Zachnad0/AUS-NZ-Track-A-RFIC-Workspace/README.md

## Track: A <br>Team: AUS/NZ Track A RFIC <br>Project: Open-loop integer-N PLL characterization chip: LC-VCO, quadrature divider, PFD and charge pump

**Reviewers: [docs/REPRODUCE.md](docs/REPRODUCE.md)** rebuilds `gds/chip_top.gds` from a fresh clone, XORs it to zero against the committed file, and runs every signoff gate and test-plan simulation with expected results.

RF-block characterization chip containing the blocks of an integer-N PLL (LC-VCO with varactor tuning, CML divide-by-2 quadrature divider, PFD, charge pump), brought out to pads for open-loop characterization. Closed-loop lock is not demonstrable on this die: the feedback divides by 2 only and the PFD has no usable phase-detection window at the ~2.5 GHz reference that would require. Not a functioning integer-N PLL.

## Testing commitment

Team A01 is committed to testing the fabricated chip and publishing the measurement results in this repository.

Test plan (draft): [docs/test_plan.md](docs/test_plan.md)

Team members

| Discord | Github | Affiliation (experience) | Role |
|---|---|---|---|
| the_z_1 | [@Zachnad0](https://github.com/Zachnad0) | Victoria University of Wellington (undergrad) | Team lead |
| xyfy3 | | Monash University (undergrad) | Member |
| gregorydaley_87272_39557 | [@gregorydaley1209](https://github.com/gregorydaley1209) | University of North Texas (undergrad) | Member |

Overview: Design of a microwave RFIC with an integrated VCO, integer-N PLL, and IQ modulator for use in the 2.4 GHz ISM band, targeting applications such as WiFi 4 (802.11n) or Bluetooth.

Area Estimate: 350 um x 300 um (estimate)  
Pin count: Power 4  Ground 4  Digital 4  Analog 4 (estimate)

**Links**  
[Github repo(s)](https://github.com/Zachnad0/AUS-NZ-Track-A-RFIC-Workspace)  
[Proposal Slide Link](https://docs.google.com/presentation/d/1wPEPSz1xmLuB1RUFt2hdCvwPvyq5I9ataVjHJdjLBb4/edit?usp=sharing)  
[Pin Requirement Link](https://github.com/Zachnad0/AUS-NZ-Track-A-RFIC-Workspace/blob/integration/docs/pins.md)  
[Progress Tracker](https://docs.google.com/spreadsheets/d/1ioGDfle-Np0gdS-PER5QJmRa5nnGZcALtzJDiHwNKBI/edit?usp=sharing)  
[Schematic Review Slide Link](https://docs.google.com/presentation/d/1Fb3C-OsCs1z_RmMnkYhZTfymx6UUXy9G63MJMbfRtXM/edit?usp=sharing)  
Layout Review Slide Link
