Zachnad0/AUS-NZ-Track-A-RFIC-Workspace/signoff/lvs/README.md

# `signoff/lvs/` — LVS artifacts, tracked and readable without running anything

**Team A01 · AUS/NZ Track A RFIC · GF180MCU (gf180mcuD)**
`lvs.report`, `chip_top.lvs.spice` and `chip_top.drc.log` regenerated 2026-11-06 for the D block
(tree at `c312fd7`, `gds/chip_top.gds` sha256 `e14b48cae71eeb60…`). `blocks/` generated 2026-09-01
from commit `52a783a`.

> **D block (2026-11-06).** The three chip-level files are current for the 605 × 605 µm D block.
> `blocks/` was not regenerated and still holds the 2026-09-01 captures. For the organizer-flow
> D result, see the 2026-11-06 section below.

These files exist because the flow's own working directory,
`team_src/magic/verify_work/`, is **gitignored** (see `.gitignore`) — it is regenerable
build output, so nothing in it was ever visible in the repository. This directory is a
committed copy of the artifacts a reviewer or an aggregation script needs.

**Nothing here is hand-edited.** Every file is byte-for-byte tool output, copied verbatim.
The `lvs.report` files begin with a blank line and end with a `.` because that is exactly
what netgen emits; that was left alone on purpose rather than tidied.

## What is here

| File | What it is |
|---|---|
| `lvs.report` | **The top-level LVS report — `chip_top`.** netgen comparison output, layout vs the hand-written golden. Named `lvs.report` so it is findable without knowing our cell names. |
| `chip_top.lvs.spice` | Extracted netlist of the whole chip (Magic `ext2spice`). Every device instance on the die, with its PDK model name and geometry. |
| `chip_top.drc.log` | Magic DRC log for the same layout (`VERIFY_DRC_COUNT=0`). |
| `blocks/<CELL>.lvs.report` | Per-block netgen comparison output. |
| `blocks/<CELL>.lvs.spice` | Per-block extracted netlist. |

Blocks: `PFD_lib`, `CP_v1`, `ibias_gen_v1`, `DIV2_QUAD_v1`, `vco_v1`.

## Results, as of this capture

Every cell: Magic DRC **0**, netgen **"Circuits match uniquely"**, **0 property errors**
(`verify_cp.sh` hard-fails on a W/L property error, not only on a topology mismatch).

| Cell | netgen devices | nets | ports | Verdict |
|---|---:|---:|---:|---|
| `chip_top` | 10 | 20 | 11 | match uniquely |
| `PFD_lib` | 7 | 11 | 6 | match uniquely |
| `CP_v1` | 8 | 10 | 7 | match uniquely |
| `ibias_gen_v1` | 17 | 15 | 6 | match uniquely |
| `DIV2_QUAD_v1` | 75 | 47 | 9 | match uniquely |
| `vco_v1` | 7 | 7 | 6 | match uniquely |

`chip_top`'s 10 devices are the **top-level** instances: the five blocks, the ESD ballast
resistor, and the two ESD diode groups (`diode_nd2ps_03v3 (8->2)`,
`diode_pd2nw_03v3 (8->2)`). Device counts *inside* the blocks are in
`../devices.md`.

> **Three different device counts exist for this design and they are not interchangeable.**
> Read `../devices.md` §"Counting conventions" before quoting any number. In short:
> netgen's merged count (above) ≠ the raw instance count in the extracted netlist ≠ the
> summary line `verify_cp.sh` prints. All three are correct for what they measure.

## Two accepted LVS waivers, both in `chip_top` and both narrow

1. **`vco_inductor_v2` is an `ignore class`.** The custom spiral is a physical inductor with
   no foundry device model; netgen black-boxes it. It still appears in the extracted netlist
   as two `tm11k` top-metal resistors (its M5 leads) — see `../devices.md`.
2. **`PFD_lib` fill/decap cells are ignored** (18 instances of `gf180mcu_fd_sc_mcu7t5v0__fillcap_*`)
   using only the PDK-provided `ignore class`. This is the same waiver LibreLane's own run
   applies via `LVS_IGNORE`. The devices inside those cells are real and **are** counted in
   `../devices.md`.

There are **no DRC waivers** (since 2026-11-02). The former W4 waiver, 168 KLayout
`PL.5a_LV`/`PL.5b_LV` items once taken to be internal to the `nmoscap_3p3` gencell, was the
missing COMP under the 42 varactor gates and is revoked; see `tech_patches/README.md` and
`../../docs/layout-review-sep01.md` §2.5.

## The organizer flow — `extra_be_checks`: matches with Bailey's pending `rm5` fix

> **Current status (2026-11-02, after the varactor COMP fix).** The committed GDS was rewritten
> with COMP under the 42 varactor gates (`tech_patches/README.md`). `run_full_lvs
> lvs/lvs_config.json` on it:
>
> | runner | result |
> |---|---|
> | stock `extra_be_checks@7d1f5ef` | **16 vs 18 devices**, failed pin matching (exit 4). The varactors now match (`cap_nmos_03v3_b (42→2)` both sides); only the 2 `tm11k` of the inductor are missing |
> | the same + `tech_patches/rm5.diff` | **Circuits match uniquely**: `chip_top` 10/10 devices, 20/20 nets; `vco_v1` 8/8 (exit 5: matched, with `tm11k`/`cap_nmos_03v3_b` black-boxed and 10 fill cells ignored). Counted with `vco_v1` flattened, 17 vs 17 |
>
> Before the fix the stock runner gave 14 vs 18: both the varactors and the `tm11k` were missing.
>
> **Why the remaining stock failure is expected:** on 2026-09-25 Bailey ruled in issue #143 that
> `cap_nmos_03v3_b` and `vco_inductor_v2` come out of `LVS_IGNORE`, and that he would fix the tech
> file. That change is `f7be3d5` ("drop cap_nmos_03v3_b and vco_inductor_v2 from LVS_IGNORE per
> Bailey #143"). Two tech-file gaps were on record:
>
> 1. **Varactors.** The record said there was *no varactor `cifinput` rule*; that was wrong. The
>    rule exists (`layer nvar POLY and DIFF and NPLUS and nwelldef and-not DUALGATE`). The real
>    gap was on the **writer** side: magic's stock tech never wrote COMP under 3.3 V varactor
>    gates, so the GDS itself lacked them. Fixed in our GDS on 2026-11-02; nothing is needed in
>    Bailey's reader for it.
> 2. **The `RESDEF` mapping `calma RESDEF 110 *` does not match on input.** The wildcard datatype
>    never matches when GDS is read, so `rm5 = MET5 and RESDEF and MET5RES` is always empty and
>    the inductor's `Metal5_Res` markers produce an open instead of two `tm11k` ("The inductor,
>    measured" and the `rm5` fix below; `tech_patches/rm5.diff`). **Still open upstream**; this is
>    the whole of the remaining stock failure.
>
> The **"Result, 2026-09-19"** pass and the waiver sections after it describe the config before
> `f7be3d5` and are kept as history. The team's own gates on the fixed GDS: `verify_cp.sh` × 6
> PASS (unchanged counts), `drc_boxset.tcl` 0 boxes (new baseline), `klayout_signoff.py`
> 0 violations with no waivers, `team_src/magic/analysis/varactor_comp_gate.py` PASS.

**Superseding the `mpw_precheck` section below.** Per Bailey (issue #143, 2026-09-18) the check
to run is his `extra_be_checks`, not `mpw_precheck`. It ships the **set_lvs_env.py** helper that
`mpw_precheck` never published, so the config path works as documented.

### Runner

```
git clone -b chipathon2025 https://github.com/d-m-bailey/extra_be_checks
export LVS_ROOT=<clone>            # the repo root, not checks/be_checks
export PDK=gf180mcuD PDK_ROOT=/foss/pdks
export UPRJ_ROOT=<this repo>
$LVS_ROOT/run_full_lvs $UPRJ_ROOT/lvs/lvs_config.json
```

`d-m-bailey/extra_be_checks` branch `chipathon2025` at commit
`7d1f5efb270003208956e764765f403b755281d7` (2025-11-28). Runs in ~10 s.

### Result, 2026-09-19 at `da08e9e` (historical: earlier `LVS_IGNORE` config)

**`Circuits match uniquely.`** `chip_top` 10 devices / 20 nets on both sides, every cell's pin
lists equivalent, every sub-block matched — `vco_v1` 5 devices / 7 nets, `CP_v1` 8 / 10,
`DIV2_QUAD_v1`, `ibias_gen_v1`, `PFD_lib` all matched.

Two things this runner fixes that `mpw_precheck` could not:

- **The `05v0`/`06v0` standard-cell split is gone.** Under `mpw_precheck` the layout extracted
  34 `nfet_06v0` + 34 `pfet_06v0` against the PDK netlist's `*_05v0`, an unresolvable 68-device
  difference. Bailey's `tech/gf180mcuD/gf180mcuD_setup.tcl` compares the standard cells
  hierarchically instead of flattening them, so `PFD_lib` matches as a subcircuit and the device
  classes never collide. There is still **no** `equate classes` for `nfet_05v0`/`nfet_06v0` in
  that branch — the only device equivalence it defines is the MiM-cap pair. The split is
  avoided, not equated.
- **Net counts match everywhere**, where `mpw_precheck` never resolved the device gap.

### The one waiver this needs: `cap_nmos_03v3_b` (historical, dropped in `f7be3d5`)

`LVS_IGNORE` carried `cap_nmos_03v3_b` in addition to `vco_inductor_v2` and the standard-cell
fill/decap/antenna globs. Without it the run is otherwise clean but reports
**`cap_nmos_03v3_b` 0 in the layout against 2 in the source** — the 42 varactors.

**This is a PDK techfile gap, not a layout defect.** `gf180mcuD.tech` writes GDS `166/5`
(`MOS_CAP_MK`) for *both* device families but its `cifinput` only ever reconstructs the **cap**
types; there is no `cifinput` rule that produces `nvaractor` at all, so a `cap_nmos_03v3_b`
drawn in magic cannot come back as itself from its own GDS.
Detail: `../../docs/verification.md` §3.2.

What is lost and what still covers it: the 42 varactor **devices** are not compared by this
flow. They remain covered by `verify_cp.sh vco_varactors` on the **`.mag`** path — 42 devices /
3 ports / 4 nets, match uniquely — and by `verify_cp.sh vco_v1` (4 / 6 / 11). Their **nets** are
still compared here: `cap_bias`, `OUT_p` and `OUT_n` all exist and match on both sides inside
`vco_v1`.

The alternative was `EXTRACT_ABSTRACT` on `vco_varactors` with the golden's two
`cap_nmos_03v3_b` instances collapsed into a black-box `vco_varactors` subckt. That also gives
`Circuits match uniquely`, and it was rejected: it would make the committed golden stop
describing the real circuit, for no more coverage than the one-line waiver above.

### The inductor, measured

`LVS_IGNORE vco_inductor_v2` is required, and this was verified rather than assumed. Extracting
`gds/vco_inductor_v2.gds` with the PDK techfile gives **`PORT1` and `PORT2` as separate nodes**
— so the two `Metal5_Res` markers (GDS `110/15`, two 76 × 8 µm, one per coil half) **do** break
the metal — **but no resistor device is created**. The techfile needs
`rm5 = MET5 and RESDEF and MET5RES`; `m5` is `MET5 and-not MET5RES`, so the marker subtracts the
metal, while `rm5` never appears (checked after the GDS read: the cell holds only `metal4`,
`via4`, `metal5`). `RESDEF` is mapped `calma RESDEF 110 *`, a wildcard datatype that does not
match on input. The result is an **open**, not the two `tm11k` resistors that
`team_src/magic/vco_inductor_v2/vco_inductor_v2.ext` supplies in the `.mag` flow.

So the "generic metal resistor break" is half-present: the break works, the resistor does not.
Two alternatives were tried and both are worse than ignoring the cell:

| config | result |
|---|---|
| `LVS_IGNORE vco_inductor_v2` (landed then; removed in `f7be3d5`) | `Circuits match uniquely` |
| `+ EXTRACT_ABSTRACT vco_inductor_v2` | identical — no effect, see the gate below |
| `LVS_IGNORE` removed, golden subckt vs extracted metal | 14 vs 17 devices, **`Top level cell failed pin matching`** |

`EXTRACT_ABSTRACT` has no effect on this cell because of the gate in `run_extract`:
`if { $instance_count > 0 || [llength $port_list] > 10 }`. Only cells with **child instances**
or **more than 10 ports** take the complex path, which deletes the children by grid, deletes
non-port layers and writes a LEF that is later `lef read` back. A **leaf with ≤ 10 ports** —
which `vco_inductor_v2` is, at 2 ports and 0 children — skips that body entirely: no LEF is
written, so nothing is read back, and the only thing that happens is `property LEFview true`
after the GDS read. `vco_varactors`, with 42 child instances, *does* take the complex path.

### 2026-10-27: 2-pin `vco_inductor_v2` golden, and the `rm5` techfile fix

Since `f7be3d5` (2026-09-25, Bailey #143) `lvs/lvs_config.json` no longer ignores
`vco_inductor_v2` or `cap_nmos_03v3_b`. The sections above, from "Result, 2026-09-19" on,
describe the config before that.

**Golden change.** `team_src/magic/vco_v1_golden.spice` now defines
`vco_inductor_v2 PORT1 PORT2` as two `tm11k` (`r_width=8u r_length=76u`) in series through one
internal node, exactly as the layout extracts it, and instances it with 2 pins, PORT1 on `OUT_p`
and PORT2 on `OUT_n` (the mapping read from the extracted layout). `chip_top_golden.spice` is
regenerated from it by `team_src/xschem/chip_top/assemble_chip_golden.py`. The old third pin,
GND, came from the xschem symbol's simulation model `team_src/xschem/vco_inductor_v2.subckt`,
where it is only the reference for the coil's substrate capacitors; the layout has no such
terminal. `signoff/sim/vco/mkdeck2.py` puts the 3-pin lumped model (the one carrying the L) back
for simulation. The `.mag`-path gates are unchanged: `verify_cp.sh vco_v1` 4 / 6 / 11 and
`chip_top` 10 / 11 / 25, match uniquely (the inductor is still an ignore class there).

**Organizer flow on this golden**, `extra_be_checks@7d1f5ef`:

| techfile | devices (layout / source) | nets | ports | verdict |
|---|---|---|---|---|
| stock | 14 / 18 | 21 / 22 | 11 / 11, VTUNE unpaired | failed pin matching |
| `rm5` fix below | 15 / 17 | 21 / 21 | 11 / 11, all paired | do not match |

For reference, stock techfile with the old 3-pin golden (2026-09-25): 14 / 17, 21 / 21, VSSA and
VTUNE pins swapped. With the stock techfile the coil is still the open described above, so the
golden's two `tm11k` have no layout counterpart. With the fix, `vco_inductor_v2` matches
uniquely.

**The `rm5` fix** is one line in `gf180mcuD.tech` (Bailey's file; not landed anywhere):

```
 layer rm5 MET5
- and RESDEF
 and MET5RES
```

Magic appears to map each GDS layer/datatype to a single cifinput layer: `110/15` reaches
`MET5RES` but never `RESDEF` (`calma RESDEF 110 *`), so the three-way AND is always empty. With
the term dropped, `gds/vco_inductor_v2.gds` extracts as two `tm11k`, 76 µm x 8 µm, PORT2 to
the metal4 crossunder to PORT1. That mapping rule is inferred from runs; the magic tech-file
manual does not document it.

**Still open:**

- **Varactors.** `cap_nmos_03v3_b` is 0 in the layout against 2 (42 -> 2) in the source, the
  techfile gap described above. It leaves VTUNE, `cap_bias`, VCO_OUTP and VCO_OUTN unpaired.
- **`tm11k` is a black box on both sides.** Neither netlist has a model for it, so netgen
  compares the inductor's topology but not its `r_width` / `r_length`.

### 2026-11-06: D block, `402b1d9`

`chip_top` reseated in the 605 × 605 µm die, seat A. `verify_cp.sh chip_top`: match uniquely, 10
devices, 20 nets, 11 ports. Golden has 11 ports for the 12 pads; VSSD's text sits on 36/0 at die
(367.5, 604.5), on its landing, on the VSSA net.

Organizer flow, `extra_be_checks@7d1f5ef`:

| techfile | devices (layout / source) | nets | ports | verdict |
|---|---|---|---|---|
| stock | 16 / 18 | 21 / 22 | n/a | do not match: the two `tm11k` only |
| `rm5` fix | 10 / 10 | 20 / 20 | 11 / 11, all paired | **match uniquely** (exit 5, black-box warning) |

The varactor mismatch listed as open above is gone: the COMP fix `8ca968f` closed it. `tm11k` is
still a black box on both sides.

## The older `mpw_precheck` attempt — recipe and result

Run 2026-09-18 at `aa470c3`. **This is a different check from `verify_cp.sh` above and it did
not pass.** `verify_cp.sh` compares `chip_top` against `chip_top_golden.spice` alone, with
every block a black box; the organizer flow additionally reads the PDK standard-cell netlist and
so compares the inside of `PFD_lib` too.

### Runner

`efabless/mpw_precheck` at commit `0941bdc1b62b5c3f99c8683bd11199d330af2ef3`. The scripts are
under `checks/be_checks/`, not `checks/lvs_check/`; `LVS_ROOT` is that directory.

**Caveat, and it is not ours: **set_lvs_env.py**, under the runner's `checks/be_checks/`, cannot be obtained.** It is
listed in mpw_precheck's own `.gitignore`, has never been committed to any branch or tag
(checked `gfmpw-1a`…`1d` and `2024.09.*`), and nothing in the repo or its `dependencies/Dockerfile`
generates or fetches it. Every `run_*` entry point sources it, so the config path
(`run_full_lvs <config>`) is unusable as shipped.

The workaround uses `run_full_lvs`'s own documented alternative — *"if config file not specified,
skip and use current environment"* — so the runner script itself is unmodified:

```bash
export PDK=gf180mcuD PDK_ROOT=/foss/pdks
export UPRJ_ROOT=<repo root>
export LVS_ROOT=<clone>/checks/be_checks
source <(python3 mk_lvs_env.py $UPRJ_ROOT/lvs/lvs_config.json)   # see note below
export WORK_ROOT=<scratch> LOG_ROOT=$WORK_ROOT SIGNOFF_ROOT=$WORK_ROOT
$LVS_ROOT/run_full_lvs            # no arguments
```

**mk_lvs_env.py** is the one reconstructed piece: it reads `lvs/lvs_config.json` and the
`INCLUDE_CONFIGS` base, and emits the `export` lines **set_lvs_env.py** would have. Merge rule:
scalars override, list variables are a **union**, and `[""]` means "adds nothing" — which is the
only reading under which efabless's own reference configs work, since
`caravel_user_project_analog` sets `EXTRACT_FLATGLOB` to `[""]` while depending on the base
config to supply the real patterns. It lives in scratch, not in this repo, because it is a
stand-in for a file the organizers are expected to have.

Runtime is **8–10 s** per run on this host.

### Result

| run | change | devices (layout/source) | nets | ports | verdict |
|---|---|---|---|---|---|
| 0 | none (`152f812`) | 79 / 84 | 52 / 53 | **13 / 11** | fail, 2 pin shorts |
| 1 | `REF_IN_PD/PU` → 36/0 | 79 / 84 | 52 / 53 | **11 / 11** | fail, **no pin shorts** |
| 2 | `LVS_IGNORE += vco_inductor_v2` | 79 / **83** | 52 / 53 | 11 / 11 | fail |

Runs 3 and 4 tried `EXTRACT_ABSTRACT` for `vco_inductor_v2` and then `vco_varactors`; neither
changed the verdict and both were reverted (see the `lvs_config` commit message).

**The identical run on `c7eb341`, the commit `item23` branched from, fails the same way** — 79/84,
52/53, both pin shorts. None of this was introduced by item 23.

### What is still mismatched, and why

Two causes remain. Neither is expressible in the organizer config schema.

**1. `OUT_p` and `OUT_n` are one net when the GDS is read as geometry.** The extracted
`vco_v1` is

```
.subckt vco_v1 TUNE GND VDD ISS OUT_p          <- 5 ports; the golden has 6
Xvco_core_0 ISS VDD GND OUT_p OUT_p vco_core   <- OUT_n merged into OUT_p
```

`verify_cp.sh` does not see this because `team_src/magic/chip_top.abstract` says
`PRELOAD=vco_varactors vco_inductor_v2`, and `verify_extract.tcl` implements that as `load` of
those `.mag` masters plus `gds noduplicates true`, so the GDS read keeps the abstract and never
traverses the spiral. **The organizer schema has no PRELOAD equivalent**: `EXTRACT_ABSTRACT`
black-boxes a cell that is already in the stream, it does not substitute a `.mag` master for it.
Tried directly — abstracting `vco_inductor_v2` produced the abstract but left `OUT_n` merged and
added a dangling `vco_inductor_v2_0/PORT1`; abstracting `vco_varactors` as well changed nothing.

**2. The standard cells extract as `*_06v0` and the PDK models them as `*_05v0`.** 34 `nfet` and
34 `pfet` on each side, same devices, different class name. They are the standard cells inside
`PFD_lib` — `gf180mcu_fd_sc_mcu7t5v0__dffrnq_1` (28), `__nand2_1` (4), `__inv_1` (2), `__tieh`
(2). `PFD_lib` itself compares **68 / 68 devices, 38 / 38 nets and matches**; only the flattened
chip-level tally splits.

This one is entirely inside the PDK. Both `gf180mcuD` spice views of the library —
`libs.ref/gf180mcu_fd_sc_mcu7t5v0/spice/*.spice` and `.../cdl/*.cdl` — use `nfet_05v0` /
`pfet_05v0`, while magic's extraction of those same cells yields `nfet_06v0` / `pfet_06v0` and
the PDK's netgen setup declares **only** the `*_06v0` classes (`05v0` appears zero times in it).
The fix is a netgen `equate classes nfet_05v0 nfet_06v0`, which belongs in the setup `.tcl` the
runner copies from the PDK — **the config schema does not expose it**, and there is no alternate
PDK file that would make the two agree.

`verify_cp.sh` never hits this because it feeds netgen only `chip_top_golden.spice`, with no
standard-cell netlist at all, so `PFD_lib`'s 68 devices are never compared.

### Reading this honestly

The port fix in `aa470c3` is a real correction to the deliverable and is gated on its own merits.
The two remaining causes are a tool-flow gap and a PDK naming inconsistency; neither indicates a
defect in `gds/chip_top.gds`. Whether the organizer flow passes for anyone on gf180mcuD with a
standard-cell block is worth asking the organizers before treating cause 2 as ours.

## Regenerating

Inside the `iic-osic-tools` container, from the repo root:

```
export PDK=gf180mcuD PDK_ROOT=/foss/pdks
for c in PFD_lib CP_v1 ibias_gen_v1 DIV2_QUAD_v1 vco_v1 chip_top; do
  bash team_src/magic/verify_cp.sh $c
done
```

~28 s for all six. Output lands in `team_src/magic/verify_work/`; this directory is a copy.
`verify_cp.sh` exits 0 only on DRC 0 + match uniquely + zero property errors.

**The extracted netlist is not byte-reproducible run to run** in the same way the GDS is not
(`docs/verification.md` §8.11): node auto-names such as `IBIAS_uq0` and `m4_n14800_800#` are
generated during extraction. The device set, counts and geometry are stable; incidental node
names may differ. Compare device tables, not file hashes.
