Zachnad0/AUS-NZ-Track-A-RFIC-Workspace/docs/phase8-padframe-plan.md

# Phase 8 — padframe DEF integration: analysis & plan

> **D block (2026-11-06).** This plan is the BH record. The current die is 605 × 605 µm: see
> `docs/d-block-plan.md`.

Analysis of the organizer's issued padframe DEF (`A01.def.tgz`, extracted from a
working dir — not committed; analysis/docs only this session). **Two things are
blocked and out of scope:** (1) whether a second ground pin **VSSD** is required
(Bailey: "two ground pins, one per power region"; expanded Friday — the issued
DEF has none, so a regenerated DEF is expected), and (2) therefore the final pin
list and top-level boundary. Everything here holds regardless of how that lands.

Baseline is known-good: `verify_cp` PASS (DRC 0, LVS match uniquely) on `chip_top`
and all five blocks (this session, §5).

---

## 1. DEF inventory (both variants)

DEF units are **200 dbu/µm** (5 nm). `translated_user` = pin rectangle in the
**project's own frame** (origin at the project LL). Pin rects are all **Metal2**.
Both variants: `DIEAREA (0 0)–(…)`, `PINS 14` (12 user pins; REF_IN expands to 3).

### 1a. BV — 550 × 1110 µm (portrait). origin 350,1475. vss_fixed W12. usable 610500 µm²

| pin | slot | cell | use | dir | edge | translated_user bbox (µm) |
|-----|---|---|-----|-----|---|---|
| VSSA | W13 | dvss | GROUND | INOUT | west | x0–1, y106.4–178.6 |
| VDDA | W14 | dvdd | POWER | INOUT | west | x0–1, y206.4–278.6 |
| IBIAS | W15 | asig_5p0 | SIGNAL | INOUT | west | x0–1, y320.3–364.7 |
| ISS | W16 | asig_5p0 | SIGNAL | INOUT | west | x0–1, y420.3–464.7 |
| VTUNE | W17 | asig_5p0 | SIGNAL | INOUT | west | x0–1, y520.3–564.7 |
| CP_OUT | W18 | asig_5p0 | SIGNAL | INOUT | west | x0–1, y620.3–664.7 |
| I_P | W19 | asig_5p0 | SIGNAL | INOUT | west | x0–1, y720.3–764.7 |
| I_N | W20 | asig_5p0 | SIGNAL | INOUT | west | x0–1, y820.3–864.7 |
| Q_P | W21 | asig_5p0 | SIGNAL | INOUT | west | x0–1, y920.3–964.7 |
| Q_N | W22 | asig_5p0 | SIGNAL | INOUT | west | x0–1, y1020.3–1064.7 |
| VDDD | N01 | dvdd | POWER | INOUT | north | x31.4–103.6, y1109–1110 |
| REF_IN (Y) | N02 | in_c | SIGNAL | INPUT | north | x133.8–134.1, y1109–1110 |
| REF_IN_PD (PD) | N02 | in_c | SIGNAL | OUTPUT | north | x194.3–194.7, y1109–1110 |
| REF_IN_PU (PU) | N02 | in_c | SIGNAL | OUTPUT | north | x198.7–199.0, y1109–1110 |

- **Pin-rectangle y-span: y[106.4, 1110.0] µm.** Most distant pin top = **y1110**
  (north). chip_top is **309 µm tall** → **reach shortfall ≈ 801 µm** to the north
  edge; the west analog pins climb to y1065 (Q_N), ~756 µm above chip_top's top.

### 1b. BH — 1110 × 550 µm (landscape). origin 350,2035. vss_fixed [] (none). usable 610500 µm²

| pin | slot | cell | use | dir | edge | translated_user bbox (µm) |
|-----|---|---|-----|-----|---|---|
| VSSA | W18 | dvss | GROUND | INOUT | west | x0–1, y46.4–118.6 |
| VDDA | W19 | dvdd | POWER | INOUT | west | x0–1, y146.4–218.6 |
| IBIAS | W20 | asig_5p0 | SIGNAL | INOUT | west | x0–1, y260.3–304.7 |
| ISS | W21 | asig_5p0 | SIGNAL | INOUT | west | x0–1, y360.3–404.7 |
| VTUNE | W22 | asig_5p0 | SIGNAL | INOUT | west | x0–1, y460.3–504.7 |
| CP_OUT | N01 | asig_5p0 | SIGNAL | INOUT | north | x45.3–89.7, y549–550 |
| I_P | N02 | asig_5p0 | SIGNAL | INOUT | north | x145.3–189.7, y549–550 |
| I_N | N03 | asig_5p0 | SIGNAL | INOUT | north | x245.3–289.7, y549–550 |
| Q_P | N04 | asig_5p0 | SIGNAL | INOUT | north | x345.3–389.7, y549–550 |
| Q_N | N05 | asig_5p0 | SIGNAL | INOUT | north | x445.3–489.7, y549–550 |
| VDDD | N06 | dvdd | POWER | INOUT | north | x531.4–603.6, y549–550 |
| REF_IN (Y) | N07 | in_c | SIGNAL | INPUT | north | x633.8–634.1, y549–550 |
| REF_IN_PD (PD) | N07 | in_c | SIGNAL | OUTPUT | north | x694.3–694.7, y549–550 |
| REF_IN_PU (PU) | N07 | in_c | SIGNAL | OUTPUT | north | x698.7–699.0, y549–550 |

- **Pin-rectangle x-span: x[0, 699.0] µm.** Most distant pin right = **x699** (north,
  REF_IN_PU). chip_top is **522 µm wide** → **reach shortfall ≈ 177 µm** horizontally;
  the north pins sit at y550, **≈ 241 µm** above chip_top's 309-µm top.

### 1c. Padring breaks (from the full 2935×2935 `padring.cfg`)

The `.cfg` is the workshop-wide padring; A01 occupies a slot subset. Breaks insert
`brk5` break-fillers, splitting the continuous VDD/VSS rails into isolated islands.
The `.cfg` gives no per-break comment; the structure shows two relevant breaks:

- **Inter-project break** — after `W11 dvss`, a `BREAK` precedes A01's west run
  (`W12 dvss / W13 dvss / W14 dvdd / W15… asig`). Isolates A01's west power island
  from the neighbouring project. All A01 west pads share **one rail powered by VSSA
  + VDDA** (BV: W13/W14; BH: W18/W19), feeding the west analog pads' ESD.
- **Digital-domain break** — the VDDD + REF_IN pads sit **between two BREAKs**
  (BV: `BREAK; N01 dvdd; N02 in_c; BREAK`; BH: `BREAK; N06 dvdd; N07 in_c; BREAK`).
  This isolates a **digital island powered by VDDD** containing REF_IN. **It has no
  dedicated ground pad** in the issued DEF — exactly the "second ground (VSSD)"
  gap Bailey flagged for Friday. In BH the five analog north pads (CP_OUT, I/Q) sit
  **before** that break, so they share the VSSA/VDDA analog rail (continuous from
  the west run through the NW corner); in BV all analog signals are on the west rail.

Result — **which pins land on which rail:** analog rail (VSSA+VDDA) → IBIAS, ISS,
VTUNE, CP_OUT, I_P, I_N, Q_P, Q_N (+ VSSA, VDDA themselves); digital island (VDDD,
no VSSD yet) → VDDD, REF_IN.

### 1d. Generator project size — the OLD block, confirmed

`A01_selected_variants.json`: `source_gds gds/A01/PFD_lib.gds`, `top_cell PFD_lib`,
`rectangle_dbu [0,0,60000,24000]` → **60 × 24 µm**, `participant_pin_count 12`,
`selected_variants [BV, BH]`. So the generator sized the project from the **old
PFD_lib block (60×24), not chip_top (522×309)** — as expected.

**Did it affect the allocation? No.** The die size and pin slots are set by the
config + pin count (12), not the project GDS: both variants give **610500 µm²
usable**, ≫ chip_top's 161,000 µm² (522×309), so there is no under-allocation. The
stale 60×24 is metadata only — it would matter solely if a fit-check consumed it,
which it did not. **Flag:** re-point the generator's `source_gds`/`top_cell` at
`chip_top` before any future fit-check or a regenerated DEF, so the recorded
project size is the real 522×309.

### 1e. REGENERATED DEF package received 2026-08-22 (`A01.def (1).tgz`) — supersedes §1a–1d where they differ

Greg supplied a **newer** package than the one §1 was written from. Extracted to the
session scratchpad (analysis only, still not committed). What changed and what is now exact:

- **§1d's stale-60×24 flag is RESOLVED.** `A01_selected_variants.json` and the interface
  yamls now carry `source_gds .../gds/A01/chip_top.gds`, `top_cell: chip_top`,
  `rectangle_dbu [-5000, -4300, 99400, 57500]` → **522 × 309 µm**. The generator is sized
  from the real block. No action left on that flag.
- **BH DIEAREA is exact:** `DIEAREA ( 0 0 ) ( 222000 110000 ) ;` at `UNITS DISTANCE MICRONS 200`
  → **1110.000 × 550.000 µm**. `usable_area: 610500`, `origin_microns: [350, 2035]`,
  **`vss_fixed: []`**, `blockages: []`, `routing_blockage_layers: Metal1…Metal5`.
- **§1's pin table gave BOUNDING BOXES. The real pin rects are multi-finger** — this is a
  routing fact, not a formatting detail. A haul must land on a finger, not on the bbox.

| pin | slot | cell | fingers | finger w × h (µm) | bbox `translated_user` (µm) |
|-----|---|---|---:|---|---|
| VSSA | W18 | dvss | 6 | 1.000 × 9.500 | x0.00–1.00 y46.36–118.64 |
| VDDA | W19 | dvdd | 6 | 1.000 × 9.500 | x0.00–1.00 y146.36–218.64 |
| IBIAS | W20 | asig_5p0 | 8 | 1.000 × 2.540 | x0.00–1.00 y260.34–304.66 |
| ISS | W21 | asig_5p0 | 8 | 1.000 × 2.540 | x0.00–1.00 y360.34–404.66 |
| VTUNE | W22 | asig_5p0 | 8 | 1.000 × 2.540 | x0.00–1.00 y460.34–504.66 |
| CP_OUT | N01 | asig_5p0 | 8 | 2.540 × 1.000 | x45.34–89.66 y549.00–550.00 |
| I_P | N02 | asig_5p0 | 8 | 2.540 × 1.000 | x145.34–189.66 y549.00–550.00 |
| I_N | N03 | asig_5p0 | 8 | 2.540 × 1.000 | x245.34–289.66 y549.00–550.00 |
| Q_P | N04 | asig_5p0 | 8 | 2.540 × 1.000 | x345.34–389.66 y549.00–550.00 |
| Q_N | N05 | asig_5p0 | 8 | 2.540 × 1.000 | x445.34–489.66 y549.00–550.00 |
| VDDD | N06 | dvdd | 6 | 9.500 × 1.000 | x531.36–603.64 y549.00–550.00 |
| REF_IN (Y) | N07 | in_c | 1 | 0.380 × 1.000 | x633.76–634.14 y549.00–550.00 |
| REF_IN_PD | N07 | in_c | 1 | 0.380 × 1.000 | x694.29–694.67 y549.00–550.00 |
| REF_IN_PU | N07 | in_c | 1 | 0.380 × 1.000 | x698.65–699.03 y549.00–550.00 |

  All rects are **Metal2**, and each is only **1 µm deep** into the project (west pins
  x[0,1]; north pins y[549,550]). The north slot pitch is **100 µm**; N01–N05 centres are
  **67.5 / 167.5 / 267.5 / 367.5 / 467.5**, which is exactly what `phase8_incontext.py`
  already targets. REF_IN's three fingers are **0.38 µm** wide — the narrowest landing in
  the design.
- **The padring `.cfg` fixes the slot CELL TYPES, and A01_BH owns 16 slots: W18–W22 +
  N01–N11** (`user_slot_count: 16`; the 12-pin issue populates W18–W22 + N01–N07 only).
  The generator assigns pins to slots **in info.yaml order** and derives each slot's cell
  from `io_type` — W18 `dvss`←VSSA(ground), W19 `dvdd`←VDDA(power), N06 `dvdd`←VDDD,
  N07 `in_c`←REF_IN. The two BREAKs in `A01_BH_padring.cfg` sit **immediately before N06
  and immediately after N07**, which is the digital island §1c described.

**VSSD lands cleanly, and it does NOT move the RF work (2026-08-22).** Inserting VSSD at
pin index 10 (immediately before VDDD) makes it **N06 `dvss`** and pushes VDDD→N07,
REF_IN→N08 — still inside A01's 16-slot allocation, 3 spare. Two consequences:
- **N01–N05 do not move.** CP_OUT and the four I/Q pads keep x67.5/167.5/267.5/367.5/467.5
  at y549–550, so the matched-quad geometry, the escapes, the lane assignment and the
  provisional 433.76 µm are **unaffected by VSSD**. Only the VDDD and REF_IN hauls shift
  **+100 µm east** (VDDD centre 567.5 → 667.5; REF_IN Y 633.76 → ~733.8).
- **Why immediately-before-VDDD is the right slot:** Bailey's audit flags
  `A01: group 2 missing ground: VDDD REF_IN` but does *not* flag group 1, and group 1's
  ground (VSSA) is its **first** pin. VSSD placed first in group 2 reproduces exactly the
  arrangement the audit already accepts.

**Still to confirm against a regenerated DEF** (do not treat as settled): that the
generator emits the BREAK *before* VSSD rather than between VSSD and VDDD, and that it
emits `in_c` at N08. Both follow from the observed ordering rule, neither is proven.

---

## 2. REF_IN needs three connections (in_c PU/PD) — findings

The DEF expands REF_IN onto `gf180mcu_fd_io__in_c` (PINS 14): **REF_IN** on **Y**
(INPUT), **REF_IN_PU** on **PU** (OUTPUT), **REF_IN_PD** on **PD** (OUTPUT). "OUTPUT"
is from the core's view — the core **drives** PU/PD (they are the cell's control
inputs).

**What PU/PD do (cited):**
- Official GF180MCU IO datasheet lists `in_c` as *"5V WR CMOS input only pad with
  pull-up/down"* — PU/PD control an on-pad pull-up/pull-down.
- PDK **liberty** (`gf180mcu_fd_io__tt_025C_3v30.lib`): pins PU `input`, PD `input`,
  PAD `input`, **Y `output`, function `((PAD))`** — Y is the buffered pad signal to
  the core. **LEF** agrees: PU/PD/PAD `DIRECTION INPUT USE SIGNAL`, Y `OUTPUT`.
- PDK **Verilog** `in_c`: `buf #1 (Y, PAD)` — Y follows PAD; PU/PD are analog pull
  controls, not modeled digitally there.
- PDK **CDL** `in_c`: PU/PD are ESD-diode-protected control-gate inputs feeding
  level-shift logic that drives a **~100 kΩ poly-resistor ladder pull** on PAD
  (R196–R211 through node n15).
- **Polarity — now CONFIRMED for in_c (2026-08-21), not just inferred.** The
  official PDK page **"4.1 Digital I/O Cell Control Pins"** gives the truth table
  for the digital I/O pads' pull control (in_c is a digital input pad) verbatim:

  | PU | PD | Resistive Pulling |
  |----|----|-------------------|
  | 0 | 0 | Normal CMOS (no pull) |
  | 0 | 1 | **Pull Down** |
  | 1 | 0 | Pull Up |
  | 1 | 1 | Normal CMOS (no pull) |

  So **PU/PD are active-high enables**: `PU=1,PD=0`→pull-up, `PU=0,PD=1`→pull-down,
  `PU=0,PD=0` (or `1,1`)→no pull. This **agrees with** last session's inference from
  the sibling `bi_t` Verilog (`rnmos(PAD,gnd,~OE&&~PU&&PD)` /
  `rnmos(PAD,pwr,~OE&&PU&&~PD)`) — that analogy is now backed by an in_c-applicable
  source, superseding the earlier "inferred by analogy, never confirmed" caveat.
  Source: <https://gf180mcu-pdk.readthedocs.io/en/latest/IPs/IO/gf180mcu_fd_io/digital.html>.

**Options for an externally-driven reference clock:**

| PU | PD | effect | consequence |
|----|----|---|---|
| 0 | 0 | no pull (high-Z) | nothing loads/biases a driven clock; but a *disconnected* clock floats. |
| **0** | **1** | **weak pull-down (~100 kΩ) — DECISION** | REF_IN parks at a clean logic 0 when the bench clock is disconnected; ~100 kΩ is negligible against a 50 Ω generator when driven. |
| 1 | 0 | weak pull-up | idle high; uncommon for a clock. |
| float | — | **NOT acceptable** | CMOS control-gate inputs; floating → indeterminate pull, drift near threshold, crowbar current, noise pickup. Both **must** be driven. |

**DECISION (Greg, 2026-08-21 — overrides last session's PU=0/PD=0):** tie
**REF_IN_PU = 0 (→VSS) and REF_IN_PD = 1 (→VDD)** = **Pull Down**. Reasoning: on a
bench part the reference clock is often disconnected, and a floating CMOS receiver
input can oscillate and draw crowbar current; a pull-down instead gives a clean
logic 0 so the PFD sees *no reference* and the VCO parks at a band edge —
deterministic and diagnosable. The 100 kΩ pull is negligible against a 50 Ω
generator when the clock IS driven. Do **not** leave either floating. No
`chip_top.sch`/`info.yaml` edit this session — the pin list may change after Friday,
so the tie is recorded here to make the call once.

---

## 3. Variant recommendation: **BH**, with the counter-argument

**Recommendation: BH (1110 × 550, landscape).**

- **Aspect match.** chip_top is 522 × 309 — a *landscape* core. BH's die is
  landscape (1110 × 550); chip_top drops into the bottom-left with only ~241 µm of
  height headroom to the north pins. BV is *portrait* (550 × 1110): chip_top fills
  the bottom ~28 % and leaves ~800 µm of dead die above, across which the pins are
  stacked — every top/west pin becomes a long haul.
- **Critical I/Q outputs.** I_P/I_N/Q_P/Q_N (2.4–3.2 GHz differential, from DIV2 at
  chip lower-left) go to BH's **north edge ≈ 241 µm** up — short. In BV they land on
  the **west edge at y720–1065**, i.e. **~550–900 µm** of haul up a tall die: added
  delay, loss, differential mismatch and coupling on the deliverable RF signals —
  the worst place to compromise.
- **Source proximity.** BH puts CP_OUT and the I/Q outputs on the north edge near
  their sources (CP top-middle, DIV2 lower-left); the west pins (VSSA at the GND
  ring, VDDA at the band, IBIAS aligned with the top-left ibias block) are on the
  near-left edge. ISS/VTUNE (from vco on the right) haul left in either variant, but
  BH's shorter die keeps them ≤ ~240 µm of vertical.
- **Fit.** Both give 610500 µm² usable ≫ 161k; not a differentiator. BH also has
  large width headroom (1110 vs 522) vs BV's tight 28 µm width margin (522 vs 550).

**Strongest argument against BH (for BV):** BV carries a **fixed down-bonded quiet
ground `vss_fixed W12`** immediately adjacent to VSSA (W13) — a dedicated, low-
inductance quiet-ground bond that a phase-noise-sensitive LC-VCO benefits from. BH
has no fixed ground in A01's slot (ground = VSSA only). For a VCO, ground quality
feeds phase noise, so BV's W12 is a real advantage.

**Why BH still wins:** the on-chip GND ring + the VSSA bond already set the VCO
ground; VSSA can itself be down-bonded. The RF-output routing penalty in BV
(hundreds of µm on the differential I/Q) is a larger, more certain degradation of
the actual deliverable than the incremental ground-inductance gain of a second
fixed bond. And the Friday VSSD decision may add a dedicated ground regardless,
eroding BV's W12 edge. **Revisit after the regenerated DEF.**

---

## 3b. I/Q length matching & core placement (2026-08-21)

### The padframe REINTRODUCES the I/Q mismatch — a designed-in requirement
Phase 7 length-matched `VCO_OUTP/N` inside chip_top. The BH padframe undoes that at
the top level: the four divider outputs land at fixed north pads **I_P x145, I_N
x245, Q_P x345, Q_N x445 — 100 µm apart, a 300 µm x-spread** — while all four
originate from adjacent DIV2 converters (taps at x2.18 / x235.18). The Q hauls run
further and pass over the vco. **This is inherent to the pad pitch, not the pin
ordering, and BV is worse — so it is not an argument against BH.** It must be
designed in from the start of phase-8 routing (a matched-length quad router, §4),
**not** patched late as VCO_OUTP/N was.

### Output taps (Item 2a — the real net metal, tap-the-extent)
From `port_map.py` + measured M1 in `gds/chip_top.gds` (current chip frame). Each
output escapes to a DIV2 edge as a **0.60 × 0.60 µm M1** port pad:

| net | DIV2 tap (chip µm) | M1 pad extent |
|-----|---|---|
| I_P | (235.18, 140.27) | (234.88,139.97)–(235.48,140.57) |
| I_N | (2.18, 140.27) | (1.88,139.97)–(2.48,140.57) |
| Q_P | (235.18, 51.92) | (234.88,51.62)–(235.48,52.22) |
| Q_N | (2.18, 51.92) | (1.88,51.62)–(2.48,52.22) |

I/Q at two x-extremes (I_P/Q_P right x235, I_N/Q_N left x2) and two y-levels (I
y140, Q y52). Because the pads increase left→right (I_P<I_N<Q_P<Q_N) while the taps
alternate right/left, **I_P↔I_N and Q_P↔Q_N cross** — a layer-managed crossing the
quad router must handle.

### Haul lengths & padding (Items 2b–2c)
Placement assumption: chip_top's core (boundary −25..497 × −21.5..287.5) placed in
the 1110×550 DIEAREA by an offset (dx,dy); tap_die = tap + (dx,dy). Fit ⇒ dx∈[25,613],
dy∈[21.5,262.5]. Manhattan haul tap→pad, per placement (µm):

| placement (dx,dy) | I_P | I_N | Q_P | Q_N | max | spread | matched(4×max) | total pad |
|---|-----|-----|-----|-----|-----|---|---|---|
| bottom-left (25, 21.5) | 480 | 628 | 583 | 916 | 916 | 436 | 3664 | 1670 |
| top-left (25, 262.5) | 239 | 387 | 342 | 675 | 675 | 436 | 2700 | 1057 |
| top dx200 (200, 262.5) | 414 | 212 | 302 | 500 | 500 | 288 | 2000 | 572 |
| **top dx243 (243, 262.5)** | 457 | 169 | 345 | 457 | **457** | 288 | **1828** | **400** |

Matching pads the three shorter hauls up to the longest, so the cost of matching is
**4 × (longest haul)** and the serpentine budget is `total pad`. Moving the core to
the **top** (dy 262.5, DIV2 nearest the north pads) roughly halves everything vs
bottom-left; shifting **right** (dx→243) balances the left/right crossing so the max
haul bottoms out at **457 µm** with only **400 µm** of total serpentine.

### Does the padding fit? (Item 2d)
Yes. At dx≈200–243 the 522-wide core leaves **~415–588 µm of empty die width**
(x0–175 west + x697–1110 east) plus the vertical clear columns — ample room for
horizontal serpentine meanders. The **y[180,205] power band** is crossed on M2/M3
(signals) vs M4/M5 (power) — not blocked. The serpentine stays inside the 20 µm GND
perimeter margin. The tight spot is the ≤~60 µm between the core top (y550 at
dy262.5) and the north pads; land the hauls in the core's clear columns and route
the matching meanders in the empty side regions, not that gap.

### Core placement recommendation (Item 3)
Evaluated at dy=262.5 (core at top — the I/Q, CP_OUT, VDDD, REF_IN all land north, so
minimizing their vertical haul dominates) across dx, plus a bottom baseline:

vco→pad columns use the vco's own taps (ISS (395.84,60.33), TUNE (358.68,66.70),
VDD (397.44,74.83)); GND→VSSA = the horizontal gap the perimeter GND ring must span
from the core's left edge (x = −25+dx) out to the west VSSA pad at x0.

| placement | I/Q spread | I/Q matched | total→14 pins | vco→ISS / VTUNE / VDDA | GND→VSSA |
|---|---:|---:|---:|---|---|
| bottom-left (25,21.5) | 436 | 3664 | 6493 | 721 / 777 / 508 | 0 (core at x0) |
| top-left (25,262.5) | 436 | 2700 | **4972** | **480 / 536 / 577** | 0 (core at x0) |
| **top dx200 (200,262.5)** | **288** | 2000 | 5458 | 655 / 711 / 752 | ring extends 175 |
| top dx243 (243,262.5) | 288 | **1828** | 5630 | 698 / 754 / 795 | ring extends 218 |

**Recommendation: core at top, dx = 200, dy = 262.5 — boundary x[175, 697],
y[241, 550].** It gives the minimum I/Q spread (288 µm) and near-minimum matched
length (2000 µm) with only 572 µm of serpentine — the RF outputs are the deliverable
— while keeping the vco's DC/bias hauls (ISS 655, VTUNE 711 µm — both DC/high-Z,
haul-tolerant) and the power hauls (VDDA 585 µm, bus-distributed) acceptable. dx can
be pushed to 243 for the absolute-shortest matched I/Q (1828 µm, 400 µm serpentine)
at ~40 µm more vco DC haul.

**Strongest argument against it:** **top-left (dx=25)** has ~10 % lower total haul
(4972 vs 5458), the shortest vco→ISS/VTUNE (480 / 536 µm), and puts the whole core
hard against the west edge so the VDDA/VSSA pads sit right on the bus/ring — which
favors supply/ground integrity — for an LC-VCO, IR drop and ground bounce feed
phase noise. It loses only because VDDA/VSSA are wide bus/ring-distributed (low-R,
haul-tolerant) whereas the I/Q are thin RF signals where length directly costs
loss/mismatch — so the I/Q-optimal dx wins. If Friday's regenerated DEF moves the
pad map, re-run this sweep before committing a placement.

---

## 3c. Ground-return quantification (2026-08-21, Item 1)

The dx=200 pick was made on I/Q spread alone; here is the ground side, measured.

**Ring, measured (not assumed):** the GND ring is a **15 µm-wide M5 (layer 81)**
loop around the core (four segments, each 15 µm thick — queried from `chip_top.gds`).
Under BH the ring must span the gap from the core's west edge (x = −25+dx) to the
VSSA pad at x0; that spur carries the chip's entire ~26 mA to its single ground pad:

| dx | spur length | squares (÷15 µm) | R (M5 40 mΩ/□) | IR @26 mA | L (~1 pH/µm)† | XL @5 GHz |
|----|---|---|---|---|---|---|
| 25 | 0 | 0 | 0 | 0 mV | 0 | 0 |
| 200 | 175 µm | 11.7 | 0.47 Ω | **12.1 mV** | 175 pH | 5.5 Ω |
| 243 | 218 µm | 14.5 | 0.58 Ω | 15.1 mV | 218 pH | 6.9 Ω |

- **M5 sheet resistance 40 mΩ/□** (typ; 31 / 49 in the fast/slow corners) — source
  `/foss/pdks/gf180mcuD/libs.tech/magic/gf180mcuD.tech`, `resist (allm5)/metal5`.
- †**Inductance is a rule of thumb** (~1 pH/µm ≈ 1 nH/mm partial self-inductance of an
  on-chip/package wire) — stated as such, not extracted.

**What it means for the VCO (Item 1d).** The tail current (~1 mA) returns through
**ISS**, not GND, so the VCO's own GND current is small (bulk/well leakage +
displacement); the 12 mV is essentially a **common-mode** shift of the shared on-chip
ground, which the differential tank (472–568 mV) rejects to first order. As a DC bias
shift on the varactor reference it moves the frequency ~10 MHz (0.2 %), retunable via
VTUNE. The 175 pH / 5.5 Ω of added return reactance is **common-mode** and, crucially,
is dwarfed by the unavoidable **VSSA bond-wire inductance** (~1 nH → ~31 Ω @5 GHz — the
on-chip spur is <20 % of it).

**Verdict (Item 1e): the ground penalty at dx=200 does NOT change the placement.**
12 mV DC IR and 175 pH are small absolutely, common-mode to the differential VCO, and
a minor fraction of the bond inductance. If even 12 mV is unwanted, widening the west
ground spur to ~30 µm (or stacking M4+M5) halves it to ~6 mV — trivial. **dx=200
stands.** The honest, boring conclusion: ground does not materially decide this.

## 3d. Pad ordering — a better assignment exists (Item 2)

info.yaml's pin ORDER sets which output lands on which north slot (x145/245/345/445),
and it is ours to choose. Sweeping all 24 orderings at dx=200/dy=262.5 (taps: I_N/Q_N
left x2.18, I_P/Q_P right x235.18):

| order @ x145,245,345,445 | I/Q spread | matched (4×max) | total | crossings |
|---|---:|---:|---:|---|
| I_P,I_N,Q_P,Q_N (current) | 288 | 2000 | 1428 | 3 |
| **Q_N,I_N,I_P,Q_P (proposed)** | **58** | **1077** | **962** | **0** |
| Q_N,I_P,I_N,Q_P | 47 | 1256 | 1162 | 1 |
| I_P,Q_P,Q_N,I_N | 14 (min) | 1656 | 1628 | 4 |

**Proposed reorder: Q_N, I_N, I_P, Q_P** (left-taps → left-pads). It nearly **halves
the matched wire (2000 → 1077 µm)**, cuts spread 288 → 58, and **removes all three
crossings** — the left/right tap order now matches the pad order. Rail-break rule
holds: all four stay in the analog north slots between CP_OUT and VDDD. **Cost
(Item 2b):** it splits the differential Q pair to opposite ends (Q_N x145, Q_P x445),
but these are **single-ended monitor outputs** (each buffered into its own 1 kΩ→50 Ω
instrument), measured individually — so adjacency is an organizational nicety, not an
electrical cost, and length-matching (which the reorder improves) is what preserves
quadrature accuracy. The min-spread ordering (I_P,Q_P,Q_N,I_N, spread 14) is rejected:
it needs ~1656 µm of matched wire (more loss) and 4 crossings.

**PROPOSED info.yaml change (record for after Friday — NOT edited): reorder the four
outputs to Q_N, I_N, I_P, Q_P across the north analog slots.** Re-confirm against the
regenerated DEF's slot map first.

## 3e. RF loading the outputs will actually see (Item 3)

Length-matching gives each output on-chip wire that no sim included. Added
capacitance, using the VCO-load figure **0.08 fF/µm for a 0.4 µm wire** (assumed
**M3**, the signal haul layer):
- current ordering, ~500 µm matched → **40 fF/output**;
- **proposed reorder, ~269 µm matched → ~21.5 fF/output.**

Effect on the recorded **157 mVpp** monitor (1 kΩ R_SER into 50 Ω, 300 fF pad C): the
added C shunts the pad node, but 50 Ω dominates the load there, so at 3 GHz
(VCO ÷2 upper band) |Z_load| falls only 48.1 → 47.6 Ω with +40 fF — a **~1 % amplitude
drop (157 → ~155 mVpp)**; with the reorder's +21.5 fF it is **~0.6 %** (~156 mVpp).
**The outputs remain usable** for divide-ratio (amplitude essentially unchanged) and
quadrature accuracy (the matched length holds the I-to-Q skew). **Characterized
limitation:** on-chip routing adds ~40 fF (~21.5 fF reordered) per output, ~1 %
(~0.6 %) monitor-amplitude loss at 3 GHz — negligible, recorded here alongside the
existing VCO load-pull, I/Q offset, and DIV2 EM items.

---

## 3f. Channel map + dy sweep → recommended placement dx=200, **dy=200** (2026-08-21)

Built the per-layer occupancy map (`docs/phase8-channel-map.md`,
`analysis/channel_map.py`) and swept dy against it (`analysis/dy_sweep.py`,
`analysis/phase8_dryrun.py`).

**dy sweep** (dx=200, proposed order; matched haul vs the clear channel above the core,
DIEAREA y[287.5+dy, 549]):

| dy | matched | per-output | clear channel | lanes+serpentine fit? |
|----|---:|---:|---:|---|
| 262.5 | 1077 | 269 | −2 µm | **NO** (last-session problem: core reaches the pad row) |
| 240 | 1167 | 292 | 20 µm | NO |
| 220 | 1247 | 312 | 40 µm | tight |
| **200** | **1327** | **332** | **60 µm** | **yes** |
| 180 | 1407 | 352 | 80 µm | yes (comfortable) |
| 160 | 1487 | 372 | 100 µm | yes |

**Recommended: dy = 200** — the highest dy (shortest haul, matched 1327 µm =
332 µm/output) that still opens a ≥60 µm clear channel above the core for the four
horizontal lanes + the 58 µm serpentine + pad landing. **Cost vs dy=262.5:**
+250 µm total, +63 µm/output (269→332 µm). **Conflict flag (Item 2b):** dy ≥ ~215
forces the lanes over the top blocks (M3-on-M3 silent shorts) — avoid. **Strongest
argument against dy=200:** its 60 µm channel is *marginal* — if the 4-lane + serpentine
stack does not fit, drop to **dy=180** (+80 µm total haul, +20 µm channel headroom).

**Dry-run at dy=200 (Item 3, `analysis/phase8_dryrun.py`, throwaway cell):**
- length matching **EXACT** — all four to **331.760 µm** (<1e-3 µm); **magic DRC 0**,
  **KLayout signoff PASS**; the four routes extract as separate nets (own lanes → no
  merges, DRC-0 spacing confirms no touching).
- lanes land at **y≈490 in the clear channel** (y[487.5,549]) — clear, as designed.
- overlap check of the route's straight M3 risers vs the block metal (DIEAREA frame):
  benign M3-over-**M2** crossings of ibias/CP/DIV2 (different layer, no short), but
  **real M3-on-M3 conflicts:** the **right risers (I_P/Q_P at x235) cross CP.M3 and
  PFD.M3**, and the tap escape crosses DIV2.M3. **Resolution (per the map):** the
  right risers must **jog to the x288–397 clear column** before rising, and the taps
  escape on their own layer/axis (phase-7 technique). The left risers (Q_N/I_N at
  x2.18) are already left of ibias's M3 — clear.
- **Verdict:** phase 8 at dy=200 is a **routing job** — the lane channel is clear and
  the primitives match exactly; the remaining work is the DIV2-output riser escapes
  via the mapped clear columns. It converges; it is not a floorplan wall.

## 3g. The other ten pins at dx=200/dy=200 (Item 4)

| pad | source | edge | haul (µm) | path |
|-----|---|---|---:|---|
| VSSA | GND ring | west | ~175 (spur) | ring extends to the west edge — clear, low-R |
| VDDA | VDDA bus | west | ~175–260 (bus) | bus extends west — clear (the 522 point-figure overstates it) |
| IBIAS | ibias.IBIAS | west | 412 | exits ibias west into the empty region — clear |
| **ISS** | vco.ISS | west | **717** | **LONG** — vco(right)→west pad, full-die crossing; DC/high-Z, clear band at y≈378 |
| **VTUNE** | vco.TUNE | west | **774** | **LONG** — same; DC tune, clear band at y≈480 |
| CP_OUT | CP.CP_OUT | north | 538 | up-and-left; low-freq analog |
| VDDD | PFD.VDD | north | 230 | up-and-right — clear |
| REF_IN | PFD.REF | north | 348 | up-and-right — clear |
| REF_IN_PU | tie→VSS | north | short | tie to the ground ring (pull-down, §2) |
| REF_IN_PD | tie→VDD | north | short | tie to the VDDD bus (pull-down, §2) |

**Flags (Item 4b):** every pin has a clear path; **ISS (717) and VTUNE (774) are the
materially-long ones** — the vco sits on the right and both pads are on the west edge,
so they cross the full die. Both are **DC/high-Z** (tail node, tune voltage), so the
length costs only resistance (negligible), and the clear M2/M3 bands at y≈378 / y≈480
provide the crossing lane. No pin is unroutable.

**VSSD implication (Item 4c, analysis only — do NOT add):** VDDD and REF_IN sit in the
north **digital island** (x531–699). A VSSD pad, if Friday requires one, would land in
that island (north, near VDDD x531) and draw its ground from the **digital VSS taps**
— PFD.VSS (die ≈x433,y457) or DIV2.VSS (die ≈x353,y279) — a moderate up-and-right haul
like VDDD. It would NOT come from the analog VSSA ring; keeping the digital return
local to that island is the point of the padring's VDDD/REF_IN break.

---

### DIEAREA & pin rects → `chip_merge.py` frame
- **DBU already matches.** `chip_merge` sets `master.dbu = 0.005` (200/µm); the DEF
  is 200/µm. So DEF coordinates map **1:1** into chip_merge's frame — integration is
  a pure **translation** (where chip_top's core origin sits in the project frame),
  no scaling.
- chip_merge would (a) set the deliverable's extent to the DEF **DIEAREA**, (b)
  position the existing block-merge (DIV2/vco/ibias/CP/PFD, unchanged relative
  layout) at a chosen offset inside it (bottom-left for BH), and (c) the DEF
  `translated_user` rects become the fixed routing targets. The blocks' internal
  placement does not move; only the whole core is offset within the larger die.
- **`check_placement.py`** compares chip_top.mag's placement record against the
  chip_merge deliverable. Growing the die + offsetting the core changes chip_top's
  absolute frame, so check_placement **must be re-baselined** for phase 8 (the
  block-relative placements are unchanged; the guard's reference geometry is not).
  Treat a check_placement diff here as expected-once, then re-lock.

### The 0/0 boundary
- The current layer-0/0 boundary (522 × 309, at (−25,−21.5)–(497,287.5)) is
  chip_top's *standalone* die outline. Under the padframe the **DEF DIEAREA is the
  authoritative die extent**, so the 0/0 boundary is **replaced** — redrawn to the
  DIEAREA (BH: (0,0)–(1110,550)). The two do not coexist; a single boundary = the
  DIEAREA. The core geometry stays; it simply sits inside the larger outline.

### Long-haul routes
- The current **y[180,205] band** carries the M5 VDDD/VDDA buses full-width, and
  **GND is a 15 µm M5 ring in a 20 µm perimeter margin**. In BH the north pins sit
  ~241 µm **above** chip_top's top (y309); hauls run **up from each block tap,
  crossing the y[180,205] power band on a *different layer* (signals M2/M3, power
  M4/M5 — the silent-short discipline), then up the new die area** (y309→550) to the
  north pin rects. West pins route **left** to x0. Diff pairs (I/Q, VCO_OUT already
  matched internally) should be routed as matched-length pairs up to the north pads.
- Ground: extend the perimeter GND ring/margin out to the new DIEAREA and tie it to
  the **VSSA** pad (west); the VDDD digital island (north) still lacks a ground pad
  pending the VSSD decision — do not resolve here.

### The existing 12 die-edge port labels
- chip_top carries **12 top-level port labels** today (VDDA, VDDD, VSSA + the 9
  signal ports), scattered at block-tap locations near its own perimeter — *not* at
  one edge. (The prompt's "11" excludes the VSSA ground-ring label at y−2.0; the
  route_chip print "13 labels" is stale — reconcile to **12**, matching the 12 LVS
  ports.)
- Under the padframe these labels **move to the DEF pin rectangles** at the DIEAREA
  edges (a top-level label must land on top-level metal, so each haul carries its
  net's metal to the pin rect and the label sits there). **Two new labels are
  added** — REF_IN splits into REF_IN / REF_IN_PU / REF_IN_PD (12 → 14), with PU/PD
  tied per §2. A VSSD (if Friday adds it) would add one more. So: existing labels
  relocate; +2 (REF_IN PU/PD) new; possibly +1 (VSSD).

### Work estimate (rungs)
1. **Decide inputs** — variant (BH, pending Friday), final pin list (post-VSSD),
   REF_IN PU/PD tie (§2). *(gated on Friday)*
2. **Frame** — chip_merge: set DIEAREA, offset the core, replace the 0/0 boundary;
   re-baseline check_placement.
3. **Haul routing — west pins** — VSSA/VDDA/IBIAS/ISS/VTUNE to the west edge (band
   crossings on diff layers).
4. **Haul routing — north pins** — CP_OUT + matched I/Q pairs + VDDD + REF_IN up to
   the north edge (the RF-critical rung; matched-length diff pairs).
5. **Ground/PU-PD** — extend GND ring to the DIEAREA + VSSA tie; REF_IN_PU/PD
   tie-offs; VSSD if required.
6. **Labels** — relocate the 12 labels to the pin rects, add REF_IN PU/PD (+VSSD).
7. **Verify** — magic DRC + KLayout signoff (W4 waiver), chip LVS vs the padframe
   netlist (`padring.v`), check_placement re-lock, 5-block regression.

Roughly **6–8 rungs** — a phase comparable in effort to phase-7 routing, dominated
by rung 4 (RF haul routing) and rung 7 (padframe-level LVS). Several are gated on
Friday's VSSD/pin-list decision.

### Matched-quad dry-run at real coordinates (2026-08-21, Item 4)

Rehearsed `route_lib.matched_route` on the four real taps, the four BH pad rects, the
chosen placement (dx=200/dy=262.5), and the **proposed** ordering (§3d), in a
throwaway cell (`team_src/magic/analysis/phase8_dryrun.py`):
- **Length matching EXACT** — all four routed to **269.260 µm** (err < 1e-3 µm).
- **magic DRC 0; KLayout signoff PASS (0 violations)** on the throwaway cell.
- Route bbox (167,314)–(468,549) µm **overlaps** both the y[180,205] power band
  (DIEAREA y421.5–446.5) and the top blocks ibias/CP/PFD (DIEAREA y466.5–534.5).

**Verdict: phase 8 is a ROUTING job, not a floorplan-impossible one — with one
placement caveat.** The primitives produce exact, DRC-clean matched routes; the
proposed reorder makes the hauls **mostly vertical risers** (taps ≈ under their pads)
with only ~58 µm of serpentine. The band overlap is benign — the M3 signal hauls cross
the M5 band on a **different layer** (no short, the phase-7 discipline). The real
constraint is that the risers must thread **clear columns** between the top blocks
(as phase 7 did), and at **dy=262.5 the core is packed to the north edge**, leaving no
clear horizontal channel — the lanes/serpentine land over the top blocks. **Refinement:
lower the core (~dy 160–180) to open an ~80–110 µm clear channel above it** for the
horizontal lanes + serpentine + pad landing, at the cost of ~80–110 µm of extra
(still-matched) haul each. So the placement is a joint optimum of I/Q haul length **and**
haul-channel room, not haul length alone — settle the exact dy against the regenerated
DEF and the confirmed clear-column map next session.

---

## 3h. In-context rehearsal + VTUNE shielding (2026-08-21, 4th session)

### The isolated dry run proved less than it looked (Item 1)
Rebuilt the rehearsal WITH the five blocks present — `chip_top` instanced at
dx=200/dy=200 in a throwaway cell (`analysis/phase8_incontext.py`; all masters present,
confirmed by the 84 varactor-PL.5a baseline). Two corrections to last session:
- **The 331.760 µm match was the CONFLICTING route.** Jogging the right risers into the
  clear x381–404 (ibias↔CP) gap lengthens them, so the true matched length after the
  jog is **~458 µm** (Q_P is the longest; the shorter three pad up to it).
- **The matched quad does NOT drop in DRC-clean in context.** `reh_base` (blocks only) =
  84 (varactor); `reh_phase8` (with routes) = 86 — the routes add **M3.2a**:
  - **Left risers (Q_N/I_N)** are squeezed between the **GND ring** (die x197.5) and DIV2
    (die x200) — a ~2.5 µm slot; a riser there collides (M3.2a) with the ring-area M3.
  - **Matching serpentine** (~130–166 µm, from the routing spread) does **not** fit the
    channel — M3.2a at both dy=200 (60 µm) AND dy=180 (80 µm).
  - Right risers (I_P/Q_P) escape east into the DIV2↔vco gap, rise to the vco-top/CP-
    bottom window (crossing the M5 band on M3 — benign), jog into the x381–404 gap, and
    rise past CP — that base geometry is workable.
- Extraction: the 0.28 µm M3.2a are near-shorts (spacing), not overlaps, so **no merges**.
- **Verdict:** phase 8 converges but is a **hand-tuned routing job, not a drop-in
  primitive**. The left risers need the ring pulled off DIV2 (a few µm more dx margin, or
  a ring notch) to open their slot; the matching serpentine must go in the **wide empty
  side regions** (x0–175 west, x697–1110 east; 588 µm) — **not** the 60–80 µm channel.
  The primitives length-match exactly; the escape/serpentine PLACEMENT is the build work.

### dy=180 does not rescue the serpentine (Item 3)
The serpentine budget is set by the routing spread (~130–166 µm), not by dy. It needs
~12 µm-tall fingers × 4 stacked lanes → more than either 60 µm (dy200) or 80 µm (dy180)
holds (M3.2a at both). **So the channel holds the four lanes + pad landing only; the
matching serpentine relocates to the side regions regardless of dy.** dy=200 therefore
stands for the lanes; dy is not the serpentine lever — the side regions are.

### VTUNE / ISS coupling: a quantified nothing (Item 2)
- **KVCO = 822 MHz/V** (band 4.13–6.35 GHz over VTUNE 0.3–3.0 V, on record).
- **Coupling caps (magic tech):** M2–M2 sidewall **0.047 fF/µm** (parallel, min spacing);
  crossover (different layers) ~0.005 fF each.
- **The 15 kΩ tune resistor** (golden `XR2 TUNE cap_bias 15kΩ`) sits between the 774 µm
  routing and the varactor and **low-passes the routing coupling**.
- **Concrete worst case:** a 50 µm inadvertent parallel run with a 0.5 V, 2.5 GHz
  aggressor → Cc ≈ 2.35 fF → ~18 mV on the routing node → filtered by the 15 kΩ +
  varactor to **~0.37 mV at the varactor → 0.3 MHz FM → ≈ −84 dBc** spur at 2.5 GHz
  offset. The natural geometry (VTUNE runs west, the I/Q outputs and CML clocks run
  north — perpendicular crossovers, ~0.005 fF) gives **< 0.1 mV → negligible**.
- **Mitigations & cost:** grounded guard trace ± (~1550 µm² over 774 µm, ~10× reduction);
  ground plane under (~465 µm² + ties); reroute perpendicular / avoid parallel runs
  (0 area); accept.
- **Recommendation:** **routing discipline** — keep VTUNE (and ISS) perpendicular to the
  switching aggressors and off parallel runs; the 15 kΩ tune resistor already shields the
  routing. No dedicated guard/plane needed (≈ −84 dBc worst-case, negligible in practice).
  ISS is milder still (low-impedance tail node, AM-to-PM). A quantified nothing.

### Fourteen-net crossing table (Item 4, from the occupancy map, dx200/dy200)

| net | layer | crosses | same/inter | resolution |
|-----|---|---|---|---|
| Q_N, I_N | M3 riser | GND ring M3 region (die x182.5–197.5) | **same** | thread the 2.5 µm ring↔DIV2 slot; widen it with a few µm dx or a ring notch |
| I_P, Q_P | M3 riser | CP.M3 + PFD.M3 at x235 | **same** | jog into the x381–404 ibias↔CP gap (validated in the rehearsal) |
| I_P, Q_P | M3 riser | M5 power band (y182–200) | inter | benign (M3 over M5) |
| ISS, VTUNE | M2/M3 | the 4 north I/Q risers | inter | keep perpendicular (they run N, VTUNE runs W) |
| ISS, VTUNE | M2/M3 | M5 power band | inter | benign |
| VSSA | M5 | — (perimeter ring spur) | — | clear, ~175 µm west spur |
| VDDA | M5 bus | signal risers | inter | benign (M5 over M2/M3) |
| VDDD | M4/M5 | signal risers | inter | benign |
| IBIAS | M2 | own-block escape then clear west region | — | minor |
| CP_OUT | M2/M3 | ibias body (if routed over it) | **same** if over ibias | route via the x181–204 clear column / top band |
| REF_IN | M2/M3 | digital-island region (north) | minor | local, north |
| REF_IN_PU/PD | M2 | — (short rail ties: PU→ring, PD→VDDD) | — | trivial |

The **only same-layer (real) conflicts** are the four I/Q risers (resolved: right→gap,
left→ring slot) and CP_OUT-over-ibias (resolved via the clear column). Everything else is
inter-layer (power on M4/M5 over signals on M2/M3) or perimeter — benign.

---

## 3i. Ring characterized, quad closes to a clean gate (2026-08-21, 5th session)

The 4th-session §3h "2.5 µm slot / M3.2a against the ring" conclusion was **wrong about the
mechanism** and is superseded here. Characterizing the ring layer stack and running the
actual gate (not inferring it) both changed the answer.

### The GND ring is M5-only — the "2.5 µm slot" is an artifact (Item 1)
Queried every layer in the ring's left segment and at the M3.2a corner
(`analysis/ring_corridor.py`, chip coords):
- **At the ring corner (chip x[−12,2], y[262,285]): only M5 (layer 81) + the 0/0 boundary.**
  No M1/M2/M3/M4, no vias. The ring is a plain 15 µm M5 loop (chip x −17.5…−2.5).
- **West of DIV2 (chip x<0) is empty on M1–M4** except that M5 ring. DIV2's edge M1 frame
  starts at chip x0.18; its only M2/M3 is a single via stack **at** the tap (chip y≈49),
  none west of it.
- Therefore a riser on M1/M2/M3 sits freely anywhere west of DIV2's M1 (>0.28 µm clear) out
  over the M5 ring — **M3-vs-M5 has no spacing rule.** The left riser was never boxed into a
  2.5 µm slot; it was **escaping on M1 hard against DIV2's M1 frame** (the real M1.2a).

### What the rehearsal actually violated, and the fix (Item 1b)
With the map-derived escapes, `reh_phase8` = 87 (84 baseline **+3**), all route-vs-route,
**none against the ring**:
- **M1.2a** at die (200.2, 252): the Q_N tap-escape M1 pad abutting DIV2's M1 frame. →
  **Fix:** via M1→M3 **at the tap pin** and escape on **M3** (past the frame; no M1 painted
  near it). `PLAN[*]["escl"]=3` for the two left nets.
- **M3.2a** at die (388, 508): my own I_P lane crossing my own Q_P riser at the right jog. →
  **Fix:** reorder the two jogs — I_P low-jog + west column (x385, lane 508), Q_P high-jog +
  east column (x400, lane 516) — so no lane crosses a riser.

### The extraction earned its keep — a DRC-clean silent short (Item 2c)
"M3.2a is a spacing rule, so no merge" was **sound reasoning and still wrong** — so we ran
the diff. Extracting the **routes-only** cell (the local rehearsal GDS reh_routes.gds, not committed, = the top-cell shapes = the
4 hauls, no instance; `analysis/reh_extract.tcl`) first gave **3 nodes**, ports
`Q_N I_P Q_P` — **I_N had merged into Q_N.** The two left escapes *overlapped* (0 gap →
no M3.2a spacing violation, same layer → no width violation) where I_N's higher-y escape
swept west across Q_N's riser. **Fix:** order the left risers **west-to-east** (Q_N riser
west of I_N's) so neither escape crosses the other's riser.

### The clean gate (all four parts, dx=200/dy=200)
| gate part | reh_base (blocks only) | reh_phase8 (+4 hauls) | verdict |
|---|---|---|---|
| magic DRC total (`reh_drc.tcl`) | 84 (all PL.5a in vco_varactors) | **84** | **0 added** |
| KLayout signoff variant-D (`klayout_signoff.py`) | PASS, 168 waived (84 PL.5a_LV+84 PL.5b_LV) | PASS, **168** waived | identical |
| extraction node count, routes-only | 0 | **4** | diff = +4 nets |
| distinct nets (`.subckt` ports) | — | `Q_N I_N I_P Q_P` | **4 distinct** |

The quad **closes to a clean gate in context.** The escape/jog placement is the build work;
the length-matching primitive is exact (all four = **433.76 µm**, error 0.0000).

### Extending to the other hauls — where the rehearsal stops (Item 3)
Order attempted: VTUNE, ISS, IBIAS, CP_OUT, VDDD, REF_IN(+PU/PD), VSSA, VDDA. **It stops
at the first one, VTUNE — and the reason is structural, not a routing tweak.**

**Why the IQ quad closed and these do not:** the four IQ taps sit at block *edges* — Q_N/I_N
at chip x2.18 are west of ibias's M3 (x14.8), so they escape west on M3 into open die; I_P/Q_P
jog out of CP into the validated x381–404 gap. The remaining hauls originate **inside** their
blocks. Measured escapes (`analysis/vco_tap_escape.py`, `tap_layers.py`, chip coords):
- **VTUNE** tap chip(358.68,66.70), M1: **enclosed by the vco inductor** — M5 spiral fills
  y90–186 above it, vco M3 reaches up to y≈89 and the OUT-lead M5 to x472; the tap x is
  inside vco M3 (x358.5–419.8). Any riser at the tap crosses live vco M5/M3, and a westward
  exit at the tap's low y (66.7) crosses DIV2 M3 (x2–235.4) — there is **no clear band at
  y≈66**; the clear bands are all at y174–287.5, above the block bodies. A coupling-safe
  VTUNE (KVCO 822 MHz/V, §3h) must *not* rise through the inductor at all.
- **ISS** tap chip(395.84,60.33): same inductor enclosure (M5 y92–196).
- **IBIAS** chip(71.30,223.90) and **VDDA** chip(74.16,231.60): inside the ibias body;
  a drop on M3 at the tap x crosses ibias M3 (x14.8–177.8).

**The escape from a block-interior tap needs the block's port/net context** — to tell a
same-net touch (safe: it *is* the TUNE/ISS/IBIAS net) from a cross-net short. The generic
rehearsal router does not encode that. §3g already showed each of these has a clear *path*
once escaped (open west/north die); turning the escape itself into DRC-clean, short-free
geometry is **per-block build work**, not a sandbox primitive.

**A second, independent limit:** the rehearsal's verification is a **routes-only** extraction
(the 4 hauls with no chip_top instance). That proves the *routes* don't merge each other, but
it **cannot** catch a haul shorting to a *block* net — and same-layer overlap is invisible to
DRC (only spacing/width fire). Catching tap-to-block distinctness needs the **full LVS-abstract
flow** (the Bailey LEF-abstract extraction, `analysis/bailey_pass2_extract.tcl`), because a
flat full-cell extraction shorts the inductor's OUT_p/OUT_n. So the honest gate for the
single-net hauls is LVS-in-context, not the routes-only rehearsal.

**Verdict (Item 3d — do not force it):** the rehearsal closes the hard, matched, RF-critical
IQ quad with a real four-part gate. The remaining eight single-net hauls are each a
block-edge-escape problem that belongs in the real build (with block ports + LVS-in-context),
and §3g establishes their paths are clear. The rehearsal has done its job — it de-risked the
one case that genuinely needed geometry (the quad) and *measured* exactly what the others need.

## 3j. (RECORD) The block-interior tap escape and the routes-only limit — both conclusions WITHDRAWN (written 2026-08-25)

**Why this section is being written now.** §3j never had a header. Its analysis was written
into the tail of §3i and the label `3j` was then cited from three places with nothing to
resolve against:

- §3l: *"§3j claimed a full in-context extract was impossible (flat extract shorts the inductor)."*
- `team_src/magic/analysis/README.md`, twice: the rehearsal heading *"(§3h/§3i/§3j, 4th–5th
  session)"*, and `vco_tap_escape.py` — *"the inductor M5 enclosure that blocks a clean escape
  (§3j, why Item 3 stops at VTUNE)"*.

This is the same defect §3m was written to fix, and it is fixed the same way: record the claim,
then record that it is dead. **No new analysis is introduced here.** The measurements referred
to below live in §3i's closing subsections and are unchanged.

### What §3j claimed

1. **Block-interior taps cannot be escaped in the sandbox.** `analysis/vco_tap_escape.py`
   measured the VTUNE tap at chip (358.68, 66.70) as enclosed by the inductor — M5 spiral over
   y90–186, vco M3 up to y≈89, tap x inside vco M3 x358.5–419.8 — with **no clear band at
   y≈66**, the clear bands all sitting at y174–287.5 above the block bodies. ISS at chip
   (395.84, 60.33) sat in the same enclosure (M5 y92–196). Conclusion drawn: **Item 3 stops at
   VTUNE**; these escapes are per-block build work, not a sandbox primitive.
2. **A full in-context extraction is impossible.** Because a flat full-cell extract merges the
   spiral and shorts OUT_p/OUT_n, the rehearsal's only available gate was a **routes-only**
   extract — which by construction cannot see a haul shorting to a *block* net, and same-layer
   overlap is invisible to DRC. Conclusion drawn: catching tap-to-block distinctness **requires
   the organizer's LEF-abstract flow** (`analysis/bailey_pass2_extract.tcl`), which we cannot
   install.

### Claim 2 is WITHDRAWN — superseded by §3l

Wrong, and wrong about a mechanism the repo already owned. `chip_top.abstract` +
`verify_extract.tcl` preload the `vco_varactors` and `vco_inductor_v2` abstracts with
`gds noduplicates true`, so `gds read` keeps the geometry-free abstract instead of traversing
the spiral. The local rehearsal GDS reh_phase8.gds (not committed) instances that same `chip_top` cell with its subhierarchy intact
(verified with `cell_list.py`), so the identical preload extracts the rehearsal **in full
context**. The harness is `analysis/reh_ctx_extract.tcl`, and it is the real distinct-net gate.

The correction was not academic. The first time it ran it caught a short §3i had passed clean:
`reh_base` gave chip_top **12** clean ports, `reh_phase8` gave **14**, with the two
`DIV2_QUAD_v1_0/ib_conv_v1_{0,3}/a_8764_6964#` bias nodes exposed and bridged to `I_P`/`Q_P`.
The organizer's flow was never needed to find it.

### Claim 1 is WITHDRAWN — superseded by §3n (which also took §3m down)

Claim 1 is the direct ancestor of §3m's "VTUNE is boxed". Both were reasoned inside a
**522 × 309** chip_top, where every route had to win an internal column. Once T2 seated the
core at (175.00,178.50)–(697.00,487.50) inside the **1110 × 550** BH DIEAREA, free die appeared
south of y178.5, west of x175, east of x697 and north of y487.5 that did not exist when the
claim was made. A west-then-**south** exit through the 52.6 µm DIV2↔vco gap crosses nothing but
the GND ring. VTUNE is not boxed, and Item 3 does not stop at it — VTUNE was built and landed
in phase 8 (c) on a clean gate.

### What survives

The **measurements** survive; only the conclusions drawn from them died. The inductor enclosure
over the VTUNE and ISS taps is real and still there — it is why neither net rises at its tap.
For VTUNE specifically the coupling objection also still stands (KVCO 822 MHz/V, §3h), so
"rise under the spiral" remains the wrong move for that net. ISS sits in the same enclosure but
is a DC tail node, so the coupling objection does not apply to it; its routing was settled
later, and differently, by §3p and §3q. `vco_tap_escape.py` remains valid as a measurement
script — read its output as geometry, not as the 522 × 309-era verdict its README line still
quotes.

## 3k. What survives a pin-list change, and what must be redone (Item 4)

Two things are still BLOCKED upstream (not this session's to decide): whether **VSSD** is
required, and the **final pin list / order**. This records which phase-8 results survive a
pin-list change and which must be regenerated.

| result | survives a pin-list change? | why |
|---|:--:|-----|
| **Core placement dx=200 / dy=200** | **SURVIVES** | set by block-to-die-edge clearance + the ground-return budget (§3c) + the clear-column geometry (§3f), none of which depends on which signal lands on which pad. A VSSD pad lands in the north digital island (§3g) without moving the core. |
| **BH variant choice (1110×550)** | **SURVIVES** | driven by usable area + padring breaks (§1, §3), pin-list-independent. |
| **Ground-return quantification (§3c)** | **SURVIVES** | M5 ring/spur R is a function of placement, not pinout. |
| **RF output loading (§3e, ~40 fF/1%)** | **SURVIVES** | a property of the pad+ESD+haul length for an I/Q output; survives as long as I/Q stay on N-edge pads at similar haul length. |
| **VTUNE/ISS coupling analysis (§3h)** | **SURVIVES** | depends on KVCO, the 15 kΩ tune R, and perpendicular routing discipline — not on pin assignment. Re-check only if VTUNE/ISS move to an edge that forces a parallel run past the aggressors. |
| **The routing primitives (`route_lib.py`)** | **SURVIVES** | parameterized (endpoints in, length-matched path out); pin-list-independent by construction. |
| **The escape *technique* per tap** (M3-at-pin for the DIV2 outputs; jog-into-gap for CP; the west-to-east left-riser ordering) | **SURVIVES** | a property of each *block tap's* local layer stack, which does not change when the pad it targets changes. |
| **Matched length 433.76 µm** | **REDO** | it is `max(base)` over the four IQ nets for *this* pad assignment (Q_N→x167.5 … Q_P→x467.5) at dx200/dy200. Reorder the pads (e.g. the proposed Q_N,I_N,I_P,Q_P north order, §3d) and the per-net base lengths — hence the target — change. The *method* survives; the *number* is provisional. History: 269→332→458→433.76. |
| **Per-net escape *coordinates* / lane assignment** | **REDO** | which lane (490/500/508/516) and which pad-x each net targets is pin-list-specific. |
| **The channel/crossing budget (§3h table)** | **PARTIAL** | the clear columns/bands (§3f, from the blocks) survive; which net occupies which is redone. |
| **Pad reorder proposal (§3d)** | **REDO/CONFIRM** | it *is* a pin-list proposal; it stands or is replaced when Friday fixes the pin list. |
| **A VSSD haul** | **NEW if required** | not routed; §3g pre-analyzed its source (digital VSS taps, north island) so adding it is additive, not a re-baseline. |

**One-line rule:** everything set by *placement + block geometry* survives; everything set by
*which signal goes to which pad* is provisional. The rehearsal was built so the survivors are
the expensive parts (geometry, primitives, technique) and the redo parts are cheap (re-run the
matcher with the new endpoints).

### Provisional matched length: 433.76 µm
Down from the 4th-session ~458 µm because the left risers now escape M1→M3 **at the tap**
(no M1 escape leg + shorter path) rather than an M1 escape then via. History:
269 → 332 → 458 → **433.76**. It would move again if: core placement dx/dy changes; the pad
reorder changes which physical pad each net targets; or the currently-longest net (Q_P base
433.8, the pad target) changes. All four are padded to the longest base with serpentine in
the clear side regions, so the **number is provisional on placement + pin list**, not on the
routing style (which is now fixed).

---

## 3l. The in-context extraction works — and it caught a tap-to-block short in the "closed" quad (2026-08-22, 6th session)

§3j claimed a full in-context extract was impossible (flat extract shorts the inductor).
**That was wrong** — the repo already had the mechanism: `chip_top.abstract` +
`verify_extract.tcl` preload the `vco_varactors` + `vco_inductor_v2` abstracts with
`gds noduplicates true`, so `gds read` keeps the geometry-free abstract instead of traversing
the spiral. The local rehearsal GDS reh_phase8.gds (not committed) instances that same `chip_top` cell (subhierarchy intact —
verified with `cell_list.py`), so the identical preload extracts the rehearsal **in full
context** without the inductor merging OUT_p/OUT_n. Harness: `analysis/reh_ctx_extract.tcl`.

**It immediately caught a real short the routes-only gate (§3i) had declared clean.** Extract
the same `chip_top` cell in two contexts and compare its exposed ports:
- `reh_base` (no routes): chip_top → **12 clean ports** (`… I_P I_N Q_P Q_N …`).
- `reh_phase8` (with the §3i routes): chip_top → **14 ports** — the two
  `DIV2_QUAD_v1_0/ib_conv_v1_{0,3}/a_8764_6964#` internal **bias nodes** exposed and **bridged
  to `I_P` / `Q_P`**. The chip_top instance line tied both port 9 (`a_8764#`) and port 10
  (`I_P`) to net `I_P`, and both port 11 and port 13 to `Q_P`.

The geometry is identical between the two runs; the only difference is the four routes, so the
**I_P and Q_P hauls shorted the DIV2 output to an ib_conv bias node.** Cause: I_P/Q_P escaped
on an **M1 hwire** running east from the tap, straight across the `a_8764_6964#` M1 node. Q_N/I_N
(M3-at-pin escape, no M1 hwire) were clean. This is invisible to DRC (an *overlap* leaves no
spacing gap) and to the routes-only extract (`a_8764#` lives inside chip_top, absent from
`reh_routes`). It reconciles with §3i rather than overturning it: the §3i four-part gate passed
*as stated*, but its part 3 (routes-only extraction) was explicitly flagged as unable to see
tap-to-block shorts — this harness is exactly the tool that closes that gap.

**Fix (both right nets):**
- **I_P/Q_P → M3-at-pin escape** (`escl=3`, no M1 hwire) removes the bias-node bridge.
- **I_P `novia=True`:** the I_P output pin is a **full via stack** (M1→via1→M2→via2→M3→via3→M4;
  `_iqtaps.py`), so adding our own via1/via2 tripped **V1.2a/V2.2a** against the pin's vias.
  Instead the M3 route **lands on the pin's existing M3** (its eastward first segment overlaps
  it) with no new via. Q_P/Q_N/I_N pins are **M1-only**, so they keep the via_stack (collision-free).

**The corrected quad gate (dx200/dy200), now five parts:**
| gate part | reh_base | reh_phase8 | verdict |
|---|---|---|---|
| magic DRC total | 84 | **84** | 0 added |
| KLayout signoff variant-D | PASS, 168 waived | PASS, **168** | identical |
| routes-only extraction | 0 nodes | **4 nodes** | +4 nets |
| **full in-context** chip_top ports | 12 clean | **12 clean** | no bias node exposed |
| **full in-context** output→net map | — | I_P→I_P, Q_N→Q_N, I_N→I_N, Q_P→Q_P | **each distinct from every block net** |

Matched length unchanged at **433.76 µm** (all four, err 0.0000). **Lesson recorded:** the
in-context extraction is now the real distinctness gate; the routes-only extract is necessary
but not sufficient. Every subsequent haul (Items below) is gated with `reh_ctx_extract.tcl`.

## 3m. VTUNE "boxed" (WITHDRAWN, see 3n); and the .ext trap that was quietly corrupting the baseline (2026-08-22, tapeout drive)

### VTUNE: the tap is reachable, the rise is not (Item 2d)
`phase8_incontext.py`'s `HAUL` table cited a section 3m that had never been written. Recording it:

- **The TUNE tap IS accessible.** The gate pad sits *inside* the varactor comp ring, so a
  lateral M1 escape shorts the ring to VSSA (caught by the in-context extract). Via **up**
  (M1 -> M3) at the pad, then M3 west over the ring into the DIV2<->vco gap, is clean.
- **The rise to the west pad is boxed.** The only M2/M3-clear rise columns are **x181-204**,
  unreachable at low y because DIV2 blocks x<235.4, and **x288-397**, which sits under the
  inductor spiral (M5 x290-472). The sole column clear of *both* is **x288-290** - about
  2 um, 1 um off the spiral - i.e. a ~96 um M3 run beside the live inductor. Section 3h's
  coupling work forbids exactly that for the tune node (KVCO 822 MHz/V).

So the `VTUNE_tap` entry documents clean tap access only; the haul itself is unsolved and is
**T3's hardest single-net route**, not a routing tweak.

> **SUPERSEDED THE SAME DAY - see 3n.** This "boxed" conclusion was reached while chip_top
> was still 522 x 309. Once T2 seated the core inside the 1110 x 550 DIEAREA there was free
> die south of it, and a west-then-**south** exit through the 52.6 um DIV2<->vco gap crosses
> nothing but the GND ring. VTUNE is not boxed. The column analysis above is also wrong on a
> detail: x288-290 is not M4-clear. ISS is the same enclosure but is a DC
tail node, so rising under the spiral is acceptable for it.

### The `.ext` trap - same failure class as the silent I_N/Q_N short
`team_src/magic/vco_inductor_v2/vco_inductor_v2.ext` is tracked and carries the **real**
inductor extraction (`device rsubckt tm11k`, ports PORT1/PORT2). It was found modified in
the working tree at the start of this drive, overwritten by a **geometry-free abstract** -
no device, plus a new `GND` port.

**It was not a one-off from an analysis script.** `verify_cp.sh` - the flow gate itself -
reproduced the corruption on its very next run. The mechanism: **magic writes each cell's
`.ext` beside the file that cell was loaded from, not to the current directory.** Both
`verify_extract.tcl` and `reh_ctx_extract.tcl` `addpath` into the source tree to preload the
abstracts, so `extract all` writes back into `team_src/magic/vco_inductor_v2/`.
`reh_ctx_extract.tcl` already had a `cd /tmp` with a comment claiming it kept `.ext` files
out of the repo - **`cd` does not do it**, which is why the comment was there and the file
was corrupted anyway.

This corrupts **in the direction that hides shorts**: the abstract drops the device and adds
a port, so a later extraction diff compares against a baseline that has fewer things in it
than the real cell. Same class as the DRC-clean I_N/Q_N merge in section 3i - a check that
looks green because the thing it would have caught was silently removed from what it
compares to.

**Fix:** `extract path [pwd]` before `extract all` in both scripts, pinning the output
directory. Verified: `verify_cp.sh chip_top` returns byte-identical results (DRC 0, 5
devices, 12 ports, 21 nets, match uniquely) and the tracked `.ext` sha256 is **unchanged**
across the run.

### Regression (2026-08-22) - two cells, not six
Only two cells had a reason to have moved, so only two were run. `PFD_lib`, `CP_v1`,
`ibias_gen_v1` and `DIV2_QUAD_v1` were untouched and their section 5 results stand.

| cell | DRC | devices | ports | nets | LVS | wall |
|---|----:|---:|---:|-----:|-----|-----:|
| chip_top | 0 | 5 | 12 | 21 | match uniquely | 14.6 s |
| vco_v1 | 0 | 4 | 6 | 11 | match uniquely | 11.2 s |

`vco_v1` was re-run because its `.ext` had been disturbed and restored, so its last result
was not trustworthy. Both match section 5.

### **T4 baseline: chip_top blocks-only magic DRC = 84** (2026-08-22)
Measured with `analysis/reh_drc.tcl` at `REH_CELL=chip_top` - full geometry, **no** abstract
preload, which is the same rule set the phase-8 gate uses:

```
==== chip_top  TOTAL 84 ====
  84  chip_top / vco_v1 / vco_varactors   (the same 84 counted hierarchically)
```

All 84 are the known `PL.5a` in `vco_varactors`. This is **identical to `reh_base`'s 84**, so
the two baselines agree. **Every phase-8 DRC number is a delta against 84, never an
absolute.** Note that `verify_cp.sh chip_top` reports **DRC 0** for the same GDS - it
preloads the `vco_varactors` abstract, so the PL.5a geometry is not traversed. Two different
numbers, two different rule sets; do not compare across them.

*(Minor, unfixed: `reh_drc.tcl`'s per-rule printer has its `lindex` indices swapped - it
prints the count where the rule name belongs - and its violation-box loop aborts on a
non-numeric operand. The TOTAL is correct; the breakdown is mislabelled.)*

### Break-before-VSSD is settled
Confirmed from `padframe/A01/project_defs/BH/A01_BH_pad_map.yaml`:

```yaml
breaks:
- instance: BRK_BEFORE_N06
  reason: additional_power_ground_set
  before_slot: N06        # = VDDD's slot in the 12-pin issue
- instance: BRK_AFTER_BH
  reason: project_boundary
  after_slot: N07
```

BV shows the same pattern (`before_slot: N01`, `after_slot: N02`). The reason is
`additional_power_ground_set` - the break fires before a power/**ground** *set*, not before a
lone power pad - and Bailey approved an `info.yaml` whose digital group runs DVSS, signals,
DVDD, which only validates under that reading. With VSSD inserted it becomes the set's first
member, so the break should move to VSSD's slot.

**Still verify when the regenerated DEF lands:** `breaks[0].before_slot` must name **VSSD's**
slot, not VDDD's. If it names VDDD, VSSD is outside the digital island and must move to
*after* VDDD. `in_c` landing at N08 remains genuinely open.

---

## 3n. VTUNE is NOT boxed - 3m's premise died when the core was seated (2026-08-22)

Section 3m concluded VTUNE was boxed. **That conclusion is withdrawn.** It was reached while
chip_top was 522 x 309 and every route had to win an internal column; T2 seated the core at
(175.00,178.50)-(697.00,487.50) inside a 1110 x 550 die, which created free die **south of
y178.5, west of x175, east of x697 and north of y487.5** that did not exist when 3m was
written. Re-measured against the real geometry with `analysis/vtune_routes.py` (occupancy scan
per segment, seated GDS, writes nothing).

### Where the tap actually is, and which way it faces
- **VTUNE tap: die (558.68, 266.70) on M1** (= core (358.68, 66.70)), read from the `L34/10
  VTUNE` label in the seated GDS - not from memory.
- Block extents, die coords: `DIV2 (200.00,200.00)-(437.36,374.17)`,
  `vco_v1 (490.00,200.00)-(672.00,379.48)`, `ibias (200,405)-(381.76,470.25)`,
  `CP (410,405)-(483.50,433.02)`, `PFD (410,445)-(466.99,469.00)`.
- **The DIV2<->vco gap is die x437.36-490.00 - 52.6 um wide**, not the ~2 um 3m implied. 3m's
  "x288-290" came from the channel map's *clear columns*, which were computed for
  **y[175,287.5] core** - the band a NORTH-bound riser crosses. Nobody had measured the gap at
  the tap's own y, going SOUTH, because before T2 there was nothing south to go to.
- **East is genuinely blocked** (measured): 141 um east of the tap crosses M1 x6, M2 x6, M3 x5,
  M4 x2, M5 x6, comp x5, poly x6 and 11 vias - it is the vco interior. The tap faces **west**.

### The three candidates, measured

| route | length | what it crosses |
|---|---:|---|
| **(a) west into the gap, SOUTH out of the core, west through free die, north up the west strip** | **977.38 um** | tap escape (M1/comp/cont/poly x1 - the tap's own comp ring, handled by the 3m via-up-at-the-pad); **M5 x4** = the GND ring only. The 455 um west lane at y165, the 317.5 um riser at x10 and the 9.5 um pad jog are **CLEAR on every layer**. |
| (d) 3m's die-x489 column, north past the spiral | 798.98 um | **M5 x18 + M4 x2** on the riser - i.e. roughly half the 228 um rise sits over spiral turns |
| (a-north) north exit through the gap at die x486 | 798.98 um | M3 x18, M4 x14, M5 x4, M2, v2, v3 - the CP/PFD/ibias region, and it lands in the same 60 um channel the I/Q quad needs |

**772 of route (a)'s 977 um is virgin die with nothing on any layer.**

**A correction to 3m while we are here:** the "x288-290" column is **not M4-clear**. Measured at
die y290-386: x486 M4, x487 M3+M4+v3, x488 M4, x489 M4, x490 M4+M5, x491 M4+M5. The channel
map's columns were "clear of M2 AND M3" only; M4 was never in that criterion.

### One trap worth recording
The west riser must be held **inboard at x~10, never at the pad column x0.5**. The west pin
rectangles all sit at x[0,1] - VSSA y46.36-118.64, VDDA y146.36-218.64, IBIAS y260.34-304.66,
ISS y360.34-404.66 - so a riser run up x0.5 to reach VTUNE at y460-505 would short VTUNE to
IBIAS, ISS, VDDA and VSSA at the padring. Approach inboard, jog west onto the fingers at the
target y only.

### Costing the four options

| | route | length | coupling | what it invalidates | effort |
|-|---|---:|---|---|---|
| **(a)** | around the core through free die | **977 um** (+178 vs the alternatives) | **~ -107 dBc**: nearest aggressor is DIV2 metal 35 um from the y165 lane; ~0.17 fF over 455 um -> ~1.4 mV on the routing node -> /48.6 through the 15k -> 0.028 mV -> 0.023 MHz | **nothing** | **2-3 h** |
| (b) | re-place blocks inside the core | n/a | n/a | matched-quad length (433.76), lane assignment, every per-net escape coordinate, the 3f dy sweep, the 3h crossing table, the channel map, the 3c ground-return numbers, the check_placement baseline; re-gate everything | 2-3 days |
| (c) | re-open vco_v1 to bring TUNE to an edge | shortest possible | best | vco_v1's sign-off (DRC 0 / LVS match uniquely / KLayout 168=W4) and chip_top's; touches the one cell carrying the inductor abstract **and** the W4 waiver | 3-5 days, and it re-opens a signed-off block six days before the gate |
| (d) | accept the die-x489 run | 799 um | **~ -78 dBc** capacitive, **magnetic term unquantified** | nothing, but see below | 1-2 h |

**(d)'s number, by the 3h method, and why it should not be trusted at face value.** 18 of 38
riser segments over M5 ~ 108 um of overlap. Using the recorded 0.047 fF/um -> Cc ~ 5.08 fF;
against the node C ~ 63 fF implied by 3h's own calibration point (2.35 fF, 0.5 V -> 18 mV) the
divider is 0.0747, so a ~2 Vpp-se tank (verification.md 3.2: "near rail-to-rail single-ended")
puts ~149 mVpp on the routing node; the 15 kohm tune R low-passes it (~/97 at 5 GHz) to
~1.54 mV -> x822 MHz/V -> 1.27 MHz -> **-78 dBc**. Two reasons that is optimistic:
1. **0.047 fF/um is a sidewall figure being applied to an overlap geometry.** M3 running under
   M5 plate is not two coplanar M2 wires at minimum spacing.
2. **It captures no magnetic coupling.** The spiral is an inductor; the trace forms a loop in
   its field. That is the actual reason for the never-route-under-the-spiral rule, and
   quantifying it needs EM (`team_src/em/extract_inductor.py` / openEMS), not a cap-per-um.

The 3h calibration is reproduced exactly by this method (0.3 MHz at 2.5 GHz -> -84.4 dBc vs the
recorded -84 dBc), so the arithmetic is sound; it is the model's *scope* that does not cover (d).

### Recommendation: **(a)**
Route (a) buys a route that crosses nothing but the GND ring, on a different layer with no
applicable rule, for **+178 um on a DC node** whose series 15 kohm makes the added resistance
irrelevant. It invalidates nothing, needs no block re-opened, and it puts VTUNE on the opposite
side of the die from the I/Q RF hauls instead of alongside them. (d) saves 178 um and buys an
unquantified magnetic risk on the most phase-noise-sensitive node in the design. (b) and (c)
are large, and neither is necessary once the south exit is on the table.

Secondary benefit: the same south corridor is the natural path for **ISS** (die tap
(595.84,260.33), same vco enclosure, DC tail node), so solving VTUNE this way likely solves ISS
too - to be confirmed when it is routed, not assumed here.

---

## 3o. WEST-STRIP + SOUTH-CORRIDOR LANE ALLOCATION - all five west nets at once (2026-08-23)

Allocated **before** any metal is cut, for all five west-edge nets together, because routing
them one at a time is exactly how 3m happened: a lane looks clear until the net that needed it
is routed third. Measured with `analysis/lane_map.py` on the seated GDS.

**Every scan below tests ALL layers (M1-M5, comp, poly, cont, vias), not just M2/M3.** The
channel map's "clear columns" were computed as *clear of M2 AND M3 only* - which is how 3m came
to call die x489 a clear column when it has M4 in it. Nothing in this allocation relies on that
map; every lane here was re-measured on every layer.

### The layer rule that makes the strip work
- **Vertical risers in the west strip: M3.** **Horizontal pad approaches: M2**, with a via at
  the turn. Then a riser crossing another net's approach is a benign different-layer crossing.
  Without this, VTUNE's riser at x10 and ISS's pad approach at y382.5 are a same-layer short.
- **Power keeps the phase-7 discipline:** VSSA on M5, VDDA on M4. **VDDA MUST NOT run west on
  M5** - the GND ring's left segment is M5 at x182.50-197.50 y182.50-487.50, so an M5 run west
  at y399 shorts VDDA to GND. Measured, not assumed.

### GND ring, exact (M5, from the seated GDS)
```
bottom  x175.00-697.00  y182.50-197.50      left   x182.50-197.50  y182.50-487.50
top     x175.00-697.00  y472.50-487.50      right  x674.50-689.50  y182.50-487.50
```

### West strip - x column allocation (die x0 to 182.5)

| x band | owner | layer | note |
|---|---|---|---|
| **x0-1** | **PAD FINGERS ONLY - NO THROUGH-ROUTING** | M2 | the shorting hazard, see below |
| x2-8 | pad-approach jog zone | M2 | per-net, at that net's pad y only |
| **x10** | **VTUNE riser** | M3 | reserved |
| x16 | VSSA via-down column | M5->M2 | |
| **x22** | **ISS riser** | M3 | reserved, escape UNSOLVED |
| **x34** | **IBIAS riser** | M3 | |
| **x46** | **VDDA descent** | M4 | |
| x57.5-72.5 | VSSA M5 descent (15 um wide) | M5 | |
| x76-172 | **unallocated spare (~96 um)** | - | future nets / fill |
| x175-182.5 | ring fringe - M5 present | - | do not put M5 here |

Measured CLEAR on **every layer**, full height y40-510, at x = 2, 6, 10, 16, 22, 28, 34, 40,
46, 52, 65, 90, 130, 160. First occupancy is at **x175** (M5 x3 = the ring). So the whole strip
x0-172 is virgin die.

**The pad column is a shorting hazard for every west net, not just VTUNE.** The west pin rects
all sit at x[0,1]: VSSA y46.36-118.64, VDDA y146.36-218.64, IBIAS y260.34-304.66, ISS
y360.34-404.66, VTUNE y460.34-504.66. Any riser run up x0.5 shorts its net to every pad it
passes. **All risers inboard of x>=10; approach the fingers horizontally at the target y only.**

### South corridor - y band allocation (die y0 to 178.5, x5 to 470)

| y band | owner | layer | note |
|---|---|---|---|
| y40-160 | **unallocated spare (~120 um)** | - | |
| **y165** | **VTUNE east-west lane** | M3 | x465 -> x10 |
| **y172** | **ISS east-west lane** | M3 | reserved; x455 -> x22. 7 um north of VTUNE's lane so VTUNE's lane never meets ISS's riser |
| (west strip only) y77.75-87.25, x0.5-65 | VSSA M5 approach | M5 | does not enter the corridor proper |

Measured CLEAR on every layer at y = 40, 60, 80, 100, 120, 135, 150, 165, 172 across
x470 -> x5. The core's lowest metal is M4 at y178.5, so y172 keeps 6.5 um.

**Gap descents** (the DIV2<->vco gap, die x437.36-490.00, 52.6 um wide): **x465 = VTUNE**,
**x455 = ISS (reserved)**. Both cross only the GND ring bottom on M5 - M3-vs-M5 has no spacing
rule.

### Per-net routes and lengths

| net | route | length |
|-----|---|---:|
| **VTUNE** | via M1->M3 at tap (558.68,266.70); M3 W to (465,266.70) 93.68; M3 S to (465,165) 101.70 *[ring M5 x4]*; M3 W to (10,165) 455.00; M3 N to (10,482.5) 317.50; via M3->M2, M2 W to (0.5,482.5) 9.50; M2 stub y460.34-504.66 over all 8 fingers | **977.38** |
| **IBIAS** | via M2->M3 at tap (271.30,423.90); M3 W to (34,423.90) 237.30; M3 S to (34,282.5) 141.40; via M3->M2, M2 W to (0.5,282.5) 33.50 | **412.20** |
| **VDDA** | via4 M5->M4 at (256,399); M4 W to (46,399) 210.00 *[ring M5 x3 - M4 is mandatory here]*; M4 S to (46,205) 194.00; via M4->M2, M2 W to (0.5,205) 45.50 | **449.50** |
| **VSSA** | M5 ring-bottom west extension x175->58 at y182.5-197.5, 117.00; M5 S at x65 to y82.5, 107.50; M5 W to x16, 49.00; via stack M5->M2, M2 W to (0.5,82.5) 15.50; M2 stub y46.36-118.64 | **~289** |
| **ISS** | riser x22 / lane y172 / gap x455 / approach y382.5 **RESERVED - escape unsolved** | - |

**IBIAS's 412.20 um independently reproduces 3g's recorded "IBIAS 412"** by a different method
(3g measured a Manhattan haul; this is the actual allocated polyline). Worth noting because
most of 3g's other figures have not been re-derived since the seat.

**IBIAS escapes on M3 at its own tap y**, not at the cleaner-looking y450. The y423.90 line
carries M2 x11, M1 x2, M4 x1, M5 x3 westward but **no M3 at all**, so an M3 escape crosses only
other layers - the same via-at-the-pin technique that fixed the I/Q taps in 3i. The y450 line
looks cleaner overall (M3 x2, M4 x3, M5 x5) but is *not* M3-clear, so it is the worse choice
for an M3 escape. Layer-specific clearance, not total clutter, is what decides.

### ISS: measured, and it does NOT get the corridor for free
Item 6 asked for confirmation by measurement rather than assumption. **The measurement says no.**
Sweeping a west exit from the ISS tap (die 595.84, 260.33) across the vco at every y from 236 to
284:

| y | crossings, x592 -> x492 |
|---|---|
| 236.00 | M1 x4, M2 x4, comp x4, cont x4, poly x4, v1 x2 |
| 242.00 | M1 x4, M2 x4, comp x4, cont x4, poly x4 |
| 248.00 | M1 x4, M2 x4, comp x4, cont x4, poly x4, v1 x2 |
| 254.00 | M1 x6, M2 x2, M3 x9, comp x6, cont x6, poly x5, v1 x2, v2 x2 |
| **260.33 (tap)** | M1 x3, M2 x2, comp x2, cont x2, poly x2, v1 x1 |
| 266.70 | M1 x4, M2 x2, M3 x1, comp x2, cont x3, poly x3, v1 x1, v2 x1 |
| 272.00 | M1 x1, M3 x2, M4 x1, comp x1, cont x1 |
| 278.00 | M1 x1, M3 x1, M4 x1, comp x1, cont x1, poly x1 |
| 284.00 | M1 x1, M3 x1, M4 x1, comp x1, cont x1, poly x1 |

Every line crosses device geometry; a south drop inside the vco is worse still (x594-600, y258
-> y196: 11-15 M1, 14-15 M2, 14 poly, plus M5). ISS sits deeper into the vco than VTUNE - x595.84
vs x558.68 - and VTUNE's west escape was clear precisely because its tap is already west of the
dense active.

**The lightest lines are y272-284** (roughly one obstacle cluster in 100 um), so an escape there
looks jog-able - but that is per-tap build work needing the block's port/net context to tell a
same-net touch from a short, exactly as 3g said. **So: the corridor is budgeted for TWO nets and
one of them is not proven.** VTUNE is routed on it now; ISS's lane, riser and gap column are
reserved and must not be reused, but ISS is not solved and should not be quoted as solved.

### Conflicts this allocation resolves (each was a real same-layer crossing)
1. VTUNE riser x10 (y165-482.5) vs ISS/IBIAS/VDDA pad approaches at y382.5/282.5/205 -> risers
   M3, approaches M2.
2. VTUNE lane y165 vs ISS riser x22 -> ISS's lane sits at y172 and its riser starts there, north
   of VTUNE's lane, so the two never meet.
3. VDDA west run vs the GND ring left segment -> VDDA on M4, not M5.
4. VSSA M5 west extension (y182.5-197.5) vs VDDA's pad approach -> VDDA lands at y205, above the
   extension, and on M2 anyway.
5. IBIAS horizontal at y423.90 vs the VTUNE/ISS risers -> IBIAS turns down at x34, east of both.

---

## 3p. ISS is the VCO TAIL RETURN, and that invalidates its 3o lane (2026-08-23)

3o reserved ISS a 0.4 um M3 riser and called its escape "unsolved". **Both halves of that were
wrong**, in opposite directions. From the golden netlist and the tech file, not the layout.

### What ISS actually carries
`team_src/magic/chip_top_golden.spice`, inlined `vco_v1` golden:
```
.subckt vco_v1 VDD OUT_p OUT_n GND TUNE ISS
XM1 OUT_p OUT_n ISS GND nfet_03v3 L=0.28u W=40u nf=1
XM4 OUT_n OUT_p ISS GND nfet_03v3 L=0.28u W=40u nf=1
```
nfet terminal order is D G S B, so **ISS is the common SOURCE of both cross-coupled nfets - the
tail node** - and the bulks go to a separate GND. There is no on-chip current mirror: the mirror
is in the testbench (`XM1 net3 vsg GND GND nfet_03v3 W=100u` + `I0 GND vsg 1m`). So ISS is
**not** a bias reference. It is the entire return path of the VCO core to the outside world, and
being the common-source node of a cross-coupled pair it carries the **2f0 component (~9.5 GHz)**
as well as DC.

**DC current, measured (verification.md 3.2):** core I(ISS) = **1.24-1.57 mA** across corners
(1.38 mA TT27).

**3c already said this and then did not follow it up.** Its words: *"The tail current (~1 mA)
returns through ISS, not GND, so the VCO's own GND current is small"*. 3c used that to dismiss
the **GND** budget - correctly - and nobody ever budgeted **ISS**. That is the gap.

### The ISS net inside vco_v1, traced (analysis/iss_net.py, flood-fill from the ISS label)
| layer | shapes | extent, die coords |
|---|---:|---|
| M2 | 1 | x587.04-612.83, y260.13-260.53 - **a single 25.78 x 0.40 um strap** |
| v1 | 12 | x588.30-611.57 |
| M1 | 12 | 0.38 x 5.19 um source fingers down to the nfets |

Distance from that net to each vco_v1 edge: **east 59.17**, south 60.13, west 97.05, north
114.16 um. It reaches no edge.

### Escape: 3o's "blocked at every y" was a net-context artifact
The 3o sweep started at x592 and probed 2 um wide, so it was **counting the ISS net's own M2
strap and source fingers as obstacles** - precisely the false positive 3g warned about ("the
escape from a block-interior tap needs the block's port/net context to tell a same-net touch
from a cross-net short"). Re-probed from the strap's real ends at 1 um:

| direction | span | crossings |
|---|---|---|
| **east**, from x613 | 87 um to x700 | **M5 x6 only** (the vco OUT leads + GND ring right) - benign on M2/M3 |
| **west**, from x586 | 98 um to x488 | **M1 x2, comp x2, cont x2, poly x1 - and NO M2, NO M3** |
| south, from the strap | 63 um to y196 | dirty at every x (11-19 M1, 11-19 comp/cont, 18 poly) |

**So ISS escapes cleanly WEST on M2 or M3** - nothing on its own layer for the whole 98 um to
the gap. The escape is not the problem. **The problem is width and length.**

### The impedance budget (the acceptance criterion, per Greg 2026-08-23)
Sheet resistances from `/foss/pdks/gf180mcuD/libs.tech/magic/gf180mcuD.tech`: **M1-M4 90 mohm/sq,
M5 40 mohm/sq**. Inductance at the same ~1 pH/um rule of thumb 3c used.

Route west to W21 at the 3o allocation: internal strap 25.78 + escape 97 + gap descent 88.3 +
south lane 433 + riser 210.5 + approach 21.5 = **~876 um**.

| conductor | R | IR at 1.57 mA | verdict |
|---|--:|---:|---|
| **3o as written: 0.4 um M3** | 2126 sq x 90 mohm = **191 ohm** | **300 mV** | **unusable** |
| 5 um M5 | 170 sq x 40 mohm = 6.8 ohm | 10.7 mV | marginal |
| **10 um M5** | 85 sq x 40 mohm = **3.4 ohm** | **5.3 mV** | meets a 5 mV-class budget |
| internal 0.4 um strap (25.78 um) | 64.5 sq x 90 mohm = **5.80 ohm** | 9.1 mV | **fixed unless vco_v1 is re-opened** |

**DC is solvable by width. Inductance is not solvable by width - only by length.** At ~1 pH/um a
876 um haul is **~876 pH = ~52 ohm at 2f0 (9.5 GHz)**, against a bond wire of ~1 nH = ~60 ohm.
The on-chip haul is **~85 % of the bond**, i.e. it nearly **doubles** the tail inductance.

**This is exactly where 3c's dismissal does not transfer.** For GND, 3c's spur was 175 pH,
*under 20 %* of the bond, and it was common-mode to a differential tank. For ISS the haul is
~85 % of the bond and it is the tail, not a common-mode reference. Applying 3c's own 20 %
yardstick to ISS gives a budget of **<= 200 pH, i.e. a haul <= ~200 um** - **not achievable to
any pad A01 owns.** The nearest alternative, a north slot at N06 (die x567.5, y549), is ~290 um
from the strap and the path crosses the inductor spiral.

**We cannot close this by simulation.** Phase noise is already a recorded toolchain gap - no
PSS/HB in the open-source flow (tracking.md, condition 5). The 2f0 tail-impedance term can be
budgeted and minimised but not verified here.

### Consequences - decisions for Greg, not for this document
- **(A) Build it wide and record the limitation.** >=10 um M5, ~5 mV DC IR, ~876 pH added tail
  inductance. Costs a re-allocation of the west strip and south corridor (below). No block
  re-opened. The added inductance goes on the record beside the existing phase-noise gap.
- **(B) Move ISS to a north pad** (info.yaml pin-order change, ISS before VSSD so it stays on
  the analog rail = N06). ~290 um instead of ~876. But the escape then crosses the spiral, which
  is forbidden for VTUNE and merely *uncharacterised* for a node that already carries 2f0.
- **(C) Re-open vco_v1** to widen the internal 0.4 um strap and bring ISS out at an edge. Only
  this fixes the internal 5.80 ohm. 3-5 days, re-opens the block carrying the inductor abstract
  and the W4 waiver.

### 3o's ISS lane is superseded - what must change before a, b, c, d are drawn
A >=10 um M5 bus is not a 0.4 um riser and does not fit the 3o slots. Re-allocate **now**, so the
earlier nets are not drawn into a strip that has to be re-cut:
- **VSSA**: shorten the M5 ring-bottom west extension to **x175 -> x120** (not x58) and descend at
  **x120** (x112.5-127.5). This clears the whole strip west of x112 for other M5.
- **ISS**: **10 um M5 bus centred x90** (x85-95), west of the VSSA extension, so the two never
  share a layer at a crossing.
- **ISS south lane**: **10 um centred y140** (y135-145), using the corridor's ~120 um of spare
  instead of squeezing against VTUNE's y165 and the core's M4 at y178.5.
- **ISS gap descent**: must cross the GND ring bottom (M5, y182.5-197.5), so it descends the gap
  **on M4** (10 um over ~88 um = 0.79 ohm, negligible) and vias to M5 below the ring. An M5
  descent there would short ISS to GND - the same trap as VDDA.

### Flag, not an assertion: the internal strap's current density
The 0.4 um strap carries up to 1.57 mA = **3.9 mA/um**. Elsewhere this design sized a chip-level
VSS tap at 23 um for 22.4 mA (~1 mA/um, route_chip.py `gnd_tap`). That is a ~4x difference in
density inside a signed-off block. **I have not looked up the gf180 M2 EM limit** - this is
raised as a question about vco_v1, not a finding.

---

## 3q. EM limit looked up; allocation checked by tool, not by eye (2026-08-23)

### The gf180 EM limit, and the ISS strap's margin
The **open PDK ships no EM data** - no current-density table anywhere under
`/foss/pdks/gf180mcuD/`, and the KLayout DRC decks are geometric only. The authoritative
source is the GF180MCU design manual, **DRM 14.2 Electro-migration**
(<https://gf180mcu-pdk.readthedocs.io/en/latest/physical_verification/design_manual/drm_14_2.html>),
targeting T0.1 > 100 kHours at 85 C junction.

**Metal 1 - (Top Metal - 1)**, i.e. M1-M4 in this stack, mA per um of drawn width:

| junction T | unidirectional | bi-directional |
|---|---:|---:|
| 85 C | **2.09** | 3.14 |
| 110 C | **1.00** | 1.50 |
| 125 C | **0.67** | 1.00 |

Contacts/vias, mA per cut: Via1-5 **0.58 / 0.28 / 0.18** at 85 / 110 / 125 C.

**The vco_v1 ISS strap: 0.40 um M2 carrying up to 1.57 mA.** Tail current is DC, so the
**unidirectional** column applies.

| tap point | current in the strap | density | vs 85 C (2.09) | vs 110 C (1.00) | vs 125 C (0.67) |
|---|---:|---:|---:|---:|---:|
| one end (full current) | 1.57 mA | **3.93 mA/um** | **1.88x OVER** | 3.93x OVER | 5.87x OVER |
| **midpoint** (x~600, the 6.6 um gap between the two 6-finger clusters) | 0.785 mA | **1.96 mA/um** | **passes, 6 % margin** | 1.96x OVER | 2.93x OVER |

Width required for the full 1.57 mA: **0.751 um** at 85 C, 1.57 um at 110 C, **2.34 um** at
125 C. The strap is 0.40 um.

**Everything else in the ISS path passes:** the 12 via1 cuts carry 0.131 mA each against a
0.18 mA limit at 125 C (27 % margin); the 12 M1 source fingers run 0.344 mA/um against 0.67
(49 % margin at 125 C); and our own haul at 8-10 um is 0.157-0.196 mA/um, two decades clear.
**The 0.40 um M2 strap is the sole violator.**

Two things follow, neither acted on yet (Greg, 2026-08-23: report the limit, do not act):
- **Tapping the strap at its midpoint is worth ~2x** and is free - it is where our haul attaches,
  and the 6.6 um gap between the finger clusters is the natural landing anyway. That alone
  clears 85 C.
- **The fix, if the junction spec is 110 or 125 C, is widening ONE shape** in `vco_v1` from
  0.40 um to ~1.6-2.4 um - a one-shape edit plus a re-gate of vco_v1 and chip_top, **not** the
  3-5 day block redesign of 3p option (C). Feasibility of widening (which way the strap can grow
  past the M1 fingers at y260.13-265.32) has not been checked.

### The allocation is now checked by a tool
Greg caught an **M5-on-M5 short in 3p's own re-allocation**: VSSA descending on M5 at
x112.5-127.5 y82.5-190 and the ISS south lane on M5 at y135-145 overlap at
x112.5-127.5, y135-145. It was real. It is the third time this class of bug has appeared
(3i I_N/Q_N, 3l I_P/Q_P, now this) and the second time in a plan written to prevent it.

`analysis/lane_conflicts.py` now holds the allocation **as data** and checks it two ways:
1. **net vs net**, every pair of segments on the same layer, rectangle overlap;
2. **net vs existing chip geometry**, on that segment's **own layer only** - a different-layer
   crossing is benign, a same-layer one is a short.

Same-layer overlap at zero gap is invisible to DRC (no gap, no spacing violation), which is
exactly why both earlier shorts passed a clean DRC. This runs before metal is cut.

**Result on the corrected allocation: 0 net-vs-net overlaps; 1 net-vs-chip same-layer touch,
and that one is VSSA's M5 extension meeting the GND ring - same net, intended.** Every other
segment is clear on its own layer.

### Corrected allocation (supersedes 3o's ISS lane and 3p's first attempt)
The insight that resolves it: **VSSA descends left-and-down while ISS rises left-and-up, so on a
single layer they must cross exactly once.** Rather than move them apart - which the geometry
does not allow, since any ISS riser west of x175 must cross VSSA's path somewhere - **ISS hops to
M4 for 20 um across VSSA's descent** and returns to M5. That crossing costs 2 squares of M4,
0.18 ohm.

| net | layer | segment (die um) | width |
|-----|---|---|---:|
| VTUNE | M3 | (558.68,266.70)->(465,266.70)->(465,165)->(10,165)->(10,482.5) | 0.4 |
| | M2 | ->(0.5,482.5); stub y460.34-504.66 | 0.4 / 1.0 |
| IBIAS | M3 | (271.30,423.90)->(34,423.90)->(34,282.5) | 0.4 |
| | M2 | ->(0.5,282.5); stub y260.34-304.66 | 0.4 / 1.0 |
| VDDA | M4 | (256,399)->(46,399)->(46,205) | 3.0 |
| | M2 | ->(0.5,205); stub y146.36-218.64 | 3.0 / 1.0 |
| VSSA | M5 | (175,190)->(120,190)->(120,82.5)->(16,82.5) | 15 / 15 / 9.5 |
| | M2 | ->(0.5,82.5); stub y46.36-118.64 | 9.5 / 1.0 |
| **ISS** | M2 | (587.04,260.33)->(490,260.33) escape west | **8.0** |
| | M4 | ->(455,260.33)->(455,140) gap descent, M4 **through the ring band** | 10.0 |
| | M5 | ->(130,140) south lane | 10.0 |
| | **M4** | ->(110,140) **the one deliberate crossing, over VSSA's descent** | 10.0 |
| | M5 | ->(90,140)->(90,382.5)->(16,382.5) riser west of VSSA | 10.0 |
| | M2 | ->(0.5,382.5); stub y360.34-404.66 | 10.0 / 1.0 |

The **8 um ISS escape is measured M2-clear** for the full 97 um from x490 to x587.04 - so the
escape does not have to be a 0.4 um thread either.

### T6 candidate (NOT this week): a tail decap from ISS to VSSA
Shunting 2f0 locally makes the ~876 pH haul inductance far less consequential, and MOS-cap or
MIM area in the free die adds comp/poly/metal coverage against the density floors that are still
unsolved - two problems, one structure. It needs a **golden-netlist change**, so it cannot ride
this week's push. Recorded here as a final-data candidate alongside the secondary-ESD clamps and
density fill.

---

## 3r. (a) I/Q QUAD BUILT into chip_top - clean gate (2026-08-23)

Ported from `analysis/phase8_incontext.py`'s throwaway cell into `phase5/route_chip.py`, in
**core** coordinates, ahead of the seat step. All four escapes, the west-to-east left-riser
ordering, I_P's `novia`, and the low-jog/high-jog split are carried over verbatim - each of them
fixes a specific silent short (3i, 3l) and none is cosmetic.

**Matched length RE-DERIVED on the seated frame, not carried across** (Greg: it has moved four
times, 269 -> 332 -> 458 -> 433.76). Base lengths in the core frame: **Q_N 331.76, I_N 278.65,
I_P 298.41, Q_P 433.76**; Q_P sets the target; all four routed to **433.760 um, spread
0.0000 um**. The figure is unchanged from pre-seat, and that is the expected result rather than
a coincidence - the seat is a pure translation and the taps and the pads move together - but it
is now a derived number.

### Landing: the slot centre is a GAP between fingers
A 0.4 um drop at the slot centre would have touched **nothing**. Each `asig_5p0` pin is 8
separate 2.54 um Metal2 fingers; for N02 they sit at x145.34-147.88, 151.02-153.56,
156.70-159.24, 162.38-164.92, 170.08-172.62, ... - and the centre, **x167.50, falls in the gap
between the 4th and 5th**. Each net now lands with one M2 bar across its whole finger row
(centre +/- 22.16 um at y549-550), tying all 8 fingers, which is what the pin is.

### The gate
| part | baseline | with the quad | verdict |
|---|---|---|---|
| magic DRC **box set** vs `chip_top.drcbase` | 106 / 252 boxes | 106 / **252** | **0 added, 0 removed** |
| KLayout signoff | PASS, 168 waived | PASS, **168** | identical |
| extraction devices / ports / nets | 5 / 12 / 21 | **5 / 12 / 21** | identical |
| LVS | match uniquely | **match uniquely** | identical |

Ports staying at **12** is the distinctness result: 3l's tap-to-block short showed up precisely
as 12 -> 14 ports. Seated extent is now (145.34,178.50)-(697.00,550.00) inside the DIEAREA.

### The checker immediately caught a short in a net not yet drawn
Adding the quad to `analysis/lane_conflicts.py` (Greg: all-nets, not west-five) turned up **two
real M3-on-M3 overlaps** at once: **IBIAS's planned escape at y423.90 crosses the Q_N riser
(x198.58) and the I_N riser (x199.88)**, 0.40 x 0.40 um each. 3o had checked IBIAS against
VTUNE (x10) and ISS (x22) and found it turned down at x34, east of both - but the quad risers
sit at x198.58/199.88, *between* IBIAS's tap at x271.30 and that turn, and the quad was not in
the checker at the time.

IBIAS's tap is east of the risers and its pad is west, so **no re-route avoids the crossing** -
it has to change layer. **M4 is clear at x193-206, y422.4-425.4** (measured), so IBIAS hops
**M3 -> M4 -> M3 across x193-204**: 11 um of M4 and two via stacks. Along the rest of the
escape M4 is occupied only at x248.60-405.30, east of the hop.

**0 net-vs-net overlaps across all nine nets** after the fix. This is the first time this bug
class has been caught before the metal existed rather than after.

---

## 3s. THE SLOT CENTRE IS ALWAYS IN A GAP - all eleven multi-finger pins (2026-08-23)

3r found this on one pin and filed it as a quad fix. It is not. `analysis/pin_landings.py`
runs the test on every pin in the issued DEF:

> **All ELEVEN multi-finger pins have their nominal slot centre inside an inter-finger gap.
> Not one is on metal.** A bare drop at the centre touches **nothing** - and that is
> **DRC-clean** (nothing to space against), **LVS-clean** (the net still reaches its label), and
> **dead on silicon**. Same failure family as the silent short: the check that would catch it is
> not the check being run.

It is systematic, not luck. The generator lays an **even** number of fingers symmetrically about
the slot centre, so the centre is always the midpoint of the central gap.

| pin | slot | cell | fingers | centre | gap it lands in |
|-----|---|---|---:|---:|---|
| VSSA | W18 | dvss | 6 x 9.50 | y82.500 | **3.28 um** (80.860-84.140) |
| VDDA | W19 | dvdd | 6 x 9.50 | y182.500 | **3.28 um** (180.860-184.140) |
| IBIAS | W20 | asig | 8 x 2.54 | y282.500 | **5.16 um** (279.920-285.080) |
| ISS | W21 | asig | 8 x 2.54 | y382.500 | **5.16 um** (379.920-385.080) |
| VTUNE | W22 | asig | 8 x 2.54 | y482.500 | **5.16 um** (479.920-485.080) |
| CP_OUT | N01 | asig | 8 x 2.54 | x67.500 | **5.16 um** (64.920-70.080) |
| **Q_N** | N02 | asig | 8 x 2.54 | x167.500 | **5.16 um** (164.920-170.080) |
| **I_N** | N03 | asig | 8 x 2.54 | x267.500 | **5.16 um** (264.920-270.080) |
| **I_P** | N04 | asig | 8 x 2.54 | x367.500 | **5.16 um** (364.920-370.080) |
| **Q_P** | N05 | asig | 8 x 2.54 | x467.500 | **5.16 um** (464.920-470.080) |

> **CORRECTED 2026-08-23.** This table originally listed I_P/I_N/Q_P/Q_N against N02-N05 -
> the **old 12-pin** package's assignment, transcribed before the reorder was regenerated.
> The **13-pin DEF** puts **Q_N N02, I_N N03, I_P N04, Q_P N05**, which is what `info.yaml`
> declares and what the built metal targets (verified by measuring the landing bars in
> `chip_top.gds`, not by reading this table). The gap geometry per slot is unchanged.
| VDDD | N06 | dvdd | 6 x 9.50 | x567.500 | **3.28 um** (565.860-569.140) |
| REF_IN_PU / _PD / Y | N07 | in_c | 1 x 0.38 each | on the finger | - (single shape) |

### The three landing rules
1. **`asig_5p0` - 10 pins.** 8 fingers x 2.54 um, pitch 5.68, one 5.16 um gap dead centre.
   **One M2 bar across the row, centre +/- 22.16 um**, tying all 8. Already built for the quad.
2. **`dvss` / `dvdd` - 3 pins** (VSSA, VDDD, and VSSD when issued). 6 fingers x 9.50 um, pitch
   12.40, one 3.28 um gap dead centre. **One M2 bar, centre +/- 36.14 um.**
3. **`in_c` - REF_IN, and it is the dangerous one.** Y, PU and PD are **three separate pins in
   one slot**, each a **single 0.38 um finger** - Y at x633.76-634.14, PD at x694.29-694.67,
   PU at x698.65-699.03 in the present issue. **There is no row to bar across.** Each is a
   precision landing on one 0.38 um shape, and a 0.4 um wire centred 0.2 um off misses it
   entirely while looking perfectly routed. Flagged now; built when the DEF lands.

**Every landing shape is now a segment in `analysis/lane_conflicts.py`**, including the pins not
yet routed, so anything routed later is checked against the metal that will have to exist at the
pad rather than against empty space.

### 13-pin regeneration - predicted, and to be verified not assumed
N01-N05 and W18-W22 do not move. **VSSD -> N06** `dvss` x531.36-603.64 (takes VDDD's present
slot geometry - `dvss` and `dvdd` share the 6 x 9.5 finger pattern); **VDDD -> N07**
x631.36-703.64; **REF_IN -> N08**, Y x733.76-734.14, PD x794.29-794.67, PU x798.65-799.03. All
six numbers verified against the regenerated DEF before anything lands on them.

---

## 3t. (b)-(e) BUILT: VSSA, VTUNE, VDDA, IBIAS, ISS - and the four bugs they exposed (2026-08-23)

All five west nets are routed into `chip_top` and the assembled chip passes every gate. **Four
real defects surfaced during the build; none of them was found by magic DRC.** They are recorded
in full because each is a distinct trap.

### Final state
| net | route | length |
|-----|---|---:|
| VSSA | M5 ring-bottom spur west, south at die x120, M2 plate on the W18 finger column | 266.5 M5 + plate |
| VTUNE | via up at the gate pad, M3 west, south through the gap, west at die y165, riser die x10 | **967.88** |
| VDDA | via4 onto the M5 bus at die x260, M4 west across the ring, M4 down, M2 feeder + plate | 404.0 |
| IBIAS | M3 at the tap y423.90, M4 hop over the quad risers, M3 west + down, M2 feeder + plate | 382.7 |
| ISS | 5 um M2 escape, 10 um M4 gap descent, 10 um M5 lane/riser, M4 hop over VSSA | 935.9 |

### Gate on the assembled chip
| check | result |
|---|---|
| magic DRC box set vs `chip_top.drcbase` | 106 / 252 boxes, **0 added, 0 removed** |
| KLayout signoff | **PASS**, 168 waived (84 PL.5a_LV + 84 PL.5b_LV) |
| extraction devices / **ports** / nets | 5 / **12** / 21 |
| LVS | **match uniquely**, zero disconnected nodes |
| `check_placement` | CONSISTENT |
| `analysis/lane_conflicts.py` | 0 net-vs-net same-layer overlaps |

### Bug 1 - `R.hwire` extends half its width past each endpoint
Not documented anywhere, and it bites in proportion to wire width. The **VSSA** M2 leg nominally
ending at die x0.5 actually reached **x-4.25**, outside the DIEAREA. The **ISS** M5 south lane
nominally ending at die x130, clear of VSSA's descent at x112.5-127.5, actually reached **x125**
and **merged ISS into the entire ground ring**: LVS 21 nets -> 20, with netgen showing the
layout's `ISS` net carrying `PFD_lib/VSS`, `vco_v1/GND`, `ibias/VSS`, `DIV2/VSS`, `CP/VSS`.
DRC-clean, because a merge leaves no gap to space against.

**`analysis/lane_conflicts.py` did not catch it either** - it modelled centrelines with a side
width but no end extension. Fixed: `rect()` now extends by `w/2` on all four sides, with a
separate `ext` override for the serpentine envelope bands (their 12.4 um height is meander
excursion, but the metal is still a 0.4 um trace, so they extend 0.2 um at the ends, not 6.2).

### Bug 2 - the ISS escape ran through an other-net M2 rail
There is an **other-net M2 rail 1.16 um below the ISS strap** (die y258.69-258.97,
x587.10-612.77). The first escape was 8.0 um centred on the strap, spanning die y256.33-264.33 -
straight through it. Second merge of ISS into ground, same signature. **Fix:** 5.0 um centred
die y261.8, sitting between that rail (0.93 um clear) and the next M2 north at y266.12 (3.22 um
clear), still overlapping the strap. At 0.314 mA/um it is two decades inside the EM limit.

### Bug 3 - two landing misses, exactly the 3s failure family
Both showed up as **extra ports**, 12 -> 13, with netgen reporting `disconnected node`:
- **`VSSA_uq0`** - the via to the pad plate sat at `VSSA_XV + 2.0`, i.e. **2 um outside** the
  plate (which ends at `VSSA_XV`). Sign error. The plate connected to nothing.
- **`VDDA_uq0`** - 3o said to tap the VDDA M5 bus at die x256. **The bus starts at x258.5.** The
  via4 landed 2.5 um short of it and the whole VDDA haul extracted as a floating node.

Both DRC-clean. Both caught only by the port count, which is why it is the distinctness check.
3s generalised "the centre of a pin is a gap"; this generalises further: **any landing whose
coordinate was taken from a plan rather than measured off the target is suspect.**

### Bug 4 - MSLOT.1, caught by KLayout and invisible to magic
**Maximum metal width without slotting is 30 um, measured in BOTH axes.** The first VDDA pad
plate was 48 x 72.28 um and the IBIAS plate 36 x 44.32 um; both violate. magic DRC reported
**zero** added violations for the same geometry - this is a KLayout-signoff-only rule. **Fix:**
plates capped at **18 um** wide across the finger column, with a narrow M2 feeder out to the via.
**Rule for anything built later: no pad plate wider than 30 um in both axes.**

### The EM widen, done at top level instead of inside vco_v1
The strap is 0.40 um M2 carrying up to 1.57 mA = **3.93 mA/um**, over the DRM 14.2
unidirectional limit at **every** temperature (2.09 / 1.00 / 0.67 at 85 / 110 / 125 C).

It is widened to **3.0 um by painting M2 over it from `route_chip.py`**, not by editing
`vco_v1`. Same-layer paint merges with the strap and widens the same conductor, so the fix is
electrically identical - but `gds/vco_v1.gds` is untouched, **vco_v1 keeps its sign-off, and
`chip_top.drcbase` needs no re-baseline**, which is the whole reason the widen was scheduled as
its own step. Measured before painting: nearest other-net M2 at y258.97 below and y266.12 above,
**zero via2 in the window**, and the 12 via1 at y260.20-260.46 are ISS's own and stay covered.

At 3.0 um the density is **0.523 mA/um**: **4.0x** margin at 85 C, **1.91x** at 110 C, **1.28x**
at 125 C. Note the ISS bus already merges with the strap west of die x592.04, so only the
eastern span needed the patch.

**Residual, recorded not hidden:** `vco_v1` **standalone** still contains a 0.40 um ISS strap.
That is only correct in the chip_top context, where the overlay exists. If vco_v1 is ever
re-released as a standalone block the strap must be widened in the cell itself.

---

## 3u. BUILD LIST for VDDD, REF_IN and the PU/PD ties (blocked on the 13-pin DEF)

Deliberately not started. This is a **build list, not a re-derivation** - every input below is
already fixed, so when the DEF lands the only new work is drawing it.

**Verify first (padframe/README.md), before drawing anything:**
1. `A01_selected_variants.json` still offers **BH/BV**, not A. Layer 0/0 now reads exactly
   1110 x 550, and an allocator using a strict inequality rather than "fits" could bump an
   exact-size project a config. This is the expensive one.
2. `A01_BH_pad_map.yaml` `breaks[0].before_slot` names **VSSD's** slot, not VDDD's.
3. `in_c` lands at **N08**.
4. The six predicted coordinates in 3s.

**Then build:**
| net | source | predicted landing | notes |
|-----|---|---|---|
| VSSD | digital VSS taps - PFD.VSS die ~(433,457) or DIV2.VSS die ~(353,279) | N06 `dvss`, bar die x531.36-603.64, **centre +/- 36.14 um** | do NOT draw it from the VSSA ring; keeping the digital return local to that island is the point of the break (3g) |
| VDDD | the M5 VDDD bus, die y382-394 x249-442 | N07 `dvdd`, bar die x631.36-703.64 | tap the bus **inside** its x range - bug 3 was exactly this mistake on VDDA |
| REF_IN (Y) | PFD.REF, die (410.28,457.60) M3 | N08 `in_c`, **single 0.38 um finger** at die x733.76-734.14 | precision landing, no row to bar across |
| REF_IN_PD | tie to **VDDD** (pull-down enable = 1) | single 0.38 um finger, die x794.29-794.67 | 2 |
| REF_IN_PU | tie to **VSSD** (pull-up disable = 0) | single 0.38 um finger, die x798.65-799.03 | 2 |

Notes: (1) `PU=0, PD=1` = weak pull-down, decided 2026-08-21 and re-confirmed against the PDK
truth table (2). Both terminals must be driven - a floating CMOS control gate is not acceptable.
**PD ties to VDDD and PU ties to VSSD**, the digital island's ground, **not VSSA**.
(2) The in_c landings are the highest-risk geometry in the design: three separate pins in one
slot, one 0.38 um shape each, and a 0.4 um wire centred 0.2 um off misses entirely while
looking perfectly routed. Land them by measuring the finger, not by computing a slot centre.

Every one of these gets a `lane_conflicts.py` segment before the metal is cut.

---

## 3v. 13-PIN DEF ARRIVED, and (f) VSSD / VDDD / REF_IN / PU / PD BUILT (2026-08-23)

`A01.def (2).tgz` (sha256 `45d2fb85...`), extracted to **`padframe/A01/project_defs_13pin/`
alongside** the 12-pin package, which is kept for diffing.

### The three arrival checks - all pass
1. `selected_variants` = **BH only**, `participant_pin_count` **13**. **Not** bumped to another
   config. BV is no longer offered - we chose BH, so that costs nothing. And `project_size` now
   reads **1110 x 550, rectangle_dbu [0,0,222000,110000]**: the generator has picked up our
   seated 0/0 boundary.
2. `breaks`: `BRK_BEFORE_BH before W18`, **`BRK_BEFORE_N06` reason
   `additional_power_ground_set`** - firing before **VSSD's** slot, not VDDD's, exactly as 3q
   predicted - and `BRK_AFTER_BH after_slot N08`.
3. `in_c` lands at **N08**. Confirmed.

Slot map: VSSA W18, VDDA W19, IBIAS W20, ISS W21, VTUNE W22, CP_OUT N01, **Q_N N02, I_N N03,
I_P N04, Q_P N05**, VSSD N06, VDDD N07, REF_IN N08. **Every one of 3s's predicted coordinates is
confirmed exactly**, including the three in_c fingers.

### The built quad was verified by MEASUREMENT, not by reading the plan
| built label | die x of its landing bar | 13-pin DEF slot there |
|---|---|---|
| Q_N | 145.34-189.66 (c 167.50) | **Q_N, N02** |
| I_N | 245.34-289.66 (c 267.50) | **I_N, N03** |
| I_P | 345.34-389.66 (c 367.50) | **I_P, N04** |
| Q_P | 445.34-489.66 (c 467.50) | **Q_P, N05** |

**Correct - no rebuild.** The build took its pad x from the reordered `info.yaml`, which is what
the 13-pin DEF implements. **3s's table was the hazard**: transcribed from the *old* 12-pin
package, so it documented the old assignment while the metal followed the new one. Corrected in
place with a note.

### Why the base-length spread is 155 um and not 3d's predicted 58
Bases: Q_N 331.76, I_N 278.65, I_P 298.41, Q_P 433.76 - spread **155.11 um**. 3d predicted 58.
**3d is stale, not wrong at the time**, for two reasons:
- It was swept at **dy=262.5**, before 3f moved the core to dy=200. That shifts all four equally
  (+62.5), moving the mean and not the spread - 3f's own table shows the matched target going
  269 -> 332 from dy alone.
- **3d swept pure Manhattan hauls, before the escape/jog geometry existed.** The jogs added in
  3f/3i/3l - to clear the M3-on-M3 conflicts and the I_P/Q_P tap-to-block short - are
  asymmetric, and Q_P takes the worst: east escape, north to y398, **west** to x400, north to
  the lane, then **east** to the pad. That backtracking costs ~102 um a straight riser does not
  pay, and Q_P sets the target.

**Consequence for 3e, recorded rather than left stale:** the matched haul is 433.76 um, not 269,
so the added load is **~34.7 fF/output** at 0.08 fF/um, not ~21.5. By 3e's own method that is a
**~0.9 %** monitor-amplitude drop at 3 GHz rather than 0.6 % - still negligible, but 34.7 fF is
the figure on record now. The reorder's **crossing** benefit (3 -> 0) is untouched; its length
benefit is smaller than 3d advertised once the real escape geometry is included.

### (f) built
| net | route | landing |
|-----|---|---|
| **VSSD** | M4 riser off the **GND ring TOP** at die x567.5, y480 -> 547 | N06 bar x531.36-603.64 |
| **VDDD** | via4 onto the M5 bus at die x408 (inside x249-442), M4 riser to y505, east with an **M5 hop over VSSD's M4 riser**, M4 riser at x667 | N07 bar x631.36-703.64 |
| **REF_IN** | PFD.REF die (410.28,457.60), escape **west** off PFD's own edge, north, east at y505, north at x734 | **single 0.38 um Y finger** |
| **REF_IN_PD** | M2 at y540 west to VDDD's riser - **PD -> VDDD** | single 0.38 um finger |
| **REF_IN_PU** | M2 at y528 west to VSSD's riser - **PU -> VSSD**, the digital island's ground | single 0.38 um finger |

VSSD is taken from the ring **top** segment because that is where `gnd_tap(233,262,4,"up")`
already lands PFD.VSS - so it is the digital VSS by the shortest path, not a spur off the analog
side. PU and PD carry no net of their own: PD **is** VDDD's net and PU **is** VSSD's.

Two more landing misses were caught, both by the port count:
- the two w=3 M2 drops extended 1.5 um past their endpoints and pushed the die extent to
  **y551**, outside the DIEAREA;
- **REF_IN's Y landing box started at die y549.0 while its via2 M2 pad ended at y548.75** - a
  **0.25 um** gap, extracted as `REF_IN` + `REF_IN_uq0`. The box now reaches down to y548.3.

### Gate
| check | result |
|---|---|
| magic DRC box set | 252 boxes, **0 added, 0 removed** |
| KLayout signoff | **PASS**, 168 waived |
| extraction devices / ports / nets | 5 / **12** / 21, **zero disconnected nodes** |
| LVS topology | **"Netlists match uniquely"** - 5 devices, 19 nets both sides |
| LVS pin match | **fails on one name** - below |
| `check_placement` | CONSISTENT |
| `lane_conflicts`, all 12 nets | **0** net-vs-net same-layer overlaps |

### THE ONE OPEN ITEM: VSSA vs VSSD in the golden
netgen reports *"Netlists match uniquely"*, then *"Top level cell failed pin matching"* on
exactly one pin - layout **`VSSD`** against golden **`VSSA`**. Every other pin matches.

**This is not a layout defect.** VSSA and VSSD **are one electrical node** on-chip (shared
p-substrate, no deep nwell; Bailey confirmed 2026-08-21 that the user grounds are shorted
through the padring and substrate anyway), so magic emits **one** name for the net and picked
VSSD. The layout cannot present two ports for one net.

**RESOLVED 2026-08-23 with no schematic change - see 3w.**

Until then the distinctness evidence is: 12 ports with exactly the expected names, **zero**
disconnected nodes, **zero** `_uq0` duplicates, 21 nets, and a topology that matches uniquely.

---

## 3w. The ground port name, resolved without touching the golden (2026-08-23)

3v left LVS failing pin matching on one name: layout `VSSD` against golden `VSSA`. The proposed
fix was a schematic change. **It is not needed.**

### The mechanism, from the magic tech file
```
 layer MET2     allm2          layer MET2TXT
        labels  allm2 noport          labels  allm2 port
        calma   36 0                  calma   36 10
```
Every metal has the same pair: text on **`<layer>/10` becomes a PORT**, text on **`<layer>/0`
becomes a plain LABEL that magic never promotes to a port**. VSSA and VSSD are one electrical
net, magic emits one name for it, and with both texts on /10 it was picking VSSD.

**Fix: the VSSD text goes on 36/0 instead of 36/10.** It is still in the GDS; it simply never
competes for the port name.

| | before | after |
|---|---|---|
| extracted ports | 12 | 12 |
| ground port name | **VSSD** | **VSSA** |
| nets | 21 | 21 |
| LVS | *"Netlists match uniquely"* then **failed pin matching** | **match uniquely, RESULT PASS** |

`.subckt chip_top VTUNE I_P I_N Q_P Q_N IBIAS ISS **VSSA** VDDA VDDD REF_IN CP_OUT`

The golden, `chip_top.sch` and `chip_sch_gen.py` are all **untouched**.

### Why this is safe for Bailey's audit - and the one thing still unverified
His `top_cell_text` scrape of our GDS (in `A01_selected_variants.json` and the interface yaml)
reports **each text with its layer AND datatype**, and lists **duplicates separately** - Q_N,
I_N, I_P and Q_P each appear twice, once on 34/10 at the block tap and once on 36/10 at the pad.
So the audit is a plain text scrape and does not care whether a text is a magic port.

**Unverified:** every text in the GDS he scraped happened to be on `/10`, so that evidence
cannot tell us whether his scraper collects **all** text or filters to datatype 10. Reporting
the datatype per entry suggests it collects all text - a /10-only filter would make the field
redundant - but that is inference, not proof. **It is settled by his next regeneration:** if
`VSSD` appears in `top_cell_text`, this is done. If it does not, the fallback is to rename the
golden's ground port to VSSD, which we know works because that was the state before this change.

Current text state in the GDS: `VSSD` 36/0 at die (567.50,549.50); `VSSA` 36/10 at (0.50,82.50)
and 81/10 at (400.00,190.00).

---

## 4. T2 DONE - the core is seated in the A01_BH DIEAREA (2026-08-22)

`gds/chip_top.gds` now **is** the padframe block: boundary exactly `(0,0)-(1110,550) um` =
`(0,0)-(222000,110000)` dbu, the A01_BH `DIEAREA` verbatim.

### How
A final step in `route_chip.py`, after all routing, replacing the old
"0/0 boundary at the true die extent" code:

```python
DX, DY = 200.0, 200.0            # core offset inside the die (3f)
DIE_W, DIE_H = 1110.0, 550.0     # A01_BH DIEAREA, exact
chip.transform(pya.DTrans(DX, DY))
ly.clear_layer(ly.layer(0, 0))   # exactly one boundary, whatever was there before
chip.shapes(ly.layer(0, 0)).insert(pya.DBox(0.0, 0.0, DIE_W, DIE_H))
```

Seating here rather than offsetting `chip_merge.py`'s `BLOCKS` table means **every routing
coordinate above it stays core-frame and unchanged**, and `check_placement.py` keeps
comparing core-frame to core-frame - verified still `PLACEMENT CONSISTENT`, exit 0, **no
re-baseline needed**. A guard raises if the cell already looks seated (bbox LL x >= 0), so
running `route_chip.py` twice cannot silently double-shift the core.

### Measured, verified independently in KLayout
```
core frame  : (-25.00,-21.50)-(497.00,287.50)  522.0 x 309.0 um
seated      : core occupies (175.00,178.50)-(697.00,487.50)
top bbox    : (0,0)-(222000,110000) dbu   = (0.000,0.000)-(1110.000,550.000) um
layer 0/0   : exactly 1 shape in chip_top, 0 in every other cell
```
The old 522 x 309 rectangle is **gone**, not coexisting - `clear_layer` guarantees it. dbu is
0.005 um on both sides, so this was a pure translation, no scaling.

### The four-part gate on the reframed cell

| gate part | before reframe | after reframe | verdict |
|---|---|---|---|
| KLayout signoff (the real signoff DRC) | PASS, 168 waived (84 PL.5a_LV + 84 PL.5b_LV) | PASS, **168 waived**, same split | **identical** |
| `verify_cp.sh chip_top` DRC | 0 | **0** | identical |
| extraction: devices / ports / nets | 5 / 12 / 21 | **5 / 12 / 21** | identical |
| LVS | match uniquely | **match uniquely** | identical |
| `check_placement.py` | CONSISTENT | **CONSISTENT** | identical |
| magic hierarchical DRC count | 84 | **106** | **disagreed - investigated below** |

### The magic 84 -> 106 count is an artifact. The violations did not change.
Reported rather than papered over, because a DRC number disagreeing with a baseline is
exactly the thing that must not be waved through. Three independent checks:

1. **Isolation.** Three throwaway variants of the reframed GDS, same DRC deck:
   - 0/0 boundary layer deleted entirely -> **106**
   - 0/0 boundary put back at the old core extent -> **106**
   - core translated back by -200/-200 -> **84**

   So it is not the boundary rectangle at all. It tracks the **absolute position** of the
   core, which cannot create or destroy a poly-to-diffusion spacing violation.

2. **The violation set is bit-identical.** Dumped every error box from `drc listall why` for
   the seated and the unseated cell, added +40000 dbu to each unseated coordinate, and
   compared as multisets: **252 boxes both sides, 0 extra, 0 missing.** Same violations,
   same places, same multiplicities.

3. **KLayout agrees with the baseline, not with magic.** The signoff deck reports
   **84 PL.5a_LV + 84 PL.5b_LV before and after** - unchanged.

All 106 are the single known rule `PL.5a` (poly spacing to diffusion < 20), the device-internal
`vco_varactors` errors that are waived at signoff. Magic's per-cell attribution shifts
(`vco_varactors` 84, `vco_v1` 84, `chip_top` 84 -> **106**) when the parent frame moves; the
hierarchical *count* is frame-dependent, the *box set* is not.

**Consequence for T4 - use the box set, not the count.** `drc list count total` is not a safe
invariant across a frame change. The T4 magic-DRC baseline at the seated frame is:

> **chip_top seated, blocks only: magic total 106, 252 error boxes, all PL.5a in
> vco_varactors.** Every phase-8 haul is a delta against **that**, and a delta of zero must
> mean *the same 252 boxes*, not merely the same total.

The pre-seat figure of 84 stays valid only for the pre-seat frame; do not compare across.

### Not done here, deliberately
The GND ring still stops at the old core perimeter (die x157.5-689.5). Extending it west to
the DIEAREA edge for VSSA is **T3**, not T2. Pin labels are still at their block-tap
positions; relocating them onto the DEF pin fingers is also T3, and waits on the regenerated
DEF because VDDD and REF_IN move +100 um east.

---

## 5. Regression baseline (re-run 2026-08-21, five sessions)

`verify_cp` re-run 5th session, all exit 0 / RESULT PASS. This session touched only
`analysis/` scripts, `.waivers` for the throwaway reh cells, and docs — **route_lib.py was
NOT modified**, and no block layout/schematic/flow file was touched:

| cell | DRC | devices (LVS) | LVS |
|---|-----|---|-----|
| chip_top | 0 | 5 | match uniquely |
| PFD_lib | 0 | 7 (+18 fill/decap) | match uniquely |
| CP_v1 | 0 | 38 | match uniquely |
| ibias_gen_v1 | 0 | 228 | match uniquely |
| DIV2_QUAD_v1 | 0 | 149 | match uniquely |
| vco_v1 | 0 | 4 | match uniquely |

Known-good — the next session starts from here.

---

## 6. Housekeeping (2026-08-21)

Off-flow analysis/diagnostic scripts were moved out of `team_src/magic/` into
**`team_src/magic/analysis/`** (with a README) so nobody mistakes them for flow
scripts — they are NOT run by the tapeout flow:
- the **bailey_* LVS-flow reproduction** (evidence for the flat-GDS gencell finding,
  `docs/gf180-flat-gds-gencell-lvs.md`) — kept, not deleted;
- this session's **DEF/haul/placement parsers** (`parse_def.py`, `iq_haul.py`,
  `core_placement.py`) that produced §1–§3b.

**Phase-8 haul primitives** were added to `route_lib.py` (length-matched quad
router, def-pin lander, per-net length accounting) with a committed self-test —
built and DRC-gated in isolation, **not** wired into `chip_merge.py`/`route_chip.py`.
See `route_selftest` for the gate results.
