Zachnad0/AUS-NZ-Track-A-RFIC-Workspace/signoff/lvs/tech_patches/open_pdks_rm5_draft.md

# Draft: open_pdks issue + PR for the gf180mcu `rm5` cifinput rule

**Status: DRAFT, not posted.** Target: `fossi-foundation/open-pdks`, branch `main` (checked at
`55f1ea3`, 2026-11-02). The patch is `open_pdks_rm5_pr.diff` in this directory, a one-line
deletion that applies cleanly to that commit. Requested by Bailey in #143 (2026-11-03). The
"1.2 nH" is the lumped-model value: `L0` + `L1` = 0.60 nH each,
`team_src/xschem/vco_inductor_v2.subckt` lines 11 and 16.

---

## Issue

**Title:** gf180mcu magic tech: metal5 resistors (`rm5`) never extract from GDS (`rm5` requires `RESDEF`, which is never present)

In `gf180mcu/magic/gf180mcu.tech` the cifinput rule for the metal5 resistor is

```
#ifdef METALS5 || METALS6
 layer rm5 MET5
 and RESDEF
 and MET5RES
```

`MET5RES` is `calma MET5RES 110 15`. `RESDEF` is `calma RESDEF 110 *`, and on output it is written
only for `allres` (`layer RESDEF allres` / `calma 110 5`), which covers the poly and diffusion
resistors but not `rm1`–`rm5`. A metal5 resistor is written as MET5 + 110/15 only, so the rule
above cannot match magic's own output, and in our runs it never matches a GDS read either. The
metal under the 110/15 marker is removed from `m5` (`and-not MET5RES`) and does not become `rm5`,
so the resistor comes in as an **open**.

The PDK's KLayout LVS deck defines the top-metal resistor without `RES_MK`:
`tm_res = top_metal.and(top_metal_res)` (res_derivations.lvs:150), with
`metal5_res = get_polygons(110, 15)`.

How we found it: our Chipathon 2026 die (A01) has a 1.2 nH spiral on metal5 whose two halves
carry `Metal5_Res` (110/15) markers and should extract as two `tm11k`. With the stock tech the
organizer LVS (`d-m-bailey/extra_be_checks`, `chipathon2025` @ `7d1f5ef`, tech 1.0.558) never
produces those two `tm11k`:

| our GDS | stock tech | tech with `and RESDEF` removed from `rm5` |
|---|---|---|
| before an unrelated varactor fix | 14 vs 18 devices, failed pin matching | 15 vs 17 |
| current | **16 vs 18 devices**; the only missing devices are the 2 `tm11k` | **Circuits match uniquely** (chip 10/10 devices, 20/20 nets; VCO 8/8) |

(The "unrelated varactor fix" was the missing COMP under 3.3 V `nvaractor`, already fixed upstream
in PR #526 / `c0d31fc556`; our PDK copies predate it.) Full evidence:
https://github.com/Zachnad0/AUS-NZ-Track-A-RFIC-Workspace/blob/main/signoff/lvs/tech_patches/README.md
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
