Zachnad0/AUS-NZ-Track-A-RFIC-Workspace/docs/img/chip_top_white.png

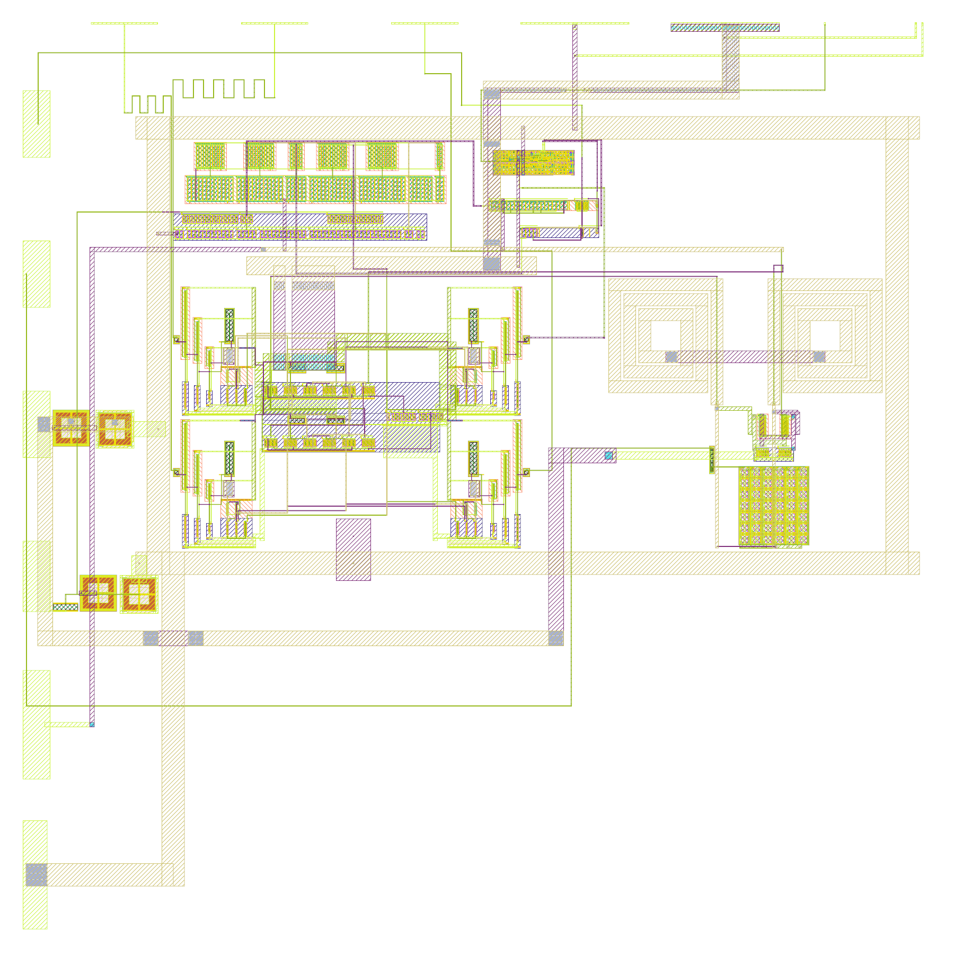
docs/img/chip_top_white.png
