Zachnad0/AUS-NZ-Track-A-RFIC-Workspace/docs/img/PFD_lib_black.png

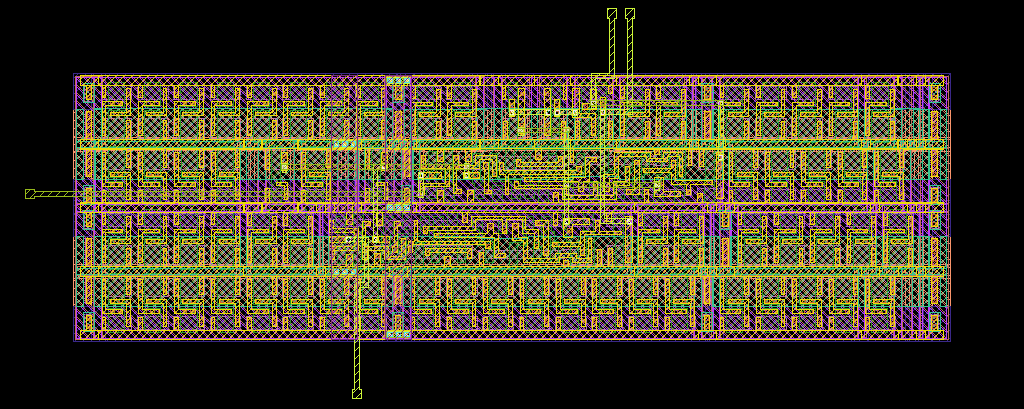
docs/img/PFD_lib_black.png
