Zachnad0/AUS-NZ-Track-A-RFIC-Workspace/docs/img/PFD_lib_white.png

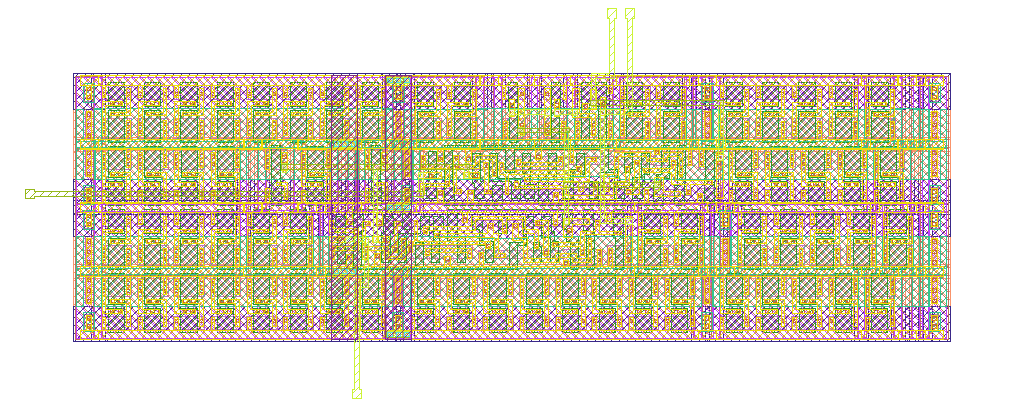
docs/img/PFD_lib_white.png
