Zachnad0/AUS-NZ-Track-A-RFIC-Workspace/docs/renders/CP_v1_black.png

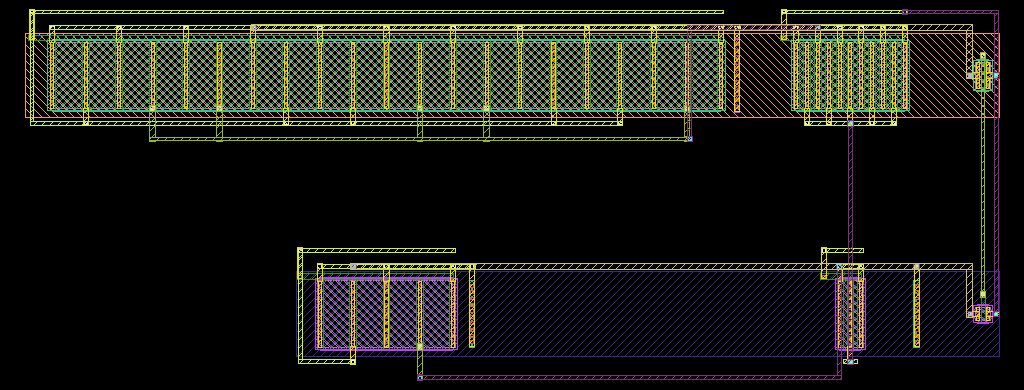
docs/renders/CP_v1_black.png
