Zachnad0/AUS-NZ-Track-A-RFIC-Workspace/docs/renders/CP_v1_white.png

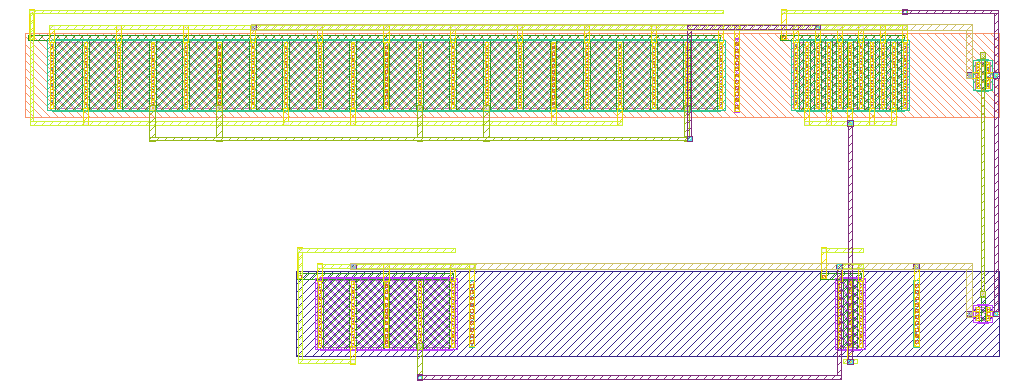
docs/renders/CP_v1_white.png
