Zachnad0/AUS-NZ-Track-A-RFIC-Workspace/docs/renders/ibias_gen_v1_black.png

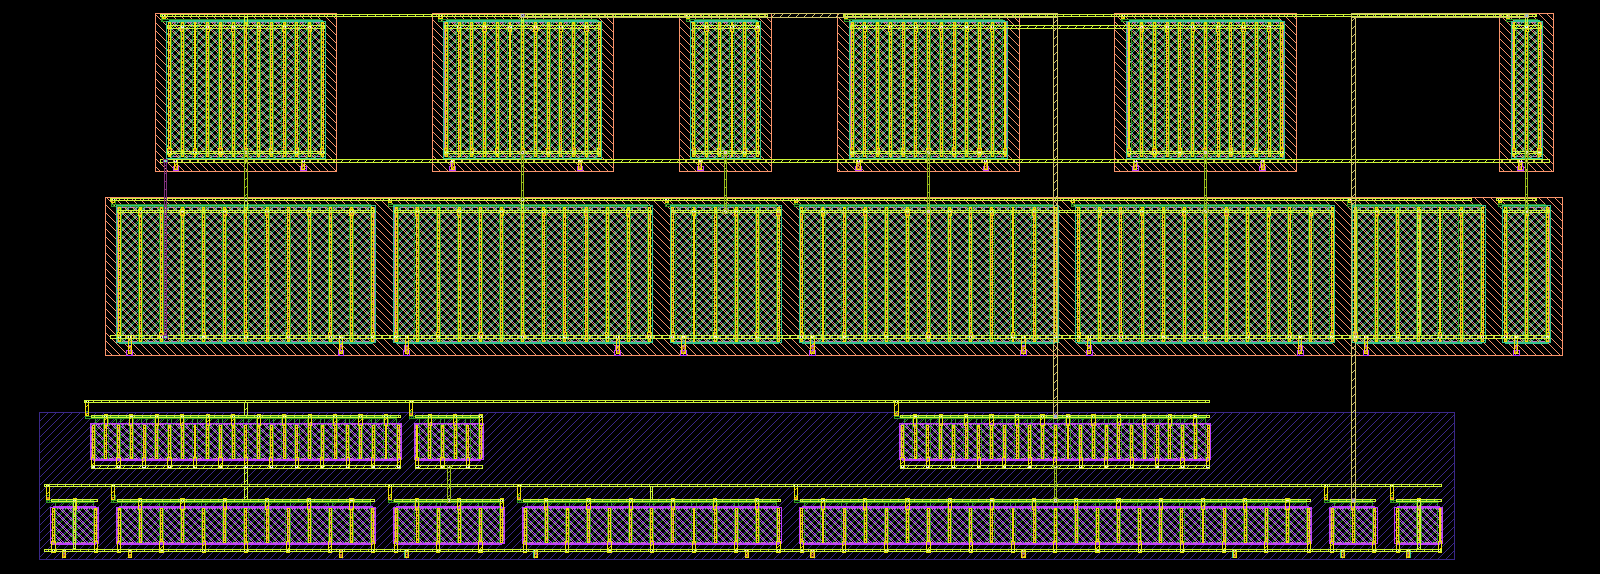
docs/renders/ibias_gen_v1_black.png
