Zachnad0/AUS-NZ-Track-A-RFIC-Workspace/docs/renders/ibias_gen_v1_white.png

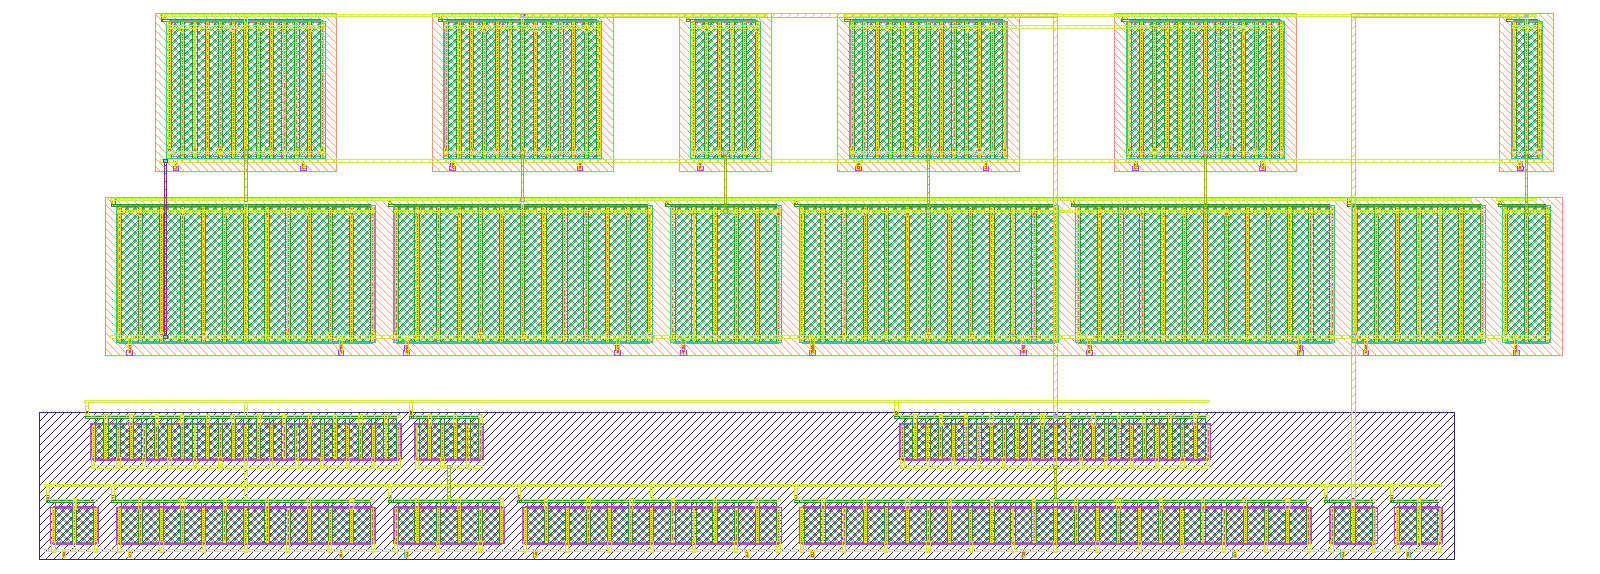
docs/renders/ibias_gen_v1_white.png
