Zachnad0/AUS-NZ-Track-A-RFIC-Workspace/docs/verification.md

# Verification Log — AUS/NZ Track A RFIC

**Team A01 · IEEE SSCS Chipathon 2026 · GF180MCU (gf180mcuD)**
Every simulated number lands here. Last updated: 2026-11-06.

---

## 1. Rail audit (Phase 3, step 15)

**Decision — project rail = 3.3 V for the entire design, analog and digital.**
Basis: all cells are built exclusively from `*_03v3` (3.3 V) devices; there is no
second voltage domain and no cell that requires a lower rail. The 1.8 V values
found in two digital testbenches are **outliers to correct**, not a rail choice.

### 1.1 Testbench-by-testbench

| Testbench | Supply | Stimulus amplitude | Other rail refs | Verdict |
|---|---|---|---|---|
| `CP_dc_tb` | V_VDD = **3.3** | UP/DOWN altered to 3.3; V_OUT swept 0–3.3 | `dc V_OUT 0 3.3` | ✅ 3.3 |
| `CP_tran_tb` | V_VDD = **3.3** | UP `PULSE(0 3.3 …)`, DOWN `PULSE(0 3.3 …)` | — | ✅ 3.3 |
| `NAND3_v1_tb` | VDD = **3.3** | VA/VB/VC `PULSE(0 3.3 …)` | — | ✅ 3.3 |
| `vco_tb` | V1 = **3.3** | V2 = 1.5 (**VTUNE control voltage**, not a rail); I0 = 1 mA bias | — | ✅ 3.3 |
| `inductor_tb` | V1 altered to **3.3** | (impedance/extraction) | `dc V1 0 3.3` (commented) | ✅ 3.3 |
| `vco_tank_tb` | none (AC) | `Iin0/Iin1 = 0 AC 0.5` | — | ▫️ AC-only, N/A |
| `vco_varactor_tb` | none (AC) | V1 = `0 AC 1` (C–V sweep) | — | ▫️ AC-only, N/A |
| **`PFD_tb`** | **V3 = 1.8** ⚠️ | V1 `PULSE(0 1.8 50n …)`, V2 `PULSE(0 1.8 150n …)` | `.ic v(net1)=1.8` | ❌ **1.8 → correct to 3.3** |
| **`D_FF_RST_v1_tb`** | **VDD = 1.8** ⚠️ | VCLK `PULSE(0 1.8 …)`, VRST `PULSE(0 1.8 …)` | — | ❌ **1.8 → correct to 3.3** |

### 1.2 Cell-by-cell

| Cell | Devices | Rail pins | Hardcoded rail? | Works at 3.3? |
|---|---|---|---|---|
| `CP_v1` | 4×nfet_03v3, 4×pfet_03v3 | VDD / VSS | none (comment: "GF180 3.3V") | ✅ native |
| `PFD_v1` | hierarchical | VDD / VSS | none | ✅ |
| `D_FF_RST_v1` | hierarchical | VDD / VSS | none | ✅ |
| `D_FF_v1` | hierarchical | VDD / VSS | none | ✅ |
| `NAND3_v1` | 3×nfet_03v3, 3×pfet_03v3 | VDD / VSS | none | ✅ |
| `NAND_v1` | 2×nfet_03v3, 2×pfet_03v3 | VDD / VSS | none | ✅ |
| `NOT_v1` | 1×nfet_03v3, 1×pfet_03v3 | VDD / VSS | none | ✅ |
| `vco_v1` | 2×nfet_03v3, 2×pfet_03v3, 2×cap_nmos_03v3_b (varactor), 1×ppolyf_u_1k (**corrected 2026-08-25** — this row said `ppolyf_u_3k`; `chip_top_golden.spice` line 186 is `XR2 … ppolyf_u_1k r_width=1u r_length=15u`, and no `ppolyf_u_3k` exists anywhere in the golden) | VDD (tail to GND) | none (1.7 pF = coupling caps, not a rail) | ✅ |

**No non-03v3 device exists anywhere in the design.** `CP_v1`'s 0.32–3.0 V output
compliance window is only meaningful at a 3.3 V rail, and `vco_tb` already runs
VDD = 3.3 V — both consistent with the decision.

### 1.3 Queued corrections (run when the container returns)

- Correct `PFD_tb.sch`: sources 1.8 → 3.3 V, and `.ic v(net1)=1.8` → 3.3.
- Correct `D_FF_RST_v1_tb.sch`: VDD and VCLK/VRST 1.8 → 3.3 V.
- Re-net­list and re-run both after correction; log deltas here.
- **Not edited yet** — deferred until after the issue-#143 edit verification, per
  instruction. Amplitudes will be changed only then, and never silently.

### 1.4 Symbol ↔ schematic pin mismatch (diagnosed; fix approved, pending container)

Detected via `xschem -n` (`Error: Symbol <cell>.sym has N pins, its schematic has
M pins`) and confirmed by direct port extraction (symbol `B …{name=…dir=…}` vs
schematic `ipin/opin/iopin` instances).

| Cell | Symbol pins | Schematic port instances | Redundant | Owner | Action |
|---|---|---|---|---|---|
| `PFD_v1` | 6 (VDD VSS REF FB UP DOWN) | 8 (VDD×2, VSS×2) | 1×VDD + 1×VSS | Greg | fix |
| `D_FF_RST_v1` | 7 (RST VDD D Q CLK **!Q** VSS) | 19 (VDD×7, VSS×7) | 6×VDD + 6×VSS | Greg | fix |
| `D_FF_v1` | ~~5~~ **6** | ~~6 (1 dup power)~~ **6** | ~~1 dup power~~ **NONE** | Zach | **CLAIM DISPROVEN 2026-08-05** — see note below |
| `NAND3_v1`, `NAND_v1`, `NOT_v1` | 6/5/4 | 6/5/4 | none | Zach | clean, no action |

**Root cause:** duplicate `VDD`/`VSS` `iopin` instances (one dropped per sub-cell).
All port **names are correct and complete** (incl. `!Q`); only power ports repeat.

**Severity:** non-fatal warning — netlists generate and `PFD_v1` verified at 1 MHz,
so xschem de-duplicates same-named power iopins when building the `.subckt`
pinlist. Sims tolerate it; the real risk is **Phase-4 LVS** (duplicate/ordered
ports trip `netgen` port-matching). This is a **clean-before-layout** item.

**Approved fix (`PFD_v1`, `D_FF_RST_v1` only):** convert each redundant power
`iopin` → `lab_pin` (same `lab=`), leaving exactly one `VDD` and one `VSS` `iopin`
per schematic. `lab_pin` keeps the net name at every stub, so VDD/VSS stay unified
by name — no fragmentation risk. No symbol edits, no other cells.

**Verification gate (per cell, when container returns):** after each edit,
re-netlist headlessly and (a) confirm the pin-count warning cleared; (b) diff the
generated netlist pre- vs post-edit — devices + connectivity must be identical
modulo port-list ordering/formatting. Any semantic delta → revert and stop.

**Sequencing:** fix lands + verifies **before** condition-4 results are recorded as
final evidence. Post-fix, re-run the original `PFD_tb` 1 MHz case as a regression
against the UP=101 ns / ~1 ns-reset baseline.

**RESOLVED (2026-07-31):** iopin→lab_pin conversion applied.

| Cell | Change | Gate (a) warning cleared | Gate (b) device netlist diff |
|---|---|---|---|
| `PFD_v1` | p15 (VDD), p16 (VSS) iopin→lab_pin; p3/p4 kept as ports | ✅ `6/8` error gone | ✅ x-instances **identical**; `*.iopin` 24→22 |
| `D_FF_RST_v1` | 6×VDD + 6×VSS iopin→lab_pin; p3/p6 kept as ports | ✅ `7/19` error gone | ✅ x-instances **identical**; `*.iopin` 20→8 |

`.subckt` port lists unchanged (`PFD_v1`: VDD UP REF VSS DOWN FB; `D_FF_RST_v1`:
RST VDD D Q CLK !Q VSS). `PFD_tb` + all 3 drafted tbs now netlist with **0**
pin-count errors. 1 MHz regression pending in §2.

*Cosmetic note:* `PFD_v1` already had coincident `lab_pin` VDD/VSS at the converted
iopin locations, so the conversion leaves duplicate (overlapping) lab_pins there —
harmless (same net name), left as-is within the approved convert scope; can be
de-duplicated later if desired. `D_FF_RST_v1` had no coincident labels, so the
conversion was essential to preserve the net names (delete would have fragmented
VDD/VSS).

---

## 2. PFD three-case verification (condition 4)

All at 3.3 V, 1 MHz, 100 ns REF↔FB offset; widths measured in a settled cycle
(TD = 2 µs) at the 1.65 V threshold. Post pin-fix (§1.4) and rail correction
(§1.3).

| Case | Phase | UP width | DOWN width | Interpretation |
|---|---|---:|---:|---|
| `PFD_tb` (corrected) | REF leads 100 ns | **100.5 ns** | 0.48 ns | net UP → pump up |
| `PFD_tb_lead` | REF leads 100 ns | **100.5 ns** | 0.48 ns | matches `PFD_tb` (cross-check) |
| `PFD_tb_lag` | FB leads 100 ns | 0.48 ns | **100.5 ns** | net DOWN → pump down |
| `PFD_tb_eqfreq` | aligned (0°) | 0.50 ns | 0.50 ns | UP = DOWN reset → locked, net-zero |

- **Phase-lead → wide UP, narrow DOWN; phase-lag → the mirror; equal-freq → equal
  narrow reset pulses.** Correct three-region PFD characteristic.
- The reset pulse is **~0.48–0.50 ns at 3.3 V** (vs ~0.98 ns at 1.8 V — faster
  logic at the higher rail), consistent across all cases.
- **1 MHz regression (pin-fix):** original 1.8 V `PFD_tb` post-fix → UP = 101.0 ns,
  reset = 0.98 ns = baseline. Pin fix is behavior-neutral (§1.4).

### 2.1 PFD + CP integration (static phase error → avg I_out; coincident UP+DOWN)

`PFD_CP_tb.sch` (new): `PFD_v1` UP/DOWN → `CP_v1` UP/DOWN; CP_OUT held at 1.65 V
(mid-compliance) by a sense source; i(V_meas) = CP output current. REF fixed at
300 ns delay, FB delay swept (φ = fbdel − 300 ns); avg current over the 3–4 µs
cycle, 3.3 V, 1 MHz.

| φ (ns) | avg I_out (µA) | φ (ns) | avg I_out (µA) |
|---:|---:|---:|---:|
| −200 | −9.97 | +20 | +1.15 |
| −100 | −4.93 | +50 | +2.66 |
| −50 | −2.42 | +100 | +5.17 |
| −20 | −0.91 | +200 | +10.19 |
| **0** | **+0.105** | | |

- **Linear transfer `I_avg = I_CP · φ/T`.** At φ = 200 ns: 50 µA × 200n/1µ = 10 µA
  vs measured 10.19 µA → confirms **I_CP = 50 µA** and a monotonic characteristic
  through zero. Detector gain ≈ 50 nA/ns.
- **Coincident UP+DOWN (φ=0, lock):** residual +0.105 µA = **~105 fC/cycle**,
  matching the known **+110 fC/cycle CP injection**. CP handles simultaneous
  UP+DOWN with only this small net current (no latch-up).
- **LOOP SIGN (KVCO < 0) — verified:** REF-lead (φ>0) → UP → CP **sources** →
  VTUNE **rises**. With KVCO < 0, VTUNE↑ ⇒ freq↓, but a slow VCO (REF leading)
  needs freq↑. So the direct UP→UP / DOWN→DOWN wiring drives **away** from lock —
  **the UP/DOWN→CP sense must be inverted** (swap UP/DOWN into the CP, or invert
  the VTUNE/loop-filter polarity). This empirically confirms the `scope.md` §2
  loop-sign constraint. **Documented only — no cell rewiring** (per ruling); the
  inversion is applied when the loop is closed.

### 2.2 Library-cell PFD (Aug-14 layout path, decided 2026-08-05)

For the Aug-14 layout the **digital chain moves to `gf180mcu_fd_sc_mcu7t5v0` std
cells** (see scope.md device-flavor note): 2× `dffrnq_1` (async active-low-reset DFF)
+ `nand2_1` coincidence, **same PFD topology as `PFD_v1`** (D tied high, reset =
NAND(UP,DOWN) → active-low RN). Re-sim at typical, 3.3 V, 2 MHz:

| Case | Library UP | Library DOWN | Custom PFD_v1 |
|---|---:|---:|---|
| REF leads | 100.5 ns | 0.49 ns | 100.5 / 0.48 |
| FB leads | 0.48 ns | 100.5 ns | 0.48 / 100.5 |
| Equal (raw) | 0.37 ns | 0.38 ns | 0.50 / 0.50 |

- **Async reset confirmed genuine** (`RN` gates latch transistors directly, not
  clocked); **D-high works** (Q→1 on clock, cleared by reset).
- Raw min pulse **0.37 ns** was **narrower** than custom (worse dead-zone floor) →
  **widened with 2× `inv_1` in the RSTN path → min pulse 0.50 ns** (matches/beats
  custom). Three regions re-confirmed with the delay.
- **Corner dead-zone margin:** min reset pulse at **fast digital (ff) = 0.39 ns**;
  CP switch-close at **slow analog (ss) ≈ 0.02 ns** (clamped output). min-pulse(ff) ≫
  CP-engagement → no dead zone at the worst corner split. Corner runs supported
  (`ff`/`ss`/`fs`/`sf`).
  - **CAVEAT — do not read 0.39 vs 0.02 as the true margin.** The CP "steering time"
    is methodology-dependent and the numbers are NOT the same measurement: **0.155 ns**
    (verification §2.1) is **typical corner, 10 pF-loaded**; **0.019 ns** is **ss
    corner, voltage-clamped switch-close** (pure device speed, no load). The
    **loaded** CP steering at the **ss** corner — the number that would pair
    apples-to-apples with min-pulse(ff) — was **never measured**. The qualitative
    conclusion (CP engages in tens of ps ≪ 0.39 ns pulse, and §2.1 shows linear-
    through-zero transfer) holds, but a rigorous loaded-ss steering figure is
    outstanding if tighter margin accounting is needed.
- Decks: `_cp_work/pfd_lib_*.spice`. **Gate PASSED (Greg, 2026-08-05).**

### 2.3 PFD_lib LAYOUT COMPLETE (LibreLane, 2026-08-05) — DRC + LVS clean

Library-cell PFD placed+routed by LibreLane (Classic flow); passes all four sign-off
gates. GDS: `librelane_pfd/runs/RUN_2026-08-05_23-52-38/final/gds/PFD_lib.gds`
(regenerable from `librelane_pfd/config.json` + `src/PFD_lib.v` + the golden).

| Gate | Result |
|---|---|
| DRC | **Magic 0, KLayout 0** |
| Reset inverters | **2× inv_1 in series on RSTN** (`NANDO→XI1→NDLY→XI2→RSTN`), preserved through full P&R |
| REF vs FB insertion delay | **REF ≈ 48 fs, FB ≈ 12 fs** (wire RC, both UNBUFFERED); ~36 fs mismatch — negligible vs the 0.5 ns pulse |
| netgen LVS vs golden | **Circuits match uniquely** (7 devices / 11 nets) |

Cell inventory = golden exactly: 2 dffrnq_1 + 1 nand2_1 + 2 inv_1 + 2 tieh; the rest
(endcap/fill/fillcap/filltie) is physical-only (LVS_IGNORE).

**LVS-relevant device count is 7 / 11 nets.** A flattened parasitic extraction reports
**190 transistors** — that is the fill-inflated count (every placer `fillcap`/`fill`/
`endcap`/`filltie` cell counted at device level). Do not quote 190 as a device count; it
reads as a 27× discrepancy against the golden.

#### 2.3.1 Independent DRC/LVS re-confirmation (`team_src/magic/verify_cp.sh`, 2026-08-10)
A standalone headless script (Magic DRC → LVS-netlist extract → netgen LVS vs
`PFD_lib_golden.spice`) reproduces sign-off on the committed `gds/PFD_lib.gds`:
**DRC 0, 7 devices / 6 ports / 11 nets, circuits match uniquely.** Two documented,
justified LVS waivers (rubric row 1 = "passes DRC+LVS with any waivers documented and
justified"):
- **Waiver 1 — fillcap decaps ignored** (18 instances: `fillcap_16`×6, `_32`×3, `_4`×5,
  `_8`×4 — matches the on-record inventory exactly). This is the **same waiver LibreLane's
  own proven run already applied via `LVS_IGNORE`**; the local netgen wrapper adds *only*
  the PDK-provided (but commented) fillcap `ignore class` and nothing else. `endcap`/`fill`/
  `filltie` are empty/tap-only and emit zero devices, so they need no ignore.
- **Waiver 2 — comparison method, not a violation.** The golden's std cells are resolved
  against the PDK `mcu7t5v0` spice so both circuits carry full definitions (a placed
  digital block otherwise LVSes def-vs-blackbox against a schematic golden). CP_v1's
  transistor-level golden will not need this path.

#### 2.3.2 Tapcell spacing corrected 20 → 15 µm (2026-08-10)
`librelane_pfd/config.json` carried no explicit `FP_TAPCELL_DIST`, so it inherited the
LibreLane default **20 µm** (confirmed in the run's resolved config, resolved.json). PFD_lib is 5 V/MV std cells;
GF180 **DF.13_MV/DF.14_MV cap tap-to-device at 15 µm** on `.overlapping(dualgate)` (20 µm
is the LV/3.3 V limit, which passed only incidentally on a small block). Set to an explicit
**15 µm** (commit `e3b6cae`). **No LibreLane re-run** — config-only correction for the next build.

#### 2.3.3 REF/FB parasitic symmetry (PEX, 2026-08-10) — layout-symmetry observation, no fix
Magic PEX on `gds/PFD_lib.gds` (`cthresh 0 rthresh 0`, all coupling caps retained):

| net | rail load | signal coupling | **total cap** |
|---|---|---|---|
| REF | 1.966 fF | 1.601 fF | **3.567 fF** |
| FB  | 1.303 fF | 1.074 fF | **2.377 fF** |
| RSTN (`X2.RN`) | 4.529 fF | 3.242 fF | **7.771 fF** |

REF carries **+1.190 fF (33%) more than FB**, consistent across both rail loading and
signal coupling. The one genuinely interesting line is **REF↔`X1_1.Z` = 0.360 fF —
logic-net crosstalk onto a clock input**, not just rail loading.

**Framed as fraction of the reference period, this is negligible.** At the 1 MHz reference
even a pessimistic ~5 ps skew from 1.2 fF is 5×10⁻⁶ of a cycle ≈ **0.002° static phase
offset** (~1% of the 0.5 ns minimum reset pulse). **And the driver impedances dominate
anyway:** REF is driven by a pad and FB by the CML divider, so their source-impedance
mismatch swamps a 1.2 fF load mismatch outright. This is **not** the `dlyb` trap (that was
hundreds of ps of inserted buffer delay); it is a layout-symmetry observation, no fix.

**Reconciliation with the STA number above.** The §2.3 table lists REF ≈ 48 fs / FB ≈ 12 fs
insertion delay — ~2 orders of magnitude smaller than the fF-implied skew. **Hypothesis
(not yet a finding):** the STA figure is **likely wire-RC only and excludes pin capacitance**,
whereas PEX includes the full node cap. **This explanation has not been tested** — we have no
STA run that adds pin cap to the path — so the two numbers are not yet reconciled, only plausibly
explained. Recorded here so a future reader does not treat them as a contradiction or as settled.

**FIRST-RUN TRAP — read this before repeating.** The FIRST LibreLane run silently
INSERTED 3× `dlyb_1` delay buffers: one on **FB→CLK (but NOT on REF)**, and two on the
UP/DOWN outputs. The FB-only buffer made the REF/FB insertion delay **asymmetric = a
static phase offset the locked PLL reads as real phase error.** A silent design change
that would have shipped a broken PFD. `--skip OpenROAD.CTS` alone did NOT prevent it.

**Config keys that fixed it** (`librelane_pfd/config.json`):
- `CLOCK_PORT: null` — no clock, so the resizer can't treat REF/FB asymmetrically
- `DESIGN_REPAIR_BUFFER_INPUT_PORTS` / `_OUTPUT_PORTS`: `false`
- `PL_RESIZER_BUFFER_INPUT_PORTS` / `_OUTPUT_PORTS`: `false` (deprecated aliases — set both)
- `RSZ_DONT_TOUCH_RX: "REF|FB"` — second-line defense
- `DESIGN_REPAIR_REMOVE_BUFFERS: false` — MUST stay false or it strips the reset inverters

**REJECT-THE-RUN RULE:** any future PFD_lib LibreLane run MUST be rejected unless
`final/nl/PFD_lib.nl.v` shows exactly **2× inv_1 in series on RSTN** and **no dlyb/buffer
on REF or FB**. Grep the netlist before trusting the GDS.

## 2.6 IBIAS generator — delivered CP/DIV2 bias (S1–S7, 2026-08-12)

`ibias_gen_v1` replaces the CP's two ideal 50 µA sources (`I_PREF`/`I_NREF`) and
the DIV2 tail reference with mirrored bias legs off one chip-level reference.
Reference is a **forced current** `I_BIAS = 240 µA` (isource, VDD-independent);
outputs VGP (CP PMOS-diode bias), VGN (CP NMOS-diode bias), IB_DIV2 (divider bias).
All numbers ngspice, TT/3.3 V/27 °C unless stated; decks in `team_src/sim/ibias/`.

**S1 — L uniform (committed).** Amendment-1's L=4 µm **CP output legs** (MN1 →
VGP sink, MP1 → VGN source — these bias the CP, *not* the DIV2 branch; they were the
5% systematic) retracted to uniform **L = 2 µm** on all mirrors (m=10→5 preserves the
**5/24 mirror ratio** to the MN0/MP0 reference: (W/L)·m = 10 vs 48); cascodes stay
L = 1 µm. Commit `bfbb497`.

**S2 — collapse holds (TT).** VGP **50.00 µA**, VGN **49.91 µA**, IB_DIV2 **239.56 µA**;
total VDDA **839 µA**. Matches the predicted collapse.

**S4 — gain / linearity / compliance.** Input sweep 120–360 µA: VGP gain 5/24,
linearity < 0.01 % (NMOS single mirror); VGN & IB_DIV2 share the added PMOS-mirror
stage → −0.18 % at nominal, ≤ −0.5 % at 1.5×. Output compliance (5 % window): VGP
0.247–3.30 V, VGN 0.0–3.053 V, IB_DIV2 0.0–3.053 V — **every branch envelops the
CP's measured 0.32–3.00 V** compliance window with margin.

**S4b — separate DIV2 cascode gate justified.** Injecting AC at IB_DIV2 and
measuring the current transfer to VGN: with the shipped **separate** cascode gate
(VBCPD) the transfer is 1.24e−6 @ 1 MHz / 3.61e−5 @ 1 GHz; with a **shared** PA gate
it is 2.35e−4 / 1.57e−3 — i.e. the separate gate buys **~45 dB (1 MHz) / ~33 dB
(1 GHz)** additional isolation of the divider bias node from the CP's VGN bias.

**S5 — CP UP/DOWN match with the generator substituted (the real deliverable, TT).**
Full CP (`CP_core`, 7-port, ideal sources removed) driven by the generator, DC-swept
CP_OUT. `CP_core` was verified **identical in port order, device set, connectivity and
sizing to the LVS reference `CP_v1_golden.spice`** — the sim-CP and the golden-CP are
the same circuit, so this characterizes what will be taped out. The generator adds a **uniform +0.18 %** to the CP source/sink mismatch across
the whole 0.4–2.8 V range — exactly the 50.00-vs-49.91 µA VGN deficit. The ±2 %
variation of mismatch vs CP_OUT is the CP's **intrinsic output-impedance mismatch,
present identically with ideal sources** (verified by running the ideal baseline in
the same environment: gen−ideal = +0.18 % at every point).

> **The 0.001 % figure was the CP topology's single-point zero-crossing with ideal,
> perfectly-equal sources — NOT the delivered circuit.** The delivered generator-driven
> figure is **~0.18 % at TT** at a fixed operating point.

**S6 — corners (process tracking only, NOT random mismatch).** VGP is corner-invariant
(50.00 µA, forced-current NMOS mirror). CP added-mismatch: **FF 0.004 %, TT 0.18 %,
SS 0.94 %** (the VGN/DIV2 PMOS-mirror path carries the spread). These are **systematic
process-tracking** numbers; **random device mismatch is not captured and requires
Monte Carlo** — a TT/corner figure must not be presented as the delivered match.

**PSRR (VDD 3.0–3.6 V, forced-current reference).** Because the reference is a forced
current (not a resistor to VDD, which would make I_ref track VDD and void the number):
VGP **0.003 %/V** (≈79 dB, cascoded NMOS mirror), VGN & IB_DIV2 **1.16 %/V** (≈28 dB,
PMOS-mirror path).

> **Two distinct mechanisms — do not conflate them.** The 0.18 % *static* mismatch is
> bounded to ~1 ps ≈ 0.0004° by the phase-offset argument above and is negligible.
> **Supply *ripple* on VGN is a separate, dynamic mechanism**: at 1.16 %/V it modulates
> I_CP within a cycle, injecting a reference spur — the static phase-offset bound does
> NOT cover it. This is not a Phase 2 reopen; it is a **Phase 5 layout requirement**:
> the `Vb_p` decap earns its place, and VDDA to the CP/IBIAS must be routed quiet and
> away from the digital block (see block-separation rules). VGP (0.003 %/V) is immune,
> so the exposure is VGN-specific.

**Context — is 0.18 % alarming? No.** A CP current mismatch ΔI/I produces a static
phase offset bounded by the reset-pulse balance: t_φ ≈ t_rst · (ΔI/I) ≈ 0.5 ns ·
0.002 ≈ **1 ps**, i.e. **≈ 0.0004–0.0007° at the MHz-class reference** — negligible.
Moreover the CP's known **+110 fC/cycle charge injection** (§2.1; ~105 fC measured at
φ=0) is the **likely dominant reference-spur mechanism**, not the 0.18 % static
mismatch. The generator does not meaningfully degrade the CP.

### 2.6.1 IBIAS LAYOUT COMPLETE (`ibias_gen_v1`, 2026-08-14) — DRC + LVS clean
Full-custom Magic layout of the 16-device generator, headless via a parameterized
generator (`team_src/magic/phase5/ib_block.tcl` + `ibias_gen_v1.tcl`). Four-row stack
(NMOS mirror/cascode in pwell, PMOS mirror/cascode in nwell; ~150×64 µm), wide W=16
m=24 legs split 2×nf=12 (200 µm model bin), inter-band routing by layer-per-net-class
(M2 S/D, M3 crossings, M4 cascode-VDD, M5 PA/VBCPD cross-band), end dummies on the 24:5
ratio array. Sign-off (`team_src/magic/verify_cp.sh ibias_gen_v1`, exit 0):

| Gate | Result |
|---|---|
| Magic DRC | **0** |
| KLayout DRC (variant D) | **0** |
| netgen LVS vs `ibias_gen_v1_golden.spice` | **228 fingers → 16 devices + m=4 end-dummy → match uniquely** |
| Ports | **6** (IBIAS VGP VGN IB_DIV2 VDD VSS), 0 port errors, 0 property errors |

Render: `docs/renders/ibias_gen_v1_{white,black}.png`. Both NMOS-side (`ib_nmos`, 112
fingers) and PMOS-side (`ib_pmos`, 116 fingers) also verify standalone.

**Golden ≠ schematic by one device — intentional, flagged here.** `ibias_gen_v1_golden.spice`
carries **17 device instances**: the 16 from `ibias_gen_v1.sch`/`.sym` **plus one layout-only
tied-off dummy** `XMDUM` (nfet W=4 L=2, m=4; gate→NB, source=drain=VSS). The dummy is the two
end-dummy fingers on the 24:5 mirror array, netgen-merged; it draws no current (Vds=0) and
changes no node's connectivity, but it must appear in the golden or LVS reports a device-count
mismatch. This is the standard "add end-dummies as tied-off instances" convention (same as
CP_v1 and `ib_nmos`), **not** a schematic error — the schematic stays at 16 devices and does
not need editing. Any future full-chip LVS that netlists `ibias_gen_v1.sch` directly must add
the same tied-off dummy, or waive the one-device count delta, to match the drawn layout.

## 3. VCO characterization (condition 5)

### 3.1 f–VTUNE sweep (measured) — establishes the frequency plan

`vco_tb` (Zach's tank + buffers), TT, 27 °C, VDD 3.3 V. Method: for each VTUNE,
`tran 5p 150n uic`; frequency = 10 rising zero-crossings of (out_p−out_n) measured
in the settled 100–150 ns window; Vpp = peak-to-peak of the buffered differential
output into 50 Ω over the same window.

| VTUNE (V) | VCO freq (GHz) | ÷2 output (GHz) | Vpp diff (V) |
|---:|---:|---:|---:|
| 0.0 | 6.367 | 3.18 | 0.553 |
| 0.4 | 6.324 | 3.16 | 0.549 |
| 0.8 | 6.247 | 3.12 | 0.543 |
| 1.2 | 5.669 | 2.83 | 0.526 |
| 1.6 | 5.442 | 2.72 | 0.524 |
| 2.0 | 5.235 | 2.62 | 0.522 |
| 2.4 | 4.919 | 2.46 | 0.518 |
| 2.8 | 4.527 | 2.26 | 0.502 |
| 3.3 | 4.114 | 2.06 | 0.457 |

- **Native band 4.11–6.37 GHz**; ÷2 output 2.06–3.18 GHz; ISM 2.4–2.5 GHz at
  VTUNE ≈ 2.05–2.28 V (mid-range).
- **KVCO ≈ −683 MHz/V** avg; −1.4 GHz/V steepest (0.8→1.2 V); −790 MHz/V near ISM.
  **Inverted tuning (KVCO < 0)** — drives the loop-sign constraint (`scope.md` §2).
- Drives Plan B (`scope.md` §3, FINAL).

> **SUPERSEDED (2026-08-12), see §3.2 GAP 1.** This 7/30 table's mid-curve is not
> reproducible on the same netlist (container proven stable). The band edges hold, but the
> corrected sweep gives a smooth curve with ISM at **VTUNE ≈ 1.95–2.12 V** and local KVCO
> **≈ −1.1 GHz/V** (not 2.05–2.28 V / −790 MHz/V). Use §3.2's numbers for Plan B.

**Portability bug — FIXED (2026-08-12).** `vco_inductor_v2.sym` hardcoded
`spice_sym_def=".include /foss/designs/xschem/vco_inductor_v2.subckt"` (a path that
does not exist in any clone). Changed to `$UPRJ_ROOT/team_src/xschem/…` (ngspice
expands `$UPRJ_ROOT`; portable across the 3 clones, matches the Phase 7.2 lvs
convention). Sims require `UPRJ_ROOT` set to the clone root.

### 3.2 VCO characterization (2026-08-12) — power/swing/startup/PVT measured; 2 gaps

> **⚠️ These VCO results predate the tank fix of 2026-09-18 (`6573181`) and need a tank-level
> re-extraction.** Until that commit both VCO outputs were routed into the *same* inductor
> terminal and the other terminal was unconnected: OUT_p and OUT_n were one node and the 1.2 nH
> coil was a floating stub. Every number in this section — band edges, swing, startup, PVT —
> was taken from a schematic-level or abstract-extracted netlist in which the tank was intact,
> so none of it describes the layout that was actually shipped. The layout now matches the
> intended topology, and the lead resistance is 2.333 Ω (OUT_p) / 1.733 Ω (OUT_n) with a 0.600 Ω
> imbalance, but **no re-simulation has been run against it**. Treat the band as unverified
> against layout until an extracted tank is simulated. Details:
> `layout-review-sep01.md`, §"The VCO tank was SHORTED — found and fixed 2026-09-18".

**Tank-level re-extraction, status 2026-09-18.** The extraction is done; the simulation is not.

| item | result |
|---|---|
| `vco_v1` R+C PEX on the corrected layout | **done** — 75 devices, 557 caps, 683 resistors, 2 s; `signoff/pex/vco_v1/README.md` |
| lead R, extracted (Laplacian solve) | OUT_p **0.845 Ω**, OUT_n **0.523 Ω**, imbalance **0.321 Ω** (geometric: 2.333 / 1.733 / 0.600). These are tank-node → `vco_core` **entry**, i.e. the `vco_v1.tcl` metal only; the full branch to the drain terminals is 4.742 / 6.530 Ω — see the correction below |
| varactors in the PEX netlist | **42** (2 × 21 `cap_nmos_03v3_b`), correct |
| schematic control, 80 ns at VTUNE 2.0 V | **not run** — measured 36.5 s per 5 ns, so 80 ns is **≈ 583 s (9.7 min)**, over the budget set for the attempt |
| extracted startup, 80 ns | **not run** — the deck aborts at the initial transient timepoint inside the `cap_nmos_03v3_b` model (42 behavioural instances against `method=gear` / `reltol=1e-5` / `bypass=0`); no timepoints, so no envelope |
| f0, swing, startup time, supply current | **measured 2026-09-18**, see below |

**Startup, golden control vs extracted (2026-09-18, `signoff/sim/vco/README.md`).** Bench
stimulus and options, DUT swapped for `vco_v1_golden.spice` (the netlist the layout is LVS'd
to), `tran 5p 40n uic` with a ±10 mV differential kick, VTUNE 2.0 V, measured 30–40 ns. No
solver option added.

| | record, this §3.2 @ 2.0 V | control (golden) | extracted |
|---|--:|--:|--:|
| f0 | 4.929 GHz | **4.859 GHz** (−1.42 %) | — does not oscillate |
| core differential swing | 4.09 Vpp | **4.211 Vpp** (+3.0 %) | **0.000 Vpp** |
| startup to 90 % | — | **6.211 ns** | not reached |
| supply current | — | **5.177 mA** | 4.197 mA (bias only) |
| amplitude drift 30–35 vs 35–40 ns | — | **0.071 %**, settled | — |
| runtime | — | 8 s | 21 s |

The control is settled and is the same circuit the layout implements. It is **not** a
reproduction of the sweep above — different DUT, different start, different window — so the
−1.42 % should not be read as a discrepancy in the record.

**The extracted netlist does not start.** The ±10 mV kick decays to zero within ~3 ns and never
recovers, while the core stays correctly biased (tail 1.273 mA), so it is damped rather than
broken.

**CORRECTION (2026-09-18, later run). The "≈ 3.8 Ω" figure published in `39138d3` is wrong,
and so is the varactor-tap diagnosis that followed from it.** Two errors in the Laplacian
solve: the output leads were taken as the *minimum* effective resistance over the branch's
metal sub-nodes rather than to the device terminals, and the 21 varactor units per side were
combined as `1/Σ(1/R)`. The units **share the tap wire**, so they do not parallelise — the
correct quantity is the effective resistance from the tank node to all of a branch's device
terminals shorted into one supernode. Redone that way on the same netlist
(`signoff/pex/vco_v1/vco_v1.pex.spice`, 683 R / 557 C, `extresist tolerance 10`):

| tank branch | series R |
|---|--:|
| lead, OUT_p → 30 `vco_core` drain terminals | **4.742 Ω** |
| lead, OUT_n → 30 `vco_core` drain terminals | **6.530 Ω** |
| varactor branch, OUT_p → 21 unit terminals | **3.550 Ω** |
| varactor branch, OUT_n → 21 unit terminals | **3.550 Ω** |
| coil (lumped model, two `tm11k`; not extracted) | 0.760 Ω |
| **tank loop total** | **19.131 Ω** |

That is **5× the published 3.8 Ω**, and its distribution moves the conclusion as well: only
**≈ 1.46 Ω** is metal that `phase5/vco_v1.tcl` draws (leads 0.845 + 0.523, varactor taps
0.046 each). **≈ 11 Ω is inside `vco_core` and ≈ 7 Ω inside `vco_varactors`** — neither of
which the tank fix touched. The two varactor taps are therefore *not* the cause; the
11.3–25.3 Ω per unit quoted in `39138d3` is `vco_varactors`' own internal M3 rail, not the
tap. There are two taps in `vco_v1.tcl`, not 42.

**Raising the tail current does not start it.** Bench nominal is `I0 GND vsg 1m` into a 1:1
NMOS mirror (`XM2`→`XM1`, both W=100u m=4), which delivers 1.404 mA at the VCO's ISS pin in
the golden control. Sweeping the reference, same deck, VTUNE 2.0 V, `tran 5p 40n uic`:

| ISS | tail current | supply current | differential swing | oscillates |
|---|--:|--:|--:|---|
| 1.0× (1 mA) | 1.273 mA | 4.197 mA | 0.000 Vpp | **no** |
| 1.5× | 1.755 mA | 5.746 mA | 0.000 Vpp | **no** |
| 2.0× | 2.208 mA | 7.198 mA | 0.000 Vpp | **no** |
| 3.0× | 3.062 mA | 9.928 mA | 0.000 Vpp | **no** |

The tail tracks the mirror exactly, so the current *is* reaching the core; the residual
amplitude is 1–2 × 10⁻⁸ Vpp, the solver floor. This is not current starvation.

**What does start it is a broad reduction in parasitic resistance, not any single net.**
Scaling *every* parasitic resistor in the extracted body by a common factor: **×0.3 does not
oscillate** (≈ 15 mV survives at 40 ns), **×0.2 does** (1.78 Vpp, 4.40 GHz), ×0.1 gives
3.00 Vpp. Scaling individual nets — the tank nets, GND, `cap_bias`, VDD, ISS — leaves it dead
in every case. So the shortfall is **cumulative across the cell and needs roughly 3–5× less
total parasitic R**, which no change confined to `vco_v1.tcl` can deliver.

Two further ISS points, for the record: **4.0× / 5.0× / 6.0×** also give 0.000 Vpp, at tails
of 3.870 / 4.642 / 5.376 mA and supply currents up to 17.4 mA. Across that range the bench
mirror compresses (delivered/requested falls from 0.97 to 0.90) and its drain falls from
0.698 V to 0.475 V, so there is no bench fallback at any tail current.

### The 4.5 Ω tank, built and measured (2026-09-18)

`extresist` was first calibrated on four structures of known resistance, because everything
above rests on it: a 100 µm × 1.0 µm metal3 wire reads **8.9105 Ω** against 9.000 by hand, the
same wire at 3.0 µm reads **2.9705** against 3.000, a **single** via3 cut between two 20 µm
leads reads **8.1005** against 8.100, and a **4×4 array** in the same leads reads **3.8542**
against 3.881. It is accurate to ≤ 1 % and it does model cut *count*, so the 19.131 Ω is real
geometry. (One artifact to know: for a net carrying more than one port, `ext2spice` writes the
whole R network once **per port** — a 3-port wire came out with each segment written three
times. `vco_v1`'s nets carry one port each and its resistors contain no duplicates.)

An independent hand model from GDS geometry — 90 mΩ/sq and 4.5 Ω/cut, fingers treated as
parallel branches off a shared bus and solved as a ladder — gives **3.482 / 4.716 Ω** for the
two core branches and **3.350 Ω** per varactor side, i.e. 0.72–0.94 × what `extresist` says;
the hand model reads low because it stops at the metal1/contact interface while `extresist`
runs to the device terminals. The dominant term in every branch is **single via cuts**, then
0.42 µm bus metal; the metal1 fingers contribute under 0.06 Ω.

Both cells were then rebuilt with 2.40 µm tank buses and 4×4 via arrays on the bus-level cuts
(plus a second via1 on each nfet drain finger). **All gates pass on all three cells** — magic
DRC 0, `verify_cp` 30/5/7, 42/3/4 and 4/6/11 all match uniquely, KLayout 168 waived on
`vco_v1`, every bbox and port label unchanged, `vco_tank_proof` PASS:

| tank branch | before | after | |
|---|--:|--:|--:|
| lead, OUT_p → 30 `vco_core` drain terminals | 4.742 Ω | **1.213 Ω** | 3.9× |
| lead, OUT_n → 30 `vco_core` drain terminals | 6.530 Ω | **1.325 Ω** | 4.9× |
| varactor branch, OUT_p → 21 unit terminals | 3.550 Ω | **0.669 Ω** | 5.3× |
| varactor branch, OUT_n → 21 unit terminals | 3.550 Ω | **0.669 Ω** | 5.3× |
| coil (lumped model) | 0.760 Ω | 0.760 Ω | — |
| **tank loop total** | **19.131 Ω** | **4.635 Ω** | **4.1×** |

Tank-node capacitance rises with it: OUT_p 250.9 → **272.3 fF**, OUT_n 246.4 → **266.4 fF**.
That is +20.7 fF per node, about 2.6× the +7.9 fF predicted from areacap-to-substrate alone —
the difference is overlap onto the metal1/metal2 nets underneath, which the areacap estimate
explicitly excluded. Referred across the differential it is ΔC ≈ +10.4 fF on a 869 fF tank,
so **Δf/f ≈ −0.6 %**, still negligible against a 4.05–6.38 GHz range.

**It still does not oscillate.** At VTUNE 2.0 V, `tran 5p 40n uic`, ±10 mV kick:

| ISS | tail | supply | swing | oscillates |
|---|--:|--:|--:|---|
| 1.0× | 1.273 mA | 4.197 mA | 0.000 Vpp | **no** |
| 1.5× | 1.755 mA | 5.746 mA | 0.000 Vpp | **no** |
| 2.0× | 2.452 mA | — | 0.000 Vpp by 5–7 ns | **no** (run aborted at 8.09 ns on a `cap_nmos_03v3_b` convergence failure, already decayed) |

Envelope at 1.0×, peak-to-peak per 2 ns: `1ns:0.04  3ns:0.00  5ns:0.00 … 39ns:0.00` — the same
shape as at 19 Ω. So a **4.2× reduction in tank loop resistance is not sufficient**, and the
earlier "×0.2 of all parasitic R oscillates" result does not transfer: that scaling also
reduced GND, `cap_bias`, VDD and ISS, which this change does not touch. The layout is built
and fully gated but **has not been landed**; only these measurements are recorded.

**One toolchain finding from the attempt, worth more than the numbers.** An intermediate
version of the widened `vco_varactors` shorted OUT_p to OUT_n: a 4×4 via2 array's metal3 pad
overlapped `vco_v1`'s OUT_n `via_m3m5` pad by 23 internal units. **Magic DRC reported 0** —
same-layer overlap is connectivity, not a spacing error — **and `verify_cp` on the GDS path
reported 4 devices / 6 ports / 11 nets, match uniquely**, because that flow flattens past it.
Only `verify_cp` on the **`.mag`** path caught it, as 5 ports / 10 nets, DO NOT MATCH. A cell
whose children changed must be LVS'd on both paths; the GDS path alone is not sufficient to
prove two tank nets are still distinct.

### 3.2.1 The extracted VCO oscillates — `cap_bias` was the binding term

The 4.5 Ω tank did not start, so every resistor in that extraction was classified by net and
each class scaled in turn, one run each, at ISS 1.0× / VTUNE 2.0 V / `tran 5p 40n uic`:

| class | count | Σ R | scaled ×0.1 alone → |
|---|--:|--:|---|
| GND/VSS (substrate, the varactor guard ties) | 219 | 1 259 928 Ω | dead, 0.000 Vpp |
| tank OUT_n | 408 | 4 617 Ω | — |
| tank OUT_p | 353 | 4 513 Ω | — |
| VDD | 30 | 452 Ω | dead, 0.000 Vpp |
| **`cap_bias`** | **84** | **292 Ω** | **OSCILLATES — 1.329 Vpp, 4.299 GHz** |
| ISS | 38 | 91 Ω | dead, 0.000 Vpp |
| TUNE | 1 | 7 Ω | — |

Control: all R ×0.2 oscillates at 2.659 Vpp / 4.459 GHz, so the deck matches the earlier test.
`cap_bias` ×0.5 and ×0.3 are dead (×0.3 leaves 0.6 mV); adding GND to `cap_bias` changes almost
nothing (1.372 vs 1.329 Vpp). There are no separate gate nets — in a complementary
cross-coupled pair the gates **are** the tank nets, which the classification confirms: every
resistor falls into one of the seven classes above.

**`cap_bias` is the smallest class by summed R and the only one that matters**, because it is
not a bypassed supply — it hangs off TUNE through a 1 kΩ `ppolyf` and acts as the varactor
bank's differential virtual ground. The resistance that lands in the tank is therefore
**bank-to-bank**: OUT_p's 21 `cap_bias` terminals to OUT_n's 21. Measured, that is **8.045 Ω —
more than the entire 4.523 Ω tank loop.**

Its geometry is the same pattern already fixed on the well side: six 0.38 µm metal2 gate
columns 51.4 µm long (12.2 Ω end-to-end) each hung off **one** via2 cut, feeding a 0.42 µm
metal3 rail 39.6 µm long (8.5 Ω end-to-end). Columns → 2.40 µm, rail → 2.40 µm grown **down**
(its top edge at y 10398 is held, inside the cell's bbox top of 10412), via2 → 4×4 arrays:

| | before | after | |
|---|--:|--:|--:|
| `cap_bias` bank-to-bank | 8.045 Ω | **1.765 Ω** | 4.6× |
| `cap_bias` drive, tune resistor → bank | 2.817 Ω | 0.617 Ω | 4.6× |
| tank loop | 4.523 Ω | **4.635 Ω** | +0.112 Ω, see §3.2.2 |

**The extracted VCO now starts.** At VTUNE 2.0 V, 200 ns, ±10 mV kick:

| ISS | tail | supply | swing | f0 | startup to 90 % | drift |
|---|--:|--:|--:|--:|--:|--:|
| 0.70× | 0.96 mA | 3.19 mA | 0.000 Vpp | — | **does not start** | — |
| 0.85× | 1.16 mA | 3.87 mA | 0.691 Vpp | 4.359 GHz | 123 ns | 0.26 % |
| **1.00×** | 1.35 mA | 4.52 mA | **0.975 Vpp** | **4.373 GHz** | 83 ns | 0.13 % |
| 1.50× | 1.89 mA | 6.28 mA | 1.633 Vpp | 4.367 GHz | 31 ns | 0.02 % |
| 2.00× | 2.38 mA | 7.91 mA | 2.207 Vpp | 4.402 GHz | 21 ns | 0.05 % |

**ISS margin: it starts at 0.85× and is dead at 0.70×**, so nominal carries ≥ 18 % margin at
VTUNE 2.0 V. Band with parasitics, against the schematic record:

| VTUNE | record | ISS 1.0× | ISS 2.0× |
|---|--:|--:|--:|
| 0.0 V | 6.378 GHz | **5.762 GHz** (−9.7 %), 1.969 Vpp | **5.728 GHz**, 3.038 Vpp |
| 2.0 V | 4.929 GHz | **4.373 GHz** (−11.3 %), 0.975 Vpp | **4.402 GHz**, 2.207 Vpp |
| 3.3 V | 4.047 GHz | **does not start** | **3.807 GHz** (−5.9 %), 1.026 Vpp |

The consistent 6–11 % downshift is what +20 fF per tank node of extracted capacitance predicts.
**Bring-up: set ISS to 2× the bench nominal** — `I0` 1 mA → 2 mA, tail ≈ 2.3 mA. At nominal the
top of the tuning range does not start (at 1.5× VTUNE 3.3 V peaks at 50 ns and then decays).

**This layout is landed** (`f0f0281`), after two chip-level shorts found by the organizer flow
and fixed — see §3.2.2. The final numbers, measured on the landed extraction, are the tables
above with the tank loop at **4.635 Ω**.

Band with parasitics, measured on the landed layout:

| VTUNE | schematic record | ISS 1.0× | ISS 2.0× |
|---|--:|--:|--:|
| 0.0 V | 6.378 GHz | 5.762 GHz (−9.7 %), 1.969 Vpp | 5.728 GHz, 3.038 Vpp |
| 2.0 V | 4.929 GHz | **4.372 GHz** (−11.3 %), **0.974 Vpp** | 4.402 GHz, 2.207 Vpp |
| 3.3 V | 4.047 GHz | **does not start** | 3.807 GHz (−5.9 %), 1.026 Vpp |

> **Bring-up: set the tail reference `I0` from 1 mA to 2 mA.** At nominal the VCO starts and
> settles at VTUNE 0.0 and 2.0 V, but the top of the tuning range does not (at 1.5× VTUNE 3.3 V
> peaks around 50 ns and then decays). At 2× the whole band runs, tail ≈ 2.3 mA. Allow **200 ns**
> before reading: startup to 90 % is 83 ns at nominal, against the schematic control's 6.2 ns.

### 3.2.2 Two chip-level shorts that only the organizer flow could see

Both were created by widening a bus **toward the block boundary**, and both were invisible to
every block-level and chip-level gate.

| | what it hit | symptom | fix |
|---|---|---|---|
| OUT_p metal3 right-gate riser, widened **west** to core x 403.745 | `route_chip.py`'s **vco.VDD metal3 column** at core x 404.750–405.250 | `run_full_lvs` **51** layout nets vs 53; OUT_p joins the nwell/VDD class | grow **east** instead (local x 2658..3138); core x 406.145–408.125 is empty on metal3, west edge clears VDD by 0.475 µm. **No R cost** — the riser carries gate current. |
| metal2 drain hauls, grown **down** to local y 148 = core y 64.07 | chip-level **metal2** under the VCO, topping out at core y 64.30 — a 0.23 µm overlap | **52** vs 53; OUT_p joins `vco_v1_0/ISS` | stop them at local y 380 (core 65.23), still covering the second via1 at local y 474, 0.93 µm clear. Costs **+0.112 Ω** on the tank loop. |

**Nothing local sees either one.** Magic DRC reports 0 — a same-layer overlap is connectivity,
not a spacing error. `verify_cp` passes on **both** the `.mag` and the GDS path at every level:
`vco_core` 30/5/7, `vco_varactors` 42/3/4, `vco_v1` 4/6/11, `chip_top` 10/11/25. KLayout is
exactly 168, the labels, bbox, metal2 corners and DEF pin landings are unchanged, and the XOR
is confined to `vco_v1`'s interior with 0.000 µm² outside. The merge exists only once
`vco_core` is flattened into `chip_top`, and `chip_top.mag` is a placement record with no
chip-level metal, so the chip `.mag` LVS is blind to it by construction.

They were located from the runner's own `.ext` files: `vco_core.ext` and `vco_v1.ext` were
byte-identical between the two runs, so the merge had to be in `chip_top.ext`, and diffing its
`merge` records against the committed chip named the joined nets directly.

After the fixes `run_full_lvs` reports **53 / 53 nets, 81 / 83 devices, 11 ports**, with a
`merge` list **byte-identical to the committed chip**. (The flow still ends in "Top level cell
failed pin matching" and the 81/83 device gap — both pre-existing, identical on the committed
chip, and explained above: a GDS-only read cannot reconstruct `cap_nmos_03v3_b`.)

**Toolchain invariant, now third of its family: run the organizer flow before landing any
change inside a block, not only when chip-level routing moves.** A block's buses can be widened
freely in the layers the block owns, but growth *toward its boundary* walks into chip-level
routing that no block-level gate models.

One thing the attempt established that matters beyond this block: **magic's extraction contains
no inductance.** `grep -c "^L"` on `vco_v1.pex.spice` and on the committed
`vco_inductor_v2.ext` both return 0 — R and C only, with the coil modelled as two `tm11k`
resistors. An extracted VCO tank therefore has no resonator unless the lumped model carrying
the L is spliced back in, which is what the deck does.

This does not establish that the fabricated VCO will not oscillate: the extracted deck is
pessimistic in at least two known ways (`rthresh 0` keeps every parasitic resistor with no
reduction; the lumped coil carries DC metal resistance only). The next step is **not** a
routing change in `vco_v1.tcl` — widening the two varactor taps 0.30 → 2.40 µm with 4×4 via
arrays was built and fully gated, and moved the extracted tank loop by **0.000 Ω** (19.131 →
19.131), so it was not landed. What is needed is either a resistance reduction inside
`vco_core` / `vco_varactors`, or evidence that `extresist` is overstating those two branches.

So every number in this section remains unverified against layout. The bench work, the measured
runtimes and a bench-vs-golden device delta (`ppolyf_u_3k` in `vco_tb.sch` against `ppolyf_u_1k`
in the golden and the layout) are recorded in `signoff/sim/vco/README.md`.

**A GDS-only read cannot see the varactors at all, and that is a techfile asymmetry, not our
layout.** The MOS-cap marker **MOS_CAP_MK = 166/5 is present** in `gds/vco_v1.gds` and
`gds/chip_top.gds`, drawn over the 42 units. But in `gf180mcuD.tech`, `cifoutput` writes 166/5
for *both* device families —

```
layer MOSCAP nvar,mvnvar,pvar,mvpvar,ncap,pcap,mvncap,mvpcap
calma 166 5
```

— while `cifinput` only ever reconstructs the **cap** types (`layer ncap DIFF … and MOSCAP`,
and the `pcap`/`mvncap`/`mvpcap` equivalents). **There is no `cifinput` rule that produces
`nvaractor` or `pvaractor` at all.** The two devices are then keyed on different types:

```
device subcircuit cap_nmos_03v3_b nvaractor *nndiff  l=c_length w=c_width
device subcircuit cap_nmos_03v3   ncap ndiff,ndc     l=c_length w=c_width
```

The write is many-to-one and the read is one-way, so a `cap_nmos_03v3_b` drawn in magic cannot
come back as itself from its own GDS. This is why the `.mag` flow extracts 42 varactors and a
GDS-only read extracts 0, and why the organizer-flow LVS shows `cap_nmos_03v3_b (42->2)` on the
source side only (`signoff/lvs/README.md`). No fix attempted; it is a PDK issue.
Current netlist (= `origin/main`, no diff), `vco_tb`, `.option method=gear`, at the
ISM operating point **VTUNE = 2.15 V**. `tran 5p 80n`, settled 60–80 ns. File-read.

| corner | VCO freq | ÷2 | core swing (se / diff) | total I (buf incl) | core I (ISS) |
|---|---|---|---|---|---|
| TT 27C  | 4.751 GHz | 2.375 | 2.03 / 4.04 Vpp | 5.04 mA (16.6 mW) | 1.38 mA (4.6 mW) |
| FF | 4.828 | 2.414 | 2.04 / 4.06 | 5.94 mA (19.6 mW) | 1.57 mA |
| SS | 4.640 | 2.320 | 2.01 / 4.00 | 4.37 mA (14.4 mW) | 1.24 mA |
| TT −40C | 4.740 | 2.370 | 2.19 / 4.36 | 5.26 mA | 1.36 mA |
| TT +85C | 4.764 | 2.382 | 1.88 / 3.75 | 4.92 mA | 1.40 mA |

- **Swing:** near rail-to-rail single-ended (~2 Vpp-se, core rides 1.27–3.30 V) at every
  corner — a strong oscillator, ample to drive the divider CML clock directly.
- **Startup:** self-starts; ~14 ns latency then builds 16→24 ns to full 4.04 Vpp diff
  (the 14 ns is op-point metastability breaking on numeric noise — thermal noise starts
  it faster in silicon). **Bench: allow ~30 ns before reading.**
- **Power:** VCO **core 1.2–1.6 mA (~4–5 mW)**; the 16.6 mW / 5 mA "VCO" budget figure is
  core **plus the TB output buffer** (source-followers + 1 mA bias). Budget line = 5 mA if
  an on-chip buffer like the TB's is used; core alone is ~1.4 mA.
- **Freq PVT** spread 4.64–4.83 GHz (process) / 4.74–4.76 (temp) at VTUNE 2.15 V — tight.

**GAP 1 — RESOLVED: §3.1's mid-curve was a measurement error; corrected sweep below.**
Container is stable (CP compliance reproduced, above), so §3.1 was NOT drift. Re-ran the
f-VTUNE sweep on the current netlist (core net1−net2, 80 n tran, settled 60–80 ns):

| VTUNE (V) | VCO (GHz) | ÷2 (GHz) | core diff (Vpp) | §3.1 said | Δ |
|---:|---:|---:|---:|---:|---:|
| 0.0 | 6.378 | 3.189 | 4.33 | 6.367 | +11 |
| 0.8 | 6.127 | 3.063 | 4.30 | 6.247 | −120 |
| 1.2 | 5.848 | 2.924 | 4.26 | 5.669 | +179 |
| 1.6 | 5.476 | 2.738 | 4.20 | 5.442 | +34 |
| 2.0 | 4.929 | 2.464 | 4.09 | 5.235 | −306 |
| 2.4 | 4.490 | 2.245 | 3.95 | 4.919 | −429 |
| 2.8 | 4.187 | 2.094 | 3.78 | 4.527 | −340 |
| 3.3 | 4.047 | 2.024 | 3.68 | 4.114 | −67 |

- **Band edges MATCH** §3.1 (mine 4.05–6.38 GHz vs 4.11–6.37) — the native band and Plan B's
  structure stand. The corrected curve is **smooth and monotonic** (a physical varactor C–V);
  §3.1's anomalous "steep 0.8→1.2 V / KVCO −1.4 GHz/V" region does **not** reproduce and was
  the error (likely mid-range settling/measurement artifacts at those points).
- **Corrected ISM mapping:** DIV2 2.4–2.5 GHz ⇒ VCO 4.8–5.0 GHz at **VTUNE ≈ 1.95–2.12 V**
  (§3.1 said 2.05–2.28 V — shifted **down ~0.15 V**). Avg KVCO −706 MHz/V (≈ §3.1's −683),
  but **local KVCO near ISM ≈ −1.1 GHz/V** (§3.1 said −790 MHz/V — steeper; matters for loop
  gain). **`scope.md` Plan B VTUNE window and the loop-filter KVCO should be updated to
  1.95–2.12 V / −1.1 GHz/V.** ISM stays comfortably mid-band — reachable — as predicted.

**GAP 2 — phase noise is NOT measurable with the open-source toolchain (closed).** ngspice
has no PSS or harmonic-balance engine for autonomous oscillators, so the only route is a
long transient + FFT. At 5 GHz that number is dominated by the simulator's numerical noise
floor and timestep jitter, NOT device (thermal/flicker) noise — it would be a figure one
would have to caveat into meaninglessness. Per Caglar's "phase noise if possible": the
honest answer to condition 5 is that it is not obtainable here; it needs a PSS-capable tool
(Spectre/ADS/AFS) at signoff. Output power/harmonics ARE measurable and stand as the
sanity baseline (Zach's tb): −1.55 dBm into 50 Ω, H3 −18.4 dBc.

**Container stability — CONFIRMED across 3 independent domains (no drift).** GAP 1 is a
§3.1 error, not drift:
1. **DC** — CP_v1 compliance reproduces **0.32–2.98 V / best 0.0011 % @ 1.50 V** vs the
   2026-07-22 record 0.32–3.00 V / 0.001 %.
2. **Analog transient** — the corrected VCO **band edges match** §3.1 (4.05–6.38 vs
   4.11–6.37 GHz); if models had drifted, oscillation frequency would have moved and it
   didn't (only §3.1's mid-curve, a measurement artifact, differs).
3. **Digital transient** — PFD_v1 **min reset pulse 0.500 ns** at equal REF/FB vs the
   0.48–0.50 ns record.
So the whole pre-7/30 evidence base (PFD dead-zone, CP steering, etc.) is safe. **Toolchain
fingerprint (record for future drift detection): ngspice-46 (KLU), open_pdks `7b70722e33c…`,
Ubuntu 24.04.4.**

### 3.2.3 Varactor COMP fix (2026-11-02), and an OPEN item: GDS-vs-`.mag` tank C

**The fix.** Every `vco_varactors.gds` before 2026-11-02 lacked COMP under the 42 varactor gates:
magic's stock tech does not write COMP for 3.3 V `nvaractor`. Fixed and gated; see
`layout-review-sep01.md` §2.5 and `signoff/lvs/tech_patches/README.md`. All VCO numbers in
§3.2–§3.2.2 came from the `.mag`, which has the varactors as devices, so they described the
intended circuit, not the GDS as it then was.

**VCO on the fixed GDS.** `vco_v1` re-extracted from the fixed GDS with the same R+C recipe as
`signoff/pex/vco_v1/`, keeping the coil as the magic abstract as that PEX does: 75 devices
(42 `cap_nmos_03v3_b`, 5u × 5u), 804 C / 1259 R, coil elements identical. Decks from
`signoff/sim/vco/mkdeck2.py` (which reproduces the committed `pex200.spice` byte for byte from
the committed PEX), `I0` 2 mA, 200 ns, ±10 mV kick, 2 threads:

| VTUNE | record (§3.2.1, ISS 2.0×) | fixed-GDS PEX | startup to 90 % |
|---|---|---|---|
| 0.0 V | 5.728 GHz, 3.038 Vpp | **5.7278 GHz, 3.0356 Vpp** | 13.0 ns |
| 2.0 V | 4.402 GHz, 2.207 Vpp | **4.4020 GHz, 2.2052 Vpp** | 20.3 ns |
| 3.3 V | 3.807 GHz, 1.026 Vpp | **3.8069 GHz, 1.0248 Vpp** | 22.7 ns |

All three settled (drift < 1 %). No band edge moves; `docs/test_plan.md` is unchanged.

**OPEN modeling item: tank C depends on how the varactor cell is extracted.** Same magic tech,
same R+C recipe, TT; parasitic C summed per net:

| extraction | OUT_p | OUT_n | cap_bias | note |
|---|---|---|---|---|
| `vco_varactors` alone, from `.mag` | 188.77 fF | 188.07 fF | 233.53 fF | well node `a_n36_n36#` |
| `vco_varactors` alone, from fixed GDS | 196.41 fF (+4.0 %) | 195.60 fF (+4.0 %) | 242.45 fF (+3.8 %) | well node `w_n60_n482#`, 467.5 → 478.9 fF (+2.4 %); same 272 C / 428 R topology, same 42 devices |
| `vco_v1`, `.mag` (the committed VCO PEX) | 216.03 fF | 211.22 fF | — | |
| `vco_v1`, fixed GDS, coil as abstract | 215.42 fF (−0.28 %) | 210.62 fF (−0.29 %) | — | the extraction the transients above used |
| `vco_v1`, fixed GDS, coil as raw geometry | 222.23 fF (+2.9 %) | 221.93 fF (+5.1 %) | — | stock reader: coil reads as an open (no `rm5`), its metal lands on the tank nets |

**Control:** `vco_core`, which the fix does not touch, extracts identically from `.mag` and GDS
(OUT_p 51.449 vs 51.446 fF, every net within 0.01 %, 238 C / 297 R both). So the extraction path
is exact when the geometry matches. The ±4 % is specific to the varactor cell **as an isolated
top cell**, and disappears in the `vco_v1` context the VCO PEX uses.

**Hypothesis, UNPROVEN:** the differently named and sized well node suggests the standalone GDS
carries a larger NWELL than the standalone `.mag` represents. Magic's gdsii cifoutput grows
wells around devices, and the GDS NWELL is identical before and after the COMP fix, so this would
predate it. Not tested: compare NWELL area from `gds read` vs `load` of the `.mag`, and the per-net
C with the well node merged. Until resolved, treat varactor-cell parasitic C as ±4 % depending on
extraction context. At ≈ 869 fF of tank C (VTUNE 2.0 V) that bounds the frequency effect at about
0.5 %.

### 4.0 Inductor `.mag` DRC — CLEAN in both tools (2026-08-14, file-read)
The spiral `vco_inductor_v2.mag` had never been shown DRC-clean (it gates 5.4). Checked
headless: **Magic DRC 0** (`drc euclidean on`, full check) and **KLayout DRC 0** — GDS
written from the `.mag`, `run_drc.py --variant=D` (5LM/11K, matches gf180mcuD) reports
"run is clean, GDS has no DRC violations" over 247 polygons. **Scope caveat:** this is the
base FEOL/BEOL deck; `--density` was **not** run, so the metal-fill/min-density question in
§4 item 3 (no automatic fill protection for the inductor) is still open and separate from
this clean base-rule result. The spiral is placeable as-is for 5.4; density/fill ownership
stays a Bailey question.

### 4.1b Inductor EM (6.2) — openEMS setup built + runs; solve deferred (2026-08-14)
`team_src/sim/ind_em/ind_em.py` (openEMS): parses the `.mag` (20 units/um), builds the
gf180mcuD metal4/via4/metal5/rm5 stack at the real z-heights (magic tech `height` lines:
m4 4.68-5.23, via4 5.23-5.83, m5 5.83-6.8325 um), places a differential lumped port across
the 30 um gap between the two metal5 leads (no ground plane -> Z11 = jwL+R of the coil),
meshes (edge-decimated to 1.5 um min), and post-processes Z11 -> L/Q/SRF vs the 1.2 nH
pi-model. **Verified: model builds, FDTD engine runs** (32k cells, dt 9.6e-16 s, ~3-6
MCells/s). **Solve DEFERRED under the 15 min/launch cap:** the low-freq Gaussian pulse needs
~297k timesteps and dt is capped by the 0.55 um metal4 thickness (a thin 3D z-cell) -> ~50
min full 3D solve. **Resume fix:** model metal4/metal5 as openEMS conducting sheets so the
z-mesh coarsens to ~1.5 um -> dt ~3e-15 s -> ~11 min solve; re-place the gap port on the
metal5 sheet plane; the post-processing runs unchanged. Not critical-path — Mohan (§4.1)
already confirms 1.2 nH; EM is a Q/SRF refinement.

## 4. Inductor / condition 6 — state + plan (2026-08-12, not yet run)

**The spiral IS drawn — not model-only.** `team_src/magic/vco_inductor_v2/vco_inductor_v2.mag`
is a real 3-turn dual square spiral (43 shapes on metal4/via4/metal5/rm5 + labels; params
D_in=20, D_out=76, N=3, W=8, S=2, Gap=30). BUT `team_src/xschem/vco_inductor_v2.subckt` is an
**analytical lumped π-model** (L0 0.60 n ×2 = 1.2 nH, metal R via `tm11k`, C) — hand-computed
from spiral formulas, **NOT extracted from the `.mag`**. This is the "preliminary model"; the
whole VCO band (§3.2, 4.05–6.38 GHz) rests on that 1.2 nH. **EM has never been run.**

**Revised order (the spiral being already isolated relaxes the Phase 5/6 coupling):** EM runs
on the existing `.mag` **independent of 5.4** — no need to draw it first. So: (1) Mohan
analytical cross-check of 1.2 nH; (2) openEMS/FastHenry on `vco_inductor_v2.mag` for real
L/Q/SRF/coupling; (3) if L disagrees, **PREFER accept-and-replan over redraw** — ISM sits
mid-band with margin, and chasing a target L costs Q/area for no functional gain; a 20–30 %
error does not put 2.4–2.5 GHz out of reach, so redraw ONLY if extracted L moves ISM outside
tuning range. 5.4's VCO layout just *places* this cell.

**Three items to settle BEFORE 5.4 (planned tonight, unresolved):**

1. **Inductor LVS — DECIDED (waiver, black-box the spiral).** Extraction of the drawn spiral
   metal yields distributed R/L, NOT the analytical π-model's lumped elements — netgen has
   nothing to match a spiral against a π-model, and this is unlike the transistor/std-cell cases.
   **Decision:** treat `vco_inductor_v2` as a **black box** in LVS and substitute the golden's
   π-model subckt for it, at BOTH the VCO block level and the RFIC top level. This is the third
   documented LVS waiver under rubric row 1 (alongside the two existing `__fillcap_[[:digit:]]+`
   decap ignores). **Waiver W3 (inductor black-box):** in the netgen setup, `ignore class` the
   spiral cell (regexp-restricted to `vco_inductor_v2` only, exactly as the fillcap ignores are
   scoped — NOT a blanket loosen), so netgen compares the rest of the VCO against the golden with
   the inductor represented by its π-model on both sides. Justification: the spiral is a passive
   with an EM-derived model; its terminal connectivity (PORT1/PORT2/GND) IS checked, only its
   internal distributed structure is black-boxed — standard practice for inductors/RF passives.
   Implement in `verify_cp.sh`'s local setup at the VCO/top stage (mirrors the fillcap block).
2. **Top-metal keep-out.** Spiral is on metal4/metal5/rm5; integration is organizer-scripted.
   **Confirm nothing is routed above the spiral** — overlying metal degrades Q and shifts L, and
   we do not control the organizer's router. Coordinate the keep-out with the organizer.
3. **Density vs Q — the sleeper (confirmed real in the gf180 deck).** Bailey requires min clear
   density; fill under/around a spiral degrades Q / shifts L. Checked
   `libs.tech/klayout/tech/drc`: an inductor marker **`IND_MK` (layer 151/5) exists but only
   `fill_comp.rb`/`fill_poly2.rb` honor it** (COMP/poly fill excluded within a 3 µm halo — protects
   substrate). **`fill_metal.rb` does NOT reference IND_MK** — metal fill only keeps 2 µm from
   existing metal, so it **WILL fill the spiral interior/surroundings (metal4/5), degrading Q**.
   `metalX_blk` (datatype 5) exempts a region from the density *requirement* but does **not** stop
   the fill script. So there is **no automatic metal-fill protection for the inductor** in this deck.
   **Fix — lead with owning the fill, not negotiating it:** **pre-fill our own block to density
   with a manual metal-fill keep-out around the spiral**, so the GDS we hand over is already
   density-compliant and the organizer's fill flow has nothing to add — this removes the dependency
   on a script we don't control and can't test against. `metalX_blk` over the inductor covers the
   residual density exemption; the waiver documents both. **Fallback if we do end up negotiating a
   keep-out:** ask only for the **inner opening + ~1 trace-width of surround** (where fill actually
   hurts Q — far-surround fill is nearly harmless); a narrow technically-justified ask gets granted,
   a whole-block one gets pushed back. **Open question for Bailey (Greg to ask — pairs with the
   stale #143 items):** on a team block, does the *team* run metal fill or the integration script?
   "integration is organizer-scripted" vs "your own project must pass min clear density" leaves fill
   ownership ambiguous, and the answer decides whether pre-filling works or is moot. Settle before
   final DRC.

### 4.1 Mohan analytical cross-check (2026-08-12, done — CONFIRMS 1.2 nH)
**Turn count read directly from `.mag` geometry (scale 20 units/µm — seg width 160 u = W=8 µm).**
The metal5 path is **TWO 3-turn square spirals side by side**, each D_out=76 µm (left half spans
x −2240..−720 = 1520 u = 76 µm), **30 µm apart (= the Gap param)**, connected **in series-aiding**
(differential, PORT1/PORT2 at bottom-center). Left half turns at x −2160/−1960/−1760 (pitch 200 u
= 10 µm = W+S) ⇒ **N=3 per half**, not one 6-turn concentric spiral. metal4 = a short underpass
bridge only.
**Earlier draft compared per-half Mohan against the TOTAL 1.2 nH — that was the error.** Correct
comparison, per half: Mohan current-sheet (square c1=1.27 c2=2.07 c3=0.18 c4=0.13, n=3, D_out=76,
D_in=20 ⇒ d_avg=48, ρ=0.583) = **0.49 nH**; π-model per half = 0.6 nH → **18 %, within Mohan's
~15–20 % accuracy**. Total = 2·L_half + 2M ≈ 2×0.49 + ~0.10 (halves 30 µm apart, weak k) ≈
**~1.08 nH vs the π-model's 1.2 nH — agree within ~10 %. The 1.2 nH is CONFIRMED analytically.**

**Consequence:** the Plan B band (4.05–6.38 GHz, measured on 1.2 nH) **stands**; ISM 2.4–2.5 GHz is
reachable as measured. **EM (6.2) is a Q / SRF / exact-L refinement, NOT a frequency critical-path.**
Per 6.3, if EM nudges L, prefer accept-and-replan (re-sim, move VTUNE, propagate) over redraw.

(6.2 stays PENDING until openEMS or FastHenry is installed — **queued for Greg**; runs on the
existing `.mag`, independent of the block layout.)

## 5. Notes — "For Zach" (Greg to relay; not edited here)

Two items in Zach's never-edit cells, left untouched:
1. **`D_FF_v1` — DUPLICATE-IOPIN CLAIM DISPROVEN (2026-08-05).** Zach asked us to
   delete the duplicate VDD/VSS iopins; on investigation **there are none.** The
   earlier "symbol 5 pins / schematic 6, 1 dup power" note was **incorrect** (likely
   confused with `D_FF_RST_v1`, which genuinely had 12 duplicate power iopins, since
   fixed §1.4). Verified on disk:
   - `D_FF_v1.sch` has **exactly one** `iopin lab=VDD` (p3) and **one** `iopin
     lab=VSS` (p6) — 6 ports total (CLK, D, VDD, Q, !Q, VSS). (The many `N …
     {lab=VDD/VSS}` lines are wire segments, not ports.)
   - `D_FF_v1.sym` has **6 pins** (VDD, D, Q, CLK, !Q, VSS) — matches the 6 schematic
     ports. Netlisting emits **no** symbol-vs-schematic pin-mismatch warning.
   - Identical across **all four origin branches** (main, integration, cp-wip,
     reset-dff-wip); the `.sch`/`.sym` were never modified since creation (`413a1db`).
   - `D_FF_v1` is **not instantiated by any cell** in the repo (PFD uses
     `D_FF_RST_v1`), so it affects no netlist/LVS regardless.
   **Do not "fix" this — deleting a VDD or VSS iopin would remove a required port.**
   If Zach still sees a duplicate, he is looking at a different/local copy; confirm
   which before any edit.
2. **`vco_v1`** — hardcoded include `/foss/designs/xschem/vco_inductor_v2.subckt`
   (portability bug: breaks netlisting in any clone not at that exact path). Should
   be a relative include or resolved via `XSCHEM_LIBRARY_PATH`.

## 6. LibreLane pipeline proof (Aug-6 sample-GDS backing) — PASS (to floorplan)

Ran the workshop-slot flow to floorplan (`--to OpenROAD.Floorplan`) in the
container (LibreLane **3.0.3**).

- **First attempt failed at PDK config load:** `TclError: no files matched glob
  "…/gf180mcuD/libs.ref/sg13g2_stdcell/techlef/*__nom.tlef"`. LibreLane 3.0.3
  injects `sg13g2_stdcell` (an **IHP** SCL) as the default instead of honoring the
  PDK's `STD_CELL_LIBRARY=gf180mcu_fd_sc_mcu7t5v0`. This is the 3.0.3-vs-pinned-
  3.0.0 drift the repo docs warn about.
- **Workaround (no pin, no install):** force `--scl gf180mcu_fd_sc_mcu7t5v0` on the
  CLI. Config load then cleared.
- **Result:** synthesis + floorplan complete, "Flow complete.", exit 0. Floorplan
  die 2935×2935 µm, core 442…2493 (matches the workshop slot). Benign warnings
  only. **The pipeline runs end-to-end at 3.0.3 with the `--scl` override.** Full
  signoff (Run A) uses the same override.

## 7. Divide-by-2 divider feasibility (DIV2, condition 1 minimum scope)

**Static CMOS cannot divide the VCO — a high-speed first stage is mandatory.**

Probe `DIV2_toggle_probe_tb.sch`: `D_FF_RST_v1` as a toggle FF (D tied to !Q),
reset to break latch symmetry, CLK swept. TT, 27 °C, 3.3 V.

| CLK | QOUT Vpp | ÷2? |
|---:|---:|---|
| 1.00 GHz | 3.68 V | ✅ clean (QOUT = 500 MHz) |
| 2.00 GHz | 0.61 V | ✗ not reaching logic levels |
| 3.00–6.37 GHz | < 2 mV | ✗ dead |

- **Static-CMOS max clean ÷2 ≈ 1–1.5 GHz**, dead by 3 GHz.
- **VCO native band is 4.11–6.37 GHz** (§3) — static CMOS can't handle even the
  *slowest* VCO frequency, let alone the 6.37 GHz worst case.
- **First divider stage must be CML or TSPC.** CML (differential current-steering)
  takes the differential VCO clock directly, reaches 6.37 GHz easily in 180 nm, and
  gives quadrature I/Q naturally — but burns static bias current and is larger.
  TSPC (dynamic, single clock) is lighter but marginal at 6.37 GHz in 180 nm. Static
  CMOS (`D_FF_v1`-style) is viable only for later ÷2 stages once ≤ ~1 GHz.

**Decision: CML** (Greg). Single CML ÷2 = two NMOS CML D-latches in a master-slave
ring, master clocked by VCO `out_p`/`out_n`, slave on the complement; one loop
inversion (slave outputs cross-fed to master inputs) → ÷2 with **quadrature I/Q**
at VCO/2 (2.06–3.18 GHz). Device-level (per latch): track pair + cross-coupled
latch pair + clock-steering pair (6× nfet_03v3, W≈10 µm/L=0.3 µm), 2× load R
(≈2 kΩ for ~400 mV single-ended swing at 200 µA tail), tail current source.
Two latches + a CMOS-level output buffer (CML ~400 mV → rail). Bias explicit:
external `IBIAS_CP`-style reference sets the tail current (documented, `pins.md`).

**Power cost (vs static-CMOS elimination above):** CML draws **continuous** bias —
2 latches × 200 µA tail ≈ **0.4 mA → ~1.3 mW static** at 3.3 V (before the output
buffer), against **~0 static** for the (unusable) static-CMOS divider. This is the
price of reaching the 4.11–6.37 GHz band; it is the divider's dominant power term.

**Build + bring-up (in progress).** Flat probe `DIV2_CML_probe_tb.sch` (12×
nfet_03v3 CML ÷2, ideal tails, R loads, differential clock) — generated
programmatically, netlist-clean, zero auto-nets.

Sizing progression (W=40 µm nfet_03v3, differential clock, ideal tails):

| tail / R | 1 GHz | 3 GHz | 5 GHz | 6.37 GHz | swing |
|---|---|---|---|---|---|
| 400 µA / 2 kΩ | ✅ ÷2 | ✗ | ✗ | ✗ | 1.6 V |
| 1.2 mA / 500 Ω | — | — | ✅ ÷2 | ✗ (~2 GHz) | 0.44 V |
| **2.4 mA / 300 Ω** | — | — | ✅ ÷2 | ✅ **÷2** | 0.83–1.4 V |

**Full-band ÷2 + quadrature CONFIRMED** (final sizing, tail 2.4 mA / R 300 Ω):

| VCO in | ÷2 out (meas) | quadrature phase(I→Q) |
|---:|---:|---:|
| 4.11 GHz | 2.058 GHz | −90.4° |
| 5.00 GHz | 2.500 GHz | −90.0° |
| 6.37 GHz | 3.185 GHz | −90.0° |

- Clean ÷2 across the **entire 4.11–6.37 GHz native band**; consistent **−90°
  quadrature** (Q leads I) at all three points. Differential swing 0.83–1.4 V.
- **Final power (honest):** two tails × 2.4 mA = **4.8 mA → ~16 mW static** at 3.3 V
  (before output buffers), vs ~8 mW at the 5 GHz-only checkpoint and ~0 for the
  eliminated static-CMOS divider. **Reaching the 6.37 GHz band top doubled the
  current** — the dominant divider power term and the price of the CML choice.

**Remaining:** CMOS-level output buffers (4×, for I_P/I_N/Q_P/Q_N); replace ideal
tails with a real bias mirror (`IBIAS`); package into `DIV2_QUAD_v1.sch/.sym`
(cell + symbol). Can wait for the next session / Run-A window (with condition-5 VCO
characterization + condition-6 inductor re-extraction).

**Bias mirror sizing (decided 2026-08-04):** external reference **240 µA** into a
diode-connected NMOS at the bias pad sets `VBIAS`; each tail device mirrors **10:1**
→ **2.4 mA per tail**. Two tails → **4.8 mA total CML core current** (240 µA × 10 ×
2 = 4.8 mA). This replaces the two ideal 2.4 mA sources in `DIV2_CML_probe_tb`.
Output-buffer topology: CML→CMOS rail-to-rail (PMOS-input diff converter, since the
CML common mode sits near VDD, + CMOS inverter). **Buffer supply current vs the
off-chip 50 Ω load is under review — see the load-model note; a rail-to-rail buffer
into a DC/AC-coupled 50 Ω exceeds a single VDDA pad's ~50 mA budget, so the output
stage is not finalized.**

**Decision (Greg):** CML chosen.

**Along the way:** `D_FF_v1` (no reset) can't self-start a toggle FF from the
symmetric latch state (needs a symmetry-break); use `D_FF_RST_v1`. `D_FF_RST_v1`
**RST is active-low**.

### 7.1 Output converter — reworked to 3 stages, STILL NON-WORKING (2026-08-10)

Full analysis in `docs/div2-debug.md` (2026-08-10 section). Summary:

- **CML core is unaffected and still divides** — OI−OIB = **±0.557 V steady** at 16–20 ns.
  The `move-b` fix (CML-input pair 16 µm → 8 µm) recovered the differential from the
  Miller-collapsed ±0.13–0.20 V to full ±0.557 V, and it **holds in steady state**.
- **The CML→CMOS output converter still does not work.** Rebuilt as a 3-stage chain
  (skewed trip-setter → restoring inverter → driver). At 6–10 ns it looked rail-to-rail
  (I_P 142 mVpp); measured to **16–20 ns it collapses to 21 mVpp** — the earlier result
  was a decaying transient during bias settling.
- **Root cause is a class:** every converter fault so far is an *absolute threshold match
  between two independently-moving nodes* (PMOS input vs |Vth|; inverter trip vs OC;
  stage-1 midpoint vs stage-2 trip). Resizing fixes one instance and exposes the next.
  **Aug-21 rework removes threshold matching by construction** (self-biased inverter with
  AC-coupled input, or a differential OC/OCB converter), rather than chasing another trip.
- **Output monitor load relocked 450 Ω → 1 kΩ series isolation R** (supersedes the
  "under review" note above and the old 450 Ω ruling). 1 kΩ gives ~124–157 mVpp (−12 dBm)
  at the 50 Ω instrument — ample for a monitor pad — with a moderate 3-stage driver at
  **~12.6 mA peak / ~6.3 mA avg per** the four buffers, comfortably inside the ~50 mA VDDA
  budget (core ~8.7 mA). This **subsumes the earlier output-buffer supply concern**.
- **Toolchain note (portable):** under `uic`, bias nodes start at 0 and a chain with a DC
  operating point needs **>10 ns to settle** — run 20 ns, measure 16–20 ns. The old
  "settles by 2–6 ns" applies to the CML core only. `min/max/avg` hid this collapse; it was
  caught only by dumping the waveform.

DIV2 remains **CUT from the Aug-14 scope**; this is an Aug-21 item.

---

## 8. Chip-level DRC baseline (phase 8) — compare BOX SETS, not totals

### 8.1 The rule
**magic's `drc list count total` is frame-dependent and is NOT a valid gate across a frame
change.** Seating `chip_top` inside the A01_BH DIEAREA on 2026-08-22 was a pure +200/+200
translation — no geometry created, moved relative to anything, or deleted — yet the reported
total went **84 → 106**. The violations themselves were bit-identical: **252 boxes on both
sides, 0 added, 0 removed**, one rule (`PL.5a`, poly spacing to diffusion < 20). Magic
re-attributes errors per cell when the parent frame moves.

Proven three ways, not assumed:
1. Three throwaway variants of the seated GDS through the same deck — 0/0 boundary layer
   deleted → still 106; boundary restored at the old core extent → still 106; core
   translated back −200/−200 → **84**. It tracks absolute position, not the boundary.
2. Box-set multiset comparison after normalising the shift → **0 added, 0 removed**.
3. KLayout, the actual signoff deck, reports **84 PL.5a_LV + 84 PL.5b_LV before and after** —
   unchanged.

> **A phase-8 "zero added violations" gate must compare the box set. A gate comparing totals
> would have read this as 22 new violations and sent someone hunting a bug that does not
> exist.**

### 8.2 The committed baseline

> **RE-CAPTURED 2026-11-02: TOTAL 0, 0 boxes** (GDSBLOB `579dd24`, SRCCOMMIT `057251a`). The
> 252 boxes below were all PL.5a markers of the missing varactor COMP (§3.2.3 here; `layout-review-sep01.md` §2.5),
> not gencell artifacts. The history below describes the pre-fix baseline.

`team_src/magic/chip_top.drcbase` — the seated `chip_top` box set. Re-captured 2026-08-25
(see §8.5); the 252 `B` lines are **byte-identical** to the 2026-08-22 capture.

#### The three figures are three different things — do not conflate them

This is the single most important thing in §8. The same geometry yields three numbers:

| figure | value | what it actually is | invariant? |
|---|---|---|---|
| **emitted boxes** | **252** | **maximal horizontal strips** of DRC error paint, one per `B` line. This is what the dump contains and what the gate compares. | **YES** — across hierarchy level, frame, and every layout edit to date |
| **connected regions** | **84** | the **physical violation count**, obtained by merging the 252 strips (252 = 84 × 3). Cross-confirmed independently by KLayout's waiver population: **84 PL.5a_LV**. | **YES** |
| `TOTAL` | 84 or 108 | magic's **frame-dependent re-tiling** of the same paint. Reads **84** from `vco_varactors` or `vco_v1` and **108** from `chip_top` — same GDS, same run. | **NO — never gate on it** |

Measured 2026-08-25, one invocation, three `CELL` values against the identical GDS:

```
CELL=chip_top         TOTAL=108   boxes=252   merged_regions=84
CELL=vco_v1           TOTAL=84    boxes=252   merged_regions=84
CELL=vco_varactors    TOTAL=84    boxes=252   merged_regions=84
```

`TOTAL` is emitted for reporting only. It is neither the strip count nor the region count, and
it changes with the cell you view from. **The box set is the gate.**

#### The current baseline

| field | value |
|---|---|
| `GDSBLOB` | `a79e48d2929613f4b41827316aa9a234a526183b` |
| `SRCCOMMIT` | `f31d5941ddc9bd6db3a2de29b467697de39df526` |
| violation boxes | **252** (= 84 regions × 3 strips) |
| rules | 1 — `Poly spacing to diffusion < 20 (PL.5a)` |
| `TOTAL` | 108 — *reporting only, not a gate* |
| per-cell attribution | `vco_v1` 84, `vco_varactors` 84, `chip_top` 108 |
| `SELFCHECK` | `OK rules=1/1 boxes=252/252` |
| frame | seated (die frame, boundary 0,0–1110,550; BH die, see §8.13 for the D block) |

Historical: the pre-seat core-frame run reported `TOTAL` **84** with the same 252 boxes. Never
compare a pre-seat total against a seated one.

All 252 are the device-internal `nmoscap_3p3` errors inside `vco_varactors` — the same
population as the **W4** KLayout waiver (168 = 84 PL.5a_LV + 84 PL.5b_LV).

#### THE INVARIANCE RESULT — preserved here because the re-capture would otherwise erase it

The 2026-08-22 baseline was dumped from `gds/chip_top.gds` blob `a774ef36` at commit `94f2822`.
Between that commit and `f31d594`, **five commits modified `gds/chip_top.gds`** — the entire
phase-8 routing build:

`3707129` (I/Q quad) → `585c408` (VSSA, VTUNE, VDDA, IBIAS, ISS) → `019c3a8` (VSSD, VDDD,
REF_IN, PU/PD) → `d7c510d` (CP_OUT) → `f31d594` (ground-port label datatype).

Dumping the `94f2822` GDS and the `f31d594` GDS through the **same** invocation and comparing:

```
baseline (94f2822 gds a774ef36): TOTAL=106  boxes=252
candidate (f31d594 gds a79e48d2): TOTAL=108  boxes=252
ADDED   (in candidate, not in baseline): 0
REMOVED (in baseline, not in candidate): 0
```

**The 252-box multiset has been invariant across the whole phase-8 routing build.** Every haul,
every via stack, every landing bar added zero DRC violation boxes. That is a real result about
the layout, not a property of the baseline file, and it is recorded here because a re-captured
baseline can no longer demonstrate it — the old dump was the only artifact that still held the
`94f2822` state.

`TOTAL` moved 106 → 108 across those same commits. It is the *only* figure that moved, and it
moved for the reason in the table above: added top-level metal changes how magic re-tiles the
error paint at `chip_top`, while the errors themselves — all of them inside `vco_varactors` —
never changed.

#### Provenance rule

**A `.drcbase` is only meaningful against the GDS it was dumped from.** The 106 → 108 above was
invisible for three days precisely because nothing recorded which layout the baseline came from;
the only symptom was a `TOTAL` that no one reads, in a file whose whole point is that `TOTAL` is
not the gate. Since 2026-08-25 every dump carries `GDSF`, `GDSBLOB` and `SRCCOMMIT` in its
header, and `drc_delta.py` reports a `GDSBLOB` mismatch **loudly** instead of leaving it to
surface as a total. A dump with no provenance header predates the format and is reported as
such.

### 8.3 The tools
- **`team_src/magic/analysis/drc_boxset.tcl`** — env `GDSF` (required), `CELL` (default
  `chip_top`). Emits a `GDSF`/`GDSBLOB`/`SRCCOMMIT` provenance header, then `TOTAL`,
  `CELLCOUNT <cell> <n>`, `RULE <n> <text>`, one `B x0 y0 x1 y1` per violation box in magic
  internal units (1 iu = 1 GDS dbu = 0.005 µm), and finally `SELFCHECK OK|FAIL`.
  **`SELFCHECK` asserts the dump is COMPLETE**: an independent `foreach {why boxes}` traversal
  counts every pair `drc listall why` returned, and the emit loop must match it on both pair
  count and box count. A mismatch prints a FATAL banner to stderr and **exits 1**. The check is
  deliberately not accumulated by the emit loop itself, which would be circular and would miss
  a truncated walk — the exact defect `reh_drc.tcl` shipped. Failure path verified by
  injecting a one-box truncation: `rc=1`, `SELFCHECK FAIL rules=1/1 boxes=251/252`.

  **Exact capture command** (in-container; the invocation the committed baseline was produced
  with, recorded so future runs compare like-for-like):

  ```
  GDSF=/foss/designs/AUS-NZ-integration/gds/chip_top.gds CELL=chip_top   magic -dnull -noconsole     -rcfile /foss/pdks/gf180mcuD/libs.tech/magic/gf180mcuD.magicrc     team_src/magic/analysis/drc_boxset.tcl > raw 2> err
  grep -E "^(GDSF|GDSBLOB|SRCCOMMIT|TOTAL|CELLCOUNT|RULE|B|SELFCHECK) " raw > chip_top.drcbase
  ```

  The `grep` strips magic's startup banner; the baseline holds record lines only. Note the bare
  `-rcfile` — no `$PDK` environment is needed for DRC, only the tech file.
- **`team_src/magic/analysis/drc_delta.py <baseline> <candidate> [--shift DX_IU DY_IU]`** —
  compares the two dumps as **multisets**. `--shift` offsets the baseline so a core-frame
  dump can be compared against a die-frame one (the +200/+200 seat is `--shift 40000 40000`).
  Exit 0 iff the candidate adds no box; it also reports boxes that vanished, since that is a
  change worth seeing too. **Exit 3** if either dump reports `SELFCHECK FAIL` — it refuses
  to compare an incomplete dump rather than returning a false PASS. (A short dump *is* a false
  PASS: drop boxes from the candidate and the `added` set is empty, so the gate returns 0 while
  reporting the missing boxes only as `REMOVED`, which does not fail the gate.) It also prints
  each side's `GDSBLOB`/`SRCCOMMIT` and shouts **PROVENANCE MISMATCH** when they differ.

Reference run reproducing §8.1:
```
$ drc_delta.py preseat.dump seated.dump --shift 40000 40000
baseline : TOTAL=84   boxes=252  (shift +40000,+40000 iu applied)
candidate: TOTAL=106  boxes=252
NOTE: totals differ (84 -> 106). That alone means nothing ...
ADDED   (in candidate, not in baseline): 0
REMOVED (in baseline, not in candidate): 0
RESULT: PASS -- no violation box in the candidate that the baseline lacks.
```

### 8.4 Do not compare across rule sets
Three different chip-level DRC numbers exist for the same GDS and they are not
interchangeable:

| what | number | why it differs |
|---|---|---|
| `verify_cp.sh chip_top` (magic) | **0** | preloads the `vco_varactors` + `vco_inductor_v2` abstracts, so the PL.5a geometry is never traversed |
| `drc_boxset.tcl` (magic, full geometry) | **252 boxes = 84 regions** seated (`TOTAL` 108, reporting only) | no preload — this is the phase-8 haul gate |
| `klayout_signoff.py chip_top` | **PASS, 168 waived** | the signoff deck; W4 waiver = 84 PL.5a_LV + 84 PL.5b_LV |

A number from one row means nothing against a number from another.

### 8.5 Baseline status after the phase-8 west routing (2026-08-23)

`team_src/magic/chip_top.drcbase` is **unchanged** and still valid, from the commit that created
it. It was scheduled to be re-based after the ISS EM widen, on the expectation that widening the
strap meant editing `gds/vco_v1.gds` and therefore re-merging a changed block into `chip_top`.

**It did not need re-basing.** The widen was done by painting M2 over the strap from
`route_chip.py` at top level: same-layer paint merges with the strap and widens the same
conductor, so the fix is electrically identical to editing the cell, but no block GDS changed
and the block-level box set is untouched. All of (a)-(e) plus the widen report **0 added, 0
removed** against the existing baseline.

Re-base only when a **block** GDS changes. Adding top-level metal does not require it - that is
precisely the delta the gate is meant to measure.

**Residual:** `vco_v1` standalone still has a 0.40 um ISS strap; only the chip_top context
carries the overlay. Widen it in the cell if vco_v1 is ever re-released standalone.

### 8.6 Baseline RE-CAPTURED (2026-08-25) - and why, and what did not change

The 2026-08-22 baseline was still **passing** the gate against the current layout (0 added,
0 removed) and was never wrong. It was re-captured for one reason: its header advertised
`TOTAL 106`, a figure from a GDS five routing commits old, and 8.2 published that 106 as the
current value. A run against the current layout reports 108, and reconciling that cost a full
investigation cycle - the failure mode the provenance header now prevents.

**What changed in `chip_top.drcbase`** - six lines:

```
+GDSF /foss/designs/AUS-NZ-integration/gds/chip_top.gds
+GDSBLOB a79e48d2929613f4b41827316aa9a234a526183b
+SRCCOMMIT f31d5941ddc9bd6db3a2de29b467697de39df526
-TOTAL 106                 +TOTAL 108
-CELLCOUNT chip_top 106    +CELLCOUNT chip_top 108
+SELFCHECK OK rules=1/1 boxes=252/252
```

**What did not change:** all **252 `B` lines, byte-identical**. Verified two ways - `cmp` on the
extracted `B` lines, and `drc_delta.py` old-vs-new reporting 0 added / 0 removed.

The invariance result the old baseline carried is preserved in 8.2. It is no longer
demonstrable from the file itself, which is exactly why it is written down there.

**Re-base rule, unchanged and restated:** re-base only when a **block** GDS changes. Adding
top-level metal does not require it - that is precisely the delta the gate exists to measure.
But re-capture the *header* whenever the baseline is re-captured for any reason, so `GDSBLOB`
never drifts from the layout it describes again.

### 8.7 Baseline RE-CAPTURED again (2026-08-25, rung 2 density markers)

Rung 2 added four keep-out rectangles on three marker layers, so `gds/chip_top.gds` changed and
the baseline was re-captured a second time the same day.

**The box set did not move:** `ADDED 0 / REMOVED 0`, and all **252 `B` lines byte-identical** to
the previous baseline (verified by `cmp`). Marker layers carry no geometry the DRC rules act on,
which is exactly what was expected -- and the gate is what proved it rather than assumed it.

**`TOTAL` moved 108 -> 84, and the cause is fully isolated.** Magic's techfile maps **152/5 to
`FILLOBS2`**, a real `fillblock` layer, so PMNDMY paint is visible to magic and changes how it
re-tiles the error plane at `chip_top`. Proven by dumping four variants of the same GDS through
one invocation:

| variant | `TOTAL` | boxes |
|---|---|---|
| no markers | 108 | 252 |
| NDMY 111/5 only | 108 | 252 |
| IND_MK 151/5 only | 108 | 252 |
| **PMNDMY 152/5 only** | **84** | 252 |

Magic ignores 111/5 (its techfile entry is commented out) and does not know 151/5 at all --
it emits `Unknown layer/datatype in boundary, layer=151 type=5` and drops that polygon. The
read is otherwise complete: `chip_top`'s magic bbox is identical with and without the markers.

This is the §8.2 rule doing its job. `TOTAL` moved for an understood reason, the box multiset --
the actual gate -- did not move at all, and nothing needed hunting.

**A note on `SRCCOMMIT` in this capture.** The baseline is dumped *before* the commit that
contains the GDS, so `SRCCOMMIT` names the **parent** commit. `GDSBLOB` is the authoritative
field and matches the committed blob exactly; `SRCCOMMIT` is context. Do not "fix" it by
re-dumping after committing -- that just moves the skew to the next commit.

### 8.8 Marker layers are NOT visible to magic -- do not round-trip the GDS through magic

Recorded because it is a live hazard for any future flow change:

| layer | magic techfile | magic on `gds read` |
|---|---|---|
| NDMY 111/5 | `layer FILLOBS fillblock / calma 111 5` -- **commented out** | silently ignored |
| PMNDMY 152/5 | `layer FILLOBS2 fillblock / calma 152 5` -- **active** | read as `FILLOBS2` |
| IND_MK 151/5 | **absent** | `Unknown layer/datatype`, polygon dropped |

**Two of the three markers would not survive a magic GDS write.** They survive today only
because the deliverable never passes through magic's writer: `chip_merge.py` and
`route_chip.py` are KLayout, and `verify_cp.sh` reads the GDS into magic but emits `.ext` and
`.spice`, never a GDS. **If any future step writes `gds/chip_top.gds` out of magic, NDMY and
IND_MK are lost silently** -- no error on the write, and DRC will not notice, because the DE
rules live in the KLayout deck which is the only tool that sees these layers.

The round-trip check that catches it is in rung 2's commit: read the written GDS back with
KLayout and assert layer, datatype and coordinates against what was painted.

### 8.9 STANDING LIMITATION: a net that extracts as a GLOBAL node is outside the gate's reach

Recorded 2026-08-25, alongside 8.8, because it is the same shape of hazard: a real defect that
every gate reports as clean.

**magic treats the p-substrate as one global node.** From the techfile:

```
substrate *ppdiff,*mvppdiff,space/w,pwell well $SUB -dnwell,isosub
```

`$SUB` is a single global node. Every p-substrate contact anywhere on the die extracts as that
same node **whether or not any metal connects them**. Extracting a bare `diode_nd2ps_03v3`
gencell shows it directly - the cell has **zero ports**, and its anode is emitted as
`substrate "a_n2329_n2329#"`.

**The consequence:** LVS reports `match uniquely` with a perfect ground strap, a token strap, or
no strap at all. **Gate 4 cannot see a missing substrate return.** This is not the gate being
weak; the defect is invisible to the abstraction the gate is built on. The same applies to any
well tie, and to any other net the extractor globalises.

**The rule this imposes on every remaining ESD pin:** a substrate or well connection needs a
**physical argument** - measured metal, measured distance, a via that provably lands - **every
time**. An LVS pass is not evidence about it. Concretely, for rung 3 the return path from each
clamp's p-side to the nearest VSSA metal was measured at **96.47 um (IBIAS)** and **49.85 um
(ISS)** of bare bulk silicon, with no metal on the path at all; LVS was green throughout and
said nothing.

This sits with 8.8 and 8.10 as the things the six-gate suite structurally cannot check:
marker layers magic cannot see, nets the extractor globalises, and load that lives in a cell
we do not extract.

### 8.10 STANDING LIMITATION: the PADRING's load is outside chip_top, so no gate sees it

Recorded 2026-08-25. Third instance of the pattern, and the one that would have SHIPPED.

`gf180mcu_fd_io__asig_5p0` -- the analog pad cell the organizer's padring instantiates for all
eight analog pins -- carries its own primary ESD:

```
D2 DVSS ASIG5V diode_nd2ps_06v0 m=4.0 area=150e-12 pj=106e-6
D3 ASIG5V DVDD diode_pd2nw_06v0 m=4.0 area=150e-12 pj=106e-6
```

That is 600 um2 of junction area and 424 um of perimeter per pin, or **~875 fF at 1.65 V**
computed from the 06v0 model cards. **It is not in `chip_top`.** Our extraction sees only the
~35 um of routing on the pad net, of order 35 fF, so every timing consequence of that 875 fF
is invisible to gates 1-6. LVS matches, DRC is clean, and the number never appears.

**The worked example, found 2026-08-25.** `XR_SER_IP` is a 1 kohm series resistor between the
DIV2 output buffer (`INVO3_IP`) and the pad net `I_P`. The PFD's feedback input taps `I_P` --
the PAD side of that resistor, not the driver side. So the PLL feedback clock reaches
`dffrnq_1`'s CLK through 1 kohm into the pad's 875 fF:

| | value |
|---|---|
| tau = 1 kohm x ~912 fF | **912 ps** |
| period at 2.4 GHz / 3.2 GHz | 416.7 ps / 312.5 ps |
| swing at CLK, `tanh(T/4tau)` | **11.4 % / 8.5 %** of full rail |
| peak slew | ~0.21 V/ns, and it never reaches either rail |

The DFF clock input would sit in its linear region and switch on noise. **The loop would not
lock** -- and nothing in the six-gate suite would have said so, because the capacitance is in
the organizer's cell.

**The rule this imposes:** any timing or loading question on a PAD NET must be answered against
the padring cell's contents, never against a chip_top extraction. `gf180mcu_fd_io__asig_5p0`
also carries `X1 DVDD DVSS cap_nmos_06v0 m=36.0 c_length=15e-6 c_width=15e-6` across the rails,
which is likewise invisible here.

**Corollary for the ESD rung:** the same 875 fF means the pad is ALREADY heavily loaded before
our secondary clamp adds anything. Our 400 um2 secondary is an increment on 600 um2 of primary,
not a load applied to a bare pad.

### 8.11 STANDING LIMITATION: `chip_top.gds` cannot be byte-reproduced — sha equality is NOT the identity test

Measured 2026-08-29. Rebuilding with an **unmodified** `route_chip.py` (`chip_merge.py` then
`route_chip.py`, no source change of any kind) produces a file that is the same size and
differs from the committed one:

```
committed  04c98b66628c0d87...    rebuilt  fccb84929b573206...
both exactly 1,548,584 bytes;  216 differing bytes
every differing byte lies inside a BGNLIB or BGNSTR record
```

Those are the GDSII library and structure **modification timestamps**, which KLayout stamps
from the clock on every write. Geometry is bit-identical across the two files: same bbox, same
layer/datatype histogram, same 827 via1 cuts, same text set.

**Why this is in the limitations section.** We use sha256 equality as a decisive check on the
`A01.def` package, where it is sound — that artifact is byte-stable. The same reasoning applied
to `chip_top.gds` gives the wrong answer in **both** directions:

- a differing sha does **not** mean the layout changed (a rebuild alone changes 216 bytes), and
- it will never confirm that a rebuild is clean, so "the GDS matched byte-for-byte" is a
  sentence that cannot be true of this artifact and should not be looked for.

**The identity test for `chip_top.gds` is geometric, not byte-wise.** Use the box set
(`drc_boxset.tcl` + `drc_delta.py`, §8.3) plus a layer/count comparison. `GDSBLOB` in a dump
header is a provenance *label*, not a reproducibility claim — it identifies which file was
measured, and it is expected to differ between two dumps of the same geometry.

Same class as §8.8–§8.10: a check that looks decisive and is not.

### 8.12 Measured gate runtimes (2026-08-29, after the rung-3 via array)

Re-measured because the via array was the first change to add geometry in bulk (via1 in
`chip_top.gds` went 827 → 1563). **Neither tool got materially slower.**

| gate | measured | what it reads |
|---|---|---|
| `drc_boxset.tcl` (magic, full geometry) | **1.8 s** | the whole die |
| `klayout_signoff.py chip_top` (variant D) | **16.9 s** | the whole die; V1.2b's `sized`/`merged`/`interacting` pass over 1563 via1 costs about 1 s of this |
| `verify_cp.sh chip_top` (extract + netgen LVS) | **14.6 s** | |
| `landing_check.py` | **4.4 s** | |
| `lane_conflicts.py` | **4.0 s** | |
| `check_placement.py` | **3.7 s** | |
| **six-gate total** | **45.4 s** | plus 8 s to rebuild (`chip_merge` 4 s + `route_chip` 4 s) |

**Correction to an earlier figure: `check_placement.py` is 3.7 s, not the 0.7 s recorded on
2026-08-25.** It is not the new geometry — that script compares placement tables and never
reads via1. Every KLayout-hosted gate here has a **~3.5 s process-startup floor**, and the
0.7 s figure evidently excluded it. Quote the wall-clock numbers above; they are what a future
run will actually see.

### 8.13 D block reseat (2026-11-06)

Bailey moved A01 to block D: **605 × 605 µm** die, 366,025 µm² usable, no blockages
(`padframe/A01/project_defs_D/`). Seat A puts the die at core + (100, 255), so the GND ring is
522 × 305 µm at (75, 237.5)–(597, 542.5). Pad slots are W17–W22 and N01–N06. Everything earlier
in §8 is the BH die. The plan and route details are in `docs/d-block-plan.md`.

| Rung | Row | Commit | Landing | Magic added | KLayout | Routes nets | Full nets | New merges |
|---|---|---|---|---:|---:|---|---|---|
| 1 | seat, west rows off | `4cd44b0` | n/a | 0 | 0 | n/a | n/a | none |
| 2 | VSSA + VDDA | `9a5f7eb` | 10/14 | 0 | 0 | 25→23 | 327→325 | none |
| 3 | ISS | `39f6bdf` | 11/14 | 0 | 0 | 23→21 | 325→323 | none |
| 4 | IBIAS | `a680553` | 12/14 | 0 | 0 | 21→20 | 323→322 | none |
| 5 | VTUNE | `5ee98f8` | 13/14 | 0 | 0 | 20→20 | 322→322 | none |
| 6 | CP_OUT | `402b1d9` | 14/14 | 0 | 0 | 20→20 | 322→322 | none |

Rungs 5 and 6 show no net-count drop because rung 1 had removed those rows entirely, so no open
stub remained. Baseline at `402b1d9`: 0 magic DRC boxes, KLayout variant D 0 violations with no
waivers. `lane_conflicts.py` is BH-only and is not a D gate.

**ISS, as built.** About 6.3 Ω, 9.9 mV at 1.57 mA, hand-calculated from the geometry at typical
sheet resistance and counting the whole strap. M2 strap 0.523 mA/µm (1.28× margin at 125 °C), M2
escape 0.314 mA/µm (2.1×), M4/M5 0.157 mA/µm (4.3×), escape cuts 24.5 µA/cut (11.4×).

**VTUNE coupling to ISS.** 3.45 fF extracted, 7.44 fF analytic bound. Worst 2f0 sideband at
VTUNE: −125.4 dBc extracted, −119.3 dBc at the bound, for 192 mVpp ripple at 7.61 GHz.

**Lengths.** OUT_p and OUT_n 453.5 µm each; I/Q 398.760 µm, spread 0.0000 µm.

## 9. Resistor models — two sheet resistances for one device, and which tool uses which

Recorded 2026-08-25 while sizing the rung-3 secondary-ESD series resistor. **`ppolyf_u` does
not have one sheet resistance in this PDK — it has two, depending on which tool you ask.**

| source | value | where |
|---|---|---|
| KLayout LVS extraction deck | **350 Ω/sq** | `libs.tech/klayout/tech/lvs/rule_decks/res_extraction.lvs`: `extract_devices(resistor_with_bulk('ppolyf_u', 350, BResistor), …)` |
| magic gencell | **315 Ω/sq** | `libs.tech/magic/gf180mcuD.tcl`, `gf180mcu::ppolyf_u_defaults` → `rho 315` |

An 11 % disagreement on the same device. For the organizers' secondary-ESD geometry
(`ppolyf_u` W=16 µm, L=4 µm, from `io_secondary_3p3.sch`) that is:

* **87.5 Ω** by the LVS deck's 350 Ω/sq
* **~78.75 Ω** by magic's 315 Ω/sq (nominal, before the gencell's `dw 0.07` edge correction)

**This does not affect the LVS gate.** netgen matches resistors on their *geometry* parameters
(`w`, `l` / `r_width`, `r_length`), not on an ohms value, so layout and golden agree as long as
the drawn geometry agrees. It matters for **anything that quotes a resistance**: never publish a
single number for a `ppolyf_u` without saying which sheet value it came from. Both clear the
>50 Ω secondary-ESD guidance, so the choice is not load-bearing here.

`ppolyf_u_1k` is **1000 Ω/sq** in the LVS deck and is the model every existing resistor in
`chip_top_golden.spice` uses — there is no `ppolyf_u_3k` in the design:

| device | block | geometry | value at 1000 Ω/sq |
|---|---|---|---|
| `XR2 TUNE cap_bias` | `vco_v1` | r_width 1 µm, r_length 15 µm | **15 kΩ** — VTUNE series |
| `XR_SER_{IP,IN,QP,QN}` | `DIV2_QUAD_v1` | r_width 2 µm, r_length 2 µm | **1 kΩ** each — I/Q series |
| `XRFB_{IP,IN,QP,QN}` | `DIV2_QUAD_v1` | r_width 2 µm, r_length 40.04 µm | ~20 kΩ — inverter feedback |
| `XRA{1,2}` / `XRB{1,2}` | `DIV2_QUAD_v1` | r_width 10 µm, r_length 3 µm | ~300 Ω — CML loads |

In every case the **pad-facing net is the subckt port** (`TUNE`, `I_P`, …) and the resistor
already sits between pad and core, which is why a secondary clamp inserts at chip level
without reopening a signed-off block.

## 10. Documentation cross-references are gated, not trusted

`team_src/magic/analysis/ref_audit.py .` — exit 0 iff every cross-reference in the markdown
resolves. Run it after any doc edit that adds or renumbers a section.

```
scanned 28 markdown files
section refs : 139 checked, 0 dangling
path refs    : 432 checked, 15 allowlisted, 0 unresolved
RESULT: PASS -- every section and path reference resolves
```

Two classes, both gating. **Section refs** must name a heading that exists; ranges are
expanded so every endpoint is checked, which is the only reason the "supersedes 1a-1d" ref in
`phase8-padframe-plan.md` was ever caught — its 1c and 1d resolved and hid the two that did
not. **Path refs** are backticked repo-relative paths; they cannot be judged by existence
alone, because the docs legitimately name organizer-side files and one file we deliberately
cite as retired, so those sit in an ALLOWLIST in the script with a per-entry reason. An
allowlist entry that starts resolving, or stops being referenced, is reported too — the list
cannot rot into a blanket suppression.

Note that a *literal* section reference written in prose is indistinguishable from a live one,
so illustrative examples in this paragraph are written without the section sign on purpose.

Three dangling section refs were fixed when this first ran (2026-08-29): 1a and 1b in
`phase8-padframe-plan.md`, whose subsections were headed "BV" and "BH" and are now numbered;
and 3.1 in `scope.md`, a subsection the frequency-plan rewrite had removed. Same failure mode
as §8.11 — something that reads as checked and is not.
