Zachnad0/AUS-NZ-Track-A-RFIC-Workspace/team_src/magic/vco_tune_r_golden.spice

.subckt vco_tune_r TUNE cap_bias GND
XR2 TUNE cap_bias GND ppolyf_u_1k r_width=1u r_length=15u
.ends
