Zachnad0/AUS-NZ-Track-A-RFIC-Workspace/signoff/lvs/chip_top.lvs.spice

* NGSPICE file created from chip_top.ext - technology: gf180mcuD

.subckt ibias_gen_v1 IBIAS VGP VGN IB_DIV2 VDD VSS
X0 a_17124_n400# a_n1372_556# VSS VSS nfet_03v3 ad=1.04p pd=4.52u as=1.04p ps=4.52u w=4u l=2u
X1 a_1396_12024# IBIAS a_17124_n400# VSS nfet_03v3 ad=1.04p pd=4.52u as=1.04p ps=4.52u w=4u l=1u
X2 IB_DIV2 a_17692_12024# a_17124_4400# VDD pfet_03v3 ad=4.16p pd=16.52u as=4.16p ps=16.52u w=16u l=1u
X3 a_196_7624# a_196_7624# VDD VDD pfet_03v3 ad=4.16p pd=16.52u as=4.16p ps=16.52u w=16u l=2u
X4 VDD a_196_7624# a_196_7624# VDD pfet_03v3 ad=7.04p pd=32.88u as=4.16p ps=16.52u w=16u l=2u
X5 IBIAS IBIAS a_n1372_556# VSS nfet_03v3 ad=1.04p pd=4.52u as=1.04p ps=4.52u w=4u l=1u
X6 a_1396_12024# IBIAS a_17124_n400# VSS nfet_03v3 ad=1.04p pd=4.52u as=1.04p ps=4.52u w=4u l=1u
X7 VDD a_196_7624# a_17124_4400# VDD pfet_03v3 ad=4.16p pd=16.52u as=4.16p ps=16.52u w=16u l=2u
X8 a_17124_4400# a_196_7624# VDD VDD pfet_03v3 ad=4.16p pd=16.52u as=4.16p ps=16.52u w=16u l=2u
X9 a_17124_4400# a_196_7624# VDD VDD pfet_03v3 ad=4.16p pd=16.52u as=4.16p ps=16.52u w=16u l=2u
X10 a_17124_4400# a_196_7624# VDD VDD pfet_03v3 ad=4.16p pd=16.52u as=4.16p ps=16.52u w=16u l=2u
X11 IB_DIV2 a_17692_12024# a_17124_4400# VDD pfet_03v3 ad=4.16p pd=16.52u as=4.16p ps=16.52u w=16u l=1u
X12 a_196_7624# a_196_7624# VDD VDD pfet_03v3 ad=4.16p pd=16.52u as=4.16p ps=16.52u w=16u l=2u
X13 VDD a_196_7624# a_14044_4400# VDD pfet_03v3 ad=4.16p pd=16.52u as=4.16p ps=16.52u w=16u l=2u
X14 VGP IBIAS a_7436_n400# VSS nfet_03v3 ad=1.04p pd=4.52u as=1.76p ps=8.88u w=4u l=1u
X15 a_14044_4400# a_196_7624# VDD VDD pfet_03v3 ad=7.04p pd=32.88u as=4.16p ps=16.52u w=16u l=2u
X16 a_17124_n400# a_n1372_556# VSS VSS nfet_03v3 ad=1.04p pd=4.52u as=1.04p ps=4.52u w=4u l=2u
X17 VSS a_n1372_556# a_17124_n400# VSS nfet_03v3 ad=1.04p pd=4.52u as=1.04p ps=4.52u w=4u l=2u
X18 a_17124_n400# IBIAS a_1396_12024# VSS nfet_03v3 ad=1.04p pd=4.52u as=1.04p ps=4.52u w=4u l=1u
X19 IB_DIV2 a_17692_12024# a_17124_4400# VDD pfet_03v3 ad=4.16p pd=16.52u as=4.16p ps=16.52u w=16u l=1u
X20 a_17124_n400# a_n1372_556# VSS VSS nfet_03v3 ad=1.04p pd=4.52u as=1.04p ps=4.52u w=4u l=2u
X21 VSS a_n1372_556# a_17124_n400# VSS nfet_03v3 ad=1.04p pd=4.52u as=1.04p ps=4.52u w=4u l=2u
X22 IBIAS IBIAS a_n1372_556# VSS nfet_03v3 ad=1.04p pd=4.52u as=1.04p ps=4.52u w=4u l=1u
X23 VSS a_n1372_556# a_17124_n400# VSS nfet_03v3 ad=1.04p pd=4.52u as=1.04p ps=4.52u w=4u l=2u
X24 a_17124_n400# a_n1372_556# VSS VSS nfet_03v3 ad=1.04p pd=4.52u as=1.04p ps=4.52u w=4u l=2u
X25 VSS a_n1372_556# a_n1372_556# VSS nfet_03v3 ad=1.04p pd=4.52u as=1.04p ps=4.52u w=4u l=2u
X26 a_1396_12024# a_1396_12024# a_196_7624# VDD pfet_03v3 ad=4.16p pd=16.52u as=4.16p ps=16.52u w=16u l=1u
X27 VDD a_196_7624# a_17124_4400# VDD pfet_03v3 ad=4.16p pd=16.52u as=4.16p ps=16.52u w=16u l=2u
X28 a_n1372_556# IBIAS IBIAS VSS nfet_03v3 ad=1.04p pd=4.52u as=1.04p ps=4.52u w=4u l=1u
X29 a_17124_4400# a_17692_12024# IB_DIV2 VDD pfet_03v3 ad=4.16p pd=16.52u as=4.16p ps=16.52u w=16u l=1u
X30 VDD a_196_7624# a_17124_4400# VDD pfet_03v3 ad=4.16p pd=16.52u as=4.16p ps=16.52u w=16u l=2u
X31 VSS a_n1372_556# VSS VSS nfet_03v3 ad=1.76p pd=8.88u as=74.88p ps=0.34144m w=4u l=2u
X32 IB_DIV2 a_17692_12024# a_17124_4400# VDD pfet_03v3 ad=4.16p pd=16.52u as=4.16p ps=16.52u w=16u l=1u
X33 a_17124_4400# a_196_7624# VDD VDD pfet_03v3 ad=4.16p pd=16.52u as=4.16p ps=16.52u w=16u l=2u
X34 IBIAS IBIAS a_n1372_556# VSS nfet_03v3 ad=1.04p pd=4.52u as=1.04p ps=4.52u w=4u l=1u
X35 VGP IBIAS a_7436_n400# VSS nfet_03v3 ad=1.04p pd=4.52u as=1.04p ps=4.52u w=4u l=1u
X36 a_1396_12024# a_1396_12024# a_196_7624# VDD pfet_03v3 ad=4.16p pd=16.52u as=4.16p ps=16.52u w=16u l=1u
X37 a_17124_4400# a_196_7624# VDD VDD pfet_03v3 ad=4.16p pd=16.52u as=4.16p ps=16.52u w=16u l=2u
X38 VSS a_n1372_556# VSS VSS nfet_03v3 ad=1.76p pd=8.88u as=0 ps=0 w=4u l=2u
X39 a_17124_n400# IBIAS a_1396_12024# VSS nfet_03v3 ad=1.04p pd=4.52u as=1.04p ps=4.52u w=4u l=1u
X40 a_17124_4400# a_17692_12024# IB_DIV2 VDD pfet_03v3 ad=7.04p pd=32.88u as=4.16p ps=16.52u w=16u l=1u
X41 a_n1372_556# IBIAS IBIAS VSS nfet_03v3 ad=1.04p pd=4.52u as=1.04p ps=4.52u w=4u l=1u
X42 VSS a_n1372_556# a_17124_n400# VSS nfet_03v3 ad=1.04p pd=4.52u as=1.04p ps=4.52u w=4u l=2u
X43 IBIAS IBIAS a_n1372_556# VSS nfet_03v3 ad=1.04p pd=4.52u as=1.04p ps=4.52u w=4u l=1u
X44 a_n1372_556# IBIAS IBIAS VSS nfet_03v3 ad=1.04p pd=4.52u as=1.04p ps=4.52u w=4u l=1u
X45 a_196_7624# a_1396_12024# a_1396_12024# VDD pfet_03v3 ad=4.16p pd=16.52u as=4.16p ps=16.52u w=16u l=1u
X46 a_1396_12024# a_1396_12024# a_196_7624# VDD pfet_03v3 ad=4.16p pd=16.52u as=4.16p ps=16.52u w=16u l=1u
X47 a_17124_n400# a_n1372_556# VSS VSS nfet_03v3 ad=1.04p pd=4.52u as=1.04p ps=4.52u w=4u l=2u
X48 VSS a_n1372_556# a_17124_n400# VSS nfet_03v3 ad=1.04p pd=4.52u as=1.04p ps=4.52u w=4u l=2u
X49 a_17124_n400# a_n1372_556# VSS VSS nfet_03v3 ad=1.04p pd=4.52u as=1.04p ps=4.52u w=4u l=2u
X50 VSS a_n1372_556# a_17124_n400# VSS nfet_03v3 ad=1.04p pd=4.52u as=1.04p ps=4.52u w=4u l=2u
X51 VSS a_n1372_556# a_n1372_556# VSS nfet_03v3 ad=1.04p pd=4.52u as=1.04p ps=4.52u w=4u l=2u
X52 a_n1372_556# a_n1372_556# VSS VSS nfet_03v3 ad=1.04p pd=4.52u as=1.04p ps=4.52u w=4u l=2u
X53 a_17124_n400# a_n1372_556# VSS VSS nfet_03v3 ad=1.04p pd=4.52u as=1.04p ps=4.52u w=4u l=2u
X54 VSS a_n1372_556# a_n1372_556# VSS nfet_03v3 ad=1.04p pd=4.52u as=1.04p ps=4.52u w=4u l=2u
X55 a_17124_n400# IBIAS a_1396_12024# VSS nfet_03v3 ad=1.04p pd=4.52u as=1.04p ps=4.52u w=4u l=1u
X56 VDD a_196_7624# a_17124_4400# VDD pfet_03v3 ad=4.16p pd=16.52u as=4.16p ps=16.52u w=16u l=2u
X57 IBIAS IBIAS a_n1372_556# VSS nfet_03v3 ad=1.04p pd=4.52u as=1.04p ps=4.52u w=4u l=1u
X58 a_1396_12024# a_1396_12024# a_196_7624# VDD pfet_03v3 ad=4.16p pd=16.52u as=4.16p ps=16.52u w=16u l=1u
X59 VDD a_196_7624# a_17124_4400# VDD pfet_03v3 ad=7.04p pd=32.88u as=4.16p ps=16.52u w=16u l=2u
X60 VDD a_196_7624# a_17124_4400# VDD pfet_03v3 ad=4.16p pd=16.52u as=4.16p ps=16.52u w=16u l=2u
X61 a_1396_12024# IBIAS a_17124_n400# VSS nfet_03v3 ad=1.04p pd=4.52u as=1.04p ps=4.52u w=4u l=1u
X62 VDD a_196_7624# a_196_7624# VDD pfet_03v3 ad=4.16p pd=16.52u as=4.16p ps=16.52u w=16u l=2u
X63 VDD a_196_7624# a_17124_4400# VDD pfet_03v3 ad=4.16p pd=16.52u as=4.16p ps=16.52u w=16u l=2u
X64 a_n1372_556# IBIAS IBIAS VSS nfet_03v3 ad=1.04p pd=4.52u as=1.04p ps=4.52u w=4u l=1u
X65 VSS a_n1372_556# a_17124_n400# VSS nfet_03v3 ad=1.76p pd=8.88u as=1.04p ps=4.52u w=4u l=2u
X66 a_17124_4400# a_17692_12024# IB_DIV2 VDD pfet_03v3 ad=4.16p pd=16.52u as=4.16p ps=16.52u w=16u l=1u
X67 a_1396_12024# IBIAS a_17124_n400# VSS nfet_03v3 ad=1.04p pd=4.52u as=1.04p ps=4.52u w=4u l=1u
X68 VDD a_196_7624# VDD VDD pfet_03v3 ad=4.16p pd=16.52u as=0.31616n ps=1.31952m w=16u l=2u
X69 VSS a_n1372_556# a_17124_n400# VSS nfet_03v3 ad=1.04p pd=4.52u as=1.04p ps=4.52u w=4u l=2u
X70 a_1396_12024# a_1396_12024# a_196_7624# VDD pfet_03v3 ad=4.16p pd=16.52u as=7.04p ps=32.88u w=16u l=1u
X71 VSS a_n1372_556# a_17124_n400# VSS nfet_03v3 ad=1.04p pd=4.52u as=1.04p ps=4.52u w=4u l=2u
X72 a_1396_12024# IBIAS a_17124_n400# VSS nfet_03v3 ad=1.04p pd=4.52u as=1.04p ps=4.52u w=4u l=1u
X73 a_1396_12024# IBIAS a_17124_n400# VSS nfet_03v3 ad=1.04p pd=4.52u as=1.04p ps=4.52u w=4u l=1u
X74 a_17124_n400# IBIAS a_1396_12024# VSS nfet_03v3 ad=1.04p pd=4.52u as=1.04p ps=4.52u w=4u l=1u
X75 a_17124_4400# a_196_7624# VDD VDD pfet_03v3 ad=4.16p pd=16.52u as=4.16p ps=16.52u w=16u l=2u
X76 a_n1372_556# a_n1372_556# VSS VSS nfet_03v3 ad=1.04p pd=4.52u as=1.04p ps=4.52u w=4u l=2u
X77 VGN a_1396_12024# a_14044_4400# VDD pfet_03v3 ad=4.16p pd=16.52u as=4.16p ps=16.52u w=16u l=1u
X78 VDD a_196_7624# a_17124_4400# VDD pfet_03v3 ad=4.16p pd=16.52u as=4.16p ps=16.52u w=16u l=2u
X79 a_n1372_556# IBIAS IBIAS VSS nfet_03v3 ad=1.04p pd=4.52u as=1.04p ps=4.52u w=4u l=1u
X80 VSS a_n1372_556# a_n1372_556# VSS nfet_03v3 ad=1.04p pd=4.52u as=1.04p ps=4.52u w=4u l=2u
X81 a_1396_12024# a_1396_12024# a_196_7624# VDD pfet_03v3 ad=4.16p pd=16.52u as=4.16p ps=16.52u w=16u l=1u
X82 a_196_7624# a_1396_12024# a_1396_12024# VDD pfet_03v3 ad=7.04p pd=32.88u as=4.16p ps=16.52u w=16u l=1u
X83 a_17124_4400# a_196_7624# VDD VDD pfet_03v3 ad=4.16p pd=16.52u as=7.04p ps=32.88u w=16u l=2u
X84 VSS a_n1372_556# VSS VSS nfet_03v3 ad=1.04p pd=4.52u as=0 ps=0 w=4u l=2u
X85 a_33292_7624# a_17692_12024# a_17692_12024# VDD pfet_03v3 ad=7.04p pd=32.88u as=4.16p ps=16.52u w=16u l=1u
X86 VDD a_196_7624# a_17124_4400# VDD pfet_03v3 ad=4.16p pd=16.52u as=4.16p ps=16.52u w=16u l=2u
X87 a_196_7624# a_1396_12024# a_1396_12024# VDD pfet_03v3 ad=4.16p pd=16.52u as=4.16p ps=16.52u w=16u l=1u
X88 a_17124_4400# a_17692_12024# IB_DIV2 VDD pfet_03v3 ad=4.16p pd=16.52u as=4.16p ps=16.52u w=16u l=1u
X89 IB_DIV2 a_17692_12024# a_17124_4400# VDD pfet_03v3 ad=4.16p pd=16.52u as=4.16p ps=16.52u w=16u l=1u
X90 a_196_7624# a_196_7624# VDD VDD pfet_03v3 ad=4.16p pd=16.52u as=4.16p ps=16.52u w=16u l=2u
X91 VDD a_196_7624# a_17124_4400# VDD pfet_03v3 ad=4.16p pd=16.52u as=4.16p ps=16.52u w=16u l=2u
X92 a_17124_4400# a_17692_12024# IB_DIV2 VDD pfet_03v3 ad=4.16p pd=16.52u as=4.16p ps=16.52u w=16u l=1u
X93 IB_DIV2 a_17692_12024# a_17124_4400# VDD pfet_03v3 ad=4.16p pd=16.52u as=7.04p ps=32.88u w=16u l=1u
X94 VDD a_196_7624# a_196_7624# VDD pfet_03v3 ad=4.16p pd=16.52u as=4.16p ps=16.52u w=16u l=2u
X95 a_17124_n400# IBIAS a_1396_12024# VSS nfet_03v3 ad=1.04p pd=4.52u as=1.04p ps=4.52u w=4u l=1u
X96 IBIAS IBIAS a_n1372_556# VSS nfet_03v3 ad=1.04p pd=4.52u as=1.76p ps=8.88u w=4u l=1u
X97 a_7436_n400# IBIAS VGP VSS nfet_03v3 ad=1.04p pd=4.52u as=1.04p ps=4.52u w=4u l=1u
X98 a_1396_12024# a_1396_12024# a_196_7624# VDD pfet_03v3 ad=4.16p pd=16.52u as=4.16p ps=16.52u w=16u l=1u
X99 VDD a_196_7624# a_196_7624# VDD pfet_03v3 ad=4.16p pd=16.52u as=4.16p ps=16.52u w=16u l=2u
X100 VSS a_n1372_556# a_17692_12024# VSS nfet_03v3 ad=1.76p pd=8.88u as=1.04p ps=4.52u w=4u l=2u
X101 a_17124_4400# a_17692_12024# IB_DIV2 VDD pfet_03v3 ad=4.16p pd=16.52u as=4.16p ps=16.52u w=16u l=1u
X102 VSS a_n1372_556# a_n1372_556# VSS nfet_03v3 ad=1.04p pd=4.52u as=1.04p ps=4.52u w=4u l=2u
X103 a_1396_12024# IBIAS a_17124_n400# VSS nfet_03v3 ad=1.04p pd=4.52u as=1.04p ps=4.52u w=4u l=1u
X104 VGN a_1396_12024# a_14044_4400# VDD pfet_03v3 ad=7.04p pd=32.88u as=4.16p ps=16.52u w=16u l=1u
X105 a_n1372_556# IBIAS IBIAS VSS nfet_03v3 ad=1.04p pd=4.52u as=1.04p ps=4.52u w=4u l=1u
X106 VDD a_196_7624# VDD VDD pfet_03v3 ad=4.16p pd=16.52u as=0 ps=0 w=16u l=2u
X107 a_n1372_556# IBIAS IBIAS VSS nfet_03v3 ad=1.04p pd=4.52u as=1.04p ps=4.52u w=4u l=1u
X108 VSS a_n1372_556# a_17124_n400# VSS nfet_03v3 ad=1.04p pd=4.52u as=1.04p ps=4.52u w=4u l=2u
X109 a_n1372_556# a_n1372_556# VSS VSS nfet_03v3 ad=1.04p pd=4.52u as=1.04p ps=4.52u w=4u l=2u
X110 a_17124_4400# a_196_7624# VDD VDD pfet_03v3 ad=4.16p pd=16.52u as=4.16p ps=16.52u w=16u l=2u
X111 VSS a_n1372_556# a_n1372_556# VSS nfet_03v3 ad=1.76p pd=8.88u as=1.04p ps=4.52u w=4u l=2u
X112 a_n1372_556# a_n1372_556# VSS VSS nfet_03v3 ad=1.04p pd=4.52u as=1.04p ps=4.52u w=4u l=2u
X113 a_n1372_556# a_n1372_556# VSS VSS nfet_03v3 ad=1.04p pd=4.52u as=1.76p ps=8.88u w=4u l=2u
X114 VDD a_196_7624# a_17124_4400# VDD pfet_03v3 ad=7.04p pd=32.88u as=4.16p ps=16.52u w=16u l=2u
X115 a_17124_4400# a_196_7624# VDD VDD pfet_03v3 ad=4.16p pd=16.52u as=4.16p ps=16.52u w=16u l=2u
X116 VDD a_196_7624# a_17124_4400# VDD pfet_03v3 ad=4.16p pd=16.52u as=4.16p ps=16.52u w=16u l=2u
X117 VSS a_n1372_556# a_n1372_556# VSS nfet_03v3 ad=1.04p pd=4.52u as=1.04p ps=4.52u w=4u l=2u
X118 IB_DIV2 a_17692_12024# a_17124_4400# VDD pfet_03v3 ad=4.16p pd=16.52u as=4.16p ps=16.52u w=16u l=1u
X119 VSS a_n1372_556# VSS VSS nfet_03v3 ad=1.04p pd=4.52u as=0 ps=0 w=4u l=2u
X120 a_196_7624# a_1396_12024# a_1396_12024# VDD pfet_03v3 ad=4.16p pd=16.52u as=4.16p ps=16.52u w=16u l=1u
X121 a_196_7624# a_196_7624# VDD VDD pfet_03v3 ad=4.16p pd=16.52u as=4.16p ps=16.52u w=16u l=2u
X122 VDD a_196_7624# a_196_7624# VDD pfet_03v3 ad=4.16p pd=16.52u as=4.16p ps=16.52u w=16u l=2u
X123 a_17124_n400# IBIAS a_1396_12024# VSS nfet_03v3 ad=1.04p pd=4.52u as=1.04p ps=4.52u w=4u l=1u
X124 VSS a_n1372_556# a_7436_n400# VSS nfet_03v3 ad=1.04p pd=4.52u as=1.04p ps=4.52u w=4u l=2u
X125 IBIAS IBIAS a_n1372_556# VSS nfet_03v3 ad=1.04p pd=4.52u as=1.04p ps=4.52u w=4u l=1u
X126 VSS a_n1372_556# a_n1372_556# VSS nfet_03v3 ad=1.04p pd=4.52u as=1.04p ps=4.52u w=4u l=2u
X127 a_n1372_556# a_n1372_556# VSS VSS nfet_03v3 ad=1.04p pd=4.52u as=1.76p ps=8.88u w=4u l=2u
X128 a_17124_n400# IBIAS a_1396_12024# VSS nfet_03v3 ad=1.04p pd=4.52u as=1.04p ps=4.52u w=4u l=1u
X129 a_17124_4400# a_17692_12024# IB_DIV2 VDD pfet_03v3 ad=4.16p pd=16.52u as=4.16p ps=16.52u w=16u l=1u
X130 VDD a_196_7624# VDD VDD pfet_03v3 ad=4.16p pd=16.52u as=0 ps=0 w=16u l=2u
X131 VSS a_n1372_556# a_n1372_556# VSS nfet_03v3 ad=1.04p pd=4.52u as=1.04p ps=4.52u w=4u l=2u
X132 VDD a_196_7624# VDD VDD pfet_03v3 ad=7.04p pd=32.88u as=0 ps=0 w=16u l=2u
X133 a_1396_12024# IBIAS a_17124_n400# VSS nfet_03v3 ad=1.04p pd=4.52u as=1.76p ps=8.88u w=4u l=1u
X134 a_7436_n400# IBIAS VGP VSS nfet_03v3 ad=1.04p pd=4.52u as=1.04p ps=4.52u w=4u l=1u
X135 a_n1372_556# a_n1372_556# VSS VSS nfet_03v3 ad=1.04p pd=4.52u as=1.04p ps=4.52u w=4u l=2u
X136 VGN a_1396_12024# a_14044_4400# VDD pfet_03v3 ad=4.16p pd=16.52u as=7.04p ps=32.88u w=16u l=1u
X137 a_17124_4400# a_196_7624# VDD VDD pfet_03v3 ad=4.16p pd=16.52u as=4.16p ps=16.52u w=16u l=2u
X138 a_17124_4400# a_17692_12024# IB_DIV2 VDD pfet_03v3 ad=4.16p pd=16.52u as=4.16p ps=16.52u w=16u l=1u
X139 a_n1372_556# IBIAS IBIAS VSS nfet_03v3 ad=1.04p pd=4.52u as=1.04p ps=4.52u w=4u l=1u
X140 a_196_7624# a_1396_12024# a_1396_12024# VDD pfet_03v3 ad=4.16p pd=16.52u as=4.16p ps=16.52u w=16u l=1u
X141 a_17124_n400# IBIAS a_1396_12024# VSS nfet_03v3 ad=1.76p pd=8.88u as=1.04p ps=4.52u w=4u l=1u
X142 a_1396_12024# a_1396_12024# a_196_7624# VDD pfet_03v3 ad=4.16p pd=16.52u as=4.16p ps=16.52u w=16u l=1u
X143 a_1396_12024# a_1396_12024# a_196_7624# VDD pfet_03v3 ad=4.16p pd=16.52u as=4.16p ps=16.52u w=16u l=1u
X144 a_196_7624# a_1396_12024# a_1396_12024# VDD pfet_03v3 ad=4.16p pd=16.52u as=4.16p ps=16.52u w=16u l=1u
X145 a_196_7624# a_196_7624# VDD VDD pfet_03v3 ad=4.16p pd=16.52u as=4.16p ps=16.52u w=16u l=2u
X146 IBIAS IBIAS a_n1372_556# VSS nfet_03v3 ad=1.04p pd=4.52u as=1.04p ps=4.52u w=4u l=1u
X147 IB_DIV2 a_17692_12024# a_17124_4400# VDD pfet_03v3 ad=4.16p pd=16.52u as=4.16p ps=16.52u w=16u l=1u
X148 a_196_7624# a_196_7624# VDD VDD pfet_03v3 ad=4.16p pd=16.52u as=7.04p ps=32.88u w=16u l=2u
X149 a_196_7624# a_196_7624# VDD VDD pfet_03v3 ad=4.16p pd=16.52u as=4.16p ps=16.52u w=16u l=2u
X150 a_33292_7624# a_33292_7624# VDD VDD pfet_03v3 ad=4.16p pd=16.52u as=7.04p ps=32.88u w=16u l=2u
X151 VDD a_196_7624# a_196_7624# VDD pfet_03v3 ad=7.04p pd=32.88u as=4.16p ps=16.52u w=16u l=2u
X152 a_7436_n400# a_n1372_556# VSS VSS nfet_03v3 ad=1.04p pd=4.52u as=1.76p ps=8.88u w=4u l=2u
X153 a_17124_n400# IBIAS a_1396_12024# VSS nfet_03v3 ad=1.04p pd=4.52u as=1.04p ps=4.52u w=4u l=1u
X154 IB_DIV2 a_17692_12024# a_17124_4400# VDD pfet_03v3 ad=4.16p pd=16.52u as=4.16p ps=16.52u w=16u l=1u
X155 a_17124_4400# a_17692_12024# IB_DIV2 VDD pfet_03v3 ad=4.16p pd=16.52u as=4.16p ps=16.52u w=16u l=1u
X156 a_17692_12024# a_n1372_556# VSS VSS nfet_03v3 ad=1.04p pd=4.52u as=1.76p ps=8.88u w=4u l=2u
X157 VDD a_196_7624# a_196_7624# VDD pfet_03v3 ad=4.16p pd=16.52u as=4.16p ps=16.52u w=16u l=2u
X158 IBIAS IBIAS a_n1372_556# VSS nfet_03v3 ad=1.04p pd=4.52u as=1.04p ps=4.52u w=4u l=1u
X159 a_n1372_556# a_n1372_556# VSS VSS nfet_03v3 ad=1.04p pd=4.52u as=1.04p ps=4.52u w=4u l=2u
X160 a_n1372_556# IBIAS IBIAS VSS nfet_03v3 ad=1.04p pd=4.52u as=1.04p ps=4.52u w=4u l=1u
X161 VSS a_n1372_556# a_n1372_556# VSS nfet_03v3 ad=1.04p pd=4.52u as=1.04p ps=4.52u w=4u l=2u
X162 VSS a_n1372_556# a_7436_n400# VSS nfet_03v3 ad=1.04p pd=4.52u as=1.04p ps=4.52u w=4u l=2u
X163 VDD a_196_7624# VDD VDD pfet_03v3 ad=4.16p pd=16.52u as=0 ps=0 w=16u l=2u
X164 a_17124_n400# IBIAS a_1396_12024# VSS nfet_03v3 ad=1.04p pd=4.52u as=1.04p ps=4.52u w=4u l=1u
X165 IBIAS IBIAS a_n1372_556# VSS nfet_03v3 ad=1.04p pd=4.52u as=1.04p ps=4.52u w=4u l=1u
X166 VDD a_196_7624# a_196_7624# VDD pfet_03v3 ad=4.16p pd=16.52u as=4.16p ps=16.52u w=16u l=2u
X167 a_17124_4400# a_196_7624# VDD VDD pfet_03v3 ad=4.16p pd=16.52u as=4.16p ps=16.52u w=16u l=2u
X168 a_1396_12024# a_1396_12024# a_196_7624# VDD pfet_03v3 ad=4.16p pd=16.52u as=4.16p ps=16.52u w=16u l=1u
X169 a_196_7624# a_1396_12024# a_1396_12024# VDD pfet_03v3 ad=7.04p pd=32.88u as=4.16p ps=16.52u w=16u l=1u
X170 VDD a_33292_7624# a_33292_7624# VDD pfet_03v3 ad=7.04p pd=32.88u as=4.16p ps=16.52u w=16u l=2u
X171 a_17124_4400# a_17692_12024# IB_DIV2 VDD pfet_03v3 ad=4.16p pd=16.52u as=4.16p ps=16.52u w=16u l=1u
X172 a_17124_n400# a_n1372_556# VSS VSS nfet_03v3 ad=1.04p pd=4.52u as=1.76p ps=8.88u w=4u l=2u
X173 a_1396_12024# IBIAS a_17124_n400# VSS nfet_03v3 ad=1.04p pd=4.52u as=1.04p ps=4.52u w=4u l=1u
X174 a_196_7624# a_1396_12024# a_1396_12024# VDD pfet_03v3 ad=4.16p pd=16.52u as=4.16p ps=16.52u w=16u l=1u
X175 a_196_7624# a_196_7624# VDD VDD pfet_03v3 ad=4.16p pd=16.52u as=4.16p ps=16.52u w=16u l=2u
X176 VDD a_196_7624# a_196_7624# VDD pfet_03v3 ad=4.16p pd=16.52u as=4.16p ps=16.52u w=16u l=2u
X177 a_n1372_556# IBIAS IBIAS VSS nfet_03v3 ad=1.04p pd=4.52u as=1.04p ps=4.52u w=4u l=1u
X178 a_n1372_556# a_n1372_556# VSS VSS nfet_03v3 ad=1.04p pd=4.52u as=1.04p ps=4.52u w=4u l=2u
X179 a_7436_n400# a_n1372_556# VSS VSS nfet_03v3 ad=1.04p pd=4.52u as=1.04p ps=4.52u w=4u l=2u
X180 a_17692_12024# a_17692_12024# a_33292_7624# VDD pfet_03v3 ad=4.16p pd=16.52u as=7.04p ps=32.88u w=16u l=1u
X181 VSS a_n1372_556# a_n1372_556# VSS nfet_03v3 ad=1.04p pd=4.52u as=1.04p ps=4.52u w=4u l=2u
X182 a_n1372_556# a_n1372_556# VSS VSS nfet_03v3 ad=1.04p pd=4.52u as=1.04p ps=4.52u w=4u l=2u
X183 IBIAS IBIAS a_n1372_556# VSS nfet_03v3 ad=1.04p pd=4.52u as=1.04p ps=4.52u w=4u l=1u
X184 VDD a_196_7624# VDD VDD pfet_03v3 ad=4.16p pd=16.52u as=0 ps=0 w=16u l=2u
X185 a_1396_12024# IBIAS a_17124_n400# VSS nfet_03v3 ad=1.04p pd=4.52u as=1.04p ps=4.52u w=4u l=1u
X186 a_17124_n400# IBIAS a_1396_12024# VSS nfet_03v3 ad=1.04p pd=4.52u as=1.04p ps=4.52u w=4u l=1u
X187 a_17124_n400# IBIAS a_1396_12024# VSS nfet_03v3 ad=1.04p pd=4.52u as=1.04p ps=4.52u w=4u l=1u
X188 a_196_7624# a_1396_12024# a_1396_12024# VDD pfet_03v3 ad=4.16p pd=16.52u as=4.16p ps=16.52u w=16u l=1u
X189 a_196_7624# a_196_7624# VDD VDD pfet_03v3 ad=4.16p pd=16.52u as=7.04p ps=32.88u w=16u l=2u
X190 VDD a_196_7624# a_196_7624# VDD pfet_03v3 ad=4.16p pd=16.52u as=4.16p ps=16.52u w=16u l=2u
X191 a_14044_4400# a_1396_12024# VGN VDD pfet_03v3 ad=4.16p pd=16.52u as=4.16p ps=16.52u w=16u l=1u
X192 a_17124_4400# a_17692_12024# IB_DIV2 VDD pfet_03v3 ad=4.16p pd=16.52u as=4.16p ps=16.52u w=16u l=1u
X193 IB_DIV2 a_17692_12024# a_17124_4400# VDD pfet_03v3 ad=4.16p pd=16.52u as=4.16p ps=16.52u w=16u l=1u
X194 VDD a_196_7624# a_196_7624# VDD pfet_03v3 ad=4.16p pd=16.52u as=4.16p ps=16.52u w=16u l=2u
X195 a_14044_4400# a_196_7624# VDD VDD pfet_03v3 ad=4.16p pd=16.52u as=7.04p ps=32.88u w=16u l=2u
X196 a_1396_12024# IBIAS a_17124_n400# VSS nfet_03v3 ad=1.04p pd=4.52u as=1.04p ps=4.52u w=4u l=1u
X197 a_1396_12024# a_1396_12024# a_196_7624# VDD pfet_03v3 ad=4.16p pd=16.52u as=4.16p ps=16.52u w=16u l=1u
X198 VSS a_n1372_556# a_17124_n400# VSS nfet_03v3 ad=1.04p pd=4.52u as=1.04p ps=4.52u w=4u l=2u
X199 a_17124_n400# a_n1372_556# VSS VSS nfet_03v3 ad=1.04p pd=4.52u as=1.04p ps=4.52u w=4u l=2u
X200 a_196_7624# a_196_7624# VDD VDD pfet_03v3 ad=4.16p pd=16.52u as=4.16p ps=16.52u w=16u l=2u
X201 a_17124_n400# a_n1372_556# VSS VSS nfet_03v3 ad=1.04p pd=4.52u as=1.04p ps=4.52u w=4u l=2u
X202 a_1396_12024# a_1396_12024# a_196_7624# VDD pfet_03v3 ad=4.16p pd=16.52u as=7.04p ps=32.88u w=16u l=1u
X203 a_196_7624# a_1396_12024# a_1396_12024# VDD pfet_03v3 ad=4.16p pd=16.52u as=4.16p ps=16.52u w=16u l=1u
X204 a_17124_n400# a_n1372_556# VSS VSS nfet_03v3 ad=1.04p pd=4.52u as=1.04p ps=4.52u w=4u l=2u
X205 VDD a_196_7624# a_196_7624# VDD pfet_03v3 ad=4.16p pd=16.52u as=4.16p ps=16.52u w=16u l=2u
X206 a_n1372_556# IBIAS IBIAS VSS nfet_03v3 ad=1.76p pd=8.88u as=1.04p ps=4.52u w=4u l=1u
X207 a_n1372_556# a_n1372_556# VSS VSS nfet_03v3 ad=1.04p pd=4.52u as=1.04p ps=4.52u w=4u l=2u
X208 a_7436_n400# a_n1372_556# VSS VSS nfet_03v3 ad=1.76p pd=8.88u as=1.04p ps=4.52u w=4u l=2u
X209 a_1396_12024# IBIAS a_17124_n400# VSS nfet_03v3 ad=1.04p pd=4.52u as=1.04p ps=4.52u w=4u l=1u
X210 a_n1372_556# a_n1372_556# VSS VSS nfet_03v3 ad=1.04p pd=4.52u as=1.04p ps=4.52u w=4u l=2u
X211 a_n1372_556# IBIAS IBIAS VSS nfet_03v3 ad=1.04p pd=4.52u as=1.04p ps=4.52u w=4u l=1u
X212 VSS a_n1372_556# a_n1372_556# VSS nfet_03v3 ad=1.76p pd=8.88u as=1.04p ps=4.52u w=4u l=2u
X213 a_196_7624# a_1396_12024# a_1396_12024# VDD pfet_03v3 ad=4.16p pd=16.52u as=4.16p ps=16.52u w=16u l=1u
X214 VGP IBIAS a_7436_n400# VSS nfet_03v3 ad=1.76p pd=8.88u as=1.04p ps=4.52u w=4u l=1u
X215 a_17124_4400# a_196_7624# VDD VDD pfet_03v3 ad=4.16p pd=16.52u as=7.04p ps=32.88u w=16u l=2u
X216 a_14044_4400# a_1396_12024# VGN VDD pfet_03v3 ad=4.16p pd=16.52u as=4.16p ps=16.52u w=16u l=1u
X217 IB_DIV2 a_17692_12024# a_17124_4400# VDD pfet_03v3 ad=4.16p pd=16.52u as=4.16p ps=16.52u w=16u l=1u
X218 IBIAS IBIAS a_n1372_556# VSS nfet_03v3 ad=1.04p pd=4.52u as=1.04p ps=4.52u w=4u l=1u
X219 a_196_7624# a_196_7624# VDD VDD pfet_03v3 ad=4.16p pd=16.52u as=4.16p ps=16.52u w=16u l=2u
X220 VDD a_196_7624# a_14044_4400# VDD pfet_03v3 ad=4.16p pd=16.52u as=4.16p ps=16.52u w=16u l=2u
X221 a_196_7624# a_1396_12024# a_1396_12024# VDD pfet_03v3 ad=4.16p pd=16.52u as=4.16p ps=16.52u w=16u l=1u
X222 a_14044_4400# a_196_7624# VDD VDD pfet_03v3 ad=4.16p pd=16.52u as=4.16p ps=16.52u w=16u l=2u
X223 IB_DIV2 a_17692_12024# a_17124_4400# VDD pfet_03v3 ad=4.16p pd=16.52u as=7.04p ps=32.88u w=16u l=1u
X224 a_17124_4400# a_17692_12024# IB_DIV2 VDD pfet_03v3 ad=7.04p pd=32.88u as=4.16p ps=16.52u w=16u l=1u
X225 VSS a_n1372_556# a_17124_n400# VSS nfet_03v3 ad=1.04p pd=4.52u as=1.04p ps=4.52u w=4u l=2u
X226 a_196_7624# a_196_7624# VDD VDD pfet_03v3 ad=4.16p pd=16.52u as=4.16p ps=16.52u w=16u l=2u
X227 a_17124_n400# a_n1372_556# VSS VSS nfet_03v3 ad=1.04p pd=4.52u as=1.04p ps=4.52u w=4u l=2u
.ends

.subckt gf180mcu_fd_sc_mcu7t5v0__fillcap_8 VDD VSS VNW VPW
X0 VDD a_572_375# a_484_472# VNW pfet_05v0 ad=0.5368p pd=3.32u as=0.5368p ps=3.32u w=1.22u l=1u
X1 a_572_375# a_484_472# VSS VPW nfet_05v0 ad=0.3608p pd=2.52u as=0.3608p ps=2.52u w=0.82u l=1u
X2 a_124_375# a_36_472# VSS VPW nfet_05v0 ad=0.3608p pd=2.52u as=0.3608p ps=2.52u w=0.82u l=1u
X3 VDD a_124_375# a_36_472# VNW pfet_05v0 ad=0.5368p pd=3.32u as=0.5368p ps=3.32u w=1.22u l=1u
.ends

.subckt gf180mcu_fd_sc_mcu7t5v0__fillcap_32 VDD VSS VNW VPW
X0 VDD a_572_375# a_484_472# VNW pfet_05v0 ad=0.5368p pd=3.32u as=0.5368p ps=3.32u w=1.22u l=1u
X1 VDD a_2364_375# a_2276_472# VNW pfet_05v0 ad=0.5368p pd=3.32u as=0.5368p ps=3.32u w=1.22u l=1u
X2 a_572_375# a_484_472# VSS VPW nfet_05v0 ad=0.3608p pd=2.52u as=0.3608p ps=2.52u w=0.82u l=1u
X3 VDD a_1916_375# a_1828_472# VNW pfet_05v0 ad=0.5368p pd=3.32u as=0.5368p ps=3.32u w=1.22u l=1u
X4 a_124_375# a_36_472# VSS VPW nfet_05v0 ad=0.3608p pd=2.52u as=0.3608p ps=2.52u w=0.82u l=1u
X5 a_1916_375# a_1828_472# VSS VPW nfet_05v0 ad=0.3608p pd=2.52u as=0.3608p ps=2.52u w=0.82u l=1u
X6 a_1468_375# a_1380_472# VSS VPW nfet_05v0 ad=0.3608p pd=2.52u as=0.3608p ps=2.52u w=0.82u l=1u
X7 a_2812_375# a_2724_472# VSS VPW nfet_05v0 ad=0.3608p pd=2.52u as=0.3608p ps=2.52u w=0.82u l=1u
X8 VDD a_3260_375# a_3172_472# VNW pfet_05v0 ad=0.5368p pd=3.32u as=0.5368p ps=3.32u w=1.22u l=1u
X9 a_2364_375# a_2276_472# VSS VPW nfet_05v0 ad=0.3608p pd=2.52u as=0.3608p ps=2.52u w=0.82u l=1u
X10 VDD a_2812_375# a_2724_472# VNW pfet_05v0 ad=0.5368p pd=3.32u as=0.5368p ps=3.32u w=1.22u l=1u
X11 a_3260_375# a_3172_472# VSS VPW nfet_05v0 ad=0.3608p pd=2.52u as=0.3608p ps=2.52u w=0.82u l=1u
X12 VDD a_1020_375# a_932_472# VNW pfet_05v0 ad=0.5368p pd=3.32u as=0.5368p ps=3.32u w=1.22u l=1u
X13 VDD a_1468_375# a_1380_472# VNW pfet_05v0 ad=0.5368p pd=3.32u as=0.5368p ps=3.32u w=1.22u l=1u
X14 VDD a_124_375# a_36_472# VNW pfet_05v0 ad=0.5368p pd=3.32u as=0.5368p ps=3.32u w=1.22u l=1u
X15 a_1020_375# a_932_472# VSS VPW nfet_05v0 ad=0.3608p pd=2.52u as=0.3608p ps=2.52u w=0.82u l=1u
.ends

.subckt gf180mcu_fd_sc_mcu7t5v0__fillcap_16 VDD VSS VNW VPW
X0 VDD a_572_375# a_484_472# VNW pfet_05v0 ad=0.5368p pd=3.32u as=0.5368p ps=3.32u w=1.22u l=1u
X1 a_572_375# a_484_472# VSS VPW nfet_05v0 ad=0.3608p pd=2.52u as=0.3608p ps=2.52u w=0.82u l=1u
X2 a_124_375# a_36_472# VSS VPW nfet_05v0 ad=0.3608p pd=2.52u as=0.3608p ps=2.52u w=0.82u l=1u
X3 a_1468_375# a_1380_472# VSS VPW nfet_05v0 ad=0.3608p pd=2.52u as=0.3608p ps=2.52u w=0.82u l=1u
X4 VDD a_1020_375# a_932_472# VNW pfet_05v0 ad=0.5368p pd=3.32u as=0.5368p ps=3.32u w=1.22u l=1u
X5 VDD a_1468_375# a_1380_472# VNW pfet_05v0 ad=0.5368p pd=3.32u as=0.5368p ps=3.32u w=1.22u l=1u
X6 VDD a_124_375# a_36_472# VNW pfet_05v0 ad=0.5368p pd=3.32u as=0.5368p ps=3.32u w=1.22u l=1u
X7 a_1020_375# a_932_472# VSS VPW nfet_05v0 ad=0.3608p pd=2.52u as=0.3608p ps=2.52u w=0.82u l=1u
.ends

.subckt gf180mcu_fd_sc_mcu7t5v0__fillcap_4 VDD VSS VNW VPW
X0 a_124_375# a_36_472# VSS VPW nfet_05v0 ad=0.3608p pd=2.52u as=0.3608p ps=2.52u w=0.82u l=1u
X1 VDD a_124_375# a_36_472# VNW pfet_05v0 ad=0.5368p pd=3.32u as=0.5368p ps=3.32u w=1.22u l=1u
.ends

.subckt gf180mcu_fd_sc_mcu7t5v0__tieh Z VDD VSS VNW VPW
X0 Z a_125_24# VDD VNW pfet_05v0 ad=0.5368p pd=3.32u as=0.5368p ps=3.32u w=1.22u l=0.5u
X1 a_125_24# a_125_24# VSS VPW nfet_05v0 ad=0.3608p pd=2.52u as=0.3608p ps=2.52u w=0.82u l=0.6u
.ends

.subckt gf180mcu_fd_sc_mcu7t5v0__inv_1 VSS ZN I VDD VNW VPW
X0 ZN I VSS VPW nfet_05v0 ad=0.3608p pd=2.52u as=0.3608p ps=2.52u w=0.82u l=0.6u
X1 ZN I VDD VNW pfet_05v0 ad=0.5368p pd=3.32u as=0.5368p ps=3.32u w=1.22u l=0.5u
.ends

.subckt gf180mcu_fd_sc_mcu7t5v0__nand2_1 VDD VSS ZN A1 A2 VNW VPW
X0 ZN A2 VDD VNW pfet_05v0 ad=0.2938p pd=1.65u as=0.4972p ps=3.14u w=1.13u l=0.5u
X1 ZN A1 a_245_68# VPW nfet_05v0 ad=0.3608p pd=2.52u as=0.1312p ps=1.14u w=0.82u l=0.6u
X2 VDD A1 ZN VNW pfet_05v0 ad=0.4972p pd=3.14u as=0.2938p ps=1.65u w=1.13u l=0.5u
X3 a_245_68# A2 VSS VPW nfet_05v0 ad=0.1312p pd=1.14u as=0.3608p ps=2.52u w=0.82u l=0.6u
.ends

.subckt gf180mcu_fd_sc_mcu7t5v0__dffrnq_1 D Q RN VSS CLK VDD VNW VPW
X0 VSS CLK a_36_151# VPW nfet_05v0 ad=0.1053p pd=0.925u as=0.1782p ps=1.69u w=0.405u l=0.6u
X1 VSS RN a_1456_156# VPW nfet_05v0 ad=0.2016p pd=1.48u as=43.2f ps=0.6u w=0.36u l=0.6u
X2 Q a_2665_112# VDD VNW pfet_05v0 ad=0.5346p pd=3.31u as=0.5346p ps=3.31u w=1.215u l=0.5u
X3 a_796_472# D VSS VPW nfet_05v0 ad=93.59999f pd=0.88u as=0.1584p ps=1.6u w=0.36u l=0.6u
X4 VSS a_2665_112# a_2560_156# VPW nfet_05v0 ad=0.1224p pd=1.04u as=94.5f ps=0.885u w=0.36u l=0.6u
X5 a_2665_112# a_2248_156# a_3041_156# VPW nfet_05v0 ad=0.176p pd=1.68u as=0.134p ps=1.1u w=0.4u l=0.6u
X6 a_1000_472# a_448_472# a_796_472# VNW pfet_05v0 ad=0.2028p pd=1.3u as=0.2028p ps=1.3u w=0.78u l=0.5u
X7 a_2248_156# a_36_151# a_1308_423# VNW pfet_05v0 ad=0.25375p pd=1.51u as=0.2424p ps=1.465u w=0.505u l=0.5u
X8 a_2248_156# a_448_472# a_1308_423# VPW nfet_05v0 ad=0.2007p pd=1.475u as=0.2007p ps=1.475u w=0.36u l=0.6u
X9 VDD CLK a_36_151# VNW pfet_05v0 ad=0.2249p pd=1.385u as=0.3806p ps=2.61u w=0.865u l=0.5u
X10 a_1456_156# a_1308_423# a_1288_156# VPW nfet_05v0 ad=43.2f pd=0.6u as=43.2f ps=0.6u w=0.36u l=0.6u
X11 a_1308_423# a_1000_472# VSS VPW nfet_05v0 ad=0.2007p pd=1.475u as=0.2016p ps=1.48u w=0.36u l=0.6u
X12 Q a_2665_112# VSS VPW nfet_05v0 ad=0.3586p pd=2.51u as=0.3586p ps=2.51u w=0.815u l=0.6u
X13 a_448_472# a_36_151# VDD VNW pfet_05v0 ad=0.3806p pd=2.61u as=0.2249p ps=1.385u w=0.865u l=0.5u
X14 a_1204_472# a_36_151# a_1000_472# VNW pfet_05v0 ad=0.2028p pd=1.3u as=0.2028p ps=1.3u w=0.78u l=0.5u
X15 a_1204_472# RN VDD VNW pfet_05v0 ad=0.3432p pd=2.44u as=0.45p ps=2.02u w=0.78u l=0.5u
X16 a_2665_112# RN VDD VNW pfet_05v0 ad=0.26p pd=1.52u as=0.29465p ps=1.74u w=1u l=0.5u
X17 a_2560_156# a_36_151# a_2248_156# VPW nfet_05v0 ad=94.5f pd=0.885u as=0.2007p ps=1.475u w=0.36u l=0.6u
X18 VDD a_2248_156# a_2665_112# VNW pfet_05v0 ad=0.44p pd=2.88u as=0.26p ps=1.52u w=1u l=0.5u
X19 a_1288_156# a_448_472# a_1000_472# VPW nfet_05v0 ad=43.2f pd=0.6u as=93.59999f ps=0.88u w=0.36u l=0.6u
X20 VDD a_1308_423# a_1204_472# VNW pfet_05v0 ad=0.45p pd=2.02u as=0.2028p ps=1.3u w=0.78u l=0.5u
X21 a_2560_156# a_448_472# a_2248_156# VNW pfet_05v0 ad=0.1313p pd=1.025u as=0.25375p ps=1.51u w=0.505u l=0.5u
X22 a_448_472# a_36_151# VSS VPW nfet_05v0 ad=0.1782p pd=1.69u as=0.1053p ps=0.925u w=0.405u l=0.6u
X23 a_3041_156# RN VSS VPW nfet_05v0 ad=0.134p pd=1.1u as=0.1224p ps=1.04u w=0.36u l=0.6u
X24 VDD a_2665_112# a_2560_156# VNW pfet_05v0 ad=0.29465p pd=1.74u as=0.1313p ps=1.025u w=0.505u l=0.5u
X25 a_1308_423# a_1000_472# VDD VNW pfet_05v0 ad=0.2424p pd=1.465u as=0.2222p ps=1.89u w=0.505u l=0.5u
X26 a_1000_472# a_36_151# a_796_472# VPW nfet_05v0 ad=93.59999f pd=0.88u as=93.59999f ps=0.88u w=0.36u l=0.6u
X27 a_796_472# D VDD VNW pfet_05v0 ad=0.2028p pd=1.3u as=0.3432p ps=2.44u w=0.78u l=0.5u
.ends
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
