Zachnad0/AUS-NZ-Track-A-RFIC-Workspace/signoff/pex/CP_v1.pex.spice

* NGSPICE file created from CP_v1_flat.ext - technology: gf180mcuD

X0 CP_OUT.t6 UPB.t11 PMID.t4 VDD.t6 pfet_03v3 ad=1.3p pd=5.52u as=2.2p ps=10.88u w=5u l=0.3u
X1 UPB.t1 UP.t0 VSS.t1 VSS.t0 nfet_03v3 ad=0.44p pd=2.88u as=0.44p ps=2.88u w=1u l=0.3u
X2 PMID.t3 UPB.t2 CP_OUT.t5 VDD.t5 pfet_03v3 ad=2.2p pd=10.88u as=1.3p ps=5.52u w=5u l=0.3u
X3 VGN.t1 VGN.t0 VSS.t7 VSS.t6 nfet_03v3 ad=1.3p pd=5.52u as=2.2p ps=10.88u w=5u l=2u
X4 VSS.t5 VGN.t4 NMID.t3 VSS.t4 nfet_03v3 ad=2.2p pd=10.88u as=1.3p ps=5.52u w=5u l=2u
X5 NMID.t2 VGN.t5 VSS.t11 VSS.t10 nfet_03v3 ad=1.3p pd=5.52u as=1.3p ps=5.52u w=5u l=2u
X6 VDD.t12 VGP.t22 PMID.t14 VDD.t11 pfet_03v3 ad=1.3p pd=5.52u as=1.3p ps=5.52u w=5u l=2u
X7 CP_OUT.t0 DOWN.t1 NMID.t0 VSS.t2 nfet_03v3 ad=1.3p pd=5.52u as=2.2p ps=10.88u w=5u l=0.3u
X8 UPB.t0 UP.t1 VDD.t1 VDD.t0 pfet_03v3 ad=0.88p pd=4.88u as=0.88p ps=4.88u w=2u l=0.3u
X9 CP_OUT.t9 UPB.t3 PMID.t17 VDD.t49 pfet_03v3 ad=1.3p pd=5.52u as=1.3p ps=5.52u w=5u l=0.3u
X10 VGP.t15 VGP.t14 VDD.t38 VDD.t37 pfet_03v3 ad=1.3p pd=5.52u as=1.3p ps=5.52u w=5u l=2u
X11 VDD.t48 VGP.t20 PMID.t16 VDD.t47 pfet_03v3 ad=2.2p pd=10.88u as=1.3p ps=5.52u w=5u l=2u
X12 VDD.t40 VGP.t8 VGP.t9 VDD.t39 pfet_03v3 ad=1.3p pd=5.52u as=1.3p ps=5.52u w=5u l=2u
X13 PMID.t11 VGP.t25 VDD.t32 VDD.t31 pfet_03v3 ad=1.3p pd=5.52u as=1.3p ps=5.52u w=5u l=2u
X14 CP_OUT.t7 UPB.t5 PMID.t5 VDD.t7 pfet_03v3 ad=1.3p pd=5.52u as=1.3p ps=5.52u w=5u l=0.3u
X15 CP_OUT.t8 UPB.t7 PMID.t6 VDD.t8 pfet_03v3 ad=1.3p pd=5.52u as=1.3p ps=5.52u w=5u l=0.3u
X16 VGP.t19 VGP.t18 VDD.t42 VDD.t41 pfet_03v3 ad=1.3p pd=5.52u as=1.3p ps=5.52u w=5u l=2u
X17 NMID.t1 DOWN.t0 CP_OUT.t1 VSS.t3 nfet_03v3 ad=2.2p pd=10.88u as=1.3p ps=5.52u w=5u l=0.3u
X18 PMID.t7 VGP.t29 VDD.t18 VDD.t17 pfet_03v3 ad=1.3p pd=5.52u as=1.3p ps=5.52u w=5u l=2u
X19 VDD.t26 VGP.t12 VGP.t13 VDD.t25 pfet_03v3 ad=1.3p pd=5.52u as=1.3p ps=5.52u w=5u l=2u
X20 VDD.t36 VGP.t24 PMID.t12 VDD.t35 pfet_03v3 ad=1.3p pd=5.52u as=1.3p ps=5.52u w=5u l=2u
X21 PMID.t13 VGP.t23 VDD.t34 VDD.t33 pfet_03v3 ad=1.3p pd=5.52u as=1.3p ps=5.52u w=5u l=2u
X22 VDD.t44 VGP.t0 VGP.t1 VDD.t43 pfet_03v3 ad=1.3p pd=5.52u as=1.3p ps=5.52u w=5u l=2u
X23 PMID.t1 UPB.t8 CP_OUT.t3 VDD.t3 pfet_03v3 ad=1.3p pd=5.52u as=1.3p ps=5.52u w=5u l=0.3u
X24 VGP.t3 VGP.t2 VDD.t24 VDD.t23 pfet_03v3 ad=1.3p pd=5.52u as=1.3p ps=5.52u w=5u l=2u
X25 PMID.t15 VGP.t21 VDD.t46 VDD.t45 pfet_03v3 ad=1.3p pd=5.52u as=1.3p ps=5.52u w=5u l=2u
X26 VGP.t17 VGP.t16 VDD.t14 VDD.t13 pfet_03v3 ad=1.3p pd=5.52u as=2.2p ps=10.88u w=5u l=2u
X27 VDD.t22 VGP.t26 PMID.t10 VDD.t21 pfet_03v3 ad=1.3p pd=5.52u as=1.3p ps=5.52u w=5u l=2u
X28 PMID.t0 UPB.t4 CP_OUT.t2 VDD.t2 pfet_03v3 ad=1.3p pd=5.52u as=1.3p ps=5.52u w=5u l=0.3u
X29 PMID.t9 VGP.t27 VDD.t20 VDD.t19 pfet_03v3 ad=1.3p pd=5.52u as=1.3p ps=5.52u w=5u l=2u
X30 VSS.t9 VGN.t2 VGN.t3 VSS.t8 nfet_03v3 ad=1.3p pd=5.52u as=1.3p ps=5.52u w=5u l=2u
X31 VGP.t7 VGP.t6 VDD.t28 VDD.t27 pfet_03v3 ad=1.3p pd=5.52u as=1.3p ps=5.52u w=5u l=2u
X32 PMID.t2 UPB.t6 CP_OUT.t4 VDD.t4 pfet_03v3 ad=1.3p pd=5.52u as=1.3p ps=5.52u w=5u l=0.3u
X33 VDD.t10 VGP.t28 PMID.t8 VDD.t9 pfet_03v3 ad=1.3p pd=5.52u as=1.3p ps=5.52u w=5u l=2u
X34 CP_OUT.t11 UPB.t9 PMID.t19 VDD.t51 pfet_03v3 ad=1.3p pd=5.52u as=1.3p ps=5.52u w=5u l=0.3u
X35 VDD.t16 VGP.t4 VGP.t5 VDD.t15 pfet_03v3 ad=1.3p pd=5.52u as=1.3p ps=5.52u w=5u l=2u
X36 PMID.t18 UPB.t10 CP_OUT.t10 VDD.t50 pfet_03v3 ad=1.3p pd=5.52u as=1.3p ps=5.52u w=5u l=0.3u
X37 VDD.t30 VGP.t10 VGP.t11 VDD.t29 pfet_03v3 ad=1.3p pd=5.52u as=1.3p ps=5.52u w=5u l=2u
C0 VGP VDD 16.6035f
C1 UP UPB 0.24901f
C2 VGN NMID 0.37389f
C3 CP_OUT UPB 0.54311f
C4 VDD UP 0.36021f
C5 DOWN NMID 0.32144f
C6 PMID UPB 1.2257f
C7 VGP CP_OUT 0
C8 DOWN CP_OUT 0.1373f
C9 VDD CP_OUT 0.61007f
C10 VGP PMID 2.9199f
C11 VDD PMID 3.79735f
C12 UP CP_OUT 0.00402f
C13 CP_OUT NMID 1.36525f
C14 PMID UP 0.00886f
C15 PMID CP_OUT 4.10912f
C16 VGP UPB 0.00493f
C17 VDD UPB 1.94979f
R0 DOWN.n0 DOWN.t0 77.7629
R1 DOWN.n0 DOWN.t1 63.5105
R2 DOWN DOWN.n0 40.6694
R3 VGN.n3 VGN.n2 56.6383
R4 VGN.n0 VGN.t4 45.7108
R5 VGN.n1 VGN.n0 36.5858
R6 VGN.n2 VGN.n1 36.5858
R7 VGN.n0 VGN.t5 9.1255
R8 VGN.n1 VGN.t2 9.1255
R9 VGN.n2 VGN.t0 9.1255
R10 VGN VGN.n4 6.99311
R11 VGN VGN.n3 1.3055
R12 VGN.n4 VGN.t3 0.3281
R13 VGN.n4 VGN.t1 0.3281
R14 VGN.n3 VGN 0.0647857
R15 UP.n0 UP.t1 52.426
R16 UP.n1 UP.t0 52.381
R17 UP.n2 UP.n0 5.65121
R18 UP.n0 UP 3.84264
R19 UP UP.n2 0.113
R20 UP.n2 UP.n1 0.0455
R21 UP.n1 UP 0.0305
R22 CP_OUT CP_OUT.n8 11.8709
R23 CP_OUT CP_OUT.n10 11.8709
R24 CP_OUT.n2 CP_OUT.n0 6.78025
R25 CP_OUT.n10 CP_OUT.n9 6.36311
R26 CP_OUT.n5 CP_OUT.n4 6.25311
R27 CP_OUT.n7 CP_OUT.n6 6.25311
R28 CP_OUT.n8 CP_OUT.n3 6.25311
R29 CP_OUT.n2 CP_OUT.n1 6.25311
R30 CP_OUT.n8 CP_OUT.n2 0.527643
R31 CP_OUT.n8 CP_OUT.n7 0.527643
R32 CP_OUT.n7 CP_OUT.n5 0.527643
R33 CP_OUT.n4 CP_OUT.t10 0.3645
R34 CP_OUT.n4 CP_OUT.t6 0.3645
R35 CP_OUT.n6 CP_OUT.t3 0.3645
R36 CP_OUT.n6 CP_OUT.t11 0.3645
R37 CP_OUT.n3 CP_OUT.t4 0.3645
R38 CP_OUT.n3 CP_OUT.t8 0.3645
R39 CP_OUT.n1 CP_OUT.t2 0.3645
R40 CP_OUT.n1 CP_OUT.t7 0.3645
R41 CP_OUT.n0 CP_OUT.t5 0.3645
R42 CP_OUT.n0 CP_OUT.t9 0.3645
R43 CP_OUT.n9 CP_OUT.t1 0.3281
R44 CP_OUT.n9 CP_OUT.t0 0.3281
R45 CP_OUT.n10 CP_OUT 0.103357
R46 CP_OUT.n5 CP_OUT 0.0647857
R47 VGP.n19 VGP.n18 58.2026
R48 VGP.n0 VGP.t20 45.7108
R49 VGP.n1 VGP.n0 36.5858
R50 VGP.n2 VGP.n1 36.5858
R51 VGP.n3 VGP.n2 36.5858
R52 VGP.n4 VGP.n3 36.5858
R53 VGP.n5 VGP.n4 36.5858
R54 VGP.n6 VGP.n5 36.5858
R55 VGP.n7 VGP.n6 36.5858
R56 VGP.n8 VGP.n7 36.5858
R57 VGP.n9 VGP.n8 36.5858
R58 VGP.n10 VGP.n9 36.5858
R59 VGP.n11 VGP.n10 36.5858
R60 VGP.n12 VGP.n11 36.5858
R61 VGP.n13 VGP.n12 36.5858
R62 VGP.n14 VGP.n13 36.5858
R63 VGP.n15 VGP.n14 36.5858
R64 VGP.n16 VGP.n15 36.5858
R65 VGP.n17 VGP.n16 36.5858
R66 VGP.n18 VGP.n17 36.5858
R67 VGP.n0 VGP.t21 9.1255
R68 VGP.n1 VGP.t0 9.1255
R69 VGP.n2 VGP.t18 9.1255
R70 VGP.n3 VGP.t8 9.1255
R71 VGP.n4 VGP.t14 9.1255
R72 VGP.n5 VGP.t22 9.1255
R73 VGP.n6 VGP.t23 9.1255
R74 VGP.n7 VGP.t24 9.1255
R75 VGP.n8 VGP.t25 9.1255
R76 VGP.n9 VGP.t10 9.1255
R77 VGP.n10 VGP.t6 9.1255
R78 VGP.n11 VGP.t12 9.1255
R79 VGP.n12 VGP.t2 9.1255
R80 VGP.n13 VGP.t26 9.1255
R81 VGP.n14 VGP.t27 9.1255
R82 VGP.n15 VGP.t28 9.1255
R83 VGP.n16 VGP.t29 9.1255
R84 VGP.n17 VGP.t4 9.1255
R85 VGP.n18 VGP.t16 9.1255
R86 VGP.n22 VGP.n20 7.87311
R87 VGP.n28 VGP.n27 6.25311
R88 VGP.n26 VGP.n25 6.25311
R89 VGP.n24 VGP.n23 6.25311
R90 VGP.n22 VGP.n21 6.25311
R91 VGP.n24 VGP.n22 4.8605
R92 VGP.n28 VGP.n26 4.8605
R93 VGP VGP.n28 2.61371
R94 VGP VGP.n19 1.3055
R95 VGP.n26 VGP 0.976036
R96 VGP VGP.n24 0.644964
R97 VGP.n27 VGP.t5 0.3645
R98 VGP.n27 VGP.t17 0.3645
R99 VGP.n25 VGP.t13 0.3645
R100 VGP.n25 VGP.t3 0.3645
R101 VGP.n23 VGP.t11 0.3645
R102 VGP.n23 VGP.t7 0.3645
R103 VGP.n21 VGP.t9 0.3645
R104 VGP.n21 VGP.t15 0.3645
R105 VGP.n20 VGP.t1 0.3645
R106 VGP.n20 VGP.t19 0.3645
R107 VGP.n19 VGP 0.0647857
R108 VDD.t5 VDD.t0 985.938
R109 VDD.n0 VDD.t6 759.375
R110 VDD.t47 VDD.t45 393.75
R111 VDD.t45 VDD.t43 393.75
R112 VDD.t43 VDD.t41 393.75
R113 VDD.t41 VDD.t39 393.75
R114 VDD.t39 VDD.t37 393.75
R115 VDD.t37 VDD.t11 393.75
R116 VDD.t11 VDD.t33 393.75
R117 VDD.t33 VDD.t35 393.75
R118 VDD.t35 VDD.t31 393.75
R119 VDD.t31 VDD.t29 393.75
R120 VDD.t29 VDD.t27 393.75
R121 VDD.t27 VDD.t25 393.75
R122 VDD.t25 VDD.t23 393.75
R123 VDD.t23 VDD.t21 393.75
R124 VDD.t21 VDD.t19 393.75
R125 VDD.t19 VDD.t9 393.75
R126 VDD.t9 VDD.t17 393.75
R127 VDD.t17 VDD.t15 393.75
R128 VDD.t15 VDD.t13 393.75
R129 VDD.n0 VDD.t47 392.188
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
C258 VGN.n3 VSS 0.03482f $ **FLOATING
C259 VGN.t3 VSS 0.00436f $ **FLOATING
C260 VGN.t1 VSS 0.00436f $ **FLOATING
C261 VGN.n4 VSS 0.01815f $ **FLOATING
C262 DOWN.t1 VSS 0.08224f $ **FLOATING
C263 DOWN.t0 VSS 0.09255f $ **FLOATING
C264 DOWN.n0 VSS 0.13333f $ **FLOATING
