Zachnad0/AUS-NZ-Track-A-RFIC-Workspace/team_src/magic/ib_inv2_golden.spice

.subckt ib_inv2 IN OUT VDD VSS
XM_P OUT IN VDD VDD pfet_03v3 L=0.3u W=26u nf=1 m=1
XM_N OUT IN VSS VSS nfet_03v3 L=0.3u W=11u nf=1 m=1
.ends ib_inv2
