Zachnad0/AUS-NZ-Track-A-RFIC-Workspace/team_src/magic/res1k_golden.spice

.subckt res1k A B VSS
X0 A B VSS ppolyf_u_1k r_width=2u r_length=2u
.ends res1k
