Zachnad0/AUS-NZ-Track-A-RFIC-Workspace/team_src/magic/ib_n24_golden.spice

.subckt ib_n24 S D G
XMT D G S S nfet_03v3 L=2u W=4u nf=1 m=24
.ends ib_n24
