Zachnad0/AUS-NZ-Track-A-RFIC-Workspace/team_src/sim/ibias/ibias_compliance.spice

* ibias_gen_v1 output compliance -- force each output node, sweep 0..3.3V,
* measure the branch current. Flat region = compliance window (cf CP 0.32-3.00V).
.include /foss/pdks/gf180mcuD/libs.tech/ngspice/design.ngspice
.lib /foss/pdks/gf180mcuD/libs.tech/ngspice/sm141064.ngspice typical
.include ibias_sub.spice

V_VDD VDD 0 3.3
I_BIAS VDD IBIAS 240u
X1 IBIAS VGP VGN IB_DIV2 VDD 0 ibias_gen_v1

* forcing sources on the three outputs (held at nominal except the swept one)
Vf_vgp VGP 0 2.4
Vf_vgn VGN 0 0.7
Vf_ibd IB_DIV2 0 0.9

.control
dc Vf_vgp 0 3.3 0.0165
wrdata comp_vgp.dat i(vf_vgp)
reset
dc Vf_vgn 0 3.3 0.0165
wrdata comp_vgn.dat i(vf_vgn)
reset
dc Vf_ibd 0 3.3 0.0165
wrdata comp_ibd.dat i(vf_ibd)
.endc
.end
