Zachnad0/AUS-NZ-Track-A-RFIC-Workspace/signoff/sim/vco/pex200.spice

** sch_path: /foss/designs/AUS-NZ-integration/team_src/xschem/vco_tb.sch
**.subckt vco_tb
R1 out_p out_n 50
V1 vdd GND 3.3
.save i(v1)
x1 vdd net1 net2 GND tune vss vco_v1
V2 tune GND 2.0
.save i(v2)
XM2 vsg vsg GND GND nfet_03v3 L=0.28u W=100u nf=1 ad='int((nf+1)/2) * W/nf * 0.18u' as='int((nf+2)/2) * W/nf * 0.18u' pd='2*int((nf+1)/2) * (W/nf + 0.18u)'
+ ps='2*int((nf+2)/2) * (W/nf + 0.18u)' nrd='0.18u / W' nrs='0.18u / W' sa=0 sb=0 sd=0 m=4
XM1 net3 vsg GND GND nfet_03v3 L=0.28u W=100u nf=1 ad='int((nf+1)/2) * W/nf * 0.18u' as='int((nf+2)/2) * W/nf * 0.18u' pd='2*int((nf+1)/2) * (W/nf + 0.18u)'
+ ps='2*int((nf+2)/2) * (W/nf + 0.18u)' nrd='0.18u / W' nrs='0.18u / W' sa=0 sb=0 sd=0 m=4
Viss_meas vss net3 0
.save i(viss_meas)
I0 GND vsg 1m
XM3 vdd net2 out_n out_n nfet_03v3 L=0.28u W=50u nf=1 ad='int((nf+1)/2) * W/nf * 0.18u' as='int((nf+2)/2) * W/nf * 0.18u' pd='2*int((nf+1)/2) * (W/nf + 0.18u)'
+ ps='2*int((nf+2)/2) * (W/nf + 0.18u)' nrd='0.18u / W' nrs='0.18u / W' sa=0 sb=0 sd=0 m=4
XM4 out_n vsg GND GND nfet_03v3 L=0.28u W=100u nf=1 ad='int((nf+1)/2) * W/nf * 0.18u' as='int((nf+2)/2) * W/nf * 0.18u' pd='2*int((nf+1)/2) * (W/nf + 0.18u)'
+ ps='2*int((nf+2)/2) * (W/nf + 0.18u)' nrd='0.18u / W' nrs='0.18u / W' sa=0 sb=0 sd=0 m=4
XM5 vdd net1 out_p out_p nfet_03v3 L=0.28u W=50u nf=1 ad='int((nf+1)/2) * W/nf * 0.18u' as='int((nf+2)/2) * W/nf * 0.18u' pd='2*int((nf+1)/2) * (W/nf + 0.18u)'
+ ps='2*int((nf+2)/2) * (W/nf + 0.18u)' nrd='0.18u / W' nrs='0.18u / W' sa=0 sb=0 sd=0 m=4
XM6 out_p vsg GND GND nfet_03v3 L=0.28u W=100u nf=1 ad='int((nf+1)/2) * W/nf * 0.18u' as='int((nf+2)/2) * W/nf * 0.18u' pd='2*int((nf+1)/2) * (W/nf + 0.18u)'
+ ps='2*int((nf+2)/2) * (W/nf + 0.18u)' nrd='0.18u / W' nrs='0.18u / W' sa=0 sb=0 sd=0 m=4
.ic v(net1)=0.01 v(net2)=-0.01
**** begin user architecture code


*.option keepopinfo
.option reltol=1e-5
.option method=gear
.option numparam jobs=4
.option bypass=0

.control
save all
set num_threads=2
tran 5p 200n uic
wrdata r_final.dat v(net1) v(net2) v(out_p) v(out_n) i(v1) i(viss_meas)
.endc




.include /foss/pdks/gf180mcuD/libs.tech/ngspice/design.ngspice
.lib /foss/pdks/gf180mcuD/libs.tech/ngspice/sm141064.ngspice typical
.lib /foss/pdks/gf180mcuD/libs.tech/ngspice/sm141064.ngspice res_typical
.lib /foss/pdks/gf180mcuD/libs.tech/ngspice/sm141064.ngspice moscap_typical


**** end user architecture code
**.ends

* expanding   symbol:  vco_v1.sym # of pins=6
** sym_path: /foss/designs/AUS-NZ-integration/team_src/xschem/vco_v1.sym
** sch_path: /foss/designs/AUS-NZ-integration/team_src/xschem/vco_v1.sch
* ---- DUT: signoff/pex/vco_v1/vco_v1.pex.spice (R+C extracted) with the coil's
* ---- R/C-only representation swapped for the lumped model that carries the L.
.subckt vco_v1 VDD OUT_p OUT_n GND TUNE ISS
V_vsubs vco_inductor_v2_0/VSUBS GND 0
X_ind OUT_p OUT_n GND vco_inductor_v2
X0 vco_tune_r_0/TUNE.t0 vco_tune_r_0/cap_bias.t0 vco_tune_r_0/GND.t0 ppolyf_u_1k r_width=1u r_length=15u
X1 vco_varactors_0/cap_bias.t41 vco_varactors_0/OUT_n.t0 cap_nmos_03v3_b c_width=5u c_length=5u
X2 vco_varactors_0/cap_bias.t19 vco_varactors_0/OUT_p.t10 cap_nmos_03v3_b c_width=5u c_length=5u
X3 vco_varactors_0/cap_bias.t18 vco_varactors_0/OUT_p.t11 cap_nmos_03v3_b c_width=5u c_length=5u
X4 vco_varactors_0/cap_bias.t3 vco_varactors_0/OUT_n.t20 cap_nmos_03v3_b c_width=5u c_length=5u
X5 vco_varactors_0/cap_bias.t34 vco_varactors_0/OUT_n.t4 cap_nmos_03v3_b c_width=5u c_length=5u
X6 vco_varactors_0/cap_bias.t33 vco_varactors_0/OUT_n.t5 cap_nmos_03v3_b c_width=5u c_length=5u
X7 vco_varactors_0/cap_bias.t20 vco_varactors_0/OUT_p.t9 cap_nmos_03v3_b c_width=5u c_length=5u
X8 vco_varactors_0/cap_bias.t29 vco_varactors_0/OUT_n.t6 cap_nmos_03v3_b c_width=5u c_length=5u
X9 vco_varactors_0/cap_bias.t6 vco_varactors_0/OUT_p.t17 cap_nmos_03v3_b c_width=5u c_length=5u
X10 vco_varactors_0/cap_bias.t22 vco_varactors_0/OUT_n.t10 cap_nmos_03v3_b c_width=5u c_length=5u
X11 vco_varactors_0/cap_bias.t21 vco_varactors_0/OUT_n.t11 cap_nmos_03v3_b c_width=5u c_length=5u
X12 vco_varactors_0/cap_bias.t8 vco_varactors_0/OUT_p.t15 cap_nmos_03v3_b c_width=5u c_length=5u
X13 vco_varactors_0/cap_bias.t7 vco_varactors_0/OUT_p.t16 cap_nmos_03v3_b c_width=5u c_length=5u
X14 vco_varactors_0/cap_bias.t17 vco_varactors_0/OUT_n.t12 cap_nmos_03v3_b c_width=5u c_length=5u
X15 vco_varactors_0/cap_bias.t9 vco_varactors_0/OUT_n.t17 cap_nmos_03v3_b c_width=5u c_length=5u
X16 vco_varactors_0/cap_bias.t5 vco_varactors_0/OUT_n.t18 cap_nmos_03v3_b c_width=5u c_length=5u
X17 vco_varactors_0/cap_bias.t0 vco_varactors_0/OUT_p.t20 cap_nmos_03v3_b c_width=5u c_length=5u
X18 vco_varactors_0/cap_bias.t10 vco_varactors_0/OUT_n.t16 cap_nmos_03v3_b c_width=5u c_length=5u
X19 vco_varactors_0/cap_bias.t4 vco_varactors_0/OUT_n.t19 cap_nmos_03v3_b c_width=5u c_length=5u
X20 vco_varactors_0/cap_bias.t38 vco_varactors_0/OUT_p.t0 cap_nmos_03v3_b c_width=5u c_length=5u
X21 vco_varactors_0/cap_bias.t37 vco_varactors_0/OUT_p.t1 cap_nmos_03v3_b c_width=5u c_length=5u
X22 vco_varactors_0/cap_bias.t36 vco_varactors_0/OUT_p.t2 cap_nmos_03v3_b c_width=5u c_length=5u
X23 vco_varactors_0/cap_bias.t25 vco_varactors_0/OUT_p.t7 cap_nmos_03v3_b c_width=5u c_length=5u
X24 vco_varactors_0/cap_bias.t24 vco_varactors_0/OUT_p.t8 cap_nmos_03v3_b c_width=5u c_length=5u
X25 vco_varactors_0/cap_bias.t1 vco_varactors_0/OUT_p.t19 cap_nmos_03v3_b c_width=5u c_length=5u
X26 vco_varactors_0/cap_bias.t40 vco_varactors_0/OUT_n.t1 cap_nmos_03v3_b c_width=5u c_length=5u
X27 vco_varactors_0/cap_bias.t39 vco_varactors_0/OUT_n.t2 cap_nmos_03v3_b c_width=5u c_length=5u
X28 vco_varactors_0/cap_bias.t35 vco_varactors_0/OUT_n.t3 cap_nmos_03v3_b c_width=5u c_length=5u
X29 vco_varactors_0/cap_bias.t26 vco_varactors_0/OUT_p.t6 cap_nmos_03v3_b c_width=5u c_length=5u
X30 vco_varactors_0/cap_bias.t12 vco_varactors_0/OUT_p.t14 cap_nmos_03v3_b c_width=5u c_length=5u
X31 vco_varactors_0/cap_bias.t27 vco_varactors_0/OUT_n.t8 cap_nmos_03v3_b c_width=5u c_length=5u
X32 vco_varactors_0/cap_bias.t23 vco_varactors_0/OUT_n.t9 cap_nmos_03v3_b c_width=5u c_length=5u
X33 vco_varactors_0/cap_bias.t14 vco_varactors_0/OUT_p.t12 cap_nmos_03v3_b c_width=5u c_length=5u
X34 vco_varactors_0/cap_bias.t13 vco_varactors_0/OUT_p.t13 cap_nmos_03v3_b c_width=5u c_length=5u
X35 vco_varactors_0/cap_bias.t28 vco_varactors_0/OUT_n.t7 cap_nmos_03v3_b c_width=5u c_length=5u
X36 vco_varactors_0/cap_bias.t16 vco_varactors_0/OUT_n.t13 cap_nmos_03v3_b c_width=5u c_length=5u
X37 vco_varactors_0/cap_bias.t15 vco_varactors_0/OUT_n.t14 cap_nmos_03v3_b c_width=5u c_length=5u
X38 vco_varactors_0/cap_bias.t11 vco_varactors_0/OUT_n.t15 cap_nmos_03v3_b c_width=5u c_length=5u
X39 vco_varactors_0/cap_bias.t2 vco_varactors_0/OUT_p.t18 cap_nmos_03v3_b c_width=5u c_length=5u
X40 vco_varactors_0/cap_bias.t32 vco_varactors_0/OUT_p.t3 cap_nmos_03v3_b c_width=5u c_length=5u
X41 vco_varactors_0/cap_bias.t31 vco_varactors_0/OUT_p.t4 cap_nmos_03v3_b c_width=5u c_length=5u
X42 vco_varactors_0/cap_bias.t30 vco_varactors_0/OUT_p.t5 cap_nmos_03v3_b c_width=5u c_length=5u
X45 vco_core_0/OUT_n.t5 vco_core_0/OUT_p.t24 vco_core_0/ISS.t12 vco_core_0/GND.t10 nfet_03v3 ad=1.04p pd=4.52u as=1.76p ps=8.88u w=4u l=0.28u
X46 vco_core_0/ISS.t15 vco_core_0/OUT_p.t17 vco_core_0/OUT_n.t12 vco_core_0/GND.t17 nfet_03v3 ad=1.04p pd=4.52u as=1.04p ps=4.52u w=4u l=0.28u
X47 vco_core_0/OUT_p.t9 vco_core_0/OUT_n.t29 vco_core_0/VDD.t1 vco_core_0/VDD.t0 pfet_03v3 ad=3.64p pd=14.52u as=6.16p ps=28.88u w=14u l=0.28u
X48 vco_core_0/OUT_n.t11 vco_core_0/OUT_p.t18 vco_core_0/ISS.t7 vco_core_0/GND.t16 nfet_03v3 ad=1.04p pd=4.52u as=1.04p ps=4.52u w=4u l=0.28u
X49 vco_core_0/OUT_p.t0 vco_core_0/OUT_n.t25 vco_core_0/VDD.t9 vco_core_0/VDD.t8 pfet_03v3 ad=6.16p pd=28.88u as=3.64p ps=14.52u w=14u l=0.28u
X50 vco_core_0/OUT_p.t11 vco_core_0/OUT_n.t27 vco_core_0/VDD.t5 vco_core_0/VDD.t4 pfet_03v3 ad=3.64p pd=14.52u as=3.64p ps=14.52u w=14u l=0.28u
X51 vco_core_0/VDD.t7 vco_core_0/OUT_n.t26 vco_core_0/OUT_p.t5 vco_core_0/VDD.t6 pfet_03v3 ad=3.64p pd=14.52u as=3.64p ps=14.52u w=14u l=0.28u
X52 vco_core_0/OUT_p.t14 vco_core_0/OUT_n.t24 vco_core_0/ISS.t18 vco_core_0/GND.t0 nfet_03v3 ad=1.04p pd=4.52u as=1.76p ps=8.88u w=4u l=0.28u
X53 vco_core_0/OUT_n.t9 vco_core_0/OUT_p.t20 vco_core_0/ISS.t8 vco_core_0/GND.t14 nfet_03v3 ad=1.04p pd=4.52u as=1.04p ps=4.52u w=4u l=0.28u
X54 vco_core_0/ISS.t16 vco_core_0/OUT_n.t15 vco_core_0/OUT_p.t12 vco_core_0/GND.t9 nfet_03v3 ad=1.76p pd=8.88u as=1.04p ps=4.52u w=4u l=0.28u
X55 vco_core_0/VDD.t3 vco_core_0/OUT_n.t28 vco_core_0/OUT_p.t7 vco_core_0/VDD.t2 pfet_03v3 ad=3.64p pd=14.52u as=3.64p ps=14.52u w=14u l=0.28u
X56 vco_core_0/ISS.t3 vco_core_0/OUT_p.t21 vco_core_0/OUT_n.t8 vco_core_0/GND.t13 nfet_03v3 ad=1.04p pd=4.52u as=1.04p ps=4.52u w=4u l=0.28u
X57 vco_core_0/ISS.t9 vco_core_0/OUT_p.t19 vco_core_0/OUT_n.t10 vco_core_0/GND.t15 nfet_03v3 ad=1.04p pd=4.52u as=1.04p ps=4.52u w=4u l=0.28u
X58 vco_core_0/OUT_p.t13 vco_core_0/OUT_n.t16 vco_core_0/ISS.t17 vco_core_0/GND.t8 nfet_03v3 ad=1.04p pd=4.52u as=1.04p ps=4.52u w=4u l=0.28u
X59 vco_core_0/OUT_n.t3 vco_core_0/OUT_p.t27 vco_core_0/VDD.t15 vco_core_0/VDD.t14 pfet_03v3 ad=3.64p pd=14.52u as=3.64p ps=14.52u w=14u l=0.28u
X60 vco_core_0/ISS.t1 vco_core_0/OUT_n.t23 vco_core_0/OUT_p.t1 vco_core_0/GND.t1 nfet_03v3 ad=1.04p pd=4.52u as=1.04p ps=4.52u w=4u l=0.28u
X61 vco_core_0/OUT_n.t4 vco_core_0/OUT_p.t25 vco_core_0/VDD.t19 vco_core_0/VDD.t18 pfet_03v3 ad=6.16p pd=28.88u as=3.64p ps=14.52u w=14u l=0.28u
X62 vco_core_0/OUT_p.t10 vco_core_0/OUT_n.t22 vco_core_0/ISS.t13 vco_core_0/GND.t2 nfet_03v3 ad=1.04p pd=4.52u as=1.04p ps=4.52u w=4u l=0.28u
X63 vco_core_0/VDD.t13 vco_core_0/OUT_p.t28 vco_core_0/OUT_n.t1 vco_core_0/VDD.t12 pfet_03v3 ad=3.64p pd=14.52u as=3.64p ps=14.52u w=14u l=0.28u
X64 vco_core_0/VDD.t17 vco_core_0/OUT_p.t26 vco_core_0/OUT_n.t0 vco_core_0/VDD.t16 pfet_03v3 ad=3.64p pd=14.52u as=3.64p ps=14.52u w=14u l=0.28u
X65 vco_core_0/OUT_n.t7 vco_core_0/OUT_p.t22 vco_core_0/ISS.t4 vco_core_0/GND.t12 nfet_03v3 ad=1.04p pd=4.52u as=1.04p ps=4.52u w=4u l=0.28u
X66 vco_core_0/ISS.t6 vco_core_0/OUT_n.t19 vco_core_0/OUT_p.t4 vco_core_0/GND.t5 nfet_03v3 ad=1.04p pd=4.52u as=1.04p ps=4.52u w=4u l=0.28u
X67 vco_core_0/ISS.t11 vco_core_0/OUT_n.t17 vco_core_0/OUT_p.t8 vco_core_0/GND.t7 nfet_03v3 ad=1.04p pd=4.52u as=1.04p ps=4.52u w=4u l=0.28u
X68 vco_core_0/ISS.t19 vco_core_0/OUT_p.t23 vco_core_0/OUT_n.t6 vco_core_0/GND.t11 nfet_03v3 ad=1.04p pd=4.52u as=1.04p ps=4.52u w=4u l=0.28u
X69 vco_core_0/OUT_p.t3 vco_core_0/OUT_n.t18 vco_core_0/ISS.t5 vco_core_0/GND.t6 nfet_03v3 ad=1.04p pd=4.52u as=1.04p ps=4.52u w=4u l=0.28u
X70 vco_core_0/ISS.t0 vco_core_0/OUT_p.t15 vco_core_0/OUT_n.t14 vco_core_0/GND.t19 nfet_03v3 ad=1.76p pd=8.88u as=1.04p ps=4.52u w=4u l=0.28u
X71 vco_core_0/OUT_n.t13 vco_core_0/OUT_p.t16 vco_core_0/ISS.t14 vco_core_0/GND.t18 nfet_03v3 ad=1.04p pd=4.52u as=1.04p ps=4.52u w=4u l=0.28u
X72 vco_core_0/ISS.t2 vco_core_0/OUT_n.t21 vco_core_0/OUT_p.t2 vco_core_0/GND.t3 nfet_03v3 ad=1.04p pd=4.52u as=1.04p ps=4.52u w=4u l=0.28u
X73 vco_core_0/OUT_n.t2 vco_core_0/OUT_p.t29 vco_core_0/VDD.t11 vco_core_0/VDD.t10 pfet_03v3 ad=3.64p pd=14.52u as=6.16p ps=28.88u w=14u l=0.28u
X74 vco_core_0/OUT_p.t6 vco_core_0/OUT_n.t20 vco_core_0/ISS.t10 vco_core_0/GND.t4 nfet_03v3 ad=1.04p pd=4.52u as=1.04p ps=4.52u w=4u l=0.28u
C0 VDD OUT_n 10.00115f
C1 ISS OUT_p 4.02678f
C2 vco_tune_r_0/cap_bias OUT_n 39.83544f
C5 VDD OUT_p 10.13264f
C6 TUNE OUT_p 0.00194f
C7 VDD ISS 0
C8 vco_tune_r_0/cap_bias OUT_p 40.13977f
C9 ISS vco_tune_r_0/cap_bias 0.02028f
C10 OUT_p vco_inductor_v2_0/GND 0.19984f
C11 OUT_p OUT_n 10.73769f
C12 ISS OUT_n 4.07113f
R0 vco_tune_r_0/cap_bias vco_tune_r_0/cap_bias.t0 7.20993
R1 TUNE vco_tune_r_0/TUNE.t0 7.20993
R2 GND vco_tune_r_0/GND.t0 122.831
R3 vco_varactors_0/cap_bias.n95 vco_varactors_0/cap_bias.t40 9.3593
R4 vco_varactors_0/cap_bias.t40 vco_varactors_0/cap_bias.n13 9.3593
R5 vco_varactors_0/cap_bias.n86 vco_varactors_0/cap_bias.t39 9.3593
R6 vco_varactors_0/cap_bias.t39 vco_varactors_0/cap_bias.n24 9.3593
R7 vco_varactors_0/cap_bias.n77 vco_varactors_0/cap_bias.t38 9.3593
R8 vco_varactors_0/cap_bias.t38 vco_varactors_0/cap_bias.n35 9.3593
R9 vco_varactors_0/cap_bias.n68 vco_varactors_0/cap_bias.t37 9.3593
R10 vco_varactors_0/cap_bias.t37 vco_varactors_0/cap_bias.n46 9.3593
R11 vco_varactors_0/cap_bias.n110 vco_varactors_0/cap_bias.t41 9.3593
R12 vco_varactors_0/cap_bias.t41 vco_varactors_0/cap_bias.n109 9.3593
R13 vco_varactors_0/cap_bias.n58 vco_varactors_0/cap_bias.t36 9.3593
R14 vco_varactors_0/cap_bias.t36 vco_varactors_0/cap_bias.n57 9.3593
R15 vco_varactors_0/cap_bias.n8 vco_varactors_0/cap_bias.t4 5.13283
R16 vco_varactors_0/cap_bias.n19 vco_varactors_0/cap_bias.t3 5.13283
R17 vco_varactors_0/cap_bias.n30 vco_varactors_0/cap_bias.t2 5.13283
R18 vco_varactors_0/cap_bias.n41 vco_varactors_0/cap_bias.t1 5.13283
R19 vco_varactors_0/cap_bias.n104 vco_varactors_0/cap_bias.t5 5.13283
R20 vco_varactors_0/cap_bias.n52 vco_varactors_0/cap_bias.t0 5.13283
R21 vco_varactors_0/cap_bias.n12 vco_varactors_0/cap_bias.t34 4.57842
R22 vco_varactors_0/cap_bias.n11 vco_varactors_0/cap_bias.t28 4.57842
R23 vco_varactors_0/cap_bias.n10 vco_varactors_0/cap_bias.t22 4.57842
R24 vco_varactors_0/cap_bias.n9 vco_varactors_0/cap_bias.t16 4.57842
R25 vco_varactors_0/cap_bias.n8 vco_varactors_0/cap_bias.t10 4.57842
R26 vco_varactors_0/cap_bias.n23 vco_varactors_0/cap_bias.t33 4.57842
R27 vco_varactors_0/cap_bias.n22 vco_varactors_0/cap_bias.t27 4.57842
R28 vco_varactors_0/cap_bias.n21 vco_varactors_0/cap_bias.t21 4.57842
R29 vco_varactors_0/cap_bias.n20 vco_varactors_0/cap_bias.t15 4.57842
R30 vco_varactors_0/cap_bias.n19 vco_varactors_0/cap_bias.t9 4.57842
R31 vco_varactors_0/cap_bias.n34 vco_varactors_0/cap_bias.t32 4.57842
R32 vco_varactors_0/cap_bias.n33 vco_varactors_0/cap_bias.t26 4.57842
R33 vco_varactors_0/cap_bias.n32 vco_varactors_0/cap_bias.t20 4.57842
R34 vco_varactors_0/cap_bias.n31 vco_varactors_0/cap_bias.t14 4.57842
R35 vco_varactors_0/cap_bias.n30 vco_varactors_0/cap_bias.t8 4.57842
R36 vco_varactors_0/cap_bias.n45 vco_varactors_0/cap_bias.t31 4.57842
R37 vco_varactors_0/cap_bias.n44 vco_varactors_0/cap_bias.t25 4.57842
R38 vco_varactors_0/cap_bias.n43 vco_varactors_0/cap_bias.t19 4.57842
R39 vco_varactors_0/cap_bias.n42 vco_varactors_0/cap_bias.t13 4.57842
R40 vco_varactors_0/cap_bias.n41 vco_varactors_0/cap_bias.t7 4.57842
R41 vco_varactors_0/cap_bias.n108 vco_varactors_0/cap_bias.t35 4.57842
R42 vco_varactors_0/cap_bias.n107 vco_varactors_0/cap_bias.t29 4.57842
R43 vco_varactors_0/cap_bias.n106 vco_varactors_0/cap_bias.t23 4.57842
R44 vco_varactors_0/cap_bias.n105 vco_varactors_0/cap_bias.t17 4.57842
R45 vco_varactors_0/cap_bias.n104 vco_varactors_0/cap_bias.t11 4.57842
R46 vco_varactors_0/cap_bias.n56 vco_varactors_0/cap_bias.t30 4.57842
R47 vco_varactors_0/cap_bias.n55 vco_varactors_0/cap_bias.t24 4.57842
R48 vco_varactors_0/cap_bias.n54 vco_varactors_0/cap_bias.t18 4.57842
R49 vco_varactors_0/cap_bias.n53 vco_varactors_0/cap_bias.t12 4.57842
R50 vco_varactors_0/cap_bias.n52 vco_varactors_0/cap_bias.t6 4.57842
R51 vco_varactors_0/cap_bias.n65 vco_varactors_0/cap_bias.n50 4.5005
R52 vco_varactors_0/cap_bias.n65 vco_varactors_0/cap_bias.n48 4.5005
R53 vco_varactors_0/cap_bias.n65 vco_varactors_0/cap_bias.n64 4.5005
R54 vco_varactors_0/cap_bias.n64 vco_varactors_0/cap_bias.n63 4.5005
R55 vco_varactors_0/cap_bias.n74 vco_varactors_0/cap_bias.n39 4.5005
R56 vco_varactors_0/cap_bias.n74 vco_varactors_0/cap_bias.n37 4.5005
R57 vco_varactors_0/cap_bias.n47 vco_varactors_0/cap_bias.n37 4.5005
R58 vco_varactors_0/cap_bias.n74 vco_varactors_0/cap_bias.n73 4.5005
R59 vco_varactors_0/cap_bias.n73 vco_varactors_0/cap_bias.n47 4.5005
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
R246 vco_varactors_0/OUT_p.n49 vco_varactors_0/OUT_p.n42 2.24511
R247 vco_varactors_0/OUT_p.n40 vco_varactors_0/OUT_p.n2 2.24511
R248 vco_varactors_0/OUT_p.n32 vco_varactors_0/OUT_p.n16 2.24507
R249 vco_varactors_0/OUT_p.n12 vco_varactors_0/OUT_p.n4 2.24507
R250 vco_varactors_0/OUT_p.n34 vco_varactors_0/OUT_p.n15 2.24507
R251 vco_varactors_0/OUT_p.n39 vco_varactors_0/OUT_p.n38 2.24507
R252 vco_varactors_0/OUT_p.n50 vco_varactors_0/OUT_p.n0 2.24507
R253 vco_varactors_0/OUT_p.n41 vco_varactors_0/OUT_p.n3 2.24507
R254 vco_varactors_0/OUT_p.n5 vco_varactors_0/OUT_p.t4 2.47914
R255 vco_varactors_0/OUT_p.n6 vco_varactors_0/OUT_p.t7 2.47914
R256 vco_varactors_0/OUT_p.n7 vco_varactors_0/OUT_p.t10 2.47914
R257 vco_varactors_0/OUT_p.n8 vco_varactors_0/OUT_p.t13 2.47914
R258 vco_varactors_0/OUT_p.n9 vco_varactors_0/OUT_p.t16 2.47914
R259 vco_varactors_0/OUT_p.n10 vco_varactors_0/OUT_p.t19 2.47914
R260 vco_varactors_0/OUT_p.n43 vco_varactors_0/OUT_p.t3 2.47914
R261 vco_varactors_0/OUT_p.n44 vco_varactors_0/OUT_p.t6 2.47914
R262 vco_varactors_0/OUT_p.n45 vco_varactors_0/OUT_p.t9 2.47914
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
