Zachnad0/AUS-NZ-Track-A-RFIC-Workspace/padframe/A01/project_defs_D/D/A01_D_padring.v

module A01_D_padring (
    N01,
    N02,
    N03,
    N04,
    N05,
    N06,
    N07,
    N08,
    N09,
    N10,
    N11,
    N12,
    N13,
    N14,
    N15,
    N16,
    N17,
    N18,
    N19,
    N20,
    N21,
    N22,
    E01,
    E02,
    E03,
    E04,
    E05,
    E06,
    E07,
    E08,
    E09,
    E10,
    E11,
    E12,
    E13,
    E14,
    E15,
    E16,
    E17,
    E18,
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
    W19_ASIG5V,
    W20_ASIG5V,
    W21_ASIG5V,
    W22_ASIG5V,
    N01_ASIG5V,
    N02_ASIG5V,
    N03_ASIG5V,
    N06_PU,
    N06_PD,
    N06_Y
);
  inout N01;
  inout N02;
  inout N03;
  inout N04;
  inout N05;
  inout N06;
  inout N07;
  inout N08;
  inout N09;
  inout N10;
  inout N11;
  inout N12;
  inout N13;
  inout N14;
  inout N15;
  inout N16;
  inout N17;
  inout N18;
  inout N19;
  inout N20;
  inout N21;
  inout N22;
  inout E01;
  inout E02;
  inout E03;
  inout E04;
  inout E05;
  inout E06;
  inout E07;
  inout E08;
  inout E09;
  inout E10;
  inout E11;
  inout E12;
  inout E13;
  inout E14;
  inout E15;
  inout E16;
  inout E17;
  inout E18;
  inout E19;
  inout E20;
  inout E21;
  inout E22;
  inout S01;
  inout S02;
  inout S03;
  inout S04;
  inout S05;
  inout S06;
  inout S07;
  inout S08;
  inout S09;
  inout S10;
  inout S11;
  inout S12;
  inout S13;
  inout S14;
  inout S15;
  inout S16;
  inout S17;
  inout S18;
  inout S19;
  inout S20;
  inout S21;
  inout S22;
  inout W01;
  inout W02;
  inout W03;
  inout W04;
  inout W05;
  inout W06;
  inout W07;
  inout W08;
  inout W09;
  inout W10;
  inout W11;
  inout W12;
  inout W13;
  inout W14;
  inout W15;
  inout W16;
  inout W17;
  inout W18;
  inout W19;
  inout W20;
  inout W21;
  inout W22;
  inout W19_ASIG5V;
  inout W20_ASIG5V;
  inout W21_ASIG5V;
  inout W22_ASIG5V;
  inout N01_ASIG5V;
  inout N02_ASIG5V;
  inout N03_ASIG5V;
  input N06_PU;
  input N06_PD;
  output N06_Y;
  wire FLOAT_VDD_1;

  assign W17 = N04;

  assign N01_ASIG5V = N01;
  gf180mcu_fd_io__asig_5p0 N01 (.ASIG5V(N01), .VSS(N04), .DVSS(N04), .VDD(W18), .DVDD(W18));
  assign N02_ASIG5V = N02;
  gf180mcu_fd_io__asig_5p0 N02 (.ASIG5V(N02), .VSS(N04), .DVSS(N04), .VDD(W18), .DVDD(W18));
  assign N03_ASIG5V = N03;
  gf180mcu_fd_io__asig_5p0 N03 (.ASIG5V(N03), .VSS(N04), .DVSS(N04), .VDD(W18), .DVDD(W18));
  gf180mcu_fd_io__dvss N04 (.DVSS(N04), .VDD(N05), .DVDD(N05));
  gf180mcu_fd_io__dvdd N05 (.DVDD(N05), .VSS(N04), .DVSS(N04));
  gf180mcu_fd_io__in_c N06 (.PU(N06_PU), .PD(N06_PD), .Y(N06_Y), .PAD(N06), .VSS(N04), .DVSS(N04), .VDD(N05), .DVDD(N05));
  gf180mcu_fd_io__asig_5p0 N07 (.ASIG5V(N07), .VSS(N04), .DVSS(N04), .VDD(FLOAT_VDD_1), .DVDD(FLOAT_VDD_1));
  gf180mcu_fd_io__asig_5p0 N08 (.ASIG5V(N08), .VSS(N04), .DVSS(N04), .VDD(FLOAT_VDD_1), .DVDD(FLOAT_VDD_1));
  gf180mcu_fd_io__asig_5p0 N09 (.ASIG5V(N09), .VSS(N04), .DVSS(N04), .VDD(FLOAT_VDD_1), .DVDD(FLOAT_VDD_1));
  gf180mcu_fd_io__asig_5p0 N10 (.ASIG5V(N10), .VSS(N04), .DVSS(N04), .VDD(FLOAT_VDD_1), .DVDD(FLOAT_VDD_1));
  gf180mcu_fd_io__asig_5p0 N11 (.ASIG5V(N11), .VSS(N04), .DVSS(N04), .VDD(FLOAT_VDD_1), .DVDD(FLOAT_VDD_1));
  gf180mcu_fd_io__asig_5p0 N12 (.ASIG5V(N12), .VSS(N04), .DVSS(N04), .VDD(FLOAT_VDD_1), .DVDD(FLOAT_VDD_1));
  gf180mcu_fd_io__asig_5p0 N13 (.ASIG5V(N13), .VSS(N04), .DVSS(N04), .VDD(FLOAT_VDD_1), .DVDD(FLOAT_VDD_1));
  gf180mcu_fd_io__asig_5p0 N14 (.ASIG5V(N14), .VSS(N04), .DVSS(N04), .VDD(FLOAT_VDD_1), .DVDD(FLOAT_VDD_1));
  gf180mcu_fd_io__asig_5p0 N15 (.ASIG5V(N15), .VSS(N04), .DVSS(N04), .VDD(FLOAT_VDD_1), .DVDD(FLOAT_VDD_1));
  gf180mcu_fd_io__asig_5p0 N16 (.ASIG5V(N16), .VSS(N04), .DVSS(N04), .VDD(FLOAT_VDD_1), .DVDD(FLOAT_VDD_1));
  gf180mcu_fd_io__asig_5p0 N17 (.ASIG5V(N17), .VSS(N04), .DVSS(N04), .VDD(FLOAT_VDD_1), .DVDD(FLOAT_VDD_1));
  gf180mcu_fd_io__asig_5p0 N18 (.ASIG5V(N18), .VSS(N04), .DVSS(N04), .VDD(FLOAT_VDD_1), .DVDD(FLOAT_VDD_1));
  gf180mcu_fd_io__asig_5p0 N19 (.ASIG5V(N19), .VSS(N04), .DVSS(N04), .VDD(FLOAT_VDD_1), .DVDD(FLOAT_VDD_1));
  gf180mcu_fd_io__asig_5p0 N20 (.ASIG5V(N20), .VSS(N04), .DVSS(N04), .VDD(FLOAT_VDD_1), .DVDD(FLOAT_VDD_1));
  gf180mcu_fd_io__asig_5p0 N21 (.ASIG5V(N21), .VSS(N04), .DVSS(N04), .VDD(FLOAT_VDD_1), .DVDD(FLOAT_VDD_1));
  gf180mcu_fd_io__asig_5p0 N22 (.ASIG5V(N22), .VSS(N04), .DVSS(N04), .VDD(FLOAT_VDD_1), .DVDD(FLOAT_VDD_1));
  gf180mcu_fd_io__asig_5p0 S01 (.ASIG5V(S01), .VSS(N04), .DVSS(N04), .VDD(FLOAT_VDD_1), .DVDD(FLOAT_VDD_1));
  gf180mcu_fd_io__asig_5p0 S02 (.ASIG5V(S02), .VSS(N04), .DVSS(N04), .VDD(FLOAT_VDD_1), .DVDD(FLOAT_VDD_1));
  gf180mcu_fd_io__asig_5p0 S03 (.ASIG5V(S03), .VSS(N04), .DVSS(N04), .VDD(FLOAT_VDD_1), .DVDD(FLOAT_VDD_1));
  gf180mcu_fd_io__asig_5p0 S04 (.ASIG5V(S04), .VSS(N04), .DVSS(N04), .VDD(FLOAT_VDD_1), .DVDD(FLOAT_VDD_1));
  gf180mcu_fd_io__asig_5p0 S05 (.ASIG5V(S05), .VSS(N04), .DVSS(N04), .VDD(FLOAT_VDD_1), .DVDD(FLOAT_VDD_1));
  gf180mcu_fd_io__asig_5p0 S06 (.ASIG5V(S06), .VSS(N04), .DVSS(N04), .VDD(FLOAT_VDD_1), .DVDD(FLOAT_VDD_1));
  gf180mcu_fd_io__asig_5p0 S07 (.ASIG5V(S07), .VSS(N04), .DVSS(N04), .VDD(FLOAT_VDD_1), .DVDD(FLOAT_VDD_1));
  gf180mcu_fd_io__asig_5p0 S08 (.ASIG5V(S08), .VSS(N04), .DVSS(N04), .VDD(FLOAT_VDD_1), .DVDD(FLOAT_VDD_1));
  gf180mcu_fd_io__asig_5p0 S09 (.ASIG5V(S09), .VSS(N04), .DVSS(N04), .VDD(FLOAT_VDD_1), .DVDD(FLOAT_VDD_1));
  gf180mcu_fd_io__asig_5p0 S10 (.ASIG5V(S10), .VSS(N04), .DVSS(N04), .VDD(FLOAT_VDD_1), .DVDD(FLOAT_VDD_1));
  gf180mcu_fd_io__asig_5p0 S11 (.ASIG5V(S11), .VSS(N04), .DVSS(N04), .VDD(FLOAT_VDD_1), .DVDD(FLOAT_VDD_1));
  gf180mcu_fd_io__asig_5p0 S12 (.ASIG5V(S12), .VSS(N04), .DVSS(N04), .VDD(FLOAT_VDD_1), .DVDD(FLOAT_VDD_1));
  gf180mcu_fd_io__asig_5p0 S13 (.ASIG5V(S13), .VSS(N04), .DVSS(N04), .VDD(FLOAT_VDD_1), .DVDD(FLOAT_VDD_1));
  gf180mcu_fd_io__asig_5p0 S14 (.ASIG5V(S14), .VSS(N04), .DVSS(N04), .VDD(FLOAT_VDD_1), .DVDD(FLOAT_VDD_1));
  gf180mcu_fd_io__asig_5p0 S15 (.ASIG5V(S15), .VSS(N04), .DVSS(N04), .VDD(FLOAT_VDD_1), .DVDD(FLOAT_VDD_1));
  gf180mcu_fd_io__asig_5p0 S16 (.ASIG5V(S16), .VSS(N04), .DVSS(N04), .VDD(FLOAT_VDD_1), .DVDD(FLOAT_VDD_1));
  gf180mcu_fd_io__asig_5p0 S17 (.ASIG5V(S17), .VSS(N04), .DVSS(N04), .VDD(FLOAT_VDD_1), .DVDD(FLOAT_VDD_1));
  gf180mcu_fd_io__asig_5p0 S18 (.ASIG5V(S18), .VSS(N04), .DVSS(N04), .VDD(FLOAT_VDD_1), .DVDD(FLOAT_VDD_1));
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
  gf180mcu_fd_io__fill5 FILL_E21_2 (.VSS(N04), .DVSS(N04), .VDD(FLOAT_VDD_1), .DVDD(FLOAT_VDD_1));
  gf180mcu_fd_io__fill5 FILL_E21_3 (.VSS(N04), .DVSS(N04), .VDD(FLOAT_VDD_1), .DVDD(FLOAT_VDD_1));
  gf180mcu_fd_io__fill5 FILL_E21_4 (.VSS(N04), .DVSS(N04), .VDD(FLOAT_VDD_1), .DVDD(FLOAT_VDD_1));
  gf180mcu_fd_io__fill5 FILL_E21_5 (.VSS(N04), .DVSS(N04), .VDD(FLOAT_VDD_1), .DVDD(FLOAT_VDD_1));
  gf180mcu_fd_io__fill5 FILL_E22_1 (.VSS(N04), .DVSS(N04), .VDD(FLOAT_VDD_1), .DVDD(FLOAT_VDD_1));
  gf180mcu_fd_io__fill5 FILL_E22_2 (.VSS(N04), .DVSS(N04), .VDD(FLOAT_VDD_1), .DVDD(FLOAT_VDD_1));
  gf180mcu_fd_io__fill5 FILL_E22_3 (.VSS(N04), .DVSS(N04), .VDD(FLOAT_VDD_1), .DVDD(FLOAT_VDD_1));
  gf180mcu_fd_io__fill5 FILL_E22_4 (.VSS(N04), .DVSS(N04), .VDD(FLOAT_VDD_1), .DVDD(FLOAT_VDD_1));
  gf180mcu_fd_io__fill5 FILL_E22_5 (.VSS(N04), .DVSS(N04), .VDD(FLOAT_VDD_1), .DVDD(FLOAT_VDD_1));
endmodule
