Zachnad0/AUS-NZ-Track-A-RFIC-Workspace/padframe/A01/project_defs_12pin_0831/BH/A01_BH_padring.v

module A01_BH_padring (
    N01,
    N02,
    N03,
    N04,
    N05,
    N06,
    N07,
    N08,
    N09,
    N10,
    N11,
    N12,
    N13,
    N14,
    N15,
    N16,
    N17,
    N18,
    N19,
    N20,
    N21,
    N22,
    E01,
    E02,
    E03,
    E04,
    E05,
    E06,
    E07,
    E08,
    E09,
    E10,
    E11,
    E12,
    E13,
    E14,
    E15,
    E16,
    E17,
    E18,
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
    W20_ASIG5V,
    W21_ASIG5V,
    W22_ASIG5V,
    N01_ASIG5V,
    N02_ASIG5V,
    N03_ASIG5V,
    N04_ASIG5V,
    N07_PU,
    N07_PD,
    N07_Y
);
  inout N01;
  inout N02;
  inout N03;
  inout N04;
  inout N05;
  inout N06;
  inout N07;
  inout N08;
  inout N09;
  inout N10;
  inout N11;
  inout N12;
  inout N13;
  inout N14;
  inout N15;
  inout N16;
  inout N17;
  inout N18;
  inout N19;
  inout N20;
  inout N21;
  inout N22;
  inout E01;
  inout E02;
  inout E03;
  inout E04;
  inout E05;
  inout E06;
  inout E07;
  inout E08;
  inout E09;
  inout E10;
  inout E11;
  inout E12;
  inout E13;
  inout E14;
  inout E15;
  inout E16;
  inout E17;
  inout E18;
  inout E19;
  inout E20;
  inout E21;
  inout E22;
  inout S01;
  inout S02;
  inout S03;
  inout S04;
  inout S05;
  inout S06;
  inout S07;
  inout S08;
  inout S09;
  inout S10;
  inout S11;
  inout S12;
  inout S13;
  inout S14;
  inout S15;
  inout S16;
  inout S17;
  inout S18;
  inout S19;
  inout S20;
  inout S21;
  inout S22;
  inout W01;
  inout W02;
  inout W03;
  inout W04;
  inout W05;
  inout W06;
  inout W07;
  inout W08;
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
  gf180mcu_fd_io__fill5 FILL_E21_4 (.VSS(N05), .DVSS(N05), .VDD(FLOAT_VDD_1), .DVDD(FLOAT_VDD_1));
  gf180mcu_fd_io__fill5 FILL_E21_5 (.VSS(N05), .DVSS(N05), .VDD(FLOAT_VDD_1), .DVDD(FLOAT_VDD_1));
  gf180mcu_fd_io__fill5 FILL_E22_1 (.VSS(N05), .DVSS(N05), .VDD(FLOAT_VDD_1), .DVDD(FLOAT_VDD_1));
  gf180mcu_fd_io__fill5 FILL_E22_2 (.VSS(N05), .DVSS(N05), .VDD(FLOAT_VDD_1), .DVDD(FLOAT_VDD_1));
  gf180mcu_fd_io__fill5 FILL_E22_3 (.VSS(N05), .DVSS(N05), .VDD(FLOAT_VDD_1), .DVDD(FLOAT_VDD_1));
  gf180mcu_fd_io__fill5 FILL_E22_4 (.VSS(N05), .DVSS(N05), .VDD(FLOAT_VDD_1), .DVDD(FLOAT_VDD_1));
  gf180mcu_fd_io__fill5 FILL_E22_5 (.VSS(N05), .DVSS(N05), .VDD(FLOAT_VDD_1), .DVDD(FLOAT_VDD_1));
endmodule
