Zachnad0/AUS-NZ-Track-A-RFIC-Workspace/(commit log)

2026-06-19 ADDED NOT, NAND, and D-FF v1 devices. TODO is to test them via testbench schematics, while also finding the correct channel W/L.
    [D_FF_v1.sch, NAND_v1.sch, NOT_v1.sch]
2026-06-22 Add PFD top-level schematic: two DFFs, D tied high, Qs into reset NAND
    [PFD_v1.sch]
2026-06-25 ADDED vco_inductor_v2 xschem symbol, SPICE subcircuit (works!), and testbench. REMOVED old subcircuit.
    [inductor_tb.sch]
2026-06-25 Add PFD symbol and testbench, sim runs in ngspice
    [PFD_tb.sch]
2026-06-27 ADDED various testbenches for VCO related systems. Successfully found desired capacitance tuning range for the varactors too.
    [inductor_tb.sch, vco_mosfets_test.sch, vco_mosfets_test_2.sch, vco_tank_tb.sch]
2026-06-29 Reset DFF + NAND3, wiring verified, sim wip
    [D_FF_RST_v1.sch, NAND3_v1.sch, PFD_tb.sch, PFD_v1.sch]
2026-06-29 Fix bulk terminals in NAND3 (nfet->VSS, pfet->VDD)
    [NAND3_v1.sch]
2026-06-30 ADDED vco varactor testbench. Found suitable PDK component and values to achieve desired VCO capacitance range.
    [vco_varactor_tb.sch]
2026-07-02 ADDED WIP version of final vco schematic, symbol, and testbench. Modified several of the other testbenches too. Just requires some device parameter tuning to get the right tuning range sorted.
    [inductor_tb.sch, vco_mosfets_test.sch, vco_tb.sch, vco_v1.sch, vco_varactor_tb.sch]
2026-07-03 Completed VCO v1 successfully. Additional buffering or amplification may be necessary later.
    [vco_tb.sch, vco_v1.sch]
2026-07-05 FIXED NOT_v1 gate and D_FF_RST_v1. ADDED NAND3 testbench schematic (it works) and updated NAND3_v1 and D_FF_RST_v1 symbols.
    [D_FF_RST_v1.sch, NAND3_v1_tb.sch, NAND_v1.sch, NOT_v1.sch]
2026-07-10 ADDED buffers to VCO in testbench. Now capable of delivering -1.55 dBm to 50 ohm load, drawing 16.6 mW total, and 3rd harmonic power is -18.4 dBc.
    [vco_tb.sch]
2026-07-19 Fix D_FF_RST_v1 edge dtector: 7-inverter delay chain widens sample pulse, capture verified in new standalone tb
    [D_FF_RST_v1.sch, D_FF_RST_v1_tb.sch]
2026-07-19 Verify PFD_v1 at 1 MHz reference: UP tracks 100ns phase offset, ~1ns reset pulse; tb source delays 50n/150n so edge detectors are armed under uic
    [PFD_tb.sch]
2026-07-19 PFD_v1: net label fixes from netlist debugging
    [PFD_v1.sch]
2026-07-22 Add CP_v1 charge pump cell (schematic + symbol)
    Single-ended switched current-steering CP at GF180 3.3V. PMOS mirror
    sources I_CP into CP_OUT (UP active), NMOS mirror sinks I_CP (DOWN
    active), both-off = high-Z. Internal inverter generates UP_B for the
    pmos drain switch. I_CP=50u set by two ideal references (PROVISIONAL
    placeholder; final value is a loop-design decision). Every net
    explicitly labeled; netlist connectivity verified (bulks, ports, mirror
    topology). Devices nfet_03v3/pfet_03v3 only.
    [CP_v1.sch]
2026-07-22 Add CP_v1 connectivity testbenches (Gate A)
    CP_dc_tb: sweeps V_OUT 0..3.3V, records i(v_out) for source-only,
    sink-only, and leakage conditions. CP_tran_tb: 1ns-wide UP/DOWN pulses
    at 1MHz (>=50n delays, uic-safe), 10p load, 0V sense source for pump
    current, CP_OUT pre-charged to mid-rail. Both netlist cleanly; VSS
    explicitly tied to 0 via 0V source; DUT pin order and subckt expansion
    verified.
    [CP_dc_tb.sch, CP_tran_tb.sch]
2026-07-22 Tune CP_v1 sizing (Gate B) and fix TB sim setup
    CP_v1: final Round-4 device sizing chosen from a 6-round sweep -
    pmos mirror/switch 50u, nmos mirror/switch 10u, mirror L=2u, switch
    L=0.3u. Widens DC compliance window to 0.32-3.00V (mismatch<5%) with a
    1.26V <1% flat band, best mismatch 0.001%, leakage <7pA.
    Testbenches: add PDK corner-switch params (fnoicor, sw_*) before .lib;
    tie VSS to 0 via explicit 0V source; add 'save all' so node voltages
    are recorded; use Gear integration in the transient TB to remove
    trapezoidal current-sense ringing.
    [CP_dc_tb.sch, CP_tran_tb.sch, CP_v1.sch]
2026-07-31 Add scope/pins/tracking docs; post area + pin data to README
    - docs/scope.md: frozen scope tiers, corrected PLL chain (PFD->CP->loop
    filter->VTUNE->VCO->divider), frequency plan OPEN pending f-VTUNE sweep,
    bottoms-up area estimate 350x300um from measured 182x84um inductor +
    gf180mcu std-cell digital + custom CP.
    - docs/pins.md: on/off-chip partition, slot_0p5x0p5 pad-type table,
    zero-margin analog (RF_OUTP/N, VTUNE, CP_OUT), IBIAS on digital pad.
    - docs/tracking.md: dated milestones vs deadlines, owners, condition status.
    - README.md: Area Estimate + Pin count lines; Pin Requirement Link -> pins.md.
2026-07-31 Rail audit (3.3V project rail) + draft PFD 3-case testbenches
    - docs/verification.md: tb-by-tb + cell-by-cell rail map. Project rail 3.3V
    (all cells 03v3; no dual-rail). Outliers PFD_tb + D_FF_RST_v1_tb at 1.8V
    queued for correction (not yet edited).
    - PFD_tb_{lead,lag,eqfreq}.sch: NEW 3.3V PFD testbenches, explicit net labels
    (REF/FB/VDD/VSS/UP/DOWN), >=50ns arming delays. UNVERIFIED DRAFTS - to be
    netlisted/run when container returns.
    [PFD_tb_eqfreq.sch, PFD_tb_lag.sch, PFD_tb_lead.sch]
2026-07-31 Document pin-mismatch diagnosis + approved fix; correct severity framing
    - verification.md 1.4: exact diagnosis (PFD_v1 6/8, D_FF_RST_v1 7/19 incl !Q),
    root cause (duplicate VDD/VSS iopins), approved iopin->lab_pin fix, per-cell
    verification gate (warning cleared + netlist diff identical modulo port order),
    sequencing (fix before cond-4 final evidence + 1MHz regression). D_FF_v1 note.
    - Corrected framing: non-fatal (dedup at netlist), clean-before-LVS not
    block-before-sims. Dropped NAND3_v1 (it is clean).
2026-07-31 Finalize frequency plan (Plan B) from measured f-VTUNE sweep
    - scope.md 3: FINAL - VCO 4.11-6.37 GHz native, /2 -> 2.06-3.18 GHz, ISM
    2.4-2.5 GHz at VTUNE ~2.05-2.28V. KVCO ~-683 MHz/V (inverted). Divider
    required Tier 1. Condition-2 paper trail resolved.
    - scope.md 2: loop-sign constraint (KVCO<0) - UP/DOWN->CP sense inverted,
    verified empirically in PFD+CP integration sim.
    - verification.md 3: full sweep table logged; remaining VCO char pending.
    For-Zach notes (D_FF_v1 dup iopin, vco_v1 hardcoded include).
2026-07-31 Fix PFD_v1/D_FF_RST_v1 symbol<->schematic pin mismatch (iopin->lab_pin)
    Convert redundant VDD/VSS iopins to lab_pin, one power port each:
    - PFD_v1: p15(VDD),p16(VSS) -> lab_pin (kept p3/p4 ports)
    - D_FF_RST_v1: 6xVDD + 6xVSS -> lab_pin (kept p3/p6 ports)
    Verification gate PASSED both cells:
    - pin-count warning cleared (PFD_v1 6/8, D_FF_RST_v1 7/19 gone)
    - device-level netlist byte-identical pre/post (connectivity unchanged)
    - .subckt port lists unchanged; PFD_tb + 3 drafted tbs: 0 pin errors
    No symbol edits. 1MHz regression pending in condition-4 runs.
    [D_FF_RST_v1.sch, PFD_v1.sch]
2026-07-31 Rail-correct PFD_tb + D_FF_RST_v1_tb (1.8->3.3V); record PFD 3-case results
    - PFD_tb, D_FF_RST_v1_tb: 1.8->3.3V sources/supply (+ .ic 3.3 in PFD_tb).
    - verification.md 2: 3-case condition-4 results. Lead UP=100.5ns/DOWN reset
    0.48ns; lag mirror; eqfreq UP=DOWN=0.50ns (locked). Drafted lead tb matches
    corrected PFD_tb. Reset ~0.48-0.50ns @3.3V. Pin-fix regression 101.0ns@1.8V.
    [D_FF_RST_v1_tb.sch, PFD_tb.sch]
2026-07-31 PFD+CP integration sim (condition 4); clean up PFD_v1 overlapped lab_pins
    - PFD_CP_tb.sch (new): PFD_v1+CP_v1, static phase-error sweep. Linear transfer
    I_avg=I_CP*phi/T confirms I_CP=50uA; phi=0 residual ~105fC/cycle matches known
    +110fC injection. LOOP SIGN verified: REF-lead->pump-up->VTUNE up->freq down
    (KVCO<0) = away from lock -> UP/DOWN->CP sense must be inverted (tb-level
    finding, no cell rewiring).
    - PFD_v1.sch: delete p15/p16 (redundant lab_pins from the earlier convert that
    overlapped p7/p12 and errored). Device netlist IDENTICAL to pre-fix baseline.
    [PFD_CP_tb.sch, PFD_v1.sch]
2026-07-31 LibreLane pipeline proof (PASS to floorplan) + DIV2 static-CMOS feasibility
    - verification.md 6: librelane workshop-slot flow runs to floorplan at 3.0.3
    with --scl gf180mcu_fd_sc_mcu7t5v0 override (works around sg13g2 default-SCL
    drift). Synth+floorplan complete, exit 0.
    - verification.md 7: DIV2 feasibility. Static CMOS toggle FF (D_FF_RST_v1) clean
    divide-by-2 only to ~1-1.5GHz, dead by 3GHz. VCO is 4.11-6.37GHz -> static
    can't do the first stage. CML vs TSPC decision pending. DIV2_QUAD_v1 on hold.
    - Notes: D_FF_v1 no-reset can't self-start; D_FF_RST_v1 RST active-low.
    [DIV2_toggle_probe_tb.sch]
2026-07-31 Restructure pins for block-footprint delivery + dual pin-accounting table
    - pins.md: primary = 8-signal block interface (pad type per signal); per-analog
    ESD note with RF_OUTP/N 2.4-3.2GHz loading; A-E fit table under both
    interpretations (power+gnd counted vs signals-only), pending organizer pin
    accounting; slot_0p5x0p5 demoted to SUPERSEDED appendix.
    - scope.md 7: partition/test = block footprint, fixed organizer-scripted pad
    placement; workshop flow = toolchain/sample-GDS proof only.
    - tracking.md: Aug-21 = block-footprint GDS w/ pad types; Aug-6 reframed as
    toolchain proof (pipeline proven to floorplan).
2026-07-31 DIV2: lock CML div-by-2 design + power cost (~1.3mW static); park before build
    CML chosen (Greg). Architecture + device-level + first-pass sizing recorded.
    Schematic authoring + band/quadrature verification queued for Run-A window.
2026-07-31 DIV2 CML: build flat probe, prove div-by-2 topology, optimize to 5GHz
    - DIV2_CML_probe_tb.sch: 12-nfet CML div-by-2 (quadrature), ideal tails/R loads,
    differential clock. Netlist-clean, zero auto-nets.
    - Topology verified: clean div-by-2 at 1GHz (W=40u/400u/2k); after speed opt
    (R=500/tail=1.2m) clean div-by-2 at 5GHz (2.5GHz out) -> covers ISM operating
    point (VCO 4.8-5.0GHz). 6.37GHz band-top not yet locked (needs R down/I up).
    - Power grown to ~8mW at this sizing (speed costs current); logged vs 1.3mW est.
    - Remaining: 6.37GHz, quadrature accuracy, CMOS buffer, package DIV2_QUAD_v1.
    [DIV2_CML_probe_tb.sch]
2026-07-31 Correct pin model: organizer padframe proposal (not wafer.space slots)
    Supersedes 8b548e5's slot-based table (kept below in history; this commit is the
    authoritative model).
    - Configs A-E = organizer proposal pin TOTALS + die shares (A 22/quarter,
    B 16/eighth, C 6, D 10/sixteenth, E 6); shared die 2235x2235, 88 pins.
    - Quadrature padded to differential I/Q: I_P/I_N/Q_P/Q_N replace RF_OUTP/N;
    4 monitor-grade output buffers (2.4-3.2 GHz) added to block list.
    - Block = 12 pins: analog 7 (I_P,I_N,Q_P,Q_N,VTUNE,CP_OUT,IBIAS_CP) + digital 3
    (REF_IN,RST_N,MON_OUT) + power 2 (VDDA,VDDD); ground chip-wide common (0 pins,
    power counts - per Bailey). Fits config B (16, 4 spare); fallback D (10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
2026-07-31 DIV2 CML: full band 4.11-6.37GHz locked + quadrature -90deg verified
    Final sizing tail=2.4mA/R=300ohm: clean div-by-2 across entire native band
    (4.11->2.058, 5.0->2.5, 6.37->3.185 GHz), consistent -90deg quadrature (Q leads I)
    at 4.11/5.0/6.37 GHz, swing 0.83-1.4V. Final power ~16mW static (4.8mA) - band-top
    doubled the current vs 8mW checkpoint. Remaining: 4x CMOS output buffers, real bias
    mirror, package DIV2_QUAD_v1.sch/.sym.
    [DIV2_CML_probe_tb.sch]
2026-08-04 Add Chipathon submission info.yaml + lvs/lvs_config.json
    info.yaml at repo root: title/team/description from docs/scope.md,
    lvs_config points to lvs/lvs_config.json (relative path resolves).
    lvs_config.json: STD_CELL_LIBRARY gf180mcu_fd_sc_mcu7t5v0, base include,
    TOP_SOURCE=chip_top (workshop-slot sample-GDS proof; the only cell with a
    real GDS for the Aug 6 DRC dry-run). Extract/LVS glob lists left at template
    defaults pending the Aug 6 run output.
2026-08-04 DIV2_QUAD_v1 WIP (built, netlist-clean, not dividing in sim) + bias/pin docs
    DIV2_QUAD_v1.sch/.sym + DIV2_QUAD_tb.sch: CML div2 core + NMOS 10:1 bias mirror
    off IBIAS + 4x PMOS-input CML->CMOS rail-to-rail buffers w/ 450ohm series R.
    Netlist-clean, wired to spec, but sim does NOT divide cleanly yet (asymmetric
    CML with real tails, buffers not switching, ~2.8mA vs ~18mA expected). Full
    debug state + resume plan in docs/div2-debug.md. Marked WIP in tracking.md.
    Docs: verification.md mirror arithmetic (240uA x10 x2 = 4.8mA) + buffer/load
    note; pins.md IBIAS_CP->IBIAS chip-bias rename (pin count unchanged = 12);
    tracking.md TOP_SOURCE=chip_top dry-run-placeholder note + DIV2 WIP flag.
    Co-Autho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
    [DIV2_QUAD_tb.sch, DIV2_QUAD_v1.sch]
2026-08-04 Add resume-notes.md: session pause state (Run A killed mid-Magic-DRC)
    Run A killed at stage 67 magic-drc by machine shutdown. GDS confirmed
    (chip_top.gds 27MB, on bind mount); routing/antenna/density/XOR all zero;
    signoff Magic+KLayout DRC never read (report 0 bytes) -> DRC inconclusive.
    Relaunch command included. First action next session: measure DIV2 tail
    current (2.8mA vs 18mA expected likely root cause). See docs/div2-debug.md.
2026-08-04 Correct D_FF_v1 duplicate-iopin claim (disproven) + update resume-notes
    verification.md: the D_FF_v1 'symbol 5 / schematic 6, 1 dup power' note was
    FALSE. Verified 1 VDD + 1 VSS iopin, 6 sym pins matching 6 sch ports, no
    netlist warning, identical across all four origin branches, never modified
    since 413a1db, not instantiated anywhere. Do not delete any iopin. (Zach's
    cleanup request checked and disproven.)
    resume-notes.md: origin/main = origin/integration = 3ace987; Magic DRC = 0
    errors (read from drc.magic.rpt COUNT: 0); KLayout DRC resumed via
    --last-run --from/--to KLayout.DRC off 67-magic-drc/state_out.json, was
    still running at shutdown -> inconclusive; DIV2 tail current must be measu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
2026-08-05 Park DIV2 (NMOS converter, still not switching) + freeze Aug-14 layout scope
    DIV2_QUAD_v1: converters swapped PMOS->NMOS input (necessary; PMOS was in
    cutoff at CML CM 2.93V) but still does not switch. Two measured faults:
    OC op point 1.87V never crosses inverter trip 1.515V; NMOS input pair loads
    CML (idiff 0.57->0.13-0.20V). Mirror (2.4mA) + CML core verified good.
    Parked with sizing-not-architecture resume hypothesis in div2-debug.md.
    tracking.md: Aug-14 layout scope frozen = CP_v1 + PFD digital chain (manual
    Magic + netgen LVS). VCO cut (Zach out ~2wks), DIV2 cut (buffer broken).
    Aug-6 row updated: full GDS + Magic DRC=0 confirmed.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
    [DIV2_QUAD_v1.sch]
2026-08-05 Add layout-flow.md: verified Magic DRC+extract+netgen LVS recipe
    Manual layout flow for Aug-14 custom cells. Verified end-to-end on gf180
    std-cell inv_1: DRC=0, extract OK, netgen LVS 'Circuits match uniquely'.
    Exact commands for the repeatable DRC/extract/LVS pipeline. Drawing step
    is interactive GUI; verify steps are headless.
2026-08-05 PFD gate PASSED: library-cell PFD re-sim + reset delay + device-flavor docs
    verification.md 2.2: library-cell PFD (2x dffrnq_1 + nand2_1, our topology).
    Async reset confirmed genuine, D-high works, 3 regions match custom. Raw min
    pulse 0.37ns (worse dead-zone floor) widened with 2x inv_1 in RSTN path ->
    0.50ns. Corner margin: min-pulse(ff) 0.39ns >> CP-steer(ss) ~0.02ns. Gate passed.
    scope.md 4.1: mixed 5V mcu7t5v0 digital / 03v3 analog device-flavor decision
    + reason. 4.2: layout adjacency (DUALGATE boundary, well/implant spacing, keep
    digital a self-contained block, guard-ring at the flavor boundary).
2026-08-05 Record CP steering-metric caveat (0.155ns loaded/typ vs 0.019ns clamped/ss)
    The two CP steering figures are different measurements; loaded steering at
    the ss corner was never measured. Qualitative dead-zone conclusion holds but
    0.39 vs 0.02 is not an apples-to-apples margin.
2026-08-05 PFD_lib layout: scripted std-cell placement (DRC 0), routing pending
    team_src/magic/PFD_lib.mag: 5 library cells (2x dffrnq_1, nand2_1, 2x inv_1)
    abutted in a row, power connected by abutment, DRC=0. Signal routing not yet
    done (hits the blind-headless routing wall). PFD_lib_golden.spice = LVS
    reference. Routing to be finished in the Magic GUI; net list handed to Greg.
2026-08-05 PFD_lib LibreLane prep: tie cell in golden, LVS_IGNORE fill/decap, structural verilog
    golden: add tieh (D tied high via tie cell, antenna/ESD-correct) so LVS stays
    one clean step vs LibreLane output. lvs_config LVS_IGNORE: fill/fillcap/decap/
    antenna. librelane_pfd/src/PFD_lib.v: structural PFD, (* keep *) on the 2 RSTN
    delay inverters (verified to survive opt+abc, 2 inv in series on RSTN).
    [PFD_lib.v]
2026-08-06 PFD_lib layout COMPLETE: record 4-gate results + LibreLane dlyb trap
    verification.md 2.3: PFD_lib DRC 0/0, 2x inv_1 in series on RSTN preserved,
    REF/FB insertion ~48fs/~12fs (unbuffered, ~36fs mismatch), netgen LVS vs
    golden matches uniquely. First-run trap: LibreLane inserted 3x dlyb_1 (FB-only
    + outputs) = asymmetric REF/FB static phase offset. Fix keys (CLOCK_PORT null,
    DESIGN_REPAIR/PL_RESIZER BUFFER_INPUT/OUTPUT_PORTS false, RSZ_DONT_TOUCH_RX,
    REMOVE_BUFFERS false). Reject-the-run rule: verify 2x inv on RSTN in nl.v.
    tracking.md 5: PFD DONE via LibreLane; CP_v1 next.
2026-08-06 CP_v1 layout prep: golden LVS netlist (8 devices) for the Aug-14 charge-pump layout
    8 transistors; bias nodes VGP/VGN exposed as ports (ideal I_CP sources are not
    layout devices -> external IBIAS-fed bias, partition decision flagged). Matching
    pairs: M_PREF<->M_PSRC (50u/2u pmos), M_NREF<->M_NSNK (10u/2u nmos).
2026-08-06 CP_v1 golden: record decided bias partition (2 current ports VGP/VGN from IBIAS)
    Confirmed M_PREF/M_NREF both diode-connected with own ideal source; devices
    unchanged from characterized CP_v1, only port list exposes VGP/VGN as the two
    IBIAS current ports. Parses (7 ports, 8 devices).
2026-08-06 Add CP_v1 layout drawing packet: fingers, dummies, guard rings, DUALGATE keep-out, ports
    Self-contained GUI drawing guide: device finger breakdown (50u pmos 10x5u,
    mirror pairs common-centroid + dummies), nwell/psub guard rings, DUALGATE
    keep-out to PFD (DV.3 0.24um -> 0.5um block gap), two-band floorplan, port
    map, and the headless LVS-vs-golden verify recipe.
2026-08-06 CP layout: distinguish DUALGATE DRC floor from noise-driven CP-PFD separation
    The 0.48um DUALGATE number is the oxide/well DRC floor, NOT the block gap.
    CP_OUT is high-Z into the off-chip loop filter next to the switching PFD ->
    coupling = reference spurs on VTUNE. Recommend noise-based isolation: >=20um
    separation (opposite sides), double guard rings on separate VSSA/VSSD returns
    (deep-nwell barrier if adopted), CP on VDDA / PFD on VDDD, CP_OUT shielded
    (coplanar VSSA + ground plane) and kept away from all switching nets.
    Recorded in cp-layout-packet.md 3b and scope.md 4.2.
2026-08-06 CP layout docs: VSSA/VSSD are on-chip-only (one common ground pin); deep-nwell deferred
    (1) VSSA/VSSD guard-ring returns are ON-CHIP labels, NOT separate ground pins:
    padframe = one chip-wide common ground (#143), so both returns star-connect to
    that single point. No doc implies a separate off-chip return. (2) Deep-nwell
    explicitly NOT adopted for Aug 14 (new layer + new DRC rules, wrong week);
    recorded as a later-revision option. VDDA/VDDD remain separate power pins.
2026-08-10 Track PFD hand-placement build script; gitignore magic .ext output
    place_pfd.tcl reproduces the fallback hand-placement PFD_lib.mag (Aug 14
    deliverable): abuts the 5 std cells in a row via getcell. .gitignore now
    excludes team_src/magic/*.ext (magic extraction, regenerable).
2026-08-10 Aug-14 layout review: PFD_lib evidence, repoint lvs_config to PFD_lib, review doc
    - lvs_config.json: TOP_SOURCE chip_top->PFD_lib; LVS_VERILOG_FILES ->
    $UPRJ_ROOT/lvs/PFD_lib.nl.v; LAYOUT_FILE resolves to gds/PFD_lib.gds.
    All $UPRJ_ROOT paths, no run-tag paths. chip_top artifacts untouched.
    - gds/PFD_lib.gds (57490 B) + lvs/PFD_lib.nl.v: stable committed LVS targets.
    - docs/layout-review-aug14.md: 5 rubric rows, file-read evidence + scores.
    CAT1 3/3, CAT2 3/3, CAT3 N/A(PFD)/not-drawn(CP), CAT4 2/3 (EM/ESD/PEX not
    done; tap-dist 20um EXCEEDS 15um MV limit, compliance incidental), CAT5 2/3.
    - docs/img/PFD_lib_{white,black}.png: lay2img render.
    - tracking.md 6: rubric status + CAT3 gap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
    [PFD_lib.nl.v]
2026-08-10 librelane_pfd: set FP_TAPCELL_DIST 20->15 um for GF180 MV tap rule (DF.13/DF.14_MV)
    PFD_lib is 5V std cells; DF.13_MV/DF.14_MV cap tap-to-device at 15 um on
    .overlapping(dualgate). The prior effective value (20, the LibreLane
    default) is the LV/3.3V limit and only passed incidentally on a small
    block. No LibreLane re-run.
2026-08-10 magic: headless DRC+LVS verify script (verify_cp.sh)
    verify_cp.sh <CELL> runs Magic DRC -> LVS-netlist extract -> netgen LVS
    against team_src/magic/<CELL>_golden.spice, printing the DRC count,
    functional device/port/net counts, and the netgen verdict; exits non-zero
    if DRC>0 or LVS is not a unique match.
    - magicrc and netgen setup paths are resolved from the live PDK env and the
    script hard-fails with a hint if either (or the golden/layout) is missing,
    rather than silently passing.
    - Layout source: committed gds/<CELL>.gds preferred, else <CELL>.mag.
    - Golden std cells are resolved against the PDK mcu7t5v0 spice so a placed
    digital block LVSes against a schematic golden; placer fill/d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
2026-08-10 gitattributes: force LF on *.sh and *.tcl for in-container execution
    A Windows checkout with autocrlf could hand bash/magic a CRLF verify_cp.sh
    and break it inside the EDA container. Pin shell and Tcl decks to LF.
2026-08-10 DIV2 buffer: inv M_IP 8u->26u (PROVISIONAL, move-a trip skew)
    Skews the CML->CMOS output inverter trip from 1.521 V to 1.876 V
    (standalone DC sweep, M_IN held 4u) to move it off the low rail toward
    OC's operating point, so OC's swing can actually cross it.
    PROVISIONAL: centered on OC's DC operating point (1.87 V), not yet the
    swing midpoint. Move (b) (shrinking the 16u NMOS inputs) will change OC's
    swing; the trip gets re-centered on the new midpoint after that. Also flagged
    for an ff/ss corner check before freeze (skewed trip is corner-sensitive) and
    a possible restoring second stage (~6.5:1 M_IP/M_IN has asymmetric edges).
    Generator _cp_work/gen_div2_quad.py (outside repo) edited to matc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
    [DIV2_QUAD_v1.sch]
2026-08-10 DIV2 buffer: CML-input pair 16u->8u (move-b, idiff recovery)
    Halving the NMOS diff-pair inputs (M_BN1/M_BN2 16u->8u) cuts the
    Miller-multiplied gate cap that was loading the 300-ohm CML nodes at 5 GHz.
    Measured (tran 0.2p 10n uic, .ic startup break, 6-10 ns window):
    - idiff v(OI)-v(OIB) swing recovered to +/-0.557 V (was +/-0.13-0.20 V),
    essentially the full +/-0.57 V CML target.
    - OC swing widened 280 mV -> 495 mV (1.617-2.112 V); new midpoint 1.864 V,
    which lands the provisional 26u trip (1.876 V) correctly centered.
    Stopped at 8u: idiff is fully recovered, so going smaller only sheds
    input-pair gm. Output stage still does not reach the rails (INVO 0.114-
    0.472 V) -- separate drive p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
    [DIV2_QUAD_v1.sch]
2026-08-10 DIV2 buffer: 3-stage output chain (move-c) -- NON-WORKING in steady state
    Splits the CML->CMOS output into 3 stages: stage1 skewed trip-setter (26u/4u),
    stage2 restoring inverter (38u/4u), stage3 driver (44u/16u off pinned Ron) into
    R_SER 1k + pad. Stage-3 sizing and the pinned Ron*W (nfet 1707, pfet 4833 ohm-um)
    are real results and are the Aug-21 rework starting point.
    DOES NOT WORK in steady state. At 8-10ns (bias still settling under uic) it looked
    rail-to-rail (I_P 142mVpp); measured to 16-20ns the output collapses to 21mVpp.
    Root cause: stage-1's 26u/4u skew makes INVO1 ride to a 2.18V settled midpoint,
    above stage-2's 1.98V trip, so stage 2 de-saturates. Same failure CLASS as the
    pri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
    [DIV2_QUAD_v1.sch]
2026-08-10 docs(T7): DIV2 3-stage result, PEX/tapcell/LVS-waivers, scaffold + R_SER relock
    - div2-debug.md: 2026-08-10 section -- moves a/b/c, steady-state collapse (transient
    vs 16-20ns), threshold-matching CLASS root cause, option-1 negative result (do not
    reopen), Aug-21 rework directions, uic/waveform toolchain notes; header R_SER->1k.
    - verification.md 2.3: PEX REF/FB symmetry (layout observation, period-fraction bound,
    STA wire-only reconciliation hypothesis), verify_cp.sh re-confirmation + 2 LVS waivers,
    FP_TAPCELL_DIST 20->15; 190 != device count. 7.1: DIV2 steady-state status.
    - layout-review-aug14.md: 2 LVS waivers (row 1), tapcell correction (row 4), PFD_lib.mag
    scaffold clarificat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
2026-08-10 layout-review(T8): draft CP_v1 section vs 5 rubric rows (layout not drawn)
    CP_v1 charge-pump review from the golden (8 devices) + drawing packet, structured by
    the five rubric rows. Every measured LAYOUT number is an explicit [TODO] until
    CP_v1.mag exists and verify_cp.sh has run on it.
    Facts recorded: chip-wide COMMON ground (VSSA/VSSD on-chip labels, not ground pins);
    VGP/VGN are current ports off the chip-level IBIAS generator, not pads; +110 fC
    injection is a known schematic-level flaw; 0.48 um DUALGATE spacing is the DRC floor
    only vs the 20-50 um noise gap; deep-nwell deliberately deferred; ESD and EM
    quantification NOT DONE. Also flags the nfet/pfet_03v3 wrapper-subckt LVS gotcha
    (re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
2026-08-10 docs: STA reconciliation as untested hypothesis; freeze main until CP_v1 real
    - verification.md 2.3: make the PEX-vs-STA (48/12 fs) reconciliation explicit that
    the wire-only/pin-cap explanation was NOT tested -- plausible, not settled.
    - tracking.md: warn against fast-forwarding main -- layout-review-aug14.md now has a
    [TODO]-only CP_v1 section and #143 links track blob/main; main stays at 20dd3b4 until
    CP_v1 is drawn and verify_cp.sh CP_v1 passes.
2026-08-11 ibias_gen_v1: chip-level IBIAS generator cell + symbol + TB (S3)
    Cascoded mirror tree from the S2 topology: 240uA forced into IBIAS -> NMOS
    self-biased stacked-diode master -> VGP sink leg (50u) + transfer leg (240u)
    -> PMOS master -> VGN source leg (50u) + DIV2 source leg (240u, separate cascode
    gate via a 2u replica) + Vb_p decap. CP mirror legs enlarged 2x W&L (amendment 1).
    16 devices, ports IBIAS VGP VGN IB_DIV2 VDD VSS. Netlists clean via xschem -n -q
    (zero auto-nets). .op biases to VGP 50.9 / VGN 48.5 / DIV2 239.6 uA, VDDA 838uA;
    all cascodes saturated; DIV2 replica cascode gate tracks PA. The VGP/VGN ~5% split
    already previews the NMOS/PMOS tracking mismatch that S5 will quantify.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
    [ibias_gen_tb.sch, ibias_gen_v1.sch]
2026-08-12 verify_cp(Phase1): hard-fail on netgen property errors; transistor-level LVS throwaways
    Phase 1 settles LVS representation before block layout exists:
    - PDK nfet/pfet_03v3 extract as pin-only black boxes; match a schematic-style
    golden UNIQUELY under the stock netgen setup -- the predicted def-vs-blackbox
    mismatch does NOT recur at transistor level, so no netgen-setup waiver is
    needed (contrary to the std-cell experience).
    - netgen checks W/L at a 1% cutoff but reports them as 'property errors' while
    still declaring 'match uniquely'. verify_cp.sh now hard-fails (exit 1) on any
    property error so a wrongly-sized layout cannot silently pass. std-cell path
    and PFD_lib known-good (DRC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
2026-08-12 phase1 addendum: nf is per-finger, netgen sums parallel-combined widths
    nf=10 w=5 extracts as 10 discrete w=5u fingers (shared-diffusion chain); w is
    per-finger not total. Strapped in parallel, netgen sums widths: 10x w5 matches a
    single W=50u golden with no property error (W=5u golden property-errors). m sums
    too (4x w5 -> W=20u). => CP_v1_golden.spice W=50u is correct for the nf=10 @ 5um
    layout; hardened gate will not false-fail, provided fingers are strapped
    (gates common, alternating S/D common).
2026-08-12 ibias_gen_v1: retract amendment-1 L=4u CP legs -> uniform L=2u (S1)
    Commit 8341d6c carried the retracted amendment-1 sizing on the DIV2 legs
    MN1/MP1 (L=4u m=10), which caused the 5% systematic. Retract to uniform
    L=2u on all mirrors: MN1/MP1 -> L=2u m=5. This preserves the mirror ratio
    ((W/L)*m unchanged: 10 vs MN0's 48) while making L uniform across the
    generator. Cascodes stay L=1u. Verified L=2u on all mirror legs from the file.
    [ibias_gen_v1.sch]
2026-08-13 ibias(Phase2): verification.md S1-S7 results + reproducible sim decks
    TT collapse: VGP 50.00uA, VGN 49.91uA, IB_DIV2 239.56uA, VDDA 839uA.
    S4 gain/linearity + compliance (every branch envelops CP 0.32-3.00V).
    S4b: separate DIV2 cascode gate justified (~45dB/33dB IB_DIV2->VGN isolation
    vs shared gate).
    S5: generator adds a UNIFORM +0.18% to CP UP/DOWN mismatch (= the 50.00/49.91
    VGN deficit); the CP's +/-2% mismatch-vs-CP_OUT is intrinsic output-impedance,
    present with ideal sources too. The 0.001% was the topology single-point
    zero-crossing, NOT the delivered circuit (~0.18% at TT).
    S6 corners (process tracking only, NOT random mismatch -> needs MC):
    CP added-mismatch FF 0.004% / T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
2026-08-13 verification.md: fix CP-leg mislabel, note CP_core==golden, split PSRR static/dynamic; commit ibias_diag_tb
    - MN1/MP1 are the CP output legs (VGP sink / VGN source), NOT DIV2 legs; ratio
    is 5/24 to MN0/MP0 ((W/L)*m = 10 vs 48).
    - Record that CP_core (S5 sim) is identical in ports/devices/connectivity/sizing
    to CP_v1_golden.spice -- sim-CP and golden-CP are the same circuit.
    - Distinguish the 0.18% STATIC mismatch (~1ps, negligible) from VGN supply
    RIPPLE (1.16%/V, dynamic spur path) -> Phase 5 layout requirement (Vb_p decap,
    quiet VDDA away from digital). Static phase-offset bound does not cover ripple.
    - Commit ibias_diag_tb.sch (diagnostic that found the 5% systematic).
    Co-Authore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
    [ibias_diag_tb.sch]
2026-08-13 DIV2(Phase3): self-biased AC-coupled converter -- removes threshold-match class
    Root cause of the 3 prior failures was a class: absolute-threshold match between
    nodes whose levels drift independently (PVT/bias/loading). Fix by construction:
    keep the diff-pair front end (OC), then AC-couple OC->G1 (CC 100f) into a
    self-biased inverter (RFB 20k INVO1->G1) that pins G1 at its own trip across PVT.
    No absolute level to match.
    Old design collapsed at TT (21 mVpp @ 16-20ns). New design divides correctly at
    EVERY corner (TT/FF/SS, -40/+85C): settled 2.500 GHz, exact 270.0deg quadrature
    (4 matched chains), I_P 114-148 mVpp (>124mV built target), duty 49% (fast)-57%
    (slow). Supply 22.4 mA avg << 50 m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
2026-08-13 DIV2: regenerate schematic from updated generator (self-biased converter + startup .ic)
    DIV2_QUAD_v1.sch is a GENERATED artifact -- update the generator, not the .sch.
    gen_div2_quad.py now emits the Phase 3 topology (CC ac-couple OC->G1, self-biased
    INV1 with RFB, balanced INV2, 44/16 driver) on all 4 chains, identical by
    construction. gen_div2_quad_tb.py adds the startup .ic (CML seed + G1 self-bias
    pre-charge) and 20 ns tran. Both moved from _cp_work scratch into team_src/xschem/
    with output paths relative to the script (were hardcoded Windows paths; superseded
    _cp_work copies deleted to remove the stale-generator drift hazard).
    Regenerated netlist reproduces the validated design directly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
    [DIV2_QUAD_tb.sch, DIV2_QUAD_v1.sch]
2026-08-13 VCO(Phase4): fix inductor include portability + characterize (power/swing/startup/PVT)
    4.1 vco_inductor_v2.sym spice_sym_def: /foss/designs/xschem/... (nonexistent) ->
    $UPRJ_ROOT/team_src/xschem/... (portable across clones, Phase 7.2 convention).
    4.2 At ISM VTUNE=2.15V, current netlist (=origin/main): near-rail core swing
    ~2.0Vpp-se/4.0Vpp-diff all corners; startup ~8ns build (settled ~24ns, ~14ns
    op-metastability latency); core power 1.2-1.6mA (~4-5mW), 5mA/16.6mW incl TB
    buffer; freq PVT 4.64-4.83GHz (process) / 4.74-4.76 (temp).
    4.3 GAP 1 (flagged): the 3.1 f-VTUNE table is NOT reproducible on the current
    netlist -- same schematic+inductor, method validated (buffer==co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
2026-08-13 VCO GAP1 RESOLVED: container stable, 3.1 mid-curve was error, corrected f-VTUNE sweep
    Discriminating test first (per Greg): CP_v1 DC compliance reproduces 0.32-2.98V /
    best 0.0011% @1.5V vs the 2026-07-22 record 0.32-3.00V/0.001% -> CONTAINER STABLE,
    no drift, whole pre-7/30 evidence base safe. Toolchain fingerprint recorded
    (ngspice-46 KLU, open_pdks 7b70722e, Ubuntu 24.04.4) for future drift detection.
    So 3.1 was a measurement error, not drift. Re-ran f-VTUNE (justified: number
    disputed, Plan B rests on it): band edges MATCH (4.05-6.38 vs 3.1's 4.11-6.37) but
    3.1's steep 0.8-1.2V mid-curve does not reproduce -- corrected curve is smooth/
    monotonic. Corrected ISM: VTUNE ~1.95-2.12V (was 2.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
2026-08-13 Phase 5.1 opener: guard 0 vs guard 1 DRC test -> guard 0 + manual group ring
    guard rings the whole DEVICE (nf arrays within one device DRC-clean either way).
    The blocker is the matched PAIR: M_PREF+M_PSRC must common-centroid interdigitate,
    and under guard=1 each device gets its own ring -> two rings can't interleave.
    Decision: guard=0 on mirror devices + one manual group ring (guard=0 arrays are
    DRC 0, feasible). Settled before committing array topology. Build-stage plan +
    golden-dummy plan recorded in team_src/magic/phase5/README.md.
2026-08-13 Propagate corrected VTUNE/KVCO to scope.md + condition-7 notes; generalize guard rule
    scope.md Plan B: VTUNE window 2.05-2.28 -> 1.95-2.12V; f-VTUNE table corrected
    (band 4.05-6.38GHz, ISM at VTUNE~2.0V); KVCO avg -706MHz/V, local near ISM
    -1.1GHz/V (old -790 / -1.4 mid-range were the non-reproducible 3.1 mid-curve).
    Condition-7 bring-up notes added: loop BW ~+18% (sqrt KVCO) + phase-margin shift
    for the off-chip filter; reference spurs scale with KVCO so CP's +110fC -> ~1.4x
    VTUNE deviation (static phase-offset bound KVCO-independent, unchanged); DIV2 ~30ns
    bench settling.
    Guard rule generalized (phase5 README): only matched pairs need guard=0 + manual
    group ring; single multi-finger device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
2026-08-13 verification.md 4: fill fix leads with pre-fill-own-block (not organizer keep-out)
    Own the fill: pre-fill our block to density with a manual keep-out around the spiral
    so the handed-over GDS is already compliant -- removes dependency on the organizer's
    untestable fill flow. metalX_blk = residual density exemption; waiver documents both.
    Fallback keep-out ask narrowed to inner-opening + ~1 trace-width (where fill hurts Q).
    Flagged Bailey fill-ownership question (team vs integration script) -- Greg to ask.
2026-08-13 Phase 5.1(b,c): CP two-band placement DRC-clean at device level; strapping cost characterized
    Matched pair (b) DRC 0. All 8 devices + 4 dummies placed in two bands, spaced G=400
    -> 70 DRC (all Metal1 min-area/spacing on bare unrouted S/D tabs -- clear on routing).
    Crux for (e): generator leaves nf devices as shared-diffusion contact tabs (no strap
    rails, widest metal1 46u); each needs alternate-column S/D strapping (metal2 rails +
    M1-M2 vias) to become the parallel W=50 device the golden expects. Method + column
    coords documented in phase5/README. Load-bearing effort, repeats per nf device.
2026-08-13 Phase 6.1: Mohan analytical inductor cross-check -- does NOT confirm 1.2nH pi-model
    Geometry: single-layer center-tapped differential square spiral on metal5 (28 segs)
    + metal4 underpass bridge -- not a 2-layer stack. Mohan current-sheet (n=3 square,
    D_out=76 D_in=20) = 0.49nH, 2.4x below the 1.2nH pi-model (far outside Mohan's ~15%).
    Differential N-per-side ambiguity could bracket up to ~1.95nH; plausible range 0.5-2nH.
    1.2nH NOT analytically confirmed. f~1/sqrt(L) -> ~1.2-1.55x VCO freq uncertainty ->
    Plan B band materially exposed; at low-L end ISM risks going out of reach. Elevates
    EM (6.2) from cross-check to critical-path; prefer accept-and-replan per 6.3.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
2026-08-13 Phase 5.1 strap method + 5.3 resistor flavor (ppolyf_u_1k)
    Full strapping recipe worked out (device-local via gencell_makecell; metal2 rails
    stacked clear of the device with metal1 risers to avoid the 35u gate/SD tab collision;
    source/drain/gate rails at y 730/-730/900; port labels). Routing itself is a large
    iteration-heavy headless effort -> queued. 5.3: R_SER flavor = ppolyf_u_1k (1000 ohm/sq),
    1 square for 1k, W>=2um for ~3.3mA, ~100um2 for four.
2026-08-13 tracking.md: update conditions 2/4/5/6 to real state (Phase 3/4/6.1 done)
    Cond 2 DIV2 now divides (Phase 3 self-biased converter). Cond 4 PFD min pulse
    re-confirmed 0.500ns. Cond 5 VCO characterized (swing/startup/power/PVT), f-VTUNE
    corrected, phase-noise gap documented. Cond 6 Mohan done -- 1.2nH not confirmed,
    EM critical-path + queued.
2026-08-13 Phase 6.2: openEMS extraction script (from .mag geometry) + install queue
    Bundled wheels are cp313/cp314; user Python is 3.12.10 -> incompatible. README gives
    exact install path (Python 3.13 + bundled cp313 wheels + PATH). extract_inductor.py
    reproduces the metal5 geometry, lumped-port FDTD, L/Q/SRF -- UNTESTED pending install.
    Metal5 z-stack is placeholder (L stack-insensitive; Q/SRF need real gf180 stack).
2026-08-13 Phase 5.1(e): strapping generator -- electrical strap proven, gate/S-D DRC congestion wall
    strap_device proc (device-local, parameterized) straps a raw nf device via metal1
    risers + metal2 rails + m2contact. Electrical strap WORKS: pfet nf=10 combines to
    1 gate + 2 S/D rails (parallel W=50). DRC 204->30 after via/metal sizing; remaining
    30 = M1.2a in the gate/S-D contact band (gate tabs ~54u/35u from S/D cols; strap
    metal1/via pads break the 46u rule). guard=1 doesn't help (also 10 unstrapped).
    Universal congestion -> needs opposite-side via-at-tab multi-layer routing, best
    interactive. QUEUED. This is the load-bearing wall for 5.1(e-g) and 5.2-5.4.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
2026-08-13 Phase 5.1: refined strap recipe (poly gate-rail + multi-layer S/D) for interactive execution
2026-08-13 Phase 5.1(e): strapping generator WORKS -- DRC 0 + netgen combines nf=10 to W=50
    Poly-gate topology cracks the congestion wall: generate device with topc=0 botc=0
    (no gate metal1 contacts), strap gates on a POLYSILICON rail (one contact at the far
    end over field), S/D on metal2 (source top / drain bottom). metal1-vs-poly is
    inter-layer so the gate/S-D band is empty by construction. strap_device proc reusable
    across blocks; gf180 minimums hoisted to constants (via 52, m1 encl +12, metal2 56,
    riser +12). Verified on pfet nf=10 w=5 L=2: STRAP_DRC=0, netgen Number of devices 1|1,
    match uniquely (W=50). Closes the deferred Phase 1 routed-strapping check. Unblocks
    5.1(e-g) and 5.2-5.4.
    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
2026-08-13 phase5 README: strapping SOLVED (wall broken); document remaining CP build plan
2026-08-13 Phase 5.1 Item A + PMOS mirror: interleaved split-drain DRC 0 + LVS combine 20->2
    Item A: per-finger W EXACT (Wsum=50u across nf configs); 49.855 was a magic merge-display
    artifact, not per-finger, doesn't scale with nf -> IBIAS ratios safe.
    PMOS mirror interleaved nf=20 common-centroid (ABBA): gate poly-rail=VGP, source=VDD M2,
    VGP-drains M2, PMID-drains M3 (via1+via2 at tab). DRC 0; netgen 20->2 merged, match
    uniquely vs golden (port artifact only). strap.tcl now a clean library (via2=56 hoisted).
2026-08-13 Phase 5.1: NMOS mirror interleaved DRC 0 + LVS combine 4->2; both mirror flavors proven
    M_NREF+M_NSNK nf=4 interleaved, split drains VGN(M2)/NMID(M3), same method as PMOS.
    DRC 0; netgen merged 2 parallel, match uniquely vs golden. Both interleaved mirrors
    (PMOS 20->2, NMOS 4->2) now DRC-0 + LVS-verified. All structural layout methods proven;
    remaining is mechanical assembly (switches/inverter/dummies + place + route + guard
    rings + ports + verify) on the proven procs. README updated.
2026-08-13 Phase 5.1 assembly stage 1: both mirrors in two-band floorplan, DRC 0
    PMOS mirror (nf=20) at (0,0), NMOS mirror (nf=4) at (0,-3600), placed via
    box(FX-hw,FY-hh)+gencell then flattened into CP cell; strapped at CP coords (NMOS
    y-offset -3600 via yn helper). CPFULL_DRC=0. Multi-device flat assembly infra proven.
    Next: switches/inverter/dummies + routing + guard rings + ports + verify.
2026-08-13 Phase 5.1 assembly stage 2: +M_PSW +M_NSW switches strapped, DRC 0 (4 devices)
    Both mirrors + both switches in the two-band floorplan, DRC 0. M_PSW source->PMID/
    drain->CP_OUT/gate->UP_B; M_NSW source->NMID/drain->CP_OUT/gate->DOWN (poly-rail gates,
    contacts left-side). Fixed: gate contact must be left of poly rail (else rail runs
    backwards); single-col rails need >=min area; gate contact clearance from source col.
2026-08-13 phase5 README: assembly 6/8 devices DRC 0; inverter tiny-device strap + remaining plan
2026-08-13 strap.tcl: assert gate_polyrail contact is LEFT of array (cx<px2) -- fails loudly on the backwards-rail geometry bug instead of silently making bad metal2
    Also validated inverter approach (Greg): nf=1 inverters need NO strapping -- default
    topc=1 native gate contact is correct, no gate_polyrail (which trips PL.5a/CO.7 on a
    2-column device -- a rail does not belong there). Confirmed: topc=1 INVP/INVN place
    DRC-0 standalone and in-floorplan (residual DRC = unrouted native tabs, cleared by
    routing). cp_full stays at the 6-device DRC-0 baseline pending the routing pass.
2026-08-13 CP routing: 3 inter-device nets (CP_OUT, PMID, NMID) on M4 -- DRC 0
    Layer-per-net (Greg item 1): the inter-band nets that must cross other rails go on
    metal4, so a crossing is inter-layer (no short) rather than a 2D routing puzzle. via3/
    via4=52 (like via1), via2=56; upper metals enclose vias by only 2 (vs 12 for via1).
    New helpers in strap.tcl: via_m2m4 (via2+via3 stack), via_m3m4 (via3 on an existing
    M3 rail), m4route. CP_OUT vertical at x7000 crosses NSW NMID(M2) inter-layer -- the
    exact case flagged as 'a short' when both were M2. 6-device net still DRC 0.
2026-08-13 CP: all 8 devices placed + routed, DRC 0 (inverters + full net routing)
    Inverters: topc=0 botc=0 (bare poly gate) is DRC-0 standalone; topc=1 puts a gate
    metal1 tab 43u from the S/D tabs (<46, M1.2a) -- inherent to the L=0.3 device, fires
    under any guard setting. Fix: contact the gate poly ABOVE the device (poly extended up,
    polycontact clear of S/D) -- the single-device analogue of gate_polyrail. Gate metal1
    now 78u from S/D, clean.
    Net routing by layer-per-net: UP on M3 (x9000), UP_B on M4 (x9200, drains extended
    right), VDD/VSS on M5 (M5.1 min width is 88, not 56 -- top metal is wide); the three
    inverter vias spread to x8800/9000/9200 so their stacks don't collide on shared layers.
    via_m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
2026-08-13 CP_v1 GATE PASS: DRC 0 + LVS match uniquely + 7 ports, main unfrozen
    verify_cp.sh CP_v1 -> exit 0. All 8 golden devices matched.
    Two bugs that blocked connectivity, both silent (no DRC, no error):
    1. label NAME metal2 -- magic parses the 2nd arg as a FONT, not a layer, so the label
    was never created. NONE of the nets were labeled. Fix: label NAME (auto-attaches to
    the layer under the box). This also silently affected the earlier isolated LVS tests.
    2. paint m4contact / m5contact -- those aliases do not exist; via3/via4 are painted as
    "via3"/"via4". Every M4/M5 route was disconnected from below (LVS DO NOT MATCH,
    VDD/VSS/UP_B split). Fix: paint via3/via4. And magic wants via3/via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
2026-08-14 IBIAS: golden netlisted from live schematic + m-parallel strap PROVEN
    Golden: netlisted ibias_gen_v1.sch headlessly (xschem -n) -> ibias_gen_v1_golden.spice,
    16 devices (7 nfet W=4, 9 pfet W=16 incl. CDEC decap), wide-swing cascode bias gen.
    The stale team_src/sim/ibias/*.spice were inconsistent (ibias_sub vs ibias_sub_shared
    disagree on XMP2c gate) -- netlisting the live .sch was necessary, not optional. Total
    224 unit devices (m up to 24).
    Deferred Phase-1 check PROVEN (mtest.tcl): 3 separate unit nfets strapped on ALL FOUR
    terminals (drains->D, sources->S, gates->poly rail G, bulk->S via pwell tap) -> netgen
    combines 3 devices into m=3 and matches uniquely. DRC 0, verify_cp mtest exit 0.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
2026-08-14 IBIAS checkpoint 1+3 (nfet): strapped mirror leg DRC 0 + LVS combine m=5
    Reframe confirmed: each golden device (m fingers, all one drain net) = one gencell
    nf=m, so IBIAS is 16 strapped devices at CP scale, not 224 placements. Sizing ~150x64um
    ~9.6k um^2 (block layout), within ~15% of the ~8-9k estimate; no area surprise.
    nfet leg proven: nf=5 W=4 L=2, sources->S rail, drains->D rail, gate poly rail, bulk
    ->pwell tap. netgen combines 5 fingers -> m=5, match uniquely, 3 ports clean, DRC 0.
    FINDING (new toolchain fact for the W=4 nfet legs): gate_polyrail's 84-tall poly rail
    does NOT fit the 57u band between the W=4 diffusion top (y387) and the gate-arm top
    (y444) -- it trips PL.1 (poly widt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
2026-08-14 IBIAS 5.2 CP2: parameterized nfet leg generator; nf=24 reference leg
    ib_nleg.tcl generalizes ib_ntest (nf=5) to arbitrary nf. Wide multi-finger
    strap (source->S bottom rail, drain->D top rail, gate poly rail) with a ROW
    of substrate taps at column midpoints (5040-unit spacing) so every finger of
    the ~60um-wide device is within 20um of a tap (DF.14_LV, KLayout-only).
    nf=24 W=4 L=2 (96um total, under the 200um model-bin wall):
    magic DRC 0, KLayout DRC 0 (variant D), netgen 24 fingers -> match uniquely
    m=24, 3 ports. De-risks the widest device before the ratio pair.
2026-08-14 IBIAS 5.2 CP3a: NMOS mirror row MN0:MN1:MN2:MNB (24:5:24:2) DRC0 + LVS
    ib_block.tcl composable strapped-leg library (place_nfet/nfet_leg/via_m2m3);
    ib_nmir.tcl builds the 4-device NMOS mirror row of ibias_gen_v1. All gates=NB,
    all sources=VSS merged by continuous M2 bars (NB@y960, VSS@y-600) bridging the
    per-leg rails; MN0 diode drain risered to NB. Ratio-critical 24:5 mirror set.
    magic DRC 0, KLayout DRC 0 (variant D), netgen 55 fingers -> 4 devices ->
    match uniquely, 5 ports (NB n1 n2 VBCPD VSS).
    Two reusable findings baked in:
    - nfet_leg paints UNLABELED rails; driver labels each net ONCE at its port
    (duplicate same-name labels break port make -> node-with-no-pin).
    - a metal2 lab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
2026-08-14 6.2 inductor EM: openEMS setup (builds+runs); solve DEFERRED per rule 4
    ind_em.py parses vco_inductor_v2.mag (20 units/um), builds the gf180mcuD
    metal4/via4/metal5/rm5 stack at real z-heights (from the magic tech height
    lines), places a differential lumped port across the 30um gap between the two
    metal5 leads (no ground plane -> Z11 = jwL+R of the coil), meshes (edge-decimated
    to 1.5um min so the 0.5um underpass slivers don't crater the timestep), and
    post-processes Z11 -> L/Q/SRF vs the 1.2 nH pi-model.
    Verified: model builds, FDTD engine runs (32k cells, dt 9.6e-16 s, ~3-6 MCells/s).
    SOLVE DEFERRED: low-freq pulse needs ~297k timesteps; dt capped by the 0.55um
    metal4 thickness (thin 3D z-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
2026-08-14 docs: inductor .mag DRC clean (magic+KLayout) + 5.2 IBIAS progress/gotchas
    verification.md 4.0: vco_inductor_v2.mag is DRC-clean in BOTH magic (0) and
    KLayout (0, variant D, 247 polys) -- resolves 5.4's early DRC gate; density
    (--density) not run, so the metal-fill question stays open+separate.
    verification.md 4.1b: openEMS EM setup builds+runs, solve deferred (rule 4),
    conducting-sheet resume path documented.
    phase5 README: CP2/CP3a results + the place-all/flatten-once/strap pattern, the
    wide-device tap-row rule, and the two CP3a label gotchas (label-once-per-net;
    label-over-pwell -> clear-field pad).
2026-08-14 5.3 R_SER on-chip (no gap) + magic label layer-form proven (run #2 A+B)
    A (R_SER reconcile): the 12 resistors in DIV2_QUAD_v1 are 4 CML loads(300) + 4
    RFB(20k) + 4 R_SER(1k). R_SER emitted by gen_div2_quad.py L95 into each converter
    chain (INVO3->output port), inside the .subckt -> on-chip, not testbench-only. No
    schematic gap. (Queue premise of 8 CML loads was wrong: /2 = 2 latches x 2 = 4.)
    Open only for 5.3 layout: map ideal R -> ppolyf_u_1k in the golden.
    B (label signature): magic 'label str [pos [layer]]' -- explicit layer form
    'label NAME center metal2' attaches to metal2 over pwell (proven on throwaway
    cell: rlabel metal2 vs rlabel pwell). Clear-field-pad workaround unnecessary.
    REA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
2026-08-14 5.2 gate C: end dummies on NMOS mirror row (24:5:24:2) DRC0+LVS
    Add an nf=2 end dummy at each end of the ratio-critical array (gate to NB, S+D
    tied to VSS via a drain-down riser) for a matched edge environment on the 24:5
    mirror. Netgen merges the 4 dummy fingers (VSS NB VSS VSS) to one m=4 device,
    added to the golden as a tied-off instance.
    magic DRC 0, KLayout DRC 0 (variant D), netgen 59 fingers -> match uniquely,
    5 ports unchanged (NB n1 n2 VBCPD VSS).
    Also switched port labels to the proven explicit-layer form (label X center
    metal2, queue B) -- VBCPD no longer needs the clear-field pad; no pwell-snap.
2026-08-14 5.2 gate D (part 1): parameterize generator for L=1 (cascode pitch)
    place_nfet/nfet_leg take optional L (default 2). pitch_for_L: L=2 -> 504,
    L=1 -> 304 (measured from a generated L=1 device: S/D contacts at pitch 304).
    Vertical strap constants are W-dependent, unchanged. Gate-bridge half-width set
    to 100*L so it matches the gate-poly width -- a fixed 200 overhangs the S/D
    contacts at the tighter L=1 pitch and trips PL.5a/CO.7.
    Validated on ib_l1test (nfet nf=5 W=4 L=1): magic DRC 0, netgen 5 -> match
    uniquely m=5, 3 ports. Unblocks the NMOS cascode row (MNC0/1/2 at L=1).
2026-08-14 5.2 gate D: full NMOS side (7 devices + dummies) DRC0 + LVS match uniquely
    ib_nmos: two-row NMOS side of ibias_gen_v1.
    - bottom row (L=2, y=0): mirror MN0/MN1/MN2/MNB (24:5:24:2) + end dummies.
    - top row (L=1, y=YC=2000): cascodes MNC0/MNC1/MNC2 (24:5:24), gate bar = IBIAS,
    MNC0 diode-connected. Cascode bulk = shared pwell (no own taps), VSS-tied by the
    mirror taps -- placement keeps every cascode nfet within 20um of a mirror tap
    (DF.14_LV), so no separate bulk rail is needed.
    - inter-row: NB on M2 (MN0.drain -> NB bar -> MNC0.source, no crossing); n1/n2 on
    M3 to jump the NB M2 bar (via_m2m3 both ends) -- layer-per-net-class.
    Generator gains yoff (row offset) and taps (skip pw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
2026-08-14 5.2 gate E (part 1): pfet_leg generator + wide-leg 200um-split de-risk
    place_pfet/pfet_leg for pfet_03v3 W=16 L=2. Read from a flattened device: same
    x-pitch as nfet (504) so column/gate formulas carry over, but the device is tall
    (nwell 3460, S/D contact strip y+/-1587) and in nwell. Strap reuses strap_col to
    widen the 46-wide contact metal1 for the via; source rail bottom (yoff-1500),
    drain rail top (yoff+1500), gate poly rail (yoff+1646) overlapping the finger
    tops -> M2 PB rail (yoff+1780). nwell taps (nsubdiff/nsubdiffcont) BELOW the
    gate-poly bottom extension (clear NP.4b=64) and >=180 tall (DF.9 min area 8100),
    tied to VDD.
    Validated on ib_ptest (pfet nf=12 W=16 L=2 = 192um, under the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
2026-08-14 5.2 gate E (part 2): PMOS mirror row DRC0 + LVS match uniquely
    ib_pmir: PMOS mirror row of ibias_gen_v1 (L=2). Source=VDD bar; each wide m=24
    leg (MP0, MP2) split 2x nf=12 (192um, under the 200um model bin) -- the halves
    combine in netgen. Gates on a PB bar (MP0/MP1/MP2/XCDEC); MP0 diode-connected
    (drain->PB). XCDEC decap gate=PB with D=S=VDD. MPB is a separate pb2 diode
    (gate=drain=pb2, off the PB bar) generating the VBCPD-branch reference.
    magic DRC 0, KLayout DRC 0 (variant D), netgen 61 fingers -> 5 devices ->
    match uniquely, 5 ports (VDD PB pb2 p1 p2).
2026-08-14 5.3 item 1: correct stale DIV2 device count (45+8 -> 59 FET + 12 R + 4 caps)
    Counted the generator directly (gen_div2_quad.py): CML core = 12 nfet; loads =
    4x 300R (RA1/RA2/RB1/RB2, one per output OI/OIB/OQ/OQB = 2 latches x 2, NOT 8);
    NMOS bias = 3 nfet; each of 4 converters = 6 nfet + 5 pfet + RFB 20k + R_SER 1k +
    CC 100f. Total 59 FET + 12 R + 4 caps, matching the netlist. The "45 FET + 8 R"
    in div2-debug.md was the pre-2026-08-12 single-inverter converter; the self-biased
    3-stage rework (f600af3) added devices. Nothing missing; R_SER all on-chip.
2026-08-14 5.2 E.3 prep: parameterize pfet_leg for L=1 + fix pfet nwell-tap short + tapy
    - place_pfet/pfet_leg gain an L param (pitch_for_L: L=2->504, L=1->304). L=1 pfet
    vertical geometry is identical to L=2 (only pitch differs); gate rail spans the
    array so no bridge-width change needed.
    - BUG FOUND (rule 8): the pfet nwell tap sat at xoff-maxc+252, the column midpoint
    only at L=2 pitch 504. At L=1 pitch 304 the true midpoint is +152, so +252 put the
    tap 52 units from the drain column and its metal1 riser (at the tall pdiffc y)
    ABUTTED the drain contact -> shorted VDD to the drain (netgen X0 D G D D, VDD absent,
    DO NOT MATCH). Fix: taps at P/2 offset, 10*P spacing -- identical at L=2, cor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
2026-08-14 5.2 E.3: full PMOS side (9 devices) DRC0 + LVS match uniquely
    ib_pmos: two-row PMOS side of ibias_gen_v1.
    - bottom (L=2, y=0): mirror MP0/MP1/MP2 (m=24/5/24, wide legs split 2x nf=12) +
    XCDEC decap + MPB pb2 diode. As ib_pmir.
    - top (L=1, y=4400): cascodes MP0c/MP1c/MP2c/MPBc. TWO gate bars: PA over MP0c/MP1c,
    VBCPD over MP2c/MPBc. MP0c and MPBc diode-connected. Cascode nwell taps tied to a
    dedicated VDD rail (tapy=-1700) routed up on M4 -- the tall rows sit too far apart
    to share the mirror taps.
    - inter-row sources PB/p1/p2/pb2 on M3 over the bars; split nets (PB, p2) get a riser
    per half (a single midpoint riser lands in the gap between split halves).
    Two bugs caught + f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
2026-08-14 5.2 GATE F: full ibias_gen_v1 block DRC0 + LVS match uniquely -- 5.2 CLOSED
    Four-row stack assembling the two proven sides in one flat cell:
    NMOS mirror (y=0) | NMOS cascode (y=2000) | PMOS mirror (y=6000) | PMOS cascode
    (y=10400). NMOS side = ib_nmos, PMOS side = ib_pmos (+YP=6000); all intra-side
    bars/rails/inter-row routing re-emitted with the PMOS y-offset.
    Cross-band nets on M5 (L-shaped, corners run +M5HW to avoid the MT.1 88 notch):
    PA = NMOS MNC2 drain <-> PMOS MP0c gate/drain (PA bar).
    VBCPD = NMOS MNB drain <-> PMOS MP2c gate + MPBc (VBCPD bar).
    Golden gains the layout end-dummy (XMDUM, gate=NB S/D=VSS, m=4) per the ib_nmos
    precedent.
    GATE (verify_cp.sh ibias_gen_v1, exi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
2026-08-14 5.2 docs: ibias_gen_v1 layout-complete note (verification 2.6.1) + block render
    Record the DRC/LVS sign-off (Magic 0, KLayout 0, 228 fingers -> match uniquely,
    6 ports, exit 0) and add the rendered block image (lay2img white/black).
2026-08-14 5.2 item 4: 24:5 mirror common-centroid (A-B-A) + dummy-tie decision
    Matching restructure of the ratio-critical NMOS mirror, applied in ib_nmir4,
    ib_nmos, and the full ibias_gen_v1:
    - MN0 (m=24) split into two nf=12 halves flanking MN1 (A-B-A) so MN1 sits at
    MN0's centroid -> linear gradients across the 24:5 pair cancel. Both halves are
    drain=gate=NB, so netgen merges them to m=24 and the goldens are UNCHANGED.
    Cascodes realign (cC1 over MN1, cC2 over MN2; MNC0 reaches NB via the bar).
    - Dummy gate tie KEPT on NB (not VSS), deliberately: a uniform gate-field at the
    array edge beats a VSS potential step there; the cap lands on the low-Z diode
    node NB where it is negligible. R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
2026-08-15 5.2 item 0: surface golden/schematic dummy divergence + close MN2:MN1 question
    0a. Make the intentional golden!=schematic delta reviewer-visible: verification.md
    2.6.1 and tracking.md 4 now state ibias_gen_v1_golden.spice carries 17 instances
    (16 .sch devices + one tied-off layout dummy XMDUM m=4); the schematic stays at
    16 and is not edited; full-chip LVS off the .sch must add the same dummy or waive
    the one-device count delta.
    0b. MN2:MN1 is NOT ratio-critical: all legs mirror the MN0 reference; MN1->VGP and
    MN2->PA are independent outputs. Critical ratios are MN0:MNx. MN0:MN2 is 1:1
    (robust); centroiding it needs a 48-finger interleave -> not warranted. Question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
2026-08-15 5.3 prep: DIV2 device/net inventory + layout plan (container down this run)
    Docker Desktop engine was down all of run #4 and could not be restarted (rule 1),
    so no magic/netgen/KLayout/xschem ran. Host-only prep from the authoritative
    generator (gen_div2_quad.py): full 59 FET + 12 R + 4 C inventory with nets/sizes,
    the golden's transistor lines ready to paste, the new-device de-risk table (W=40
    nfet, ppolyf_u_1k at w2l2=1k / 300 / 20k, CC 100f cap flavor), the floorplan
    approach, and the OPEN device-syntax questions (ppolyf_u_1k + cap LVS forms) that
    must be resolved in-container before the golden is valid. No DRC/LVS claimed.
2026-08-15 5.3 1a/1b/1c: device de-risk + generated golden (rule 12)
    Answered the two open device-syntax questions in-container:
    - ppolyf_u_1k resistor extracts as 3-term X e1 e2 bulk ppolyf_u_1k r_width/r_length;
    netgen checks the geometry; tap terminals by painting metal1 over the end
    polycontact (not the guard-ring metal1). Validated: res1k DRC 0 + match uniquely.
    - MIM cap extracts as 2-term cap_mim_2f0_m4m5_noshield c_width/c_length (m4/m5).
    W=40 CML nfet folds as w=4 nf=10 at L=0.3; pitch_for_L generalized to 200*L+104
    (504/304/164 at L=2/1/0.3) -- identical to before at L=1/L=2, adds L=0.3.
    GOLDEN GENERATED (not typed): mk_div2_golden.py netlists the current .sch and maps
    ideal R->ppolyf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
2026-08-15 5.3 1b: W=40 CML device strapping validated (taps=0 at L=0.3)
    place_nfet 10 x M 0.3 + nfet_leg with taps=0 -> strapped W=40 (w4 nf10 L=0.3),
    magic DRC 0, netgen match uniquely m=10. The per-device substrate tap MUST be off
    at L=0.3: pitch 164 puts the welltap ~0.15um from the outer source via -> V1.2a
    (via1 spacing). So the CML devices share one pwell with taps in clear field (the
    ibias-cascode pattern). Rails come out unlabeled; the CML driver routes each
    device's three rails to its own topology net. Recorded in div2-layout-plan.md.
2026-08-15 5.3 item 0+1: DF.14 closed for taps=0 CML devices + resistor geometries locked
    Item 0 (DF.14): the taps=0 shared-pwell strategy passes KLayout DRC (variant D)
    with a VSS psubdiff tap strip below the device row (clear of the source-rail vias
    to avoid V1.2a). Each W=40 device is ~4um tall so one bottom strip covers a
    single-row latch within 20um.
    Item 1 (resistor geometry lock): enlarged from run-#5 picks to same-ratio larger
    bodies -- 300=w10 l3 (CML load, sets swing via I*R; short body had large end-R
    fraction), 20k=w2 l40 (was w1 at the gencell min where poly matches worst),
    1k=w2 l2. Regenerated the golden (12 res: 4x w10l3, 4x w2l2, 4x w2l40).
2026-08-15 5.3 1d WIP: CML latch placement + strap + DF.14 tap strip, DRC 0
    ib_cml: 6 W=40 nfets (w4 nf10 L=0.3, taps=0) placed in the symmetric row
    [MA5 MA1 MA3 | MA4 MA2 MA6] (MA1<->MA2 input pair, MA3<->MA4 cross pair, MA5<->MA6
    tail each mirror about center -> matched OI/OIB for I/Q), strapped, over a shared
    pwell with a VSS psubdiff tap strip below (DF.14, KLayout-clean per item 0).
    magic DRC 0. NEXT: the ~10 nets of differential routing (TAILA nTA nLA OI OIB +
    gates CK/CKB/OQ/OQB/OI/OIB) -- nTA and nLA overlap across the row so they need
    separate layers; add the two 300ohm ppolyf loads (w10 l3) and ports. Then LVS vs
    the nfet portion of DIV2_QUAD_v1_golden.spice.
2026-08-15 5.3 1d WIP: CML latch 6-nfet core routed, DRC 0 + LVS match uniquely
    The differential routing works: offset access (drain via x-400, source via x+400
    so a device's own S/D routes never share x) + layer-per-net (OIB/OI on M3, nTA on
    M4, nLA on M5, TAILA on M3 at y-750, cross-gates MA3.g=OI on M3 / MA4.g=OIB on M4).
    L-corners extended by half-width to clear the width rules. magic DRC 0, netgen 60
    fingers -> 6 devices -> match uniquely, 8 ports (CK CKB OQ OQB TAILA OI OIB VSS).
    Two bugs caught by LVS (rule 8): TAILA/nTA shorted when both were on M4 (nTA's
    risers crossed TAILA's horizontal) -> moved TAILA to M3; TAILA label left on
    metal4 after the move -> fixed to metal3.
    NEXT: add the two 300o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
2026-08-15 5.3 1d GATE: full CML latch DRC0 + KLayout DRC0 + LVS match uniquely
    ib_cml: one CML latch = 6 W=40 nfets (w4 nf10 L=0.3, taps=0, symmetric row
    [MA5 MA1 MA3 | MA4 MA2 MA6]) + 2x 300ohm ppolyf_u_1k loads (w10 l3). Differential
    routing by offset access + layer-per-net (OIB/OI M3, nTA M4, nLA M5, TAILA M3,
    cross-gates MA3.g=OI M3 / MA4.g=OIB M4); resistor bottoms tap OIB/OI on M3 over
    the gate rails, tops join a VDD M4 rail.
    magic DRC 0, KLayout DRC 0 (variant D), netgen 62 devices (60 nfet fingers ->
    6 + 2 res) -> match uniquely, 9 ports (CK CKB OQ OQB TAILA OI OIB VSS VDD).
    Symmetry: MA1<->MA2, MA3<->MA4, MA5<->MA6 mirror about the row center, and RA1/RA2
    are placed symmetrically over the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
2026-08-15 5.3 1e prep: parameterize nfet device generation for arbitrary W
    place_nfet/nfet_leg gain a W param (default 4, so all existing W=4 callers are
    byte-identical). The vertical strap constants scale with G=100*W (half the active
    height): every W=4 constant C maps to sign(C)*(G+|C|-400) -- rails at G+200, tabs
    G-20, gate poly G+156, gate M2 G+532, pwell G+420, etc. Needed for the converter,
    whose devices are W=4/8/10/11/16 and do not fold to a common unit.
    Validated: strapped W=8 nfet -> magic DRC 0, extracts w=8u l=0.3u with D/G/S
    correct; ib_nmir4 (W=4) regression still LVS match uniquely. (The taps=1 pwell tie
    reports VSUBS at W!=4 -- not chased since the converter uses taps=0 + a shared VSS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
2026-08-15 5.3 1e prep: parameterize pfet device generation for arbitrary W
    place_pfet/pfet_leg gain a W param (default 16, so all existing W=16 callers are
    unchanged). The pfet vertical constants scale with PG=100*W (W=16 base, PG=1600):
    rails at PG-100, S/D strip PG-200, gate poly rail PG+24..68, gate M2 PG+152..208,
    nwell PG+340/PG+230, taps PG+300/PG+120. Needed for the converter's W=8/10/26/44
    pfets.
    Validated: strapped W=8 pfet -> LVS match uniquely; DRC 0 with taps=0 + a shared
    nwell (the converter's mode); ib_pmir (W=16) regression still LVS match uniquely.
    Both nfet and pfet device generation now cover arbitrary W -- the converter's
    device infrastructure is complete.
2026-08-15 5.3 1e WIP: converter diff-pair front-end, DRC 0, LVS connectivity in progress
    ib_conv_dp: 5-device NMOS-input diff-amp (M_NT tail W8L1 + M_BN1/2 W8L0.3 input
    pair + M_BP1/2 W8L0.3 pfet mirror load), the converter's analog front end. Uses the
    new W-parameterized nfet/pfet gens. Shared pwell (nfets->VSS) + nwell (pfets->VDD)
    with tap strips placed clear of the gate stuff (nwell tap ABOVE the pfet gate M2).
    STATE: magic DRC 0. LVS NOT yet matching -- diagnosed (rule 8): the pfet source->
    VDD M3 verticals were routed at the same x as the drain via_m2m3/m2m5, so their M3
    pads short (pfets extract as OC OC OC OC).
    NEXT (clear fix): connect the pfet sources to VDD with an M2 bridge at the source-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
2026-08-15 5.3 1e sub-block PASS: converter diff-pair front-end LVS match uniquely
    ib_conv_dp: 5-device NMOS-input diff-amp with PMOS current-mirror load -- the
    converter's analog front end. Fixes the pfet-source->VDD short (rule 8): the two
    source risers shared x with the drain vias, collapsing the whole pfet region onto
    OC. Now both pfet sources are joined by an M2 bridge at the source-rail y and a
    single M3 riser at the far LEFT (clear of the drain vias and gate M4) climbs to the
    nwell tap strip.
    GATE: magic DRC 0, LVS match uniquely (5 devices, 6 ports CK-mapped IBIAS/INP/INM/
    OC/VDD/VSS). Extraction confirms the topology: MBP1 diode-connected (d=g=DN1,s=VDD),
    MBP2 mirror out (d=OC,g=DN1), tail MNT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
2026-08-15 5.3 1e device de-risk: all converter FET widths DRC-clean (nfet 4/11/16, pfet 10/26/44)
    Before laying out the inverter chain, proved the W-parameterized gens hold at the
    converter's large widths (only W8 was validated before):
    derisk_nfetw: nfet W4 + W11 + W16 (L0.3, taps=1 self-contained) -> DRC 0
    derisk_pfetw: pfet W10 + W26 + W44 (L0.3, taps=0 + shared nwell) -> DRC 0
    A first combined attempt threw 36 errors but they were ALL de-risk-script artifacts
    (sloppy hand-painted shared wells: a mis-placed nsubdiff strip + missing metal1 over
    the tap contact -> CO.6). Isolating each device with the validated recipe -> 0/0.
    The gate M2 stuff on the W44 pfet reaches YP+4608, so a shared nwell t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
2026-08-15 5.3 1e sub-block PASS: CMOS inverter (INV1 10/4) LVS match uniquely
    ib_inv1: converter INV1 (pfet W10 / nfet W4, L0.3) -- the reusable CMOS inverter
    topology for INV2 (26/11) and INV3 (44/16). nfet bottom, pfet top; gate tie (IN) =
    vertical M2 at far-left joining both gate M2 rails; drain tie (OUT) = vertical M3 at
    x0 crossing the gate M2 inter-layer; VDD riser on the RIGHT to the nwell tap strip.
    GATE: magic DRC 0, LVS match uniquely (2 devices, 4 ports). pfet OUT/IN/VDD/VDD,
    nfet OUT/IN/VSS/VSS.
    GOTCHA found + fixed (rule 8): nfet_leg taps=1 paints NO substrate tap on a single-
    finger device -- welltap's loop starts at xoff-maxc+252 (=x170 for maxc=82), already
    past xoff+maxc, so the body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
2026-08-15 5.3 1e: parameterized inverter gen -- INV2 (26/11) + INV3 (44/16) LVS match uniquely
    ib_inv_gen.tcl: make_inv {cell Wn Wp} builds a full CMOS inverter with every y-constant
    derived linearly from Wn/Wp (gate/drain/source rails, YP spacing, wells, tap strips),
    so one proc spans the converter's whole inverter chain. Reproduces the committed INV1
    (10/4) identically and owns the two larger stages.
    GATE: ib_inv2 (pfet W26/nfet W11) and ib_inv3 (pfet W44/nfet W16) each magic DRC 0 +
    LVS match uniquely (2 devices, 4 ports, correct OUT/IN/VDD/VSS). INV3 is the tallest
    instance (W44 pfet, ~9um M2/M3 gate/out/VDD risers) and passed first try -- the
    topology holds at both width extremes, so the chain is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
2026-08-15 docs: record run #6 sub-block status (1d DONE, 1e sub-blocks all PASS)
    Adds the sub-block layout status section: CML latch + diff-pair front-end + all 3
    inverters all magic-DRC-0/LVS-match, converter FET widths de-risked, the single-finger
    taps=1->VSUBS gotcha, and the remaining 1e/1f assembly recipe.
2026-08-15 info.yaml: add pins block (config B, 12 pins) for def generation
    Appends the `pins:` list to info.yaml; the existing `project:` section is untouched
    (diff is additions-only). Field syntax from the upstream resources/info.yaml example;
    pin set + VDDA/VDDD split from docs/pins.md.
    Order is clockwise from bottom-left (upper-left quadrant), chosen for the power-rail
    break rule: VDDA first so all 7 analog pads land on the analog rail, then VDDD breaks
    the ring so the 3 digital pads land on the digital rail:
    VDDA, IBIAS, VTUNE, CP_OUT, I_P, I_N, Q_P, Q_N, VDDD, REF_IN, RST_N, MON_OUT
    12 pins: power 2 (VDDA idx0, VDDD idx8), analog 7 (idx1-7, all secondary_esd: true),
    digital 3 (REF_IN input_cmo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
2026-08-16 info.yaml: set discord handle (1a)
    Fills project.discord (was empty) with the team handle. Validated in-container with
    pyyaml 6.0.3: 12 pins, VDDA@0, VDDD immediately after Q_N, 7 analog between (all
    secondary_esd: true), 3 digital after VDDD, 0 ground, power = [VDDA, VDDD].
2026-08-16 docs(review): fill CP_v1 section with real file-read numbers (1b)
    CP_v1 layout is drawn + gate-passed (2026-08-13), so the [TODO]-placeholder section
    is stale and was the last blocker on advancing main. Replaces every placeholder with
    numbers read from the verify_work logs and the KLayout report, each cited inline:
    - CP.1 Magic DRC 0 (CP_v1.drc.log), KLayout signoff DRC 0 violations
    (klayout_cp/CP_v1_main.lyrdb, main deck incl. latch-up rules), netgen LVS match
    uniquely = 8 devices (4 nfet + 4 pfet, 38 fingers -> 30 merged) / 10 nets / 7 ports,
    zero property + zero port errors (CP_v1.lvs.log, CP_v1.comp.out); verify_cp.sh CP_v1
    exit 0 re-confirmed this session.
    - CP.2 IR drop NOT-DON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
2026-08-16 docs(tracking): density drop-gate results (2a) -- all 4 blocks fail min-density
    Ran KLayout run_drc.py --density_only --variant=D one cell per invocation on PFD_lib,
    CP_v1, ibias_gen_v1, vco_inductor_v2. ALL FOUR FAIL, every failure a MINIMUM-coverage
    floor (>=X%, too little metal), never a max violation. Actual coverage vs threshold
    tabulated in tracking.md 5.2 (COMP/Poly2/M1-M5/MTop). Root cause: no metal fill on the
    sparse standalone blocks -- metal layers sit at 0-6% vs the 30% floor. Expected pre-fill
    state; dummy-fill added at integration meets the minimums. Fill NOT attempted (design
    decision, interacts with analog matching/shielding). ibias passes COMP+Poly2 (device-
    dense); inductor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
2026-08-16 5.3 1e: unify inverters on one make_inv path; retire ib_inv1 one-off
    ib_inv_gen.tcl now builds all three converter inverters (ib_inv1 4/10, ib_inv2 11/26,
    ib_inv3 16/44) via the single make_inv {cell Wn Wp} proc; deletes the hand-built
    ib_inv1.tcl so the assembly carries one construction path per cell type. Regenerated
    ib_inv1.mag from the proc. All three: magic DRC 0, LVS match uniquely (verify_cp.sh).
2026-08-16 5.3 1e: 3-inverter chain flat assembly PASS (rung toward converter)
    ib_inv_chain: refactors make_inv into place_inv_dev (placement) + strap_inv (strap +
    wells + local IN/OUT/VDD/VSS routing at an x-offset, ports unlabeled, coords stashed),
    the flat-assembly form the full converter needs. Chain G1->INV1->S1->INV2->S2->INV3->S3
    with per-inverter VSS/VDD strips tied by left metal1 buses.
    GATE: magic DRC 0, LVS match uniquely (6 devices, 6 ports). Correct topology
    (MIP/MIN1 W10/4, 2 W26/11, 3 W44/16, all OUT=IN(next), VDD/VSS clean).
    Bug found+fixed (rule 8): the chain OUT->IN hop on M3 crossed the intermediate
    inverter's VDD riser (also M3 at xoff+400), shorting S2 to VDD and collapsing the who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
2026-08-16 5.3 1e WIP: full converter assembled, 50 DRC (passive integration in progress)
    ib_conv_v1: all 14 devices placed + strapped in one flat cell -- front-end (native
    diff-pair coords 0..3300) + 3-inverter chain (shifted to x>=4800) + CC MIM cap
    (cap_mim_2p0fF w5 l10) + RFB 20k (w2 l40) + R_SER 1k (w2 l2). Front-end intra-block
    routing (NS/DN1/OC/VDD/VSS) and the inverter chain (M4 hops) are the proven paths;
    VDD/VSS unified via left metal1 buses.
    STATE: magic DRC = 50, ALL in the passive-integration region (RFB resistor x~3900-4300
    + CC cap x~1600 plate access + their terminal connections, error boxes all in x
    3900-4700 / y 5800-11300). The 11 device blocks are the individually-LVS-clean
    front-e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
2026-08-16 5.3 1e WIP: record measured MIM cap plate geometry for the converter
    Measured cap_mim_2p0fF w5 l10 = 1480x2240 iu cell; metal4 (bottom plate) + metal5 (top
    plate) both span the full bbox, via4 between. Contacting is trivial: overlap metal5 =
    top terminal, overlap metal4 = bottom terminal. Recorded in ib_conv_v1.tcl so the next
    pass replaces the placeholder cap hops with real overlap contacts (OC M5 -> cap top,
    G1 -> metal4 -> cap bottom). Does not change the 50-DRC state; captures the key unknown.
2026-08-16 5.3 1e WIP: full converter DRC 0, 14 dev/6 ports, 2 net merges left
    Reworked passive integration -> magic DRC 0 (from 50). All 14 devices + 6 ports
    extract. RFB laid out as SERPENTINE nx2 l20.6 (item 0/2): r_length 40.04u = 20k exact,
    DRC-clean flattened, ONE device (not series), both terminals at the bottom edge
    (LL+376 / LL+856). CC cap contacted by M4(bottom=G1)/M5(top=OC) overlap; layer-per-net
    OC=M5, G1=M4, S1=M3.
    Unit check (item 0): magic drc "<120" is INTERNAL UNITS = 0.6um (200iu/um), matches
    KLayout PRES.3/.4 = 0.6um. The prior "1.2um" note was a 2x overestimate.
    Serpentine bbox 6.76x23.79um vs straight 4.36x43.6um (nx4 was more compact but has 2
    internal flattened-PRES errors -> u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
2026-08-16 5.3 1e: converter magic DRC 0 + LVS MATCH UNIQUELY (KLayout NP.1 remaining)
    Full 14-device converter LVS matches uniquely (magic DRC 0, 14 dev / 6 ports). Fixed
    the two net merges: (1) VDD=VSS -- the metal1 VDD bus hseg crossed the RFB guard-ring
    metal1 (VSS bulk); rerouted the VDD bus on metal2 (crosses RFB metal1 + cap M4/M5
    inter-layer) + fixed the VDD port label (was below the bus). (2) OC=S1 -- the S1 M3
    term-B riser ran under the cap OC/M5 plate; jogged it right (x3200) clear of the cap
    x-range before descending. Both are the "horizontal hop must change layer / clear the
    cap" class.
    KLayout signoff DRC (variant D): 1 rule NP.1 (min nplus width 0.4um), 6 violations at
    the three inverter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
2026-08-16 5.3 1e GATE PASS: full DIV2 converter -- magic DRC 0, KLayout DRC 0, LVS match uniquely
    ib_conv_v1 (14 devices, 6 ports IBIAS INP INM OUT VDD VSS): magic DRC 0, KLayout signoff
    DRC 0 (variant D, clean), netgen LVS match uniquely. Item 1 CLOSED.
    Fixed the last blocker NP.1 (min nplus 0.4um): the inverter VDD nsubdiff tap ending on a
    round +/-2.0um (=+/-400iu) boundary made magic's auto-generated nplus enclose unevenly
    (0.16um top / 0.01um bottom -> a 0.15x0.35um sub-min tab at the corner). Widening the tap
    to +/-420 off the round boundary makes the nplus enclose cleanly. This was latent in
    ib_inv1/2/3 because verify_cp runs magic DRC + LVS only, not KLayout.
    Converter recipe proven end to end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
2026-08-16 5.3 item 2: mk_div2 20k -> serpentine r_length 40.04u (RFB compaction)
    RFB COMPACTION measurement (item 2): straight w2 l40 = 872x8716 iu (4.36x43.6um, area
    190um2, max dim 43.6um) vs SERPENTINE nx2 l20.6 = 1352x4758 iu (6.76x23.79um, area
    161um2, max dim 23.79um). Serpentine wins: ~15% less area and 1.8x more compact in the
    long dimension -- adopted. netgen extracts the serpentine as ONE ppolyf_u_1k device (NOT
    series), r_length 40.04u (=20k exact at w2), so mk_div2's 20k mapping just moves 40.0 ->
    40.04u to match the drawn geometry (no multi-device golden change). nx4 was even more
    compact but has 2 internal flattened-PRES errors; nx2 is DRC-clean.
2026-08-16 docs(tracking): DIV2 converter (1e) gate-passed; 1f remaining
    Updates the DIV2 row: CML latch (1d) + full converter (1e) both gate-passed
    (ib_conv_v1 magic DRC 0 / KLayout DRC 0 / LVS match uniquely, 14 dev / 6 ports).
    Remaining item is the full DIV2_QUAD_v1 assembly (1f).
2026-08-16 5.3 0b: converge inverter path into ib_inv_lib.tcl (one path, NP.1 fix everywhere)
    The +/-420 NP.1 tap fix lived only in ib_conv_v1's strap_inv; make_inv and ib_inv_chain
    were still +/-400 -> would fail KLayout NP.1. Extracted the ONE inverter construction
    path (inv_geom + place_inv_dev + strap_inv + hseg/vseg) into ib_inv_lib.tcl with the
    +/-420 tap, and made all three consumers source it:
    - ib_inv_gen.tcl: make_inv now wraps place_inv_dev + strap_inv (no geometry here)
    - ib_inv_chain.tcl: sources the lib (removed inline copies)
    - ib_conv_v1.tcl: sources the lib (removed inline copies)
    Re-verified end to end: ib_inv1/2/3 + ib_inv_chain + ib_conv_v1 all magic DRC 0 +
    KLayout DRC 0 (variant D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
2026-08-16 5.3 0c + item1: round-boundary hypothesis DISPROVEN; RFB = ~20.4k confirmed
    0c (round-boundary test): built two identical isolated nsubdiff taps, one with edges on
    exact microns (+/-400iu=+/-2.0um) and one off-micron, dumped the generated nplus. BOTH
    produce an IDENTICAL nplus (same 0.01um corner grid-jog, 4.04um wide) and NEITHER
    violates NP.1. So the "exact-micron-boundary makes magic enclose unevenly" theory is
    DISPROVEN. The NP.1 tab only appeared in the INVERTER context (the tap's interaction
    with the pfet/metal1 below); +/-420 fixes it by moving the tap edge clear of that
    neighbour, not by dodging a micron boundary. Corrected the comment in ib_inv_lib.tcl.
    item 1 (RFB resistance sanit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
2026-08-16 5.3 1f prep: generate the 75-device DIV2 golden (validated netlist flow)
    Regenerated DIV2_QUAD_v1_golden.spice from the live .sch (f600af3): 39 nfet + 20 pfet
    + 12 res + 4 cap = 75 devices, the 1f LVS target. Structure confirmed: 12 CML nfets
    (2 latches MA1-6/MB1-6, W40 L0.3) + 4x300R loads + 3 NMOS bias (M_BREF/M_TAILA/M_TAILB)
    + 4 converters (ib_conv_v1 x4: IP/IN/QP/QN). CML golden is W=40u nf=1 -- same as the
    committed ib_cml golden the folded w4-nf10 layout already matched, so no folding conflict.
    NETLIST GOTCHA (recorded): netlisting must use the PDK xschemrc ($PDK_ROOT/$PDK/
    libs.tech/xschem/xschemrc) -- with --rcfile /dev/null the nfet_03v3/pfet_03v3 symbols
    are "MISSING" and the FETs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
2026-08-16 docs(tracking): DIV2 1f prepped -- 75-device golden + block/interconnect map
    Records 1f readiness: both instantiated blocks (ib_cml, ib_conv_v1) gate-passed
    (magic+KLayout+LVS), 75-device golden generated, and the flat-assembly inventory +
    quadrature interconnect mapped for the remaining full DIV2_QUAD_v1 assembly.
2026-08-16 5.3 1f Stage A WIP: DIV2 CML core + bias skeleton placed+strapped, DRC 0
    ib_div2.tcl: places+straps the 19-device CML core skeleton -- 2 latch rows (MA1-6 @ yA=0,
    MB1-6 @ yB=-7000, each [MA5 MA1 MA3 MA4 MA2 MA6] W40 folded w4nf10) + 4x300R loads (RA1/2
    above A, RB1/2 above B) + 3 NMOS bias (M_BREF W4 diode + M_TAILA/B W40, bias row @ x=6P
    ybias=-3500). Per-row shared pwell + VSS psubdiff tap. magic DRC 0.
    Fix: M_TAILA/B are nf=10 L=1 (~3.2um wide) -> spaced 2100/5700 not 700/1600 (they
    overlapped M_BREF, 44 DRC). NEXT: route each latch internal (nT/nL/TAIL/OI-OIB or
    OQ-OQB/cross-gates/loads, ib_cml recipe at yoff), then A<->B cross-couple + bias + CK/CKB.
2026-08-16 5.3 1f Stage A WIP: both latches internally routed (route_latch proc), DRC 0
    route_latch {yoff} does the ib_cml internal routing (outB/out on M3, nT on M4, nL on M5,
    TAIL on M3, cross-gates 3.g->out/4.g->outB, loads->out/outB + VDD rail) at a y-offset;
    called for latch A (yA=0) and latch B (yB=-7000). Both latch x-columns match ib_cml so
    the geometry + load positions carry over verbatim. magic DRC 0.
    NEXT: cross-couple A.OI/OIB->B input gates + B.OQ/OQB->A input gates; CK/CKB to the tail
    gates (swapped A vs B); bias IBIAS->M_BREF diode + tail gates, TAILA/B->latch tails,
    VSS/VDD; then Stage-A partial golden + LVS.
2026-08-16 5.3 1f Stage A WIP: cross-coupling routed, DRC 0
    4 master-slave cross nets routed on M5 (nL's M5 hseg at y+1150 + risers at 5600/8200/
    12600 leave the output/gate columns free below): OIB(A)->MB1.g straight M5 @2400;
    OI(A)->MB2.g straight M5 @10400; OQ(B)->MA1.g via gap track g1 (M5); OQB(B)->MA2.g via
    gap track g2 (M4 hop, so it crosses OQ's M5 inter-layer). Added via_m4m5 helper (the
    M4/M5 gap-hop corners were dragging tiny isolated M2 pads from via_m2m5 -> 14x M2.3/V2.3;
    via_m4m5 paints only M4+M5+via4). magic DRC 0.
    NEXT: CK/CKB to tail gates (swapped A/B), bias IBIAS->M_BREF diode + tail gates +
    TAILA/B->latch tails, VDD (load rails) + VSS (taps + bias src), ports, Stage-A LVS.
2026-08-16 5.3 1f Stage A WIP: full CML-core+bias routing DRC 0 (CK/CKB, bias, VDD/VSS)
    Completes Stage A geometry: CK/CKB cross-mirrored clock feed (x0 M3 / x13000 M4 free
    columns + gap tracks g3/g4); NMOS bias mirror (M_BREF diode, IBIAS M4 rail to 3 gates,
    TAILA/B M4 risers to the latch tails); VDD ties the two load M4 rails via a left vertical;
    VSS = ONE continuous pwell so all taps share the bulk (the metal1 spine collided with the
    MA5/MB5 gate-contact metal1 at lx=-1030 -> replaced with a big pwell + bias-source drops).
    Added via_m1m2/via_m4m5 helpers. magic DRC 0.
    NEXT: ports (CK CKB IBIAS VDD VSS OI OIB OQ OQB) + Stage-A partial golden + LVS.
2026-08-16 5.3 1f Stage A WIP: ports + partial golden; DRC 0, LVS reveals cross/clk/bias shorts
    Added 9 Stage-A ports (CK CKB IBIAS VDD VSS OI OIB OQ OQB) + a partial golden (19 devices
    = 12 CML + 4 loads + 3 bias, extracted from the full DIV2 golden). magic DRC 0. verify_cp
    extracts 145 raw fingers but LVS DO NOT MATCH: only 6 ports land (CKB, IBIAS, OI labels
    merged away) and the outputs are cross-confused. Extraction shows SHORTS -- IBIAS merged
    into CK (a bias device reads gate=CK,drain=CK), OI merged into OIB/OQ, CK spreads across
    many nets. These are the expected same-layer-hop shorts in the dense inter-band routing
    (CK/CKB gap hops, cross-coupling M5 verticals, bias IBIAS rail). NEXT: trace each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
2026-08-16 5.3 1f Stage A WIP: fix CK-CKB short (DRC 0, ports 6->8)
    Traced+fixed the first LVS short (rule 8): CK's B-stub and CKB's A-stub were both M4
    verticals at x13000 -> CK-CKB merged, and CKB's x13000 vertical also crossed TAILA's M4
    hseg (y-750). Split to x12500 (CK) / x12300 (CKB) within the shared x6 gate rail
    (12000..13560); CKB nudged inward off the rail edge (V2.3). magic DRC 0, ports now 8/9.
    Remaining: 1 port still merged + the OI/OIB/OQ/OQB outputs cross-confused -> more
    same-layer-hop shorts in the cross-coupling / bias to trace (select each merged net,
    find the crossing on its own layer). Then Stage B (converters).
2026-08-16 5.3 1f item1: real metal VSS rail (M3 spine), not just pwell return
    The pwell-only VSS return (last session) makes the substrate the inter-device VSS
    current path for a 2.5GHz CML divider -- high return R, ground bounce, VCO coupling.
    Added an M3 VSS spine @ x-1150 (M3 has no gate structures and clears the load M3 risers
    @ x2600/8700; the earlier metal1 spine collided with the MA5/MB5 gate-contact metal1 at
    lx=-1060). Ties the A/B pwell taps directly (via_m1m3) and the bias tap via an M2 link
    (inter-layer over the B-load M3 risers). pwell kept as the bulk tie. magic DRC 0
    maintained, ports 8/8 (no worse). LVS tracing (item 2) now runs against final power topo.
2026-08-16 5.3 1f item2 WIP: fix OI/OQ nL shorts -> 9/9 ports, DRC 0 (net count off by 2)
    Traced OI=VDD (whole-cell net): the OI M5 cross vertical @x10400 crossed latch-B nL M5
    hseg (yB+1150, 5600..12600) -> OI shorted to nLB. OQ @x8700 had the identical crossing.
    Fixed both by jogging to M4 through the nL hseg (inter-layer), jog @yB+1500 to keep the
    M5 pad >92 from nL (MT.2a). Now all 9 ports land (CK CKB IBIAS VDD VSS OI OIB OQ OQB),
    magic DRC 0. LVS still DO NOT MATCH: 17 extracted nets vs golden 15 -> 2 nets over-split
    (something that should connect is open). NEXT: find the 2 split nets (likely a cross or
    bias connection that didn't reach its target).
2026-08-16 5.3 1f item2 GATE: Stage A CML core+bias LVS match uniquely (DRC0 both tools, 9 ports)
    Stage A (2 CML latches + 3 NMOS bias) now magic DRC 0 + KLayout DRC 0 (variant D) + netgen
    LVS MATCH UNIQUELY vs the 19-device partial golden, 9 ports (CK CKB IBIAS VDD VSS OI OIB
    OQ OQB). Traced+fixed the last shorts/opens (rule 8):
    - TAILA drain M4 riser crossed the IBIAS M4 rail (both M4) -> IBIAS rail moved to M3
    (tail risers cross inter-layer).
    - M_BREF gate M2 rail is at x15268..15492 (leg offsets the gate left of xbr=15600) -> the
    diode tie + IBIAS reach it at x15450, not xbr; and the IBIAS port label moved onto the
    gate rail (was on empty M2 -> "match uniquely with port errors").
    Symmetry: bo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
2026-08-16 docs(tracking): 1f Stage A CLOSED (CML core+bias LVS match, 7,236 um2)
    Records the Stage A gate pass (ib_div2: magic+KLayout DRC 0, LVS match uniquely vs the
    19-device partial golden, 9 ports; core+bias bbox 120.4x60.1um) and the remaining
    Stage B/C/D plan (4x ib_conv_v1 via a place_conv proc -> 75-device full gate).
2026-08-16 5.3 1f item0b: widen VSS for EM (M2 collector plate); Stage A still gate-clean
    0a AREA (reported to Greg): ib_conv_v1 bbox 54.86x85.82um = 4,710um2. 4x conv (18,840) +
    Stage A core (7,236) = 26,076 device + ~40% routing -> DIV2 projected ~37,000um2. Block
    totals PFD+CP+ibias+VCO(43k)+DIV2 ~95,300 -> top-level w/ 30-50% channels ~124k-143k um2.
    350x300 (105k) DOES NOT HOLD -- the old scope estimated the divider at ~162um2 (digital);
    the real full-custom CML+converters is ~37k (230x). Realistic die ~370x390. Bailey needs
    this before allocation.
    0b EM: VSS carried ~4.8mA (2x2.4mA CML tails) through a 0.56um M3 spine / 0.4um risers ->
    FAIL by ~10x at ~1mA/um. Fixed: M_TAILA/B source rails (alre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
2026-08-16 5.3 1f item1: layer/track allocation plan doc before Stage B routing
    docs/div2-layer-plan.md: explicit per-net-class layer+band allocation across the whole
    DIV2 (latch internals, cross-coupling, CK/CKB, IBIAS/tails, VDD, VSS, and the converter
    band's INP/INM/OUT/IBIAS/VDD/VSS), with the MIM cap plates + resistor guard rings marked
    OCCUPIED. Captures the proven Stage-A allocation and the Stage-B/C plan (converters below
    latch B, INP/INM dropped on M4 from the M3 core outputs). Route against this, not by trial.
2026-08-16 5.3 1f Stage B enabler: strap_inv/place_inv_dev take optional cy offset
    The 4 DIV2 converters place below latch B at their own y; the inverter
    construction path needs to build at a y-offset. Add an optional {cy 0}
    param to place_inv_dev + strap_inv: nfet at cy, pfet at cy+YP, all strap
    y-constants + cy (only the pwell-top Gn+300 is a raw width so takes an
    explicit +cy). cy=0 is a mathematical no-op -> existing callers (ib_conv_v1,
    standalone/chain inverters) unchanged; regression-verified by rebuilding
    ib_conv_v1 clean (CONV_DRC=0).
2026-08-16 5.3 1f Stage B WIP: IP converter placed + routed, magic DRC 0
    getcell ib_conv_v1 at (bx23500,by-3330) -> flatten to ib_div2_g. Route 6
    nets over-the-top (y>3900 clear band): INP<-OIB on M5 @5500, INM<-OI on M4
    @5800 (escaping WEST of the CC MiM cap first, since the INM pin native x2165
    sits under the cap's M4/M5 plates), IBIAS core M3 rail extended east, VDD
    riser+M4 haul @6500 to the conv M2 bus, VSS M2 plate extended east +via_m1m2.
    Two fixes from the first run (DRC 6->0): M2 landing pads at the 50-wide
    INP/INM pins (V2.3 stacked-via overlap); INM cap-escape (MIMTM.1). Flatten
    demotes the conv port labels cleanly -> 9 DIV2 ports intact. LVS/golden next.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
2026-08-16 magic verify: ext2spice merge aggressive (folded/mirror devices never LVS'd)
    Found while closing DIV2 Stage B: verify_extract.tcl did `extract all;
    ext2spice lvs` with NO merge, so every folded/mirror device (CML W40->w4
    nf10, ibias mirror m24) extracted as N separate fingers and could NEVER
    match the goldens, which are all written in the merged form (m=24, or W40
    nf=1 = the summed-width equiv netgen accepts since nfet/pfet_03v3 are
    pin-only black boxes). Empirically ib_div2 (Stage A) AND ibias_gen_v1 both
    report DO-NOT-MATCH via verify_cp as-is (145 / 228 unmerged devices) -- the
    "passed verify_cp" claims were actually manual netgen runs. `ext2spice merge
    aggressive` collapses truly-paralle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
2026-08-16 5.3 1f Stage B CLOSED: IP converter integrated, full DIV2 gate passes
    DIV2_QUAD_v1 (as ib_div2) with the first of four converters (IP) placed and
    wired. Approach: getcell ib_conv_v1 as a HIERARCHICAL child (not a 2nd
    flatten, which shatters the CML folds) at (bx23500,by-3330); route 6 nets:
    INP<-OIB M5 haul @5500 (INP native x965, left of the CC cap)
    INM<-OI M4 haul @5800 -> via_m4m5 @x21000 -> M5 down left of the cap ->
    M3 east under the cap to the pin (M5 riser crosses the converter's
    DN1 M4 gate-net inter-layer; a straight M4 riser had shorted DN1)
    IBIAS core M3 rail extended east + riser
    VDD riser @x8700 -> M4 haul @6500 -> conv M2 bus
    VSS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
2026-08-16 docs: DIV2 tracking -> 1f Stage B CLOSED (33-dev gate pass) + verify_cp fixes
    Stage B gate-passed (magic+KLayout DRC 0, LVS match uniquely, 10 ports).
    Records the two verify_cp fixes (ext2spice merge; PDK=gf180mcuD) that also
    make ibias_gen_v1 and CP_v1 actually pass verify_cp for the first time.
2026-08-16 Revert 76dd62e ext2spice merge: it was a misdiagnosis of the PDK bug
    Item-0 re-test (this session): with the stock no-merge verify_extract.tcl and
    CORRECT PDK sourcing (PDK=gf180mcuD, not the container ambient ihp-sg13g2),
    ibias_gen_v1 reports 228 devices -> MATCH UNIQUELY, ib_div2 (Stage B) 146 ->
    match, CP_v1 38 -> match. netgen itself combines the parallel folded fingers
    via the gf180 netgen setup; magic's ext2spice merge was never needed. Last
    session's "every prior LVS pass was invalid / merge missing" conclusion was
    wrong -- the sole bug was the wrong PDK (which loads the wrong netgen setup,
    so nothing combines and symmetric pin-matching fails).
    Reverting `ext2spice merge aggressive`: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
2026-08-16 docs: Stage C floorplan decision + Stage B actuals in div2-layer-plan
    Records the gating Stage-C decision: mirrored side-placement (getcell +
    sideways) for IN/QP/QN so each front-end faces the core and all 6 nets stay
    short like IP — rejecting tiled-same-side (body-crossing MIMTM) and vertical
    stacking (full-height VSS/VDD hauls). Also captures the Stage B corrections
    (hierarchical child not flatten; INM cap+DN1 escape; I_P M1 patch; PDK env;
    no ext2spice merge) so continuation is mechanical.
2026-08-17 5.3 1f Stage C item1+2: sideways proven; orientation = option (c)
    Item 1: `sideways` mirror PROVEN. getcell (after loading the master to warm
    the gf180 tech), sideways mirrors about the bbox centre -> native (px,py) maps
    to parent (bx+9612-px, by+2600+py), y unchanged; flatten+extract = 14 clean
    devices. The earlier 10504x9107 anomaly was a cold-tech artifact.
    Item 2: orientation = option (c) P-east-unmirrored / N-west-mirrored. I and Q
    paths made structurally identical (both P-unmirrored + N-mirrored) so the
    mirror-induced slicer offset is common to I and Q and cancels in the quadrature
    comparison; leaves only a 2nd-order P/N duty offset. Rejected (d) (offset lands
    on the quadrature axis)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
2026-08-17 5.3 1f Stage C IN WIP: mirrored converter placed, magic DRC 0, LVS shorts remain
    IN converter (west, MIRRORED, latch A, INP=OI INM=OIB) placed at bx-13000
    by-3330 via `getcell ib_conv_v1 ; sideways` (NO `select cell` -- that mirrors
    about the wrong centre and leaves pins effectively unmirrored; verified by
    dumping the flattened .mag rlabels: true mirrored pins IBIAS-3153 INP-4334
    INM-5534 VDD-2116 VSS-2356 OUT-12564, matching the bxN+9612-px formula).
    Magic DRC 0 (build + verify agree). 47-device golden (+14 IN, port I_N).
    REMAINING (next): LVS DO NOT MATCH -- IBIAS+VDD+OI merge into the VSS node
    (layout 45 dev vs 47; missing 1 nfet + RA1/RA2-class resistor). A west-side
    routing crossing sh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
2026-08-17 5.3 1f Stage C: IN converter CLOSED (47-device gate passes)
    IN converter (west, MIRRORED via getcell+sideways, latch A, INP=OI INM=OIB)
    fully integrated. GATE (PDK=gf180mcuD): magic DRC 0, KLayout DRC 0 (variant D),
    LVS MATCH UNIQUELY, 11 ports (adds I_N). Instance connectivity verified:
    IP=OIB/OI/I_P, IN=OI/OIB/I_N (correctly mirror-swapped).
    Key routing insight (west converters): every tap-side riser must cross IP's
    haul band (OIB M5 @5500, OI/INM M4 @5800, VDD M4 @6500 -- all span the core)
    on M3, else it shorts to those nets. So INP/INM/IBIAS risers go up on M3 then
    via_m3m5 to their M5 haul above the band; VDD is a short low M4 hop (y3400) to
    the mirrored VDD bus; INM escapes EAST of t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
2026-08-17 docs: DIV2 tracking -> Stage C IN CLOSED (2 of 4 converters, 47-dev gate)
    Records IN gate-pass + the west-converter routing rule (M3 tap-risers cross
    IP's haul band) + orientation option (c).
2026-08-17 5.3 1f Stage C item2: Q placement = stacked-below, symmetric with I pair
    QP directly below IP (east), QN below IN (west), same x per side, mirror-
    paired -> mirrors the I arrangement so option (c) holds and QP/QN match.
    Cost: ~53um extra Q haul (pins 10670iu below latch-B taps) = ~1.0deg at
    1.25GHz, common to Q_P/Q_N (static I-to-Q offset, not intra-pair). Item 1:
    IN gate CONFIRMED against the GDS (11 ports, match uniquely) -- earlier "8
    ports" was the shorted intermediate state, not a round-trip artifact.
2026-08-17 5.3 1f Stage C QN WIP: mirrored, placed below IN, magic DRC 0, LVS shorts remain
    QN converter (west, MIRRORED, below IN at bxQ-13000 byQ-21000, latch B,
    INP=OQ INM=OQB, pins deep at y-17070). getcell+sideways (mirror verified);
    magic DRC 0. 61-device golden (+14 QN, port Q_N). Instance connectivity:
    IP/IN intact; QN = IBIAS/OQ/OQ/Q_N/float/VSS -> INP=OQ correct, OUT=Q_N ok.
    REMAINING (next):
    1. INM=OQ short: INP's M5 haul @-16000 (spans to x10000) crosses INM's M5
    descent at x2200 (both M5). Fix: stagger layers like IN did -- descend on
    M5 through latch B (TAIL M3/nT M4), but put the hauls/drops on M3 vs M5 so
    converging nets cross inter-layer. Same puzzle IN solved with M3 risers.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
2026-08-17 5.3 1f Stage C: QN converter CLOSED (61-device gate passes vs GDS)
    QN (west, MIRRORED, below IN at bxQ-13000 byQ-21000, latch B, INP=OQ INM=OQB,
    pins deep at y-17070). FULL GATE vs the GDS (PDK=gf180mcuD): magic DRC 0,
    KLayout DRC 0 (variant D), LVS MATCH UNIQUELY, 12 ports (adds Q_N). All three
    converters verified: IP=OIB/OI, IN=OI/OIB, QN=OQ/OQB.
    Deep-pin (latch-B, stacked-below) routing solved: descend from the taps on M5
    through latch B's TAIL M3/nT M4 (inter-layer) into the clear band y<-8200;
    stagger the hauls by layer (INP M4, INM M5, IBIAS M3) so converging nets cross
    inter-layer; VDD via at -4200 (inside the QN bus, whose top is ~-3996, NOT the
    -3200 latch-B rail); VSS extends the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
2026-08-17 5.3 1f Stage C COMPLETE: QP closed -- all 4 converters, 75-device gate passes
    QP (east, unmirrored, below IP, latch B, INP=OQB INM=OQ -> Q_P). FULL GATE vs
    GDS: magic DRC 0, KLayout DRC 0 (variant D), LVS MATCH UNIQUELY, 13 ports.
    All four converters verified: IP=OIB/OI, IN=OI/OIB, QN=OQ/OQB, QP=OQB/OQ.
    DIV2 is now the complete 75-device quad-phase divider.
    QP debug (mirror of QN, east hauls, tracks -15400/-15100/-14800 above QN's):
    - VDD up-extension to IP's bus must go on M4 through IP's VSS M2 plate-strip
    (y-2000) or it shorts VDD->VSS.
    - VSS drops from the core VSS plate's east edge (x21900), MERGED (else M2.2a).
    - INM(OQ) haul: M4 for the west part (clears QN's IBIAS M5 descent @x154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
2026-08-17 5.3 CLOSED: DIV2_QUAD_v1 signed off -- full quad-phase divider, 75 devices
    Stage D: renamed cell ib_div2 -> DIV2_QUAD_v1, dropped OI/OIB/OQ/OQB as ports
    (now internal CML outputs feeding all 4 converters), 9 top ports
    (CK CKB IBIAS I_P I_N Q_P Q_N VDD VSS). Golden regenerated via mk_div2_golden.py
    from DIV2_QUAD_v1.sch netlisted with the PDK xschemrc (59 FETs) -- IDENTICAL to
    the committed 75-device golden.
    FULL GATE vs GDS (PDK=gf180mcuD): verify_cp.sh DIV2_QUAD_v1 exit 0 -- magic
    DRC 0, netgen LVS MATCH UNIQUELY, 9 ports, 0 property errors, 0 port errors;
    KLayout DRC 0 (variant D). Measured bbox 47472 x 34834 iu = 237.4 x 174.2 um
    = 41,340 um^2 (vs the 36,500 um^2 projection, +13%).
    DIV2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
2026-08-17 docs: DIV2 (5.3) CLOSED -- signed off, measured area, VSS-EM follow-up
    DIV2_QUAD_v1 gate-passed vs GDS (verify_cp exit 0 + KLayout var-D 0, 9 ports).
    Measured 237.4 x 174.2 um = 41,340 um^2 (+13% vs 36,500 projection). Flags the
    per-converter VSS ties (0.28-0.56um, ~1.1-3.6 mA/um) as an EM widen-before-
    tapeout follow-up (does not block the DRC/LVS sign-off).
2026-08-17 docs review: add DIV2 section -- characterized I/Q offset + quantified EM
    Item 0 truth-up for the Aug-21 review. DIV2.1: the ~1.0 deg I-to-Q quadrature
    offset written up with the arithmetic (Q hauls ~53um longer -> ~2.2ps ->
    ~1.0deg at 1.25GHz, common to Q_P/Q_N). DIV2.2: the EM line is no longer
    "unknown" -- total VSS 22.4mA (sim), per-converter 2.96mA (measured via a 0V
    meter), against the ~1mA/um GF Al rule (open PDK ships no EM deck); plate
    ~2.3-2.9 mA/um and ties ~5.3-10.6 mA/um are OVER -> widen fix flagged.
2026-08-17 docs: VSS EM CONFIRMED by sim + fix scoped/deferred for 5.4 VCO priority
    Item 1a/1b done: total VSS 22.4mA, per-converter 2.96mA (measured); open PDK
    has no EM deck, GF Al rule ~1mA/um. Root bottleneck is ib_conv_v1's 0.6um M1
    VSS bus (~4.9mA/um), so the fix needs the converter cell + all instances +
    plate (boxed in -> multi-layer stack) + ties. Deferred to prioritise the VCO
    (last undrawn block, die-size input) -- scope recorded, DRC/LVS sign-off intact.
2026-08-17 5.4 VCO rung 0: devices de-risked, inductor bbox measured
    Read vco_v1.sch: complementary cross-coupled LC, 2x nfet W40 + 2x pfet W70,
    2x cap_nmos_03v3_b varactor (5x5, m=21), 1x ppolyf_u_3k (15k tune R), +
    vco_inductor_v2 (1.2nH, waiver W3 pi-model). De-risk: varactor = nmoscap_3p3
    gencell -> DRC 0, extracts as cap_nmos_03v3_b (7.44x7.06um/unit). ppolyf_u_3k
    has NO gencell (real device, layer ppolyf_u_h) -> hand-draw. INDUCTOR BBOX
    MEASURED: 182x84um (dual square spiral). VCO die-size est ~190x90um ~17,000um^2
    (inductor-dominated). Next: 3k R, 4-FET core rung, place inductor, tank, gate.
2026-08-18 item 0: correct die-size arithmetic + EM rule-of-thumb caveat (review-facing)
    Die size was built on a guessed 43k VCO block. Corrected with measured layout:
    4 signed-off blocks = 56,635 um^2 (PFD 1368 + CP 2059 + ibias 11868 + DIV2
    41340); VCO is inductor-dominated ~18,000 (not 43k). Blocks ~75,000 + 30-50%
    routing -> ~96,000-114,000 um^2. Declared 350x300 (105,000) STRADDLES that:
    tight but plausible, NOT "short by 40%". Retracted the 370x390/400x400 claim.
    tracking.md area table + narrative updated; scope.md §5 annotated (its 162um^2
    "divider" and 43k VCO were the wrong inputs); review doc + tracking EM lines
    now say ~1mA/um is an INDUSTRY RULE OF THUMB (open PDK ships no EM deck; GF
    manu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
2026-08-18 5.4 VCO: ppolyf_u_3k RESOLVED + pfet W70 de-risked
    Item 1 (ppolyf_u_3k, in timebox): it is the SAME PHYSICAL DEVICE as
    ppolyf_u_1k -- both extract from layer ppolyf_u_h; 1k-vs-3k is a fab process
    variant (when '1k'/'3k' in the KLayout deck), NOT a layout/marker difference.
    Magic tech has no 3k device -> extracts the identical layout as ppolyf_u_1k.
    Resolution: draw with the ppolyf_u_1k gencell; verify_cp needs a 1k<->3k
    relabel waiver (PROVEN: relabel golden -> netgen match uniquely; equate classes
    does not take, 3 syntaxes tried). Waiver-vs-design-change is Greg's call --
    do NOT edit vco_v1.sch. Item 2a: pfet W70 nf10 L0.28 -> DRC 0, extracts w=70u
    l=0.28u (9.98x72.1um). All 3 new device ty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
2026-08-18 5.4 VCO rung 3a: 4-FET cross-coupled core (vco_core)
    Complementary cross-coupled pair, standalone, fully signed off:
    2x nfet W40 L0.28 (nf10 w4) MN1/MN4 bulk->ISS
    2x pfet W70 L0.28 (nf5 w14) MP2/MP3 bulk->VDD
    Cross-couple: OUT_p=MN1.D+MP2.D+MN2.G+MP3.G ; OUT_n=MN4.D+MP3.D+MN1.G+MP2.G,
    routed on far-left M3 bus (OUT_p) / far-right M4 bus (OUT_n), hauls in the
    clear band between nfet gate and pfet VDD rail. Ports: ISS VDD OUT_p OUT_n.
    Gate (all pass):
    magic DRC 0
    KLayout DRC 0 (variant D)
    netgen LVS Circuits match uniquely (vs 4-device golden)
    bbox 28.55 x 30.25 um
    Build notes captured in vco_core.tcl:
    - pfet folded nf5/w14 (PG=1400): pfet_leg tap offset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
2026-08-18 5.4 VCO: tracking — rung 3a core signed off; 3b recipe + 1k/3k note
    - vco_core (rung 3a) DONE: real bbox 28.55x30.25um, magic/KLayout(var-D) DRC 0,
    netgen LVS match uniquely. Locked build facts (pfet nf5/w14, manual nfet taps,
    M2 pads under via_m2m4).
    - Rung 3b (varactor) de-risked with the two real obstacles named (NW.2a in the
    m=21 auto-array; well-plate bus column unfound) as the exact next step.
    - Item 2 (1k/3k): documented as a per-fab-run process choice, not co-resident on
    one die -> Greg's design decision, with the resistor re-size implication.
2026-08-18 nfet_leg: scale tap offset with pitch (offset P) + drop vco_core workaround
    nfet_leg's psub-tap loop used a hardcoded +252 x-offset and 5040 step, tuned
    for L=2 (pitch 504). At L=0.28 (pitch 160) the tap via landed 16u from the i=0
    source via -> V1.2a, forcing vco_core to hand-paint its pwell + taps.
    Same bug class as the 8/14 pfet_leg fix, but the pfet tap sits BELOW its source
    rail (different y) so a P/2 offset clears it; the nfet tap sits AT the source-rail
    y, so P/2 (=80 at L0.28) still collides. The offset that clears at every pitch is
    P (lands the tap at a drain-column midpoint, 108u from each source via). Step 10*P.
    Regression (rebuilt, offset P): ib_nmir4 / ib_nmos / ib_pmir all ma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
2026-08-18 5.4 VCO rung 3b: differential varactor array (vco_varactors)
    42x cap_nmos_03v3_b (nmoscap_3p3 w5 l5), two m=21 caps:
    XC1 cap_bias<->OUT_n , XC4 cap_bias<->OUT_p.
    6 cols x 7 rows, pitch X 1560 / Y 1500. Mirror-symmetric about the vertical
    centre: cols 0-2 wells -> OUT_n, cols 3-5 wells -> OUT_p (differential match);
    all 42 gates -> cap_bias. Gate column buses (M2) -> cap_bias M3 rail on top;
    well column buses (M2) -> OUT_n / OUT_p M3 rails on bottom. Guard (psubdiff)
    auto-ties to substrate, no bus. bbox 46.7 x 54.5 um.
    Gate:
    netgen LVS Circuits match uniquely (42 units combine to 2x m=21 golden)
    KLayout var-D 168 items = EXACTLY 2 per unit (42x2) of PL.5a_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
2026-08-18 5.4 VCO rung 3c (WIP): vco_v1 assembly placed, core<->varactor tank routed
    Assembly cell vco_v1 = vco_inductor_v2 + vco_core + vco_varactors, hierarchical
    getcell instances (masters pre-loaded to warm them, else getcell silently drops
    the instance from the .mag). Floorplan: inductor at native position; core and
    varactor stacked below, centred under the coil centre channel. bbox 182 x 179 um.
    DONE this rung:
    - Placement DRC-clean, correct floorplan.
    - core<->varactor TANK routed + VERIFIED: with buses stopped below the inductor
    the extraction gives `.subckt vco_v1 VDD ISS OUT_p OUT_n cap_bias` with OUT_p
    and OUT_n DISTINCT, each tying core+varactor (core OUT_p M3 exits left, OUT_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
2026-08-18 5.4 VCO: tracking — 3b waiver W4 confirmed; rung 3c WIP recorded
    - Varactor PL.5a/5b_LV waiver (W4) CONFIRMED: bare single nmoscap_3p3 = 4 items;
    device-internal, 42x4=168 in the array.
    - Rung 3c (vco_v1 assembly) WIP: placement + core<->varactor tank done, magic DRC 0,
    KLayout clean modulo W4. Inductor-port connect + resistor + full LVS deferred.
2026-08-19 5.4 VCO rung 3d: tune resistor vco_tune_r (ppolyf_u_1k, 15 squares)
    Standalone tune resistor, designed to the 1k sheet variant (Greg's decision):
    ppolyf_u_1k w1 l15 = 15 squares = 15 kOhm. bbox 3.36 x 18.58 um. Ports
    TUNE / cap_bias / GND (two poly-contact ends + metal1 guard-ring body).
    KLayout var-D 0
    netgen LVS Circuits match uniquely (vs ppolyf_u_1k r_width=1u r_length=15u golden)
    NO 1k<->3k relabel waiver needed: the golden is built as ppolyf_u_1k to match the
    layout, so it matches directly (drops one of the three planned waivers).
    SCHEMATIC NOTE (rule 13, Greg's to resolve): vco_v1.sch still says
    XR2 TUNE cap_bias GND ppolyf_u_3k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
2026-08-19 5.4 VCO: tracking — GDS audit, W4 waiver test, inductor finding, 3d done
    - GDS hierarchy audit: all 6 committed GDS complete; DIV2_QUAD_v1 re-gated on its
    complete GDS = KLayout var-D 0 (sign-off holds). vco_v1 GDS was fixed last session.
    - W4 varactor waiver TESTED: no nmoscap_3p3 param clears PL.5a/5b_LV; only that gencell
    flags (DIV2 = 0). Genuine but a real 168-item risk (Greg's call).
    - Inductor-port waiver-first attempt still merges/dangles: interior ports on a DC coil
    need the designed feed or edge re-export (cell-level change).
    - Rung 3d tune resistor done; no 1k<->3k waiver needed.
2026-08-19 5.4 VCO: inductor ABSTRACT (magic LEFview+GDS_FILE) -> full tank connected
    Item 1a (geometry, not extraction): OUT_n's M5 bus intersects ONLY the PORT1 lead
    [-880 -480 -720 1040]; OUT_p's only the PORT2 lead [-120 -480 40 1040]. No coil turn
    touches either bus. The tank was already wired correctly; the "PORT1 dangling / OUT_n
    merged" was purely the DC-continuous coil + label-naming, exactly as predicted.
    Item 1b (the fix): vco_inductor_v2 is now a TRUE ABSTRACT magic cell --
    property LEFview true
    property GDS_FILE /foss/.../gds/vco_inductor_v2.gds (GDS_START 122, GDS_END 17426)
    property FIXED_BBOX -22400 -4800 14000 12000
    + M5 port pads/labels PORT1 (-800,-480), PORT2 (-40,-480), N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
2026-08-19 5.4 VCO rung 3e: full assembly -- tune resistor instanced, tank + power connected
    vco_v1 now instances all four blocks: vco_core, vco_varactors, vco_inductor_v2
    (abstract), vco_tune_r. Connections verified in extraction:
    core ISS VDD OUT_p OUT_n (all 4 connect to top ports/nets)
    varactor cap_bias OUT_n OUT_p (cap_bias shared with resistor)
    inductor OUT_n OUT_p (abstract, distinct pins)
    resistor TUNE cap_bias GND
    Ports painted with top-level metal over each child port (else labels float).
    subckt vco_v1 = VDD OUT_p OUT_n TUNE ISS (+ GND, see note).
    Gate on the FULL GDS (hierarchy verified: 5 cells, inductor 271 shapes, 182x179.5 um):
    KL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
2026-08-19 5.4 VCO: tracking — inductor abstract solved, full assembly built, LVS blocked on ISS=GND
    - Inductor port SOLVED via magic true-abstract (LEFview+GDS_FILE, geometry-free);
    1a geometry proved the tank was already wired correctly.
    - Rung 3e full assembly built (b5254c6): all blocks + resistor, DRC 0, KLayout W4-only,
    GDS complete (271 inductor shapes).
    - LVS blocked on ISS=GND=substrate merge (design question for Greg) + inductor 3rd pin.
2026-08-19 5.4 VCO CLOSED (pending ISS=GND decision): GND pin, ISS investigation, LVS both ways, gate
    Item 1 - GND pin: inductor abstract now 3-terminal (PORT1 PORT2 GND); GND is a
    floating M5 pad handled by the W3 black-box (MT.4 min-area fixed at 150x150). GDS
    still streams all 271 spiral shapes.
    Item 2 - ISS (investigate, don't decide): the testbench DRIVES ISS as a tail node --
    Viss_meas vss net3 0 (0V ammeter, not a source)
    XM1 net3 vsg GND GND nfet_03v3 W=100u (tail current mirror)
    I0 GND vsg 1m (mirror bias)
    So ISS is intended as a biased tail node, NOT ground. BUT the design ties nfet B=ISS
    with no isolation -> physically ISS=GND=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
2026-08-19 5.4 VCO: vco_core rebuilt with a REAL ISS node (nfet bulk->GND, source->ISS)
    Option (b), the layout fix. Previously nfet_leg taps=1 tied the pwell to the SOURCE
    rail, shorting ISS to substrate -> no ISS node, the tail mirror shorted out.
    Now: nfets use taps=0 (no bulk->source tie). Explicit pwell + three psub taps
    (welltap default offsets, 180-tall diff) tie the substrate to a SEPARATE GND rail at
    y-900, while the source rail stays its own ISS net at y-600. gf180 nfet_03v3 has no
    dnwell, so pwell = global psub = GND; the source (ISS) is a distinct M2 net.
    Extraction confirms the separation:
    .subckt vco_core VDD OUT_p OUT_n ISS GND
    X.. OUT_p OUT_n ISS GND nfet_03v3 ... (D G S=ISS B=GN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
2026-08-19 vco_v1.sch: cross-coupled nfet BULK ISS -> GND (authorized edit)
    The ONLY authorized schematic change. The two cross-coupled nfets (M1, M4) had their
    bulk tied to ISS (B=ISS), which a gf180 nfet_03v3 (no dnwell) cannot honour -- bulk =
    global psub = GND, so B=ISS shorted the ISS tail node to ground and the testbench's
    tail current mirror was shorted out. The layout (vco_core, commit 3390c30) already
    ties nfet bulk to a GND rail with the source rail kept as a distinct ISS net; the
    golden derives from this schematic, so it must read B=GND for the layout to match.
    Edit: deleted the two bulk->source wire loops and added lab_wire GND labels on each
    nfet's bulk stub. Nothing else -- sources still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
    [vco_v1.sch]
2026-08-20 5.4 VCO CLOSED: ISS/GND separate, verify_cp exit 0, verify_cp wired for the abstract
    Re-gated vco_v1 on the fixed vco_core (real ISS node) + edited .sch (nfet B=GND):
    - core placed 260 lower so its ISS/VDD/OUT ports realign after it grew for the GND
    taps; core GND rail = VSUBS = substrate GND (auto-ties to the resistor guard).
    - subckt vco_v1 = VDD ISS OUT_p OUT_n TUNE GND, ISS and GND DISTINCT.
    Re-simulation (body effect now real): starts at every VTUNE, band 4.13-6.35 GHz
    (0.3V 6.35G/568mV, 1.5V 5.53G/544mV, 3.0V 4.13G/472mV) ~ recorded 4.11-6.37 GHz.
    Startup margin healthy, not thin -- no device resize needed.
    GATE: verify_cp.sh vco_v1 exit 0 (RESULT PASS): magic DRC 0, LVS matc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
2026-08-20 Phase 7 rung 1: chip_top floorplan (docs/phase7-floorplan.md)
    Proposed placement of the 5 closed blocks into a chip_top, with coordinates and
    rationale driven by the constraints (vco isolated from PFD/DIV2 switching; ibias
    between CP and DIV2; 5 GHz VCO->DIV2 net short; pads upper-left per config B).
    Core bbox ~472 x 270 um; die ~560-600 x 360-400 um with the pad ring -- ~1/6 of the
    config-B allocation. Die size settled (do not shrink blocks).
2026-08-20 Phase 7 rung 2a: chip_top placement (5 blocks, no routing)
    chip_top instances all five closed blocks per docs/phase7-floorplan.md (getcell,
    LL-aligned, all masters pre-loaded). vco_v1's box is offset +13400iu because its .mag
    bbox (66x125, abstract inductor) is smaller than its real GDS footprint (182x179.5,
    full spiral extends 13400iu left of the .mag LL) -- the box places the REAL left edge
    at x290um, 53um clear of DIV2.
    magic DRC (placement) 0 (on the abstract .mag)
    chip GDS 14 cells, full hierarchy incl vco_inductor_v2 spiral
    chip bbox 472.0 x 270.2 um
    KLayout var-D 188 = 168 W4 varactor + 20 DF.13/14_MV
    The 20 DF.13_MV/DF.14_MV are all at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
2026-08-20 Phase 7 rung 2a (corrected): chip_top clean via golden-GDS merge
    The first 2a cut instanced PFD_lib.mag -- a 496-byte scaffold of 5 bare logic cells with
    NO endcap/filltie/tieh -- so PFD's rows had no well/substrate ties and tripped 20
    DF.13/14_MV latch-up rules at chip level (PFD alone was clean because the SIGNED-OFF
    gds/PFD_lib.gds carries the full tie ring; the stale .mag did not). Root-caused by
    attributing the KLayout markers to the gf180 std cells and diffing the .mag vs the golden
    cell list (golden has __endcap/__filltie/__tieh; stub has none).
    Two fixes:
    - chip_top.tcl now `gds read`s the golden gds/PFD_lib.gds as PFD's master (with its tie
    ring) instead of loading the bare stu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
2026-08-20 docs/tracking.md: Phase 7 status — 2a done+clean, 2b-2d/LVS gated on chip schematic
    7.1 chip_top placement SIGNED-OFF (magic DRC 0, KLayout var-D 168 = W4 only, die
    472x270.25um); records the two locked build facts (golden-GDS verbatim merge via
    chip_merge.py; golden PFD gds-read not the stub .mag). 7.2 routing/LVS GATED on a
    chip-top xschem schematic (PFD.FB phase, RST_N, MON_OUT undefined at the block
    interface; no pad cells -> 12 die-edge ports). 7.3 lvs_config repoint spec ready but
    NOT applied (clean chip GDS exists, chip golden netlist does not).
2026-08-20 .gitattributes: force LF for xschem .sch/.sym (container-side netlisting)
    Matches the existing *.sh/*.tcl eol=lf rule; keeps xschem sources LF so the
    in-container flow reads them correctly.
2026-08-20 Phase 7 item 2: create chip_top.sch (the only new schematic)
    chip_top.sch instances the 5 blocks + 10 pads and wires the power/signal map from
    docs/tracking.md 7.2. Generated deterministically by chip_sch_gen.py (connectivity by
    net label), so port order matches each block's signed-off golden .subckt line.
    WHY black-box interface symbols (not the committed block symbols):
    - CP_v1.sym is STALE: 5 pins (UP DOWN CP_OUT VDD VSS) but CP_v1's own signed-off golden
    + layout have 7 (adds VGP VGN). Instancing it would drop the bias nets. NOT a
    map-vs-real-port conflict -- the block's REAL interface (golden) matches the map; only
    the symbol is behind.
    - There is NO PFD_lib.sym (only P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
    [chip_top.sch]
2026-08-20 Phase 7 item 3: generate chip_top_golden.spice (from the schematic, not typed)
    assemble_chip_golden.py takes the TOP subckt verbatim from xschem's netlist of
    chip_top.sch (chip_top.spice) -- uncommenting xschem's **.subckt/**.ends and keeping the
    5 block instance lines -- and inlines the five SIGNED-OFF block goldens as the block
    definitions (dropping xschem's empty black-box stubs). So the golden = generated top
    connectivity + the exact per-block goldens each block's layout already LVS-matched.
    Device/port verification (count_golden.py) vs the sum of the five blocks:
    per-block X-instances: PFD_lib 7, CP_v1 8, ibias_gen_v1 17, DIV2_QUAD_v1 75, vco_v1 8
    SUM = 115
    chip_top_golden.spice: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
2026-08-20 Phase 7 item 5 (prep): chip LVS harness + validated baseline
    chip_top.abstract: same vco preload as vco_v1.abstract (vco_varactors + vco_inductor_v2
    device-aware .mags, gds noduplicates true) + netgen ignore-class vco_inductor_v2, so the
    chip extract sees the nmoscap gencell (magic DRC 0) and the spiral is W3-black-boxed.
    verify_cp.sh chip_top on the UNROUTED chip (harness validated end-to-end):
    magic DRC 0 (abstract preload -> varactor gencell-aware; no W4 in magic-on-GDS)
    devices 5 (the 5 block instances extract at top level)
    nets 25 (every block port still separate -- nothing routed yet)
    LVS DO NOT MATCH (expected: golden wires the block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
2026-08-20 Phase 7 items 4/6/7: routing plan (deferred), lvs_config check, render + docs
    Item 4 (routing 4a-4c) DEFERRED with an executable plan (docs/phase7-routing-plan.md):
    per-net port work-list in chip coords, layer discipline (H=M4/V=M3, power on wide M2
    straps, via3 at junctions -> no silent shorts), free-space/margin routing avoiding vco's
    M5 spiral, and WIP order. Not done blind in-script: a DRC-clean, short-free, LVS-matching
    route of ~11 inter-block nets + power across the 472x270 die is a multi-hour iterative job
    (the project's silent-short failure mode) and over the 15-min-per-task budget. Most
    inter-block nets are same-layer M2 -> simplifies execution. The harness (verify_cp
    chip_top) giv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
2026-08-20 Phase 7 item 1: bring vco ISS out to its own pad (10 -> 11 pins) — correction
    chip_top.sch had tied vco_v1.ISS to GND, reversing the 5.4 option-(b) decision (ISS a
    separate tail node) and invalidating the characterization: the 4.13-6.35 GHz band was
    simulated with a 1 mA tail mirror driving ISS; grounded on-chip the sources go straight to
    ground and the current is set by sizing+supply (far above 1 mA) -- a different VCO. ISS is
    now its own analog pad, tail current controllable off-chip. vco_v1.GND (nfet-bulk/substrate
    return) stays on the common ground.
    info.yaml (11 pins, clockwise upper-left, ISS in the analog group after IBIAS):
    VDDA IBIAS ISS VTUNE CP_OUT I_P I_N Q_P Q_N VDDD REF_IN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
    [chip_top.sch]
2026-08-20 Phase 7 item 2: fix stale block SYMBOLS (CP_v1.sym VGP/VGN; add PFD_lib.sym)
    CP_v1.sym declared 5 pins while its signed-off golden + layout have 7. Added VGP, VGN
    (dir=in) on the free left-bottom side so @pinlist = UP DOWN CP_OUT VDD VSS VGP VGN, matching
    CP_v1_golden.spice exactly.
    PFD_lib.sym did not exist (only PFD_v1.sym: right ports, wrong cell name, and pins in a
    different order). Created PFD_lib.sym with B-lines in GOLDEN order REF FB UP DOWN VDD VSS
    (so a hierarchical instance wires nets in the subckt's port order).
    These are SYMBOLS, not schematics -- authorized by the task; no block .sch touched.
    Verified: both fixed symbols' @pinlist == their golden .subckt port list. The chip_t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
2026-08-20 Phase 7 rung 3a (WIP): power routing infra + partial VDDA/GND/VDDD, silent short fixed
    Built DRC-clean KLayout routing primitives (route_lib.py: via stacks M1-M5, wires, correct
    gf180 via sizes 0.26 / enclosures; self-test route_selftest.py DRC 0). route_chip.py adds
    top-level metal to the PLACED chip_top.gds (run after chip_merge.py).
    Power scheme: 3 M5 buses in the y[180,205] band (verified clear of ALL block geometry
    full-width). Ports escape up a via stack to M4, an M4 riser drops to the bus level, via4 up
    to the M5 bus ONLY at the target.
    SILENT SHORT found + fixed (rule 8): first cut ran risers on M5, so a riser crossing a
    NON-target M5 bus MERGED the nets (GND riser crossed the VDDD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
2026-08-20 docs/phase7-routing-plan.md: record rung-3a progress + the silent-short lesson
    The M5-riser-crossing-M5-bus silent short and its fix (risers M4 / buses M5), the
    band-bus scheme, what connected (VDDA CP+ibias), and the interior-port blocker
    (vco/DIV2 ports in dense metal need per-net threading).
2026-08-20 Phase 7: tracking + re-render for ISS pad, symbol fixes, routing 3a WIP
    tracking 7.2 updated: 11 pins (ISS its own pad), CP_v1.sym/PFD_lib.sym fixed, routing
    rung 3a WIP (VDDA CP+ibias connected, silent short found+fixed, interior-port blocker).
    Re-rendered chip_top with the power buses in the band.
2026-08-20 Phase 7 items 1+2: refute the interior-port blocker + real EM sizing
    Item 1 (tap at extent, not label): net_extent.py / corridor.py show the "buried" power
    ports reach accessible metal -- DIV2.VSS 6.4um from the bottom; vco.VDD/ISS next to the
    x366-385 M5-clear corridor; DIV2 has an x220-235 M5-clear corridor. Only DIV2.VDD is
    genuinely awkward (extent x<=183, corridor 37um away) -> flagged. M5 occupancy mapped
    (PFD 0, ibias/CP 4, vco spiral x290-366, DIV2 x33-204).
    Item 2 (EM sizing, em_sizing.py, 1mA/um M2-M4 + 2mA/um M5): VDDA 3.5 / VDDD 22.9 / GND
    26.4 / ISS 1.0 mA (DIV2 22.4 on record; others estimated from bias structure). GND bus
    15um, VDDD 12um, VDDA 3um; DIV2 risers 23um (22um was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
2026-08-20 Phase 7 item 3: per-cell KLayout-DRC waiver mechanism for the W4 varactor rules
    klayout_signoff.py <CELL> runs the variant-D signoff DRC and applies team_src/magic/
    <CELL>.waivers (exact rule names, one per line). Waived rules report as WAIVED with count;
    ANY other violated rule fails the gate. Not silenced globally -- only the exact names in
    that cell's file, only for that cell. (Note: verify_cp.sh gates on MAGIC DRC, which is
    already 0 for the varactor via the abstract; the PL.5a/5b noise is the KLayout signoff, so
    the waiver lives there.)
    chip_top.waivers + vco_v1.waivers = {PL.5a_LV, PL.5b_LV} (nmoscap_3p3 field-poly-to-guard,
    device-internal, 168 items).
    Tested: chip_top with both wai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
2026-08-20 Phase 7 rung 3a: power routing -- GND free, VDDD complete, VDDA 2/3, no shorts
    KEY: GND needs NO routing -- every block VSS + vco.GND already extract as VSUBS (substrate),
    a chip-wide common with no pad. So power = VDDA + VDDD only. route_chip.py rewritten to drop
    the GND bus and route VDDA/VDDD from the band with M4 risers / M5 buses (silent-short
    discipline) + extent-tap corridors for the below-band blocks.
    Connected (KLayout signoff PASS = W4 waiver only; magic DRC 0; check_placement OK; extraction
    diff'd -- no silent shorts):
    VDDD = PFD.VDD + DIV2.VDD COMPLETE. DIV2.VDD tapped on its M4 collector wire (x108-183 @
    y137.5) and risen up the x160 M5-clear column -- clean, no sid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
2026-08-20 Phase 7 4b prep: signal-net extent analysis + routing-plan state update
    sig_extent.py maps each inter-block signal terminal's metal extent + closest block edge.
    Tractable (edge-accessible both ends): UP, DOWN, FB/I_P, VGP, VGN. Hard: IB_DIV2 (DIV2.IBIAS
    81um deep), VCO_OUTP/N (vco right-side congestion + 337um diff-pair span). Plan updated with
    the GND=substrate realization, the routed power/ports state, and the signal map.
2026-08-20 Phase 7 rung 4b (WIP): signal routing proven; UP deferred on tight PFD pins
    Demonstrated a signal net connects end-to-end with the H=M4/V=M3 discipline: a first UP cut
    extracted PFD.UP=CP.UP=one net, no OUT short. But PFD's UP/DOWN std-cell pins are 0.28um wide
    at 0.28um pitch, so a 0.26um via + enclosure either bridges the neighbor pin (M2.2a) or misses
    (disconnects) -- needs a minimal-enclosure via on the pin's exact centerline (per-pin precision,
    deferred). Backed UP out to keep the deliverable gate-passing.
    State: KLayout signoff PASS (W4 waiver only), magic DRC 0, check_placement OK, 11 ports.
    Power: VDDD complete, VDDA 2/3, GND=substrate. LVS DO NOT MATCH (vco.VDD + 8 signals remain).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
2026-08-20 Phase 7: tracking + re-render for power/ports routing state
    tracking 7.2 updated: GND=substrate (no routing), VDDD complete + VDDA 2/3, 11 port labels,
    EM sizing, W4 waiver mechanism, silent-short discipline + per-rung extraction diff, UP proven
    (deferred on tight PFD pins). Re-rendered chip_top with the power buses + port labels.
2026-08-20 Phase 7 item 1: GND metal ring (low-Z return; substrate common is NOT low-Z)
    Electrically GND was already the substrate common (VSUBS), but ~26 mA across a 472 um die
    through the p-substrate is tens of ohms / hundreds of mV of ground bounce into a 3.3 V analog
    design. Built a metal GND backbone.
    CHANNEL BUDGET (1b): the y[180,205] band cannot stack GND15+VDDD12+VDDA3 (=30um > 25). Chosen
    solution: GND rides a 20 um PERIMETER MARGIN as a ring; VDDD(12)+VDDA(3) stay in the band. Die
    grows 472x270 -> 522x309 um (still ~26% of config B's ~624,000 um2).
    GND ring: M5, 15 um, 4 segments (bottom y-10, top y280, left x-10, right x482), one net.
    Per-strap (1a): ring 15um carries <=26.4 mA total (2 m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
2026-08-20 Phase 7 items 2+3: vco.VDD + UP investigated to root cause (both DRC-blocked at the pin)
    Item 2 vco.VDD: mapped the geometry -- OUT_p/OUT_n M5 FILL x[396,472] (whole right side), so
    the only M5-riser-able column over vco is x[388,394] (spiral fills x<=366). The earlier short
    was the M3 JOG crossing OUT_p's M3 (it exits the core on M3-left); a STRAIGHT M5 riser at x392
    avoids OUT_p (verified OUT_p/n stay distinct). BUT vco.VDD's M2 in that column is a 1.5um wire
    interleaved with other-net active M2 at ~0.14um, so the via pad lands 0.14um off it (M2.2a) and
    does not merge. No clean tap without a vco-internal supply pin. VDDA stays CP+ibias (2/3).
    Item 3 UP: CONNECTS (extracted PFD.UP=CP.UP at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
2026-08-20 Phase 7 items 3+6: analog signals deferred (interior pins), DIV2.VDD EM measured
    Item 3 signals: VGP/VGN/IB_DIV2 have WIDE analog pins (tappable) but ibias.VGP/VGN sit
    INTERIOR to ibias (~140um from the right edge), so any run to CP crosses ibias's dense
    internal metal (M2 92 / M3 30). Signal H-hops also must dodge the power M4 risers + M5 buses
    (a VGP cut on M4 shorted to VDDA by crossing ibias.VDD's riser; on M3 it hit ibias M3). Layer
    plan for the dedicated pass: power M4/M5, signals M2/M3, route ONLY in Band C (x189-210) and
    the y[180,205] band, never over a block -- which needs the ibias pins escaped to an edge.
    Item 6 DIV2.VDD EM: the VDD tap is a SINGLE 0.28um M4 collector; 22.4mA /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
2026-08-20 Phase 7: tracking + re-render for GND ring + routing findings
    tracking 7.2 updated: GND metal ring (impedance correction), die 522x309, vco.VDD/UP/analog
    signal root-causes (all blocked at block-internal pins), DIV2.VDD EM 80 mA/um. Re-rendered.
2026-08-20 Phase 7 rung 4b-UP: signal UP routed clean via SAME-LAYER ESCAPE
    Item 1 technique proven. Instead of dropping a via pad on the pin (needs 0.38um vs 0.28um
    pins at 0.28um pitch -> M2.2a), EXTEND the pin along its own axis at min width (no via, no
    enclosure -> neighbour spacing stays as-drawn), then via up in open space:
    PFD.UP: 0.3um M2 stub at x246.12 (UP's label x; DOWN is at 247.24) up out of PFD into the
    y270.3-272.5 gap, then via(2,4). M4 across to x282.25, M4 down to y238.
    CP.UP: via(3,4) above CP (open), then 0.28um M3 extension down onto the pin (x282.11-282.39).
    Result: PFD.UP = CP.UP = one net (extraction diff), PFD.DOWN distinct, OUT_p/n distinct.
    KLayout signoff P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
2026-08-20 Phase 7 rung 4b-DOWN: signal DOWN routed clean
    PFD.DOWN M2 up-escape (0.3um stub @ x247.24, clear of UP@246.12); CP.DOWN M2 (x270-273 @
    y214.8) extended RIGHT along its own axis into the CP<->vco gap (x283.5-290, free), risen at
    x285. UP and DOWN M4 escape wires separated in y (UP y271 / DOWN y272, 0.4um) to avoid a
    same-layer merge (caught by the extraction diff).
    Result: PFD.DOWN = CP.DOWN (distinct from UP), OUT_p/n distinct. KLayout signoff PASS, magic
    DRC 0, check_placement OK.
2026-08-20 Phase 7 rung 4b-FB: loop feedback PFD.FB -> DIV2.I_P (=I_P net) routed clean
    PFD.FB M2 (PFD bottom) down-escapes into the y233-245 gap, jogs right to x232.5 to clear
    PFD.VDD's M4 VDDD riser (@x229.68 -- a first cut overlapped it, shorting I_P to VDDD/DIV2.VDD),
    then M4 down the x287 column (right of CP) into the DIV2<->vco channel and across at y140. At
    DIV2.I_P: the M1 escape avoids the DIV2 x237 M1 VDD guard ring by via-ing UP to M4 at x235.5
    (before the guard) and crossing the guard on M4 (guard is M1-only).
    Result: PFD.FB = DIV2.I_P = I_P (the I_P pad net); DIV2.VDD stays VDDD; OUT_p/n distinct.
    KLayout signoff PASS, magic DRC 0, check_placement OK.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
2026-08-20 Phase 7: tracking + re-render — same-layer escape, UP/DOWN/FB routed, DIV2 EM corrected
    tracking 7.2: SAME-LAYER ESCAPE technique (extend a pin along its own axis, then via up) that
    routed UP/DOWN/FB clean; 6 nets remain needing block pin escapes; DIV2 VDD EM corrected (80
    mA/um was a single-collector tap artifact, block mesh is fine, fix = multi-point tap). Die
    522x309. Re-rendered.
2026-08-20 Phase 7 A1: Bailey requirements -- 13 pins (VSSA/VSSD grounds), 0/0 boundary, no lfs
    A1a info.yaml -> 13 pins (yaml-validated): VSSA(ground) VDDA(power) IBIAS ISS VTUNE CP_OUT
    I_P I_N Q_P Q_N (8 analog, secondary_esd) VSSD(ground) VDDD(power) REF_IN. VSSA index0
    (quiet quadrant ground), VDDA index1, VSSD before VDDD, REF_IN last. project: block
    byte-identical.
    A1b VSSA/VSSD in chip_top.sch + golden (13 ports) + GND-ring labels @ (200,-10)/(200,280).
    COMPLICATION reported: every block VSS ties to the shared p-substrate, so VSSA and VSSD are
    ONE net without deep-nwell. The extraction MERGES them -> magic names the net VSSD, 12 ports
    (not 13); the golden has 13 with VSSD aliased to VSSA. Two p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
    [chip_top.sch]
2026-08-20 Phase 7 A3-VGP: bias VGP routed clean at CHIP LEVEL (no block edit needed)
    The M3/M4 column directly above ibias.VGP (x48.9) is CLEAR to the ibias top edge, so VGP
    escapes via a chip-level M4 riser -- no in-block escape metal required. Path: via up at
    (48.9,222) -> M4 up the clear column -> across the top margin -> down Band C (x189-210, free)
    -> extend CP.VGP's left-edge vertical (x210.5) into Band C at y228 (clear of the CP.VDD M2 rail
    at y231.6 -- a first cut tapped that rail and shorted VGP to VDDA).
    Result: ibias.VGP = CP.VGP = one net; CP.VDD stays VDDA; OUT_p distinct. KLayout signoff PASS,
    magic DRC 0, check_placement OK. (A2 block-escape not needed for this net.)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
2026-08-20 Phase 7 A3-VGN: bias VGN routed clean at chip level
    ibias.VGN (top edge) via up, DOWN the clear M4 column at x81.92 into the band, across at y183
    (BELOW the y188 VDDD / y199 VDDA buses + their M4 risers -- a first cut at y200 crossed the
    CP.VDD and PFD.VDD risers, shorting VGN to VDDA+VDDD), up to CP.VGN's bottom edge (x230.6-234.9).
    ibias.VGN = CP.VGN; CP.VDD stays VDDA; OUT_p distinct. KLayout signoff PASS, magic DRC 0. No
    block edit needed.
2026-08-20 Phase 7 A3-IB_DIV2: bias replica IB_DIV2 routed clean at chip level
    DIV2.IBIAS (81um deep) escapes UP on its own M3 (reaches y142.78; column x138-146 clear to the
    DIV2 top) into the band; ibias.IB_DIV2 (top edge) down the clear M4 column; joined at y186 (clear
    of VGN's y183 band crossing -- a first cut at y183 overlapped VGN). DIV2.IBIAS = ibias.IB_DIV2;
    VGN stays distinct; OUT_p distinct. KLayout signoff PASS, magic DRC 0. No block edit needed.
2026-08-20 Phase 7 A3-VCO_OUTP/N: the 337um differential pair routed clean
    OUT_p/n leads (y94.5, buried under the spiral) escape UP on their M3 columns (x401.8/x398 clear
    y95-179; the spiral is M5 and the underpass bar is M4, so an M3 riser clears both) into the band,
    M4 across parallel lanes (OUT_p y181->DIV2.CK x65; OUT_n y184->CKB x130), M3 down the clear DIV2
    CK/CKB columns. FB's x287 vertical moved to M3 so the OUT M4 lanes cross it on a different layer
    (a first cut shorted OUT_p/n/CK/CKB all to I_P through FB's M4 riser -- caught by the diff).
    Result: DIV2.CK = OUT_p, DIV2.CKB = OUT_n, the two DISTINCT. KLayout signoff PASS, magic DRC 0.
    MATCHING: lanes are parallel but OUT_p (~337um) > OUT_n (~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
2026-08-20 Phase 7 A4: CHIP LVS MATCHES UNIQUELY -- Phase 7 gate CLOSED
    verify_cp.sh chip_top: DRC 0, 12 ports, LVS "match uniquely", zero property/port errors,
    RESULT PASS. All 12 electrical nets connected + matched (VDDA CP+ibias+vco, VDDD PFD+DIV2,
    ground ring/substrate, UP DOWN FB VGP VGN IB_DIV2 VCO_OUTP VCO_OUTN, 11 signal/supply ports).
    5-block regression: all exit 0. check_placement OK. KLayout signoff PASS (W4 waiver only).
    Two fixes to close it:
    1. FB layout short: CP.UP's M4 vertical crossed FB's M4 y240 hwire (both M4), merging
    UP/DOWN/I_P. Routed FB's y240 run + x287 drop on M3 so it crosses the UP/DOWN M4 verticals
    and the VCO_OUT M4 band lanes on a different layer. (Caught by t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
    [chip_top.sch]
2026-08-20 Phase 7 A5+A6: VCO load estimate + docs closeout + re-render
    A5 VCO output load (review estimate, no resize): OUT_p ~494um / OUT_n ~431um routing (~40/35 fF)
    + DIV2 CML W=40 input gate (~40-55 fF) = ~75-95 fF/side -> ~-4 to -7% pull on the ~844 fF tank;
    band 4.13-6.35 -> ~3.9-6.05 GHz, still covers the 4.8-5.0 GHz for the 2.4-2.5 GHz /2 output.
    A6 docs: tracking.md CLOSED (LVS match uniquely, 522x309, all nets, no block edits); review-doc
    Phase-7 closeout with the chip result, VCO load, 168 W4 waiver, DIV2 VDD tap (80 mA/um) + internal
    VSS EM status, ~1.0deg I/Q offset, and the one declared area. Re-rendered.
2026-08-20 Phase 7 (pre-push): info.yaml 13 -> 12 pins (drop VSSD) to match the 12 layout ports
    The layout/golden have ONE ground net (all VSS ties the shared p-substrate; no deep-nwell) and
    therefore ONE ground LVS port (VSSA). Bailey's audit stars any pin without a matching port, so
    the pin list is reduced to 12 to match exactly: VSSA(ground,idx0) VDDA(power,idx1) IBIAS ISS
    VTUNE CP_OUT I_P I_N Q_P Q_N (8 analog secondary_esd) VDDD(power) REF_IN. The die still bonds
    ground at more than one ring point -- a bond/package detail, not a second pin.
    yaml validation: count=12; VSSA idx0; VDDA idx1; VSSD gone; REF_IN last; the 12 names == the 12
    chip_top LVS ports. verify_cp chip_top re-run: DRC 0, 12 ports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
2026-08-20 phase7 item2: DIV2.VDD multi-point chip tap (EM relief 80 -> ~1 mA/um)
    DIV2's VDD arrives on thin 0.28um M4 collectors. The prior single chip
    tap funnelled all ~22.4mA of DIV2 supply through one 0.28um collector
    point = ~80 mA/um -- an EM liability.
    Replace it with 40 injection points on a 3um pitch across DIV2's two VDD
    collectors (24 taps on the y137.5 collector x113..182; 16 on the y124
    collector x60..105). Each tap: 0.4um M4 riser from the collector up its
    clear column to y178 (below the OUT band lanes y181/184), via4, then a
    0.44um M5 hop up to the VDDD bus -- the M5 crosses the OUT M4 lanes on a
    different layer (no short). Junction taps at the collector edge (x108-110)
    are dropped; th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
2026-08-20 phase7 item3: equalize VCO_OUTP/N length (12.7% -> ~0.2%)
    The differential VCO output routes were mismatched: OUT_p = 494.3um,
    OUT_n = 431.5um -- a 62.8um (12.7%) skew, a static I-to-Q-adjacent phase
    error on the ~2.4-3.2 GHz buffered outputs.
    Detour the shorter side (OUT_n) with a ~64um M4 length-match notch that
    runs UP into the clear right-margin pocket -- east of the VDDA bus (which
    ends at x405) and west of the die edge (x423), a region probed clear of
    paint. The notch is all M4 on OUT_n's own net; it crosses only the
    vco.VDD M3 column (x405) and OUT_p's M3 up-column (x401.8), both on a
    different layer, and its down-leg stacks over OUT_n's own M3 column (same
    net). New OUT_n ~= 495.5um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
2026-08-20 phase7 items 4+5: known-limitations writeup + consistency sweep + re-render
    Item 4 (known limitations, docs/layout-review-aug14.md Phase-7 closeout):
    - W4 varactor waiver (168 = 84 PL.5a_LV + 84 PL.5b_LV, device-internal to
    nmoscap_3p3) -- already recorded.
    - VCO frequency pull: ~75-95 fF/side route+gate load -> band -4 to -7%
    (4.13-6.35 -> ~3.9-6.05 GHz), retunable via VTUNE.
    - VCO_OUTP/N: now equalized by item 3 (12.7% -> ~0.2%); note added.
    - DIV2 internal VSS EM: 2.96 mA/converter on 0.28-0.56um ties; root
    bottleneck ib_conv_v1's 0.6um M1 bus ~4.9 mA/um; ~1 mA/um is an industry
    rule-of-thumb, not a GF180 PDK rule (open PDK ships no EM deck).
    - ~1.0 deg I/Q offse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
2026-08-20 phase7 item6: browser/human-only tapeout handoff (docs/tapeout-handoff.md)
    Consolidated paste-ready values for the human/browser tasks that cannot run
    from the EDA container: #143 area+pin edits (die 522x309um = 161,298um^2,
    12 pins, keep the existing blob/main links), Bailey's allocation sheet row,
    the weekly form, and the ground-net question + VCO signoff-LVS heads-up for
    Bailey. Records that no push happened (4 local commits await approval).
    Docs only.
2026-08-20 WIP: reproduce Bailey's extra_be_checks LVS flow + root-cause the blocker
    Faithful local reproduction of d-m-bailey/extra_be_checks run_extract (the
    two-pass LEF-abstract flow, read from source) so we can test the submission
    without installing the tool (standing rule 1):
    - bailey_extract.tcl single-pass (property LEFview) variant
    - bailey_pass1_abstract.tcl PASS 1: lef write -hide -pinonly
    - bailey_pass2_extract.tcl PASS 2: lef read + gds noduplicates + extract
    Findings (docs/bailey-lvs-investigation.md):
    - Current submission FAILS Bailey's flow: 84 magic DRC (all PL.5a varactor,
    = the W4 family) + vco_v1 extracts 0 caps -> LVS DO NOT MATCH.
    - The abstract CAN black-bo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
2026-08-20 docs: flow-level finding -- GF180 gencell devices don't survive flat-GDS LVS
    A contribution for the chip-level integration LVS (extra_be_checks), not an
    A01-specific problem: any Chipathon project with an nmoscap varactor or a
    spiral inductor fails Bailey's flat-GDS extract the same way.
    Precise writeup: what fails (84 DRC all PL.5a + 0 caps + inductor ports merge
    -> DO NOT MATCH), why (magic gencell device identity does not survive a flat
    GDS round trip; no GF180 inductor extraction), our local workaround (preload
    device-aware .mags with gds noduplicates before gds read), and the two hooks
    extra_be_checks would need (device-aware preload, or origin-normalized
    EXTRACT_ABSTRACT to fix the LE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
2026-08-20 item1: origin-normalize vco_v1's frame in chip_top (Bailey LEF-abstract fix)
    Best-effort fix for a tool behaviour we could NOT test against the real
    extra_be_checks (rule 1): magic's EXTRACT_ABSTRACT LEF path mis-places a cell
    whose native lower-left != (0,0). chip_merge now shifts vco_v1's frame so its
    bbox-LL is (0,0) and places it directly at the floorplan target (290,0); the
    +(-blx,-bly) content shift and the (tx,ty) placement cancel to the original
    (tx-blx,ty-bly) offset, so the ABSOLUTE geometry is byte-identical. gds/vco_v1.gds
    is untouched, so block-level verify_cp vco_v1 is unaffected.
    Verified invariants (not assumed):
    - FLAT XOR of chip_top.gds before vs after = 0 polys (geomet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
2026-08-20 docs: record item1 (origin-normalization done) in the LVS investigation notes
    - bailey-lvs-investigation.md: Resolution section -- origin-normalization
    committed, LEF ORIGIN now 0, TUNE/ISS/OUT_p/OUT_n pins align; VDD/GND +
    EXTRACT_ABSTRACT config still open (deferred, unverifiable without the tool).
    - gf180-flat-gds-gencell-lvs.md: note our VCO cell is origin-normalized so the
    finding's option-2 caveat is closed on our side.
2026-08-21 docs: phase-8 padframe DEF analysis + expansion plan (docs/phase8-padframe-plan.md)
    Analysis-only pass over the issued padframe DEF (A01.def.tgz, BV/BH variants).
    NO geometry/schematic/config/GDS change; verify_cp still PASS on chip_top + 5
    blocks (baseline re-confirmed this session).
    - Item 1: full DEF inventory -- per-variant pin tables (slot, cell, use, dir,
    edge, translated_user rects in um), pin-rectangle spans and chip_top reach
    shortfalls (BV ~801 um vertical, BH ~177 um horiz + ~241 um vert), padring
    breaks (inter-project + VDDD/REF_IN digital-island break, no VSSD yet), and
    confirmation the generator sized from the OLD PFD_lib 60x24 (did not affect
    the 610500 um2 allocati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
2026-08-21 item4: phase-8 haul primitives in route_lib.py + isolated self-test
    New parameterized primitives (NOT wired into chip_merge.py/route_chip.py):
    - path_length() / route_path(): length accounting -- draw an orthogonal polyline
    and report its exact routed length so matching is verified, not assumed.
    - meander_points(): serpentine generator -- upward fingers padding a horizontal
    run by an exact `extra` um; finger count solved so every leg keeps >= w+MINSP,
    amp solved to hit `extra`; raises if the span cannot absorb it.
    - matched_route(): length-matched pair/quad router -- N (tap->pad) endpoints, each
    routed in its own channel lane (no self-short) with a serpentine detour to a
    common tar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
2026-08-21 phase8 analysis: REF_IN pull-down decision, I/Q matching + core placement, file moves
    Docs-only + off-flow analysis; verify_cp still PASS on chip_top + 5 blocks (Item 6).
    - Item 1a: REF_IN PU/PD -> DECISION PU=0,PD=1 (weak pull-down), overriding last
    session's PU=0/PD=0. Reason: a bench part often has the ref clock disconnected;
    a floating CMOS input oscillates/draws crowbar current, a pull-down parks REF_IN
    at a clean 0 so the PFD sees no reference and the VCO parks at a band edge
    (deterministic, diagnosable); 100k is negligible vs a 50ohm generator when driven.
    Polarity is now CONFIRMED for in_c (not just bi_t analogy) via the PDK
    "Digital I/O Cell Control Pins" truth table (0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
2026-08-21 phase8: ground-return number, pad-ordering reorder, RF loading, matched-quad dry-run
    Analysis + docs only; verify_cp still PASS on chip_top + 5 blocks (route_lib
    exercised, not modified; no geometry/schematic/flow change).
    - Item 1 (ground return): GND ring measured = 15um M5. West spur to the single
    VSSA pad carries ~26mA: dx200 -> 175um, R=0.47ohm (M5 40 mohm/sq from the magic
    tech), IR=12.1mV @26mA; L~175pH (1pH/um rule of thumb), XL~5.5ohm @5GHz. This is
    common-mode to the differential VCO, tail returns via ISS not GND, and it is <20%
    of the ~1nH VSSA bond inductance. VERDICT: does not change the placement; dx=200
    stands (widening the spur to ~30um halves the 12mV if wanted).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
2026-08-21 phase8: occupancy channel map, dy sweep -> dy=200, dry-run conflicts, other-10 pins
    exercised via the dry-run, not modified; no geometry/schematic/flow change).
    - Item 1 (channel map, docs/phase8-channel-map.md + analysis/channel_map.py):
    per-block per-layer occupancy confirms PFD 0 M5, ibias/CP 4 M5 each, DIV2 M5
    x33.5-204; CORRECTION vco M5 spans x290-472 (leads), not x290-366. Clear columns
    (M2&M3, y175-287.5): x181-204, x288-397, x406-472. Clear M2/M3 top band y273-287.5.
    - Item 2 (dy sweep, analysis/dy_sweep.py): a >=60um clear channel above the core needs
    dy<=200; dy>=~215 forces lanes over blocks (M3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
2026-08-21 phase8: in-context rehearsal, VTUNE coupling number, 14-net crossing table
    Analysis + docs; route_lib.meander_points gains an `amp` param (taller fingers for
    short lanes; self-test still PASS). verify_cp still PASS on chip_top + 5 blocks.
    - Item 1 (in-context rehearsal, analysis/phase8_incontext.py): chip_top instanced at
    dx200/dy200 (masters present, 84 varactor baseline). CORRECTIONS: the true matched
    length after jogging the right risers into the x381-404 ibias-CP gap is ~458um (not
    331.760, which was the conflicting straight-riser route). The matched quad does NOT
    drop in DRC-clean in context: base blocks=84, with routes=86 -- left risers are
    squeezed in a ~2.5um slot between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
2026-08-22 phase8: characterize GND ring, close the I/Q rehearsal to a clean 4-part gate
    Item 1: the GND ring is M5-only at the M3.2a corner (ring_corridor.py) -- west of
    DIV2 every layer but the M5 ring is empty, and M3-vs-M5 has no spacing rule. The
    "2.5um slot" was an artifact of escaping the left risers on M1 against DIV2's M1
    frame; nothing routes against the ring.
    Item 2: the matched I/Q quad now closes in context (dx200/dy200), gated four ways:
    - magic DRC: reh_phase8 == reh_base == 84 (0 added) [reh_drc.tcl]
    - KLayout signoff variant-D: PASS, 168 waived, identical to base [klayout_signoff.py]
    - routes-only extraction: 4 nodes, .subckt Q_N I_N I_P Q_P [reh_extract.tcl]
    - all four len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
2026-08-23 phase8: carry over last session's single-net haul probes
    Uncommitted work found in the tree at the start of the tapeout drive; committing
    it as-is so the info.yaml change lands on a clean baseline.
    - phase8_incontext.py: adds the layered-polyline HAUL table (PHASE8_HAULS env,
    default empty so the quad-only gate is unchanged) and route_haul().
    - analysis/{reh_find.tcl,tune_tap_geo.py,vco_ports.py,vco_west_escape.py}:
    the tap-geometry probes behind the VTUNE finding.
    Records the VTUNE haul as BOXED: the TUNE gate pad is reachable (via M1->M3 at
    the pad, M3 west over the varactor comp ring), but the rise to the west pad has
    no clean column -- x181-204 is unreachable at low y (DIV2 blocks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
2026-08-23 info.yaml: BH slot, add VSSD ground, reorder I/Q pads, secondary_esd false
    The Aug 28 organizer gate needs the design integrated into a def configuration,
    and Bailey regenerates the def files only once or twice a day from main, so the
    pin data has to be right before anything downstream is built.
    Three decisions (Greg, 2026-08-22):
    (a) Slot variant BH -- 1110 x 550 um landscape, slots W18-W22 + N01-N11.
    Chosen over BV for aspect match to the 522 x 309 core: the I/Q outputs reach
    the north edge in ~241 um instead of 550-900 um up BV's portrait west edge,
    and every phase-8 result (dx200/dy200 placement, matched quad, occupancy
    map, escapes) applies unchanged. Cost, recorded no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
2026-08-23 padframe: commit the organizer's issued DEF package (BH + BV)
    These files were lost once already: they had only ever been extracted to a
    scratch working dir, nothing in the tree referenced them, and T2/T3 depend on
    them for the DIEAREA and every pin rectangle. Committing them as inputs.
    Path: there is no existing convention for organizer-issued per-project
    artifacts. `ip/` is upstream LibreLane macro IP (gds/lef/lib/vh), `team_src/`
    is our own source, `docs/` is our writing -- none of them fit third-party
    inputs. New root-level `padframe/`, mirroring the tarball's own layout, next to
    the existing `padring-README.md`.
    Source archive `A01.def (1).tgz`, sha256
    b07a01ab46b00cbda141a262852e95cf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
    [A01_BH_padring.cfg, A01_BV_padring.cfg]
2026-08-23 magic: stop extraction from overwriting the tracked inductor .ext
    team_src/magic/vco_inductor_v2/vco_inductor_v2.ext is tracked and carries the
    real inductor extraction (device rsubckt tm11k, ports PORT1/PORT2). It was
    found modified in the tree at the start of the tapeout drive, overwritten by a
    geometry-free abstract -- no device, plus a new GND port. Restoring it was not
    enough: verify_cp.sh, the flow gate itself, reproduced the corruption on its
    very next run.
    Mechanism: magic writes each cell's .ext BESIDE the file that cell was loaded
    from, not to the current directory. verify_extract.tcl and reh_ctx_extract.tcl
    both addpath into the source tree to preload the vco_varactors and
    vco_in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
2026-08-23 T2: seat the core in the A01_BH DIEAREA, boundary exactly 1110 x 550
    gds/chip_top.gds is now the padframe block. Its 0/0 boundary is exactly
    (0,0)-(222000,110000) dbu = 1110.000 x 550.000 um, the A01_BH DIEAREA verbatim,
    per Bailey: "the width and the height should be the exact size of the block size
    specified for the pad frame blocks."
    Implementation: a final step in route_chip.py, replacing the old "0/0 boundary
    at the true die extent" code that tracked chip.dbbox().
    chip.transform(pya.DTrans(200.0, 200.0))
    ly.clear_layer(ly.layer(0, 0))
    chip.shapes(ly.layer(0, 0)).insert(pya.DBox(0.0, 0.0, 1110.0, 550.0))
    Seating the core here rather than offsetting chip_merge.py's BLOCKS table k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
2026-08-23 verification: T4 baseline is a BOX SET, not a DRC total
    magic's `drc list count total` is frame-dependent and is not a valid gate across
    a frame change. Seating chip_top inside the A01_BH DIEAREA was a pure +200/+200
    translation -- no geometry created, moved relative to anything, or deleted -- and
    the reported total still went 84 -> 106. The violations were bit-identical: 252
    boxes both sides, 0 added, 0 removed, one rule (PL.5a). Magic re-attributes
    errors per cell when the parent frame moves.
    A gate comparing totals would have read that as 22 new violations and sent
    someone hunting a bug that does not exist. So the gate now compares box sets.
    New in docs/verification.md section 8:
    - the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
2026-08-23 phase8: VTUNE is NOT boxed -- 3m's premise died when the core was seated
    Section 3m concluded VTUNE was boxed. That conclusion is withdrawn. It was
    reached while chip_top was 522 x 309 and every route had to win an internal
    column. T2 seated the core at (175.00,178.50)-(697.00,487.50) inside a
    1110 x 550 die, creating free die south of y178.5, west of x175, east of x697
    and north of y487.5 that did not exist when 3m was written.
    Re-measured against the real geometry with a new analysis/vtune_routes.py
    (per-segment occupancy scan of the seated GDS; writes nothing), not from memory:
    - VTUNE tap is die (558.68, 266.70) on M1 = core (358.68, 66.70), read from the
    L34/10 VTUNE label in the se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
2026-08-23 phase8: allocate the west strip and south corridor for all five nets at once
    VSSA, VDDA, IBIAS, ISS and VTUNE all land on the west edge, and VTUNE's approved
    route plus the GND-ring extension plus the likely ISS path all want the same free
    die. Allocated once, before any metal is cut, because routing them one at a time
    is exactly how 3m happened -- a lane looks clear until the net that needed it is
    routed third.
    Every lane measured on EVERY layer (M1-M5, comp, poly, cont, vias), not just
    M2/M3. The channel map's clear columns were computed as "clear of M2 AND M3"
    only, which is how 3m came to treat die x489 as a clear column when it has M4 in
    it. Nothing in this allocation reads off that ma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
2026-08-23 phase8: ISS is the VCO tail return -- 3o's lane for it is invalid
    3o reserved ISS a 0.4 um M3 riser and called its escape unsolved. Both halves
    were wrong, in opposite directions.
    WHAT ISS CARRIES, from the golden netlist and not the layout. The inlined vco_v1
    golden has XM1/XM4 as "OUT_p OUT_n ISS GND nfet_03v3" -- nfet order is D G S B,
    so ISS is the common SOURCE of both cross-coupled nfets, i.e. the tail node, with
    the bulks on a separate GND. There is no on-chip mirror; the mirror is in the
    testbench. So ISS is not a bias reference into a current mirror -- it is the
    entire return path of the VCO core to the outside world, and as the common-source
    node of a cross-coupled pair it carries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
2026-08-23 phase8: EM limit for the ISS strap, and check the allocation with a tool
    EM (item 2, lookup not analysis). The open PDK ships NO EM data -- no
    current-density table anywhere under /foss/pdks/gf180mcuD/, and the KLayout DRC
    decks are geometric only. The authoritative source is GF180MCU DRM 14.2, which
    targets T0.1 > 100 kHours at 85 C junction. For Metal1 through Top-Metal-1, i.e.
    M1-M4 here, the unidirectional limit is 2.09 mA/um at 85 C, 1.00 at 110 C and
    0.67 at 125 C; via1-5 are 0.58 / 0.28 / 0.18 mA per cut.
    The vco_v1 ISS strap is 0.40 um M2 carrying up to 1.57 mA of DC tail current, so
    the unidirectional column applies. Tapped at one end it runs 3.93 mA/um: 1.88x
    over at 85 C, 3.93x a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
2026-08-23 phase8 (a): build the matched I/Q quad into chip_top -- clean gate
    Ported from analysis/phase8_incontext.py's throwaway cell into
    phase5/route_chip.py, in CORE coordinates ahead of the seat step. All four
    escapes, the west-to-east left-riser ordering, I_P's novia and the
    low-jog/high-jog split carry over verbatim; each fixes a specific silent short
    (3i, 3l) and none is cosmetic.
    MATCHED LENGTH RE-DERIVED, not carried across the frame change. Base lengths in
    the core frame are Q_N 331.76, I_N 278.65, I_P 298.41, Q_P 433.76; Q_P sets the
    target; all four route to 433.760 um with spread 0.0000. The number is unchanged
    from pre-seat, which is the expected result rather than a coincidence -- the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
2026-08-23 phase8: the slot centre is in a GAP on all eleven multi-finger pins
    3r found this on one pin while building the quad and filed it as a quad fix. It
    is not a quad fix. New analysis/pin_landings.py runs the test on every pin in the
    issued DEF, and ALL ELEVEN multi-finger pins have their nominal slot centre
    inside an inter-finger gap. Not one is on metal.
    A bare drop at the centre touches nothing, and that is DRC-clean (there is
    nothing to space against), LVS-clean (the net still reaches its label), and dead
    on silicon. Same failure family as the silent short: the check that would catch
    it is not the check being run.
    It is systematic rather than luck -- the generator lays an EVEN number of fi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
2026-08-23 phase8 (b)-(e): route VSSA, VTUNE, VDDA, IBIAS and ISS -- all gates clean
    All five west nets are in chip_top and the assembled chip passes every gate:
    magic DRC box set 106 / 252 boxes with 0 added and 0 removed against
    chip_top.drcbase; KLayout signoff PASS with 168 waived; extraction 5 devices /
    12 PORTS / 21 nets; LVS match uniquely with zero disconnected nodes;
    check_placement CONSISTENT; lane_conflicts 0 net-vs-net overlaps.
    Four real defects surfaced during the build and NONE was found by magic DRC.
    BUG 1 -- R.hwire extends half its width past each endpoint. Undocumented, and it
    bites in proportion to width. The VSSA M2 leg nominally ending at die x0.5 really
    reached x-4.25, outside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
2026-08-24 phase8 (f): 13-pin DEF verified, VSSD/VDDD/REF_IN/PU/PD built and landed
    The 13-pin package arrived. Extracted to padframe/A01/project_defs_13pin/
    ALONGSIDE the 12-pin one, which is kept so the two can be diffed.
    ALL THREE ARRIVAL CHECKS PASS. selected_variants is BH only with
    participant_pin_count 13 -- not bumped to another config -- and project_size now
    reads 1110 x 550 / rectangle_dbu [0,0,222000,110000], so the generator has picked
    up our seated 0/0 boundary. breaks[1] is BRK_BEFORE_N06 with reason
    additional_power_ground_set, firing before VSSD's slot and not VDDD's, exactly as
    3q predicted. in_c lands at N08. Every predicted coordinate in 3s is confirmed
    exactly, including the three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
    [A01_BH_padring.cfg, A01_BV_padring.cfg]
2026-08-24 analysis: landing_check -- assert every haul REACHES its pin, with a margin
    lane_conflicts detects nets that DO touch and should not. This detects nets that
    do NOT touch and should. Opposite defects; no single check finds both, which is
    why this is a separate tool rather than another mode of the existing one.
    Five landing defects have now been found, every one DRC-clean and every one
    caught only after the fact by an LVS port count: the four I/Q drops aimed at the
    slot CENTRE, which is an inter-finger gap on all twelve multi-finger pins;
    VSSA_uq0, the pad-plate via placed 2.0 um outside the plate; VDDA_uq0, the via4
    placed 2.5 um short of a bus that starts at x258.5 and not the x256 the plan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
2026-08-24 phase8 (g): route CP_OUT to N01 -- the last declared pin
    CP_OUT was DECLARED in info.yaml as pin 6 / slot N01 and had NO METAL. Found by
    landing_check, which is the only check that could: a port count cannot catch an
    unrouted net, because an unrouted net has no label to be missing from a list.
    Route derived on the SEATED frame, not taken from 3g. Layer per segment is forced
    by what is already built, and every segment was checked in lane_conflicts BEFORE
    the metal was cut:
    M4 472.25 y415.41 -> 460 up the tap's own 0.6 um M4 stub (die y406.20-424.62)
    M3 472.25 y460 -> 495 above the M3 horizontal at y440
    M2 392 -> 472.25 @ y495 M2 west, clearing Q_P's riser (x400) and REF_I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
2026-08-24 phase8: fix the ground port name with a label datatype, not a schematic change
    3v left LVS failing pin matching on one name: layout VSSD against golden VSSA.
    The proposed fix was a schematic edit. It is not needed.
    From the magic tech file, every metal carries two label mappings:
    layer MET2 layer MET2TXT
    labels allm2 noport labels allm2 port
    calma 36 0 calma 36 10
    Text on <layer>/10 becomes a PORT; text on <layer>/0 becomes a plain label magic
    never promotes to one. VSSA and VSSD are one electrical net, magic emits one name
    for it, and with both texts on /10 it was picking VSSD.
    The VSSD text now goes on 36/0. It is still in the GDS; it simply never com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
2026-08-26 rung 2: density keep-out markers -- and PMNDMY, not NDMY, is the layer that stops metal fill
    Whoever inserts fill, us or the organizer, would otherwise drop dummy metal on the spiral and
    the varactor array. Supplied unconditionally; not waiting on Bailey's fill answer.
    THE PLAN OF RECORD WAS WRONG ABOUT THE LAYER.
    The fill generators in drc/filler_generation/ are the authority on what actually gets dropped,
    and fill_metal.rb subtracts only Metal, the fuse layers, PMNDMY, MTPMK, OTP_MK and the scribe
    ring. NDMY and IND_MK appear NOWHERE in it. Cross-checked against the DRC rules, which agree:
    marker dummy COMP dummy POLY2 dummy METAL
    NDMY 111/5 3.5 um DCF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
2026-08-26 rung 3 (IBIAS): secondary ESD -- organizers' cell, ballast in series, and a real ground return
    First of the eight analog pins. ISS follows in its own commit; the other six wait on the
    organizers' answer about scaling 160 um perimeter for leakage/capacitance-sensitive pins.
    WHAT LANDED, all at MEASURED coordinates in the die frame:
    esd_pd2nw (24.220^2) at (22.000,440.000) pad -> VDDA clamp, 4x 10x10, 160 um perimeter
    esd_nd2ps (22.600^2) at (60.000,440.000) VSSA -> pad clamp, 4x 10x10, 160 um perimeter
    esd_rpoly (16.600 x 5.620) at (40.000,427.000) ppolyf_u 16/4 ballast, IN SERIES
    VSSA strap M2 10 um from (84.30,451.30) to the GND ring at die x190.00
    SIZING AND TOPOLOGY ARE TH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
    [chip_top.sch]
2026-08-27 rung 3 (ISS): secondary ESD -- no ballast by design, and the first multi-rule dump
    Second of the eight analog pins. The remaining six are BLOCKED on the organizers' answer about
    whether 160 um perimeter can scale down for leakage- and capacitance-sensitive pins (CP_OUT,
    VTUNE and the four I/Q outputs), so this is the end of the rung for now.
    WHAT LANDED, at MEASURED coordinates in the die frame:
    esd_pd2nw (24.220^2) at (105.000,300.000) pad -> VDDA clamp, 4x 10x10, 160 um perimeter
    esd_nd2ps (22.600^2) at (105.000,335.000) VSSA -> pad clamp, 4x 10x10, 160 um perimeter
    VSSA strap M2 10 um from (129.30,346.30) to the GND ring at die x190.00
    NO SERIES BALLAST, DELIBERATELY. 50 ohm o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
    [chip_top.sch]
2026-08-27 rung 3 (ISS relocation): move the clamp into its own W21 pin band
    Geometry only -- the golden is UNTOUCHED. Bailey (Discord): "The def file has pins that extend
    inwards by 1um. You can abut to those pins or to the actual boundary." Measured, both W20 and
    W21 pin rectangles do reach x0.000-1.000.
    MOVED, at measured coordinates:
    esd_pd2nw (105.000,300.000) -> (20.000,368.000)-(44.220,392.220)
    esd_nd2ps (105.000,335.000) -> (50.000,368.000)-(72.600,390.600)
    VSSA strap (129.30,346.30) -> (74.30,379.30) -> GND ring die x190.00
    The clamp now sits INSIDE its pin band (DEF y360.340-404.660) instead of ~55 um below it.
    THE EARLIER "WEST STRIP IS OCCUPIED" FINDING WAS MEASURED ON THE WRON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
2026-08-27 rung 3 (IBIAS relocation): clamp into the W20 pin band, and the ballast becomes the FIRST element
    Geometry only -- the golden is UNTOUCHED. Second and last of the approved relocations.
    esd_rpoly (40.000,427.000) -> (20.000,268.000)-(36.600,273.620)
    esd_pd2nw (22.000,440.000) -> (38.000,268.000)-(62.220,292.220)
    esd_nd2ps (60.000,440.000) -> (66.000,268.000)-(88.600,290.600)
    VSSA strap (84.30,451.30) -> (90.30,279.30) -> GND ring die x190.00
    The clamp now sits INSIDE its pin band (DEF y260.340-304.660) instead of 135 um north of it.
    THE POINT IS NOT THE 22 um IN X, IT IS WHAT WAS BETWEEN THE PAD AND THE BALLAST. The old chain
    was pad -> M2 feede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
2026-08-27 docs: which analog pins need a secondary ESD clamp, and why the gate-6 seed keeps moving
    Two records, no geometry.
    docs/esd-which-pins.md -- decision record. All eight analog pins traced to their first
    device terminal off the golden, with the proving device and terminal for each. Only TWO
    reach a gate: IBIAS (ibias_gen_v1/XMNC0, diode-connected, net on both drain and gate) and
    I_P (PFD FB -> dffrnq_1 CLK -> X_tn10 nfet_05v0 gate, because I_P doubles as the loop
    feedback). The other six are diffusion-only -- VTUNE in particular lands on the varactor
    BULK, not its gate: cap_nmos_03v3_b port order is (B, G) from the PDK symbol pin numbering.
    The rule that makes this matter -- secondary ESD ma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
2026-08-28 JOB B PRE-BUILD (branch only, NOT for merge): 13 -> 12 pins, I_P off the pin list
    Built against a SYNTHESIZED def so the work is ready to diff-and-verify when Bailey's real
    regeneration arrives. NOTHING HERE IS APPROVED -- Greg has asked, not been answered.
    WHY: docs/verification.md 8.10. PFD's FB taps I_P on the PAD side of XR_SER_IP, so the feedback
    clock reaches dffrnq_1's CLK through 1 kohm into the pad's 875 fF: tau = 912 ps against a
    416.7 ps period, 11.4 % swing at 2.4 GHz. The loop would not lock. Removing the PAD drops the
    node to ~23 fF (tau 23 ps, >99.9 % swing) and touches no signed-off block.
    THE SYNTHESIZED DEF, and how far to trust it:
    padframe/A01/project_defs_12pin_SYNTH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
    [chip_top.sch]
2026-08-28 padframe: the real 12-pin package, and the synthesis was exact
    A01.def (3).tgz, sha256 5ea8e9c6c252fc1ce64b12d7383c60e1da939fcfb5de9fe7f251836ec04e27dd,
    received 2026-08-27 23:42. BH only, no BV. Extracted to A01/project_defs_12pin/
    alongside our pre-build A01/project_defs_12pin_SYNTH/, which is KEPT for the diff.
    THE SYNTHESIS WAS EXACT: 0 pin-level differences. Every slot, cell, cell_terminal,
    direction, use and every rectangle matches across all 12 pins. The three top-level
    differences are our own SYNTHESIZED marker, participant_pin_count (we left 13, real
    says 12 -- the one thing we got wrong, and it is metadata), and top_cell_text, which
    is his scrape of our GDS and so newer than ours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
    [A01_BH_padring.cfg]
2026-08-29 rung 3 (IBIAS via array): 16 cuts -> 752, and the M2 bridge is what caps it
    Geometry only -- the golden is UNTOUCHED. Only via1 cuts and one tab widening change.
    WHY. The organizers' reference layout finally exists to compare against:
    sscs-chipathon-2026/resources/Integration/Chipathon2025_pads/magic/secondary_ESD.gds
    (io_secondary_5p0, last year's pads). It carries 1040 via1 cuts in ONE clamp. Ours carried
    16. Each diode plate is 9.980 x 9.870 um = 98.50 um2 of solid M1 and had exactly ONE 0.26 um
    cut on it. gf180 ships no via EM/ESD rating, but at the usual ~10-30 mA per 0.26 um W-plug
    cut, 4 cuts per diode is ~40-120 mA against an HBM peak of order 1.3 A: on present evidence
    the CUT, not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
2026-08-29 rung 3 (ISS via array): the second and last pin -- 14 cuts -> 750
    Geometry only -- the golden is UNTOUCHED. One-line source change: ESD_VIA_ARRAY gains "ISS".
    Everything else was already built and gated under 781e30b; this commit only lets it apply to
    the second clamp, which is the point of the per-pin gate.
    DRAWN (ISS only -- IBIAS is bit-for-bit unchanged at 752):
    ISS.pd2nw plates 4 -> 324 cuts (4 plates x 9x9) no new metal
    ISS.nd2ps plates 4 -> 324 cuts (4 plates x 9x9) no new metal
    ISS.nd2ps ring 4 -> 100 cuts (25/arm) tab 1.2 -> 16.0 um, +59.2 um2 M1
    ISS.pd2nw ring 2 cuts, UNCHANGED (0.295 um to RING B -- same call as IBIAS)
    Verified in the w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
2026-08-29 rung 3: re-capture chip_top.drcbase against the ISS via array
    Baseline re-capture only -- no geometry in this commit.
    GDSBLOB 3a27a671fb51 -> 3231333c68fa (= HEAD~1:gds/chip_top.gds, verified)
    SRCCOMMIT 781e30b -> efc63e8 (the commit whose layout this measures)
    TOTAL 84, boxes 252, SELFCHECK OK rules=1/1 boxes=252/252
    Box set unmoved for the second time: drc_delta.py against the 781e30b baseline gave
    ADDED 0 / REMOVED 0. Rung 3's via-density pass is complete at 1500 ESD via1 cuts across both
    clamps (752 IBIAS + 750 ISS, from 30) with zero new violations at any stage.
2026-08-29 housekeeping: retire the JOB B pre-build, and every section ref now resolves
    Item 4 of the closeout. No geometry, no gate-affecting change.
    DELETED, both superseded by the real 12-pin package landing at 5e55d14:
    - branch `job-b-12pin` (LOCAL ONLY -- it was never on origin, so no remote change).
    Tip was d1ca528, recorded here because reflog is the only way back.
    - padframe/A01/project_defs_12pin_SYNTH/ -- one file, a synthesised interface.yaml
    self-labelled "SYNTHESIZED: NOT ORGANIZER-ISSUED".
    THE SYNTH COPY IS NOT BYTE-IDENTICAL TO THE REAL ONE, and it was never supposed to be.
    5e55d14 kept it "for the diff" and predicted exactly three differences; the diff was run
    before delet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
2026-08-29 docs: settle ib_inv1.tcl from history, not by renaming it to something plausible
    div2-layout-plan.md cited `ib_inv1.tcl` as "committed". No such file exists. The plausible
    fix was to rewrite it as ib_inv_gen.tcl and move on. That is exactly how scope.md ended up
    pointing at a "3.1" that never existed, so it was measured instead:
    git log --all --diff-filter=D -- '*ib_inv1.tcl'
    38f317d 5.3 1e: unify inverters on one make_inv path; retire ib_inv1 one-off
    git log --all -- '*ib_inv1.tcl'
    38f317d (deleted)
    e80f175 5.3 1e sub-block PASS: CMOS inverter (INV1 10/4) LVS match uniquely
    ANSWER: it existed and was RETIRED, not renamed. `team_src/magic/phase5/ib_inv1.tcl` was
    added 2026-08-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
2026-09-01 padframe: the 2026-08-31 package -- the first one with a BLOCKAGES section
    A01.def.tgz from issue #143, d-m-bailey 2026-08-31 12:34:45Z, downloaded from
    https://github.com/user-attachments/files/31645100/A01.def.tgz
    sha256 de6659ce66351f9506787aaf8c75b31134ed83bad74f03d4471c997f83797b38, 27791 bytes.
    Staged as a NEW directory. project_defs_12pin/ (the 2026-08-27 package, sha256
    5ea8e9c6c252fc1ce64b12d7383c60e1da939fcfb5de9fe7f251836ec04e27dd, landed at 5e55d14)
    is NOT overwritten -- every gate on record ran against it, and landing_check.py's
    default DEF_ROOT still points there. Nothing in the flow is repointed by this commit.
    HIS REASON, verbatim: "Discovered the possibility of shorts betw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
    [A01_BH_padring.cfg]
2026-09-01 docs: the six gates re-run against the 0831 package, and what that does NOT prove
    Runs the suite against padframe/A01/project_defs_12pin_0831/ (the 2026-08-31 package with
    the Metal2 BLOCKAGES section), closing gaps item 20. landing_check.py was pointed at it via
    its PADFRAME_ROOT env override ONLY; the committed default still targets project_defs_12pin
    and was not edited -- verified after the run by re-reading line 34 and by a bare invocation,
    which still prints "targets from .../project_defs_12pin".
    drc_boxset + drc_delta PASS TOTAL 84, 252 boxes, 0 ADDED / 0 REMOVED, blob 3231333c68fa
    identical both sides (no provenance mismatch)
    klayout_signoff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
2026-09-01 signoff: make the LVS artifacts and the device list visible in the repo
    Bailey 2026-09-01: Fraunhofer requires each chip to declare exactly which devices it uses,
    and he is looking for extraction results in the repos -- "if I can't find an lvs.report or
    can't match a device name, then I can't aggregate your project."
    THE PROBLEM WAS VISIBILITY, NOT MISSING WORK. Every artifact he wants has existed since
    2026-08-20, in team_src/magic/verify_work/ -- which is GITIGNORED, because it is regenerable
    build output. Nothing in it has ever been visible on GitHub. verify_work stays ignored; this
    commit adds a tracked COPY under signoff/.
    REGENERATED FIRST, so the committed copies describe the curren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
2026-09-01 docs: the DIV2 EM truth, a verified fix that is NOT shipped, and why
    Item 2 of the alternate-readiness pass. NO source or layout file is touched by this commit:
    the EM fix is deliberately NOT applied, because the repo must not carry a generator that
    disagrees with the shipped GDS.
    MEASURED TRUTH, and my earlier claim was WRONG. I previously reported the VSS bus as 1.20 um
    and the density as ~2.45 mA/um, on the reasoning that ib_inv_lib.tcl treats hw as a
    half-width. The half-width reading is right; the unit conversion was not. ib_conv_v1.mag is
    `magscale 1 10` = 200 internal units/um, not the 100 iu/um that chip_top.mag's `magscale 1 5`
    uses. Measured on the taped-out gds/DIV2_QUAD_v1.gds: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
2026-09-01 docs: N=2 leaves no usable phase-detection window -- the three loop writeups
    Item 1 of the alternate-readiness pass. Documentation only; no source, layout or netlist file
    is touched. Three new subsections, 4.6.1 / 4.6.2 / 4.6.3.
    4.6.1 -- N=2, AND IT IS THE MOST IMPORTANT THING IN THE DOCUMENT. Traced through
    chip_top_golden.spice lines 18/21/35/103, not inferred: PFD.FB is wired to I_P, I_P is a
    DIV2 output at VCO/2, and PFD_lib's golden holds exactly 2x dffrnq_1 + nand2_1 + 2x inv_1 +
    2x tieh with NO divider. The only division in the loop is the CML /2, so N=2 and lock needs
    REF_IN at 2.4-2.5 GHz.
    reference period at 2.45 GHz 408.2 ps
    PFD min reset pulse 500 ps typ (verif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
2026-09-01 signoff: PEX on CP_v1 -- the current match is now an extracted number, not a schematic one
    Item 3. Every charge-pump matching claim in this project was schematic-level (gaps item 8).
    The CP's current match is its headline spec, so it is the one block where an extracted number
    earns its keep. Read-only on gds/CP_v1.gds; nothing was written back to a committed artifact.
    THE RESULT -- the layout does not degrade the match.
    CP_OUT schematic extracted delta
    0.50 V +1.675 % +1.721 % +0.047 pp
    1.50 V -0.001 % +0.007 % +0.008 pp
    2.50 V -1.635 % -1.638 % -0.004 pp
    over all 49 points, 0.4-2.8 V:
    schematic min -2.274 % max +2.246 % mean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
    [cp_v1_match.csv]
2026-09-01 docs: final pass -- the review doc now reflects everything from 2026-09-01
    Item 6. Documentation only.
    HEADER now carries a four-row summary of the revision against Caglar's four tapeout-priority
    items, so a reviewer sees the outcomes before the 900 lines: item 1 the loop cannot lock
    (4.6.1-4.6.3), item 2 fix verified but not shipped (4.5), item 3 CP_v1 PEX done (4.2.1),
    item 4 waiver evidence assembled and fill not started. States explicitly that NOTHING in the
    revision changed the shipped GDS -- gds/ is byte-identical across 7485fec..HEAD, verified.
    NEW 4.2.1 -- the extracted UP/DOWN match, the one matching claim in this design that is no
    longer schematic-level. Full table plus the two s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
2026-09-11 docs: the M2 plate + via stitch is built and green (1.000 mA/um vs DRM 14.2 110C); the DRM was consulted 2026-08-23
2026-09-11 DIV2 VSS EM: M2 plate + 193 via1 stitch in ib_conv_v1 (4.93 -> 1.000 mA/um)
    Replaces the M1 widening, which shorted NS to VSS and had never been LVS'd.
    M1 geometry is untouched (hw stays 60); conductor is added on metal2 only:
    a staircase plate merged across all four VSS segments (472 iu = 2.36 um per
    row alongside the 0.60 um M1 = 2.96 um), stitched to M1 along the whole
    overlap. Criterion: GF180MCU DRM 14.2, 110 C unidirectional = 1.00 mA/um
    (phase8-padframe-plan.md 3q), which this meets with zero margin.
    Gated at BOTH levels, from the repo copies via the committed GDS:
    ib_conv_v1 magic DRC 0 | LVS 14 dev / 6 ports / 17 nets match uniquely,
    0 property errors | KLayout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
2026-09-11 DIV2 VSS EM: ties widened, plate grown 7.5 -> 22.4 um, IP tie reconnected (10b/10c/10d)
    All three DIV2-level VSS items fixed in one ib_div2.tcl change. Criterion:
    GF180MCU DRM 14.2 @110 C unidirectional = 1.00 mA/um (phase8-padframe-plan.md 3q).
    IP :238 1.00 um TO NOTHING -> strip 2.96 + risers 3.00 parallel 0.987 mA/um
    IN :275 0.28 um 10.571 -> 2.96 um 1.000
    QN :308 0.56 um 5.286 -> 2.96 um 1.000
    QN :309 0.28 um 10.571 -> 2.96 um 1.000
    QP :342 0.56 um 5.286 -> 2.96 um 1.000
    QP :343 0.28 um 10.571 -> 2.96 um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
2026-09-11 chip_top: re-integrate the fixed DIV2 -- all six gates green, drcbase re-based
    Rebuilt with chip_merge.py then route_chip.py. The merged die carries the new
    blocks: ib_conv_v1 via1 45 -> 238 (the +193 M1/M2 stitch) and DIV2_QUAD_v1
    M2 165 -> 169. Cell set unchanged at 26, no extras and no drops, die still
    1110.000 x 550.000 um.
    Six gates, each against its value from 52a783a:
    drc_boxset + drc_delta TOTAL 84, 252 boxes, 0 ADDED / 0 REMOVED same
    klayout_signoff var-D 84 PL.5a_LV + 84 PL.5b_LV = 168 waived same
    verify_cp.sh chip_top DRC 0, 10 devices, 11 ports, match
    uniquely, 0 property errors same
    landing_check (0831) 14/14 t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
2026-09-11 verify_extract: extract unique noports -- close the same-name label merge for non-port labels
    Verified a no-op on CP_v1, ibias_gen_v1, PFD_lib, DIV2_QUAD_v1, vco_v1 and chip_top:
    identical device/port/net counts and all six still match uniquely. Ports are not
    renamed, so subckt port matching against the goldens is unaffected. Port-labelled
    splits remain invisible to it -- the metal-only connectivity gate covers those.
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2026-09-11 signoff: R+C PEX of ib_conv_v1 -- 14 devices, 70 caps, 526 R
    Second block with an extracted netlist, after CP_v1 (review condition item 3).
    Source is the committed gds/ib_conv_v1.gds at ce09ccf; recipe adapted from
    pex_cp_v1.tcl with only the cell name and GDS path changed.
    The device count is 14, equal to the LVS device count (verify_cp.sh ib_conv_v1:
    14 devices / 6 ports / 17 nets, match uniquely, 0 property errors). A PEX
    netlist whose device count differed from LVS would mean the extraction dropped
    or invented a device.
    R:C is 526:70 against CP_v1's 269:265 because the 193-cut via1 stitch added on
    2026-09-11 turns every cut and every metal segment between cuts into its own
    parasitic re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
2026-09-11 docs: handoff-sep11 -- draft issue-143 comment for Greg to post, with a sources block
    Covers item 2 closed (VSS current density before/after vs DRM 14.2 110 C, and the
    I_P tie found returning through substrate), the nmoscap PL.5a/PL.5b waiver evidence
    with a request for explicit acceptance, item 3 PEX counts for CP_v1 and ib_conv_v1,
    item 4a full-die density measured with per-layer shortfall in um2 and the fill
    ownership question, and the chip_top GDS update at ce09ccf.
    Every number is file-read; the sources block maps each claim to file and section
    and sits OUTSIDE the paste markers. Nothing here touches GitHub: Greg posts it.
2026-09-11 signoff: R+C PEX of vco_core -- 30 devices, 194 caps, 208 R; block-level item 3 complete
    Third extracted block after CP_v1 and ib_conv_v1, same recipe, source is the
    committed gds/vco_core.gds.
    Device count 30 equals the LVS device count (verify_cp.sh vco_core: 30 devices /
    5 ports / 7 nets, match uniquely, 0 property errors, DRC 0). The schematic golden
    is 4 devices; the layout folds them into fingers (W70 pfets as nf5/w14) so
    extraction sees 30 instances that netgen combines back to 4. The PEX check is
    against the extracted count, which is what verify_cp reports.
    Extracted netlists only. No testbench, no re-simulation; the recorded VCO band
    4.13-6.35 GHz stays schematic-level and is not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
2026-09-11 I_P label fix + scope reframe: stray top-level label removed, chip described as open-loop
    STAGE 1 -- I_P classification (organizer audit 20260907-1 listed it UNMATCHED).
    Three-way diff:
    info.yaml pins (12) VSSA VDDA IBIAS ISS VTUNE CP_OUT Q_N I_N Q_P VSSD VDDD REF_IN
    DEF PINS (14) the 12 above + REF_IN_PD + REF_IN_PU (pad control ties)
    chip_top.gds (15) the 14 above + I_P
    I_P is a STRAY TOP-LEVEL LABEL, not an info.yaml entry defect. Byte-compared
    against I_N: I_N is present in all three sets (info.yaml io_type analog,
    secondary_esd false; DEF; GDS on 34/10). I_P is present only in the GDS, on
    34/0, and has had no info.yaml entry since it came off the pad list at 020852a.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
2026-09-11 chip_top: regenerate with the I_P label fix -- 14 top-level labels, all six gates green
    Rebuilds gds/chip_top.gds with the route_chip.py change committed at 80f14ad, so
    the stray I_P top-level label that organizer audit 20260907-1 reported UNMATCHED
    is no longer emitted.
    top-level labels 15 -> 14: CP_OUT IBIAS ISS I_N Q_N Q_P REF_IN REF_IN_PD
    REF_IN_PU VDDA VDDD VSSA VSSD VTUNE. Every one is either an info.yaml pin (12)
    or a DEF pad-control tie (REF_IN_PD, REF_IN_PU). No label without a pin entry.
    I_P remains an internal net, it just carries no top-level text.
    Six gates, each against its value from the previous cycle:
    drc_boxset + drc_delta TOTAL 84, 252 boxes, 0 ADDED / 0 REMO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
2026-09-11 docs: item 23 status (cause characterized, not fixed) + the three outgoing messages
    ITEM 23 STATUS. Cause is resistive and localized to the converter VDD
    distribution. The extracted converter does not reproduce schematic behaviour and
    no single resistor group recovers it: INV2 feed alone 83 mVpp, every VDD resistor
    94, every parasitic resistor in the cell 109, against a 131 mVpp schematic
    reference. The degradation reaches back past the output: S1 swings 534 mVpp
    extracted against 1172 in the schematic.
    A supply-to-bias gain of 4.15x at S2 is measured (an ideal 40 mV drop on INV2 VDD
    moves S2 from 1490.5 to 1324.3 mV) but is NOT shown to be the mechanism: at that
    gain the extracted 71.8 mV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
2026-09-17 ib_conv_v1 VDD EM: M3 plate + 80 via2 stitch + 3-cut bus taps (4.93 -> 1.000 mA/um)
    Item 23 VDD counterpart of the VSS fix in 11d3d7b, one layer up.
    The internal VDD spine carried the full 2.96 mA per converter through a 0.60 um
    M2 bus = 4.93 mA/um, the identical number VSS had before 11d3d7b. PEX showed the
    VDD net as 17 parasitic resistors in a ZERO-loop tree where VSS now has 476 in a
    191-loop mesh, and port-to-inverter R 8.5-10.4x the VSS side.
    (a) M3 plate 472 iu = 2.36 um over the M2 spine, alongside the 0.60 um M2 =
    2.96 um total -> 1.000 mA/um at 2.96 mA. METAL2 and METAL1 coverage are
    byte-for-byte unchanged (union area delta exactly 0 iu^2); conductor is added
    on M3 o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
2026-09-17 docs: item 23 VDD fix status + survey numbers + before/after R
    layout-review-sep01.md
    - §6 item 23: records the read-only survey that motivated the fix (spine
    4.93 mA/um = the identical pre-fix VSS number; VDD net 17 resistors in a
    zero-loop tree vs VSS's 476 in a 191-loop mesh; port-to-inverter R 8.5-10.4x
    the VSS side; every via on the path a single cut, 13 via1 vs VSS's 198),
    what was built (M3 plate 2.36 um -> 1.000 mA/um, 80 via2 stitch, bus taps
    1 -> 3 cuts, M1/M2 union-area delta exactly 0), the hierarchy-only via2
    defect found en route (8 parent-level errors, 2 per instance, clean
    standalone; 9 stitch cuts skipped), and the before/after cumulative R tab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
2026-09-18 docs: item 23 extracted re-sim with 9614947 VDD fix
    Re-ran ONLY the R+C case (div2_mix.spice - the deck both the 25 mVpp and the
    94 mVpp rows were measured on; div2_run_vdd is likewise a mix deck). Schematic
    and C-only cases not re-run. Same deck, same .meas, same tran 0.2p 20n uic,
    same set num_threads=2, same golden converters; only the converter's PEX
    netlist was swapped for one rebuilt from gds/ib_conv_v1.gds at 9614947.
    Netlist 14 dev / 136 C / 625 R (was 14 / 70 / 526). VDD net 17 -> 116 resistors
    and 0 -> 33 loops; VSS net byte-identical at 476 R / 59,903.732 ohm.
    Result, against the three recorded references (25 old extracted / 94 all-VDD-R
    -zeroed ceiling / 131 schematic):
    I_P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
2026-09-18 DIV2 VDD: remove the east-side daisy chain (inst3 no longer fed through inst0)
    Phase B (a). QP's VDD riser used to stop at y3200 and via DOWN onto
    ib_conv_v1_0's *internal* M2 trunk, so QP's 2.96 mA entered IP's private
    0.60 um spine at y3200 and left it at y3850: one instance's supply current
    crossed another instance's internal metal, and IP's trunk carried 5.92 mA over
    that stretch (survey.md 3.1). A hierarchy-blind `select net` saw it as two
    separate top-level fragments joined only through the child.
    The riser now runs to y3850 and merges with IP's own riser in the same column
    (ipVbus == qpVbus == 23560). IP and QP each tap the shared parent M4 riser
    through their own via stack. The old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
2026-09-18 DIV2: keep VDD plates out of the chip-level routing corridors (item 23, phase B6)
    The B5 VDD plates are clean at DIV2 level but chip_top drives VCO_OUTP and
    VCO_OUTN down through this cell on metal3 at DIV2 x~0 (CK) and x~13000 (CKB).
    A plate there is invisible to DIV2's own DRC/LVS and shorts VDD to the VCO
    clocks the moment chip_merge places the block. Rebuilding chip_top from the
    committed sources reproduced that: the merged netlist put DIV2's CK and CKB
    pins and the VCO output all on VDDD.
    The plate generator now folds a third obstruction source into the free-window
    measurement: every top-level rect and contact of gds/chip_top.gds at 162faca
    that falls inside DIV2's footprint, mapped to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
2026-09-18 docs: record the chip-corridor rule as DIV2 generator invariant 3 (item 23, B6)
    Adds invariant 3 to the DIV2 plate-generator section: the generator must also
    avoid the chip-level routing corridors, because chip_top drives VCO_OUTP and
    VCO_OUTN through this block on metal3 at DIV2 x~0 and x~13000. A plate there
    passes every DIV2-level gate and shorts VDD to the VCO clocks on merge --
    the same clean-DRC/clean-block-LVS/broken-on-integration signature as
    invariant 2, reached a different way.
    Records the 81-hit intersection and the two decisive shapes, the obstruction
    recipe (gds/chip_top.gds at 162faca, M1-M5 + via1-via4, 60 iu margin, every
    net except VDDD), and why a trimmed corridor must be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
2026-09-18 docs: chip-level VDDD power section, EM table reconciled, item 23 closed out
    layout-review-sep01.md gains a "Phase C -- the chip-level VDDD path, pad to
    DIV2" section: the full before/after segment table (705.7 -> 39.3 mV to
    DIV2's VDD port, 695.6 -> 35.8 mV to PFD, worst via 22.90 -> 0.113 mA/cut),
    what measurement changed against the plan, and the five metal segments that
    remain over 1.00 mA/um with the reason each cannot widen in plane.
    The plan was wrong in two checkable places and both are recorded: a 12 um M5
    strap cannot run the vertical legs, because VDDA's M5 bus and the GND ring
    top cross every x between the VDDD bus and the y305 rail; and DIV2's M2/M3
    plate bands do carry child c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
2026-09-18 chip_top: REF_IN_PD/PU texts to 36/0 (organizer-flow LVS port fix)
    The two pull-up/pull-down tie labels were on 36/10, magic's port datatype, so
    the layout extracted 13 chip_top ports against a golden that declares 11.
    Both ties are deliberate -- PD to VDDD, PU to VSSD -- so the organizer-flow
    netgen reported them as shorted pins and failed top-level pin matching:
    Pins REF_IN_PD and VDDD are shorted in cell chip_top (0)
    Pins REF_IN_PU and VSSA are shorted in cell chip_top (0)
    Demoted to 36/0, exactly as VSSD already was in this file and for the same
    reason: the magic tech maps `calma 36 10 -> labels allm2 port` and
    `calma 36 0 -> labels allm2 noport`, so the text stays in the GDS for
    B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
2026-09-18 VCO tank: OUT_p/OUT_n to the inductor's two terminals, multi-cut leads, chip taps and meander retuned
    Both VCO outputs were routed into the SAME inductor terminal and the other
    terminal was left unconnected: OUT_p and OUT_n were one node and the coil was
    a floating stub. It was not a mis-drawn wire -- three separate files carried
    the same 10x error.
    team_src/magic/vco_inductor_v2/vco_inductor_v2.mag PORT1/PORT2 label rects
    and their metal5 paint at 1/10 of the real coordinates. FIXED_BBOX was
    already right, and so was the committed vco_inductor_v2.ext, whose ports
    have always read -8000 / -400 at y -4800.
    phase5/vco_v1.tcl P1x -800, P2x -40, Py -480 -- those three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
2026-09-18 docs: the VCO tank short, its cause, the lead/imbalance numbers and two toolchain invariants
    layout-review-sep01.md gains a VCO section: the defect (both outputs on one
    inductor terminal, the other unconnected), the measured terminal geometry,
    the same 10x error in three files, why option (b-ii) was taken over (a), (b-i)
    and (c), the lead resistance before/after (21.55/14.07 -> 2.333/1.733 ohm,
    dR 7.48 -> 0.600), the residual imbalance as a percentage of tank C (0.32 %),
    and the chip-level taps with the retuned item-3 match (494.3/495.5 at 0.2 %
    -> 453.5/453.5 at 0.0 %, notch +64 -> +21.0 um).
    It records plainly that nothing in the gate set could see the defect: the
    .mag flow extracts the i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
2026-09-18 signoff: vco_v1 tank-level PEX on the corrected layout
    R+C extraction of the whole tank on the post-6573181 layout: 75 devices, 557
    parasitic caps, 683 parasitic resistors, 2 s. Same recipe as pex_vco_core.tcl
    with one deliberate difference -- the source is the .mag hierarchy, not
    gds/vco_v1.gds. Reading the GDS traverses the spiral and shorts the two
    terminals, because a coil IS a DC short between its ends; the hierarchy keeps
    vco_inductor_v2 as the LEFview abstract so the committed vco_inductor_v2.ext
    supplies the coil model (two tm11k either side of the m4 bridge, 7.46 fF per
    port), which ext2spice then inlines. That .ext is read-only in the flow and
    its md5 is unchanged across the run.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
2026-09-18 signoff: vco_v1 startup, golden control vs extracted, on the corrected layout
    The control oscillates and is settled. The extracted netlist does not start.
    Deck: the bench's stimulus, buffer, load and options (gear, reltol 1e-5,
    bypass 0, the four PDK includes) around team_src/magic/vco_v1_golden.spice
    instead of the xschem vco_v1, so the control measures the netlist the LAYOUT
    is LVS'd to -- the bench schematic carries ppolyf_u_3k r_length=5u where the
    golden, vco_tune_r and the layout all carry ppolyf_u_1k r_length=15u.
    VTUNE 2.0 V, tran 5p 40n uic, a +/-10 mV differential .ic kick, measured over
    30-40 ns. NO solver option was added: uic removes the operating-point solve
    that made the prev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
2026-09-18 signoff: vco_v1 extracted tank does not start; R breakdown and ISS sweep
    Corrects the tank series resistance published in 39138d3. The 3.8 ohm figure came
    from two errors in the Laplacian solve: the output leads were taken as the minimum
    effective resistance over the branch's metal sub-nodes rather than to the device
    terminals, and the 21 varactor units per side were combined as 1/sum(1/R) even
    though they share the tap wire and so do not parallelise.
    Solved correctly (tank node -> all of a branch's device terminals shorted into one
    supernode) the tank loop is 19.131 ohm: leads 4.742 / 6.530, varactor branches
    3.550 each, coil 0.760. Only ~1.46 ohm of that is metal vco_v1.tcl draws; ~11 ohm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
2026-09-18 signoff: cap_bias is the binding term; extracted VCO oscillates, not landed
    Classified every resistor in the 4.5 ohm extraction by net and scaled each class
    alone at ISS 1.0x. cap_bias is the smallest class by summed R (292 ohm against
    GND's 1.26 Mohm) and the only one that starts the oscillator: x0.1 gives 1.329 Vpp
    at 4.299 GHz, while GND, VDD and ISS are each dead. Control all-R x0.2 oscillates,
    so the deck matches the earlier test. There are no separate gate nets -- in a
    complementary cross-coupled pair the gates are the tank nets.
    cap_bias is not a bypassed supply: it hangs off TUNE through a 1 kohm ppolyf and is
    the varactor bank's differential virtual ground, so what lands in the tan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
2026-09-18 signoff: vco_v1 PEX, bisect, startup and band on the landed tank
    Re-extracted vco_v1 on the landed low-R tank (75 devices, 804 caps, 1259 resistors) and
    recorded what the bisect found.
    Classifying every parasitic resistor by net and scaling each class alone named cap_bias: the
    smallest class by summed R (292 ohm against GND's 1.26 Mohm) and the only one that starts the
    oscillator. It is not a bypassed supply -- it hangs off TUNE through a 1 kohm ppolyf and is the
    varactor bank's differential virtual ground -- so the number that lands in the tank is its
    bank-to-bank resistance, OUT_p's 21 terminals to OUT_n's 21. Measured from its driver instead
    it reads 0.617 ohm and the 8 ohm in the tank i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
2026-10-27 lvs: 2-pin vco_inductor_v2 golden with tm11k subckt
    vco_v1_golden.spice defines vco_inductor_v2 PORT1 PORT2 as the two tm11k
    (r_width=8u r_length=76u) the layout extracts, in series through one node,
    and instances it 2-pin (PORT1=OUT_p, PORT2=OUT_n). The dropped GND pin was
    the xschem simulation model's substrate-cap reference; the layout has no
    such terminal. chip_top_golden.spice regenerated by assemble_chip_golden.py.
    mkdeck2.py swaps the 3-pin lumped model back in for the golden sim DUT.
    verify_cp .mag gates unchanged: vco_v1 4/6/11, chip_top 10/11/25, match.
    Organizer flow (extra_be_checks@7d1f5ef): stock tech 14/18 dev, 21/22 nets,
    failed pin matching; with the rm5 fix (drop `and RESD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
2026-11-02 ibias: simulate IBIAS pin voltage/compliance; fill test plan
    - New team_src/sim/ibias/ibias_pin.spice.in + run_ibias_pin.sh: the
    ibias_op bench plus v(IBIAS) and a 0-360 uA I_BIAS sweep, run at
    TT/FF/SS x VDD 3.0/3.3/3.6 (schematic, 27 C). TT/3.3 V control
    reproduces the recorded 50.00/49.91/239.56 uA.
    - v(IBIAS) at 240 uA: 2.066 V TT, 1.787 FF, 2.349 SS, VDD-independent;
    2.484 V max at 360 uA SS. Filled into docs/test_plan.md 3 and 5.4,
    with the SS/3.0 V VGN headroom shortfall noted; IBIAS rows removed
    from the section 8 run list.
2026-11-02 vdda: simulate VDDA current (VCO+CP+IBIAS); IBIAS SMU spec in test plan
    - New signoff/sim/vdda/: CP_v1 (PEX) + ibias_gen_v1 op points at
    TT/FF/SS, and vco_v1 (landed PEX) 200 ns transients at ISS 1.0x/2.0x
    with the bench buffer moved off the measured supply. One job at a
    time, 2 threads. VCO runs reproduce the recorded 0.974 Vpp / 4.372 GHz
    and 2.207 Vpp / 4.402 GHz.
    - VDDA (TT, 3.3 V, VTUNE 2.0 V): 1.90 mA at ISS 1.0x, 2.93 mA at 2.0x
    (VCO 1.300/2.332 + CP 0.050 + IBIAS gen 0.549 mA; +0.050 mA with UP
    on). Replaces the 3.5 mA estimate in docs/test_plan.md section 3.
    - Section 5.4: drive IBIAS from an SMU or a source with >= 2.5 V
    compliance, limit not above VDDA (ESD diode).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
2026-11-02 iss: simulate ISS node voltage and tail-sink compliance; fill test plan 5.1
    - New signoff/sim/iss/: deck generator from the landed vco_v1 extraction
    (pex200.spice), analyzer and runner. `node`: bench tail mirror at
    1 mA / 2 mA reference x VTUNE 0 / 2.0 / 3.3 V (reproduces the 3.2.1 band
    to 0.003 GHz). `sweep`: ideal sink 1.0-2.35 mA at VTUNE 2.0 V. One job
    at a time, 2 threads, ~21 min total.
    - v(ISS) 1.0-1.42 V everywhere, minimum 1.009 V (2.0x, VTUNE 3.3 V): the
    off-chip sink must regulate at <= 1.0 V. 1.0x = 1.27-1.39 mA, 2.0x =
    2.24-2.38 mA; an ideal sink needs ~1.15 mA to oscillate at VTUNE 2.0 V.
    - docs/test_plan.md 5.1 gets the sink requirement and both tables; 3 points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
2026-11-02 test_plan: apply team decisions of 11/2 (pass limits, bench setup, results)
    Each marked "team decision 11/2":
    - VCO: oscillates at 2.0x ISS over VTUNE 0-3.3 V; band within +/-10 % of
    the extracted 3.806-5.760 GHz; f monotonic decreasing; power and phase
    noise report only. VTUNE step 0.1 V.
    - DIV2: f_VCO/2 tone on I and Q; quadrature 90 +/- 10 deg.
    - IBIAS: pin 1.6-2.5 V at 240 uA.
    - Supply currents within +/-30 % of sim; limits VDDA 6 mA, VDDD 50 mA.
    - ISS sink regulates down to 0.8 V.
    - REF_IN 0/3.3 V, 1 MHz, 50 % duty, as in PFD_tb.sch / PFD_CP_tb.sch.
    - Power-up order: grounds, VDDA/VDDD (limited), IBIAS, ISS, VTUNE, REF_IN.
    - PFD+CP: CP_OUT-only partial test.
    - Results: results/ with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
2026-11-02 cp_out: single REF_IN edge drives the pump to UP; three-band CP_OUT check
    - New signoff/sim/cp_out/pfd_cp_edge.spice + runner: PFD_lib (layout
    golden, gf180 std cells) + extracted CP_v1 + ibias_gen_v1 at 240 uA,
    CP_OUT held at 1.65 V, FB low, one REF_IN rising edge. Before: idle,
    +12.2 pA. After: UP = 3.3 V, +50.21 uA. 11 s, 2 threads.
    - docs/test_plan.md 5.3: the +/-30 % idle limit is replaced by the
    three-band check (team decision 11/2): idle |I| < 1 uA, UP +35..+65 uA,
    DOWN -35..-65 uA; pass = every reading lands in a band, and one REF_IN
    edge with the VCO stopped gives UP. Power-up state undetermined (no PFD
    reset).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
2026-11-02 signoff/lvs: README states the organizer LVS currently fails
    The section heading said "it PASSES"; that described the LVS_IGNORE
    config dropped in f7be3d5 (2026-09-25). A fresh clone of c3acfe0 with
    stock extra_be_checks@7d1f5ef gives 14 vs 18 devices, 21 vs 22 nets,
    "Top level cell failed pin matching". The heading now says so, with a
    current-status block up top (including the passing verify_cp, drc_boxset
    and klayout_signoff results from the same clone), and the 9/19 pass and
    its waivers are labelled historical.
2026-11-02 repro: drop out-of-repo paths; LVS README cites Bailey's 9/25 ruling
    - signoff/lvs/README.md: the organizer LVS failure follows Bailey's
    2026-09-25 #143 ruling (cap_nmos_03v3_b and vco_inductor_v2 out of
    LVS_IGNORE, f7be3d5; he would fix the tech file). Names the two techfile
    gaps (no varactor cifinput rule; `calma RESDEF 110 *` wildcard does not
    match on input) and the re-run result: 14 vs 18 devices, 21 vs 22 nets,
    failed pin matching; the gap is 2 cap_nmos_03v3_b + 2 tm11k in vco_v1.
    - klayout_signoff.py, mkdeck2.py: REPO from $UPRJ_ROOT or __file__.
    - mkdeck.py, mkdeck2.py: SRC is the committed signoff/sim/vco/vco_tb.spice
    (identical to the scratch copy it pointed at).
    - cpma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
2026-11-02 varactors: write COMP under the 42 cap_nmos_03v3_b gates (was missing in every GDS)
    Magic's stock gf180mcuD tech does not write COMP (22/0) under a 3.3 V
    nvaractor: the gdsii cifoutput DIFF layer takes `alldiff`, and alldifflv
    omits nvaractor/pvaractor (the 6 V aliases include mvnvaractor). Every
    vco_varactors/vco_v1/chip_top GDS so far had poly over field oxide at the
    42 varactor gates; the PDK KLayout LVS derivation found 0 of them.
    - gds/vco_varactors.gds rewritten from the unchanged .mag with the patched
    tech (stock-tech control write XORs to 0 vs the old file); spliced into
    gds/vco_v1.gds and gds/chip_top.gds. XOR vs before: 22/0 +1050.000 um2
    only; bbox and all labels unchanged.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
2026-11-03 tech_patches: upstream rm5 fix (diff + draft issue/PR text), not posted
    - open_pdks_rm5_pr.diff: drop "and RESDEF" from the rm5 cifinput rule in
    fossi-foundation/open-pdks gf180mcu/magic/gf180mcu.tech (inside
    #ifdef METALS5 || METALS6); one line, applies cleanly to main 55f1ea3.
    - open_pdks_rm5_draft.md: issue + PR text. Cause: magic never writes
    RESDEF for metal resistors (layer RESDEF allres excludes rm1-rm5) and
    the PDK KLayout deck derives tm_res without RES_MK. Evidence: organizer
    LVS 14 vs 18 -> 16 vs 18 after the COMP fix; with rm5, matches uniquely.
    Notes the same pattern in rm1-rm4/rmtp and a likely MET2RES 110 11
    typo, both untested.
    - README points at the drafts; ref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
2026-11-06 d-block rung 1: seat chip_top in the 605 x 605 um D die; west rows off
    Bailey issued the D package on #143. Seat A (DX, DY = 100, 255) moves the
    core by the north pins' own delta, so the 8 north rows keep their core
    coordinates. Plan: docs/d-block-plan.md.
    - route_chip.py: seat, DIE_W/DIE_H 605 x 605, 0/0 = D DIEAREA. The six BH
    west rows reach die x-100, so WEST_ROWS_BUILT = False switches them off
    until they are rebuilt. Keep-outs move with the seat. Clamps follow their
    pins (-45); IBIAS a further -10 to clear the ring, so its VSSA strap now
    runs north into the ring bottom strap.
    - landing_check.py: defaults to the D package (PADFRAME_ROOT and
    PADFRAME_VARIANT override), seeds f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
2026-11-06 d-block rung 3: ISS rebuilt against the D pin, 10 um bus
    M5 10 um lane at die y195, M4 10 um hop over VSSA's descent with a 2.5 um
    gap each side (0.5 um failed MT.2b), M5 riser at die x9.7-19.7, west of
    the IBIAS clamp and 0.30 um from it, M5 bus over both clamp nodes. Every
    via on the path is now an array (64/64, 256, 256/256, 208 x 3, and the two
    clamp nodes), and the kept M4 descent lands through a 256-cut array.
    Gates: landing ISS OK, 11/14, nothing regressed; magic DRC 0; KLayout 0,
    no waivers; no new merges (nets 23->21, 325->323); check_placement OK;
    varactor gate PASS.
2026-11-06 d-block rung 4: IBIAS rebuilt against the D pin through its ballast
    M3 0.4 um from the tap with the existing M4 hop, riser at die x36 (die x34
    would have shorted to the ISS D1 clamp-node M3 plate), down to the clamp
    node. W19 plate extended to die y212.75 to reach the ballast terminal; it
    stays at die x<=18, 2 um clear of the clamp.
    Gates: landing IBIAS OK, 12/14, nothing regressed; magic DRC 0; KLayout 0,
    no waivers; no new merges (nets 21->20, 323->322); check_placement OK;
    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
2026-11-06 d-block rung 7: docs and deliverables for the 605 x 605 um die
    No geometry change; gds/chip_top.gds is untouched.
    Docs move to block D: die 605 x 605 um, seat A (100, 255), ring 522 x 305,
    slots W17-W22 and N01-N06. BH records stay as dated history. test_plan gains
    a pad slot column and the ISS bus drop (6.3 ohm, 9.9 mV at 1.57 mA).
    lane_conflicts.py is marked BH-only. route_chip.py's stale ISS comment is
    replaced with the as-built drop and EM table. Export form 1b(iv) now gives
    605 x 605 um. chip_top images re-rendered from the D GDS.
    Gates: ref_audit PASS; verify_cp match uniquely; magic DRC 0, delta 0/0;
    KLayout 0; landing 14/14; varactor PASS; run_full_lvs with rm5 match uniquely;
    run_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
2026-11-08 Path independence: build chain, gates, sim runners and decks find the repo themselves
    A reviewer can now clone anywhere. Repo root comes from the script's own location,
    or $UPRJ_ROOT when set (unset by default):
    - chip_merge.py, route_chip.py (incl. the ESD cell reads), check_placement.py,
    landing_check.py: derived from __file__.
    - chip_top.abstract, vco_v1.abstract: PRELOAD_PATH is relative to team_src/magic;
    verify_cp.sh resolves relative entries against its own dir.
    - Sim runners (cp_out x2, vdda, iss, ibias pin): locate themselves; vdda/iss export
    UPRJ_ROOT for pex200.spice's $UPRJ_ROOT include.
    - Static decks: relative .include (cp_out x2, ib_conv div2_* x12, cpmatch_sch, five
    i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
2026-11-09 ref_audit: pass on a fresh clone; reword local-output refs, EXTERNAL list for PDK paths
    A fresh clone failed ref_audit with 35 unresolved path refs that only resolved in a
    working checkout through git-ignored or untracked files.
    - Local outputs reworded so they are not parsed as repo paths: LibreLane
    final/metrics.json, resolved.json and stage state_out.json (run-directory outputs),
    the local rehearsal GDS reh_routes.gds / reh_phase8.gds, pex_work/pex_pfd.tcl.
    - team_src/magic/PFD_lib.mag / PFD_lib.mag point at its current name,
    PFD_lib_SCAFFOLD_DO_NOT_BUILD.mag (renamed in 5386616).
    - PDK and extra_be_checks paths go in a new EXTERNAL list, each with a reason. Unlike
    ALLOWLIST, an E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
